kaizhoumasha/fxn_wms/docs/planning/3.5-task-breakdown.md

# 3.5 特殊物料处理 - 任务分解

## 文档元数据

| 属性 | 值 |
|---|-----|
| **文档编号** | PLAN-3.5-001 |
| **版本** | v1.0 |
| **创建日期** | 2025-01-02 |
| **最后更新** | 2025-01-02 |
| **状态** | 待评审 |
| **关联设计文档** | `docs/design/3.5-special-material-handling.md` |
| **关联需求** | SRS §3.5 特殊物料处理 |

## 1. 概述

### 1.1 任务分解目标

本文档基于 `3.5-special-material-handling.md` 设计文档，将特殊物料处理功能分解为可执行的 Epic 和 User Story，用于指导开发团队的迭代开发工作。

### 1.2 范围说明

**入库场景专项**：当前阶段仅覆盖入库（Inbound）场景的特殊物料处理，包括：
- 5种特殊物料类型：高价值物料、MSD物料、异形物料、PCB物料、机构件物料
- 物料分类识别、路由决策、库位分配、上架执行
- QMS质检集成、RCS任务下发、SAP数据同步
- 异常处理、状态监控、报表追溯

**架构约束**：根据设计文档 §0.1，当前阶段由 **WMS 全权负责**，WES 不参与此阶段的特殊物料处理逻辑。

### 1.3 技术栈

- **后端框架**：ASP.NET WebForms + MVC 5 (.NET Framework 4.8)
- **数据库**：SQL Server 2019
- **PDA端**：Blazor Server
- **集成协议**：HTTP REST (RCS, QMS), 批量同步 (SAP)

## 2. Epic 汇总

| Epic ID | Epic 名称 | 故事点 | 优先级 | 依赖 | 说明 |
|---|---|---|---|---|---|
| **E1** | 物料分类与路由决策 | 14 | P0 | E6 | 物料类型识别、路由规则引擎 |
| **E2** | 特殊物料类型处理流程 | 34 | P0 | E1, E6 | 5种物料类型的专项处理逻辑 |
| **E3** | 库位分配与上架执行 | 21 | P0 | E2 | 库位策略、RCS任务下发、确认处理 |
| **E4** | 异常处理与状态监控 | 13 | P1 | E3 | 异常检测、人工介入、状态同步 |
| **E5** | 报表与追溯 | 8 | P1 | E3 | 移动报表、追溯查询、性能指标 |
| **E6** | 数据库架构与集成 | 13 | P0 | 无 | 表结构创建、SAP同步 |
| **E7** | UI/PDA 功能增强 | 10 | P1 | E1, E2 | 管理界面、PDA操作界面 |
| **总计** | | **113** | | | |

### 2.1 优先级说明

- **P0 (Must Have)**：核心功能，必须在第一阶段完成
- **P1 (Should Have)**：重要功能，建议在第二阶段完成
- **P2 (Nice to Have)**：增强功能，可延后至后续迭代

### 2.2 依赖关系图

```
E6 (数据库架构)
  ↓
E1 (物料分类与路由)
  ↓
E2 (特殊物料类型处理)
  ↓
E3 (库位分配与上架)
  ↓
E4 (异常处理) → E5 (报表追溯)
  ↓
E7 (UI/PDA增强)
```

## 3. 按团队分组视图

### WMS 团队工作范围

**总故事点**：113 点
**占比**：100%
**说明**：根据架构设计，WMS 全权负责特殊物料处理，WES 不参与。

**关键职责**:
- 物料分类识别与路由决策
- 5种特殊物料类型的差异化处理流程
- 库位分配策略与上架执行
- QMS/RCS/SAP 系统集成
- 异常处理与状态监控
- 报表追溯与性能监控
- 数据库架构设计与维护
- Web 管理界面与 PDA 操作界面

**技术栈**:
- ASP.NET WebForms + MVC 5 (.NET Framework 4.8)
- Blazor Server (PDA 界面)
- Entity Framework (数据访问)
- SQL Server 2019
- Hangfire (定时任务)
- Redis (分布式锁、缓存)
- HTTP REST (RCS, QMS 集成)
- SAP 批量同步

| Epic | 用户故事 | 故事点 | 优先级 | 依赖 |
|---|---|---|---|---|
| **E1: 物料分类与路由决策** | | **14** | P0 | E6 |
| | US-E1-01: 物料类型识别 | 3 | P0 | E6-01 |
| | US-E1-02: 路由规则引擎实现 | 5 | P0 | E6-02 |
| | US-E1-03: 路由决策 API | 3 | P0 | US-E1-02 |
| | US-E1-04: 物料属性扩展 | 3 | P0 | E6-01 |
| **E2: 特殊物料类型处理流程** | | **34** | P0 | E1, E6 |
| | US-E2-01: 高价值物料流程 | 8 | P0 | US-E1-02 |
| | US-E2-02: MSD物料流程 | 8 | P0 | US-E1-02 |
| | US-E2-03: 异形物料流程 | 5 | P0 | US-E1-02 |
| | US-E2-04: PCB物料流程 | 5 | P0 | US-E1-02 |
| | US-E2-05: 机构件物料流程 | 5 | P0 | US-E1-02 |
| | US-E2-06: QMS Webhook 集成 | 3 | P0 | 无 |
| **E3: 库位分配与上架执行** | | **21** | P0 | E2 |
| | US-E3-01: 库位分配策略引擎 | 8 | P0 | E6-02 |
| | US-E3-02: RCS上架任务创建 | 5 | P0 | US-E3-01 |
| | US-E3-03: 上架确认处理 | 5 | P0 | US-E3-02 |
| | US-E3-04: 库位容量管理 | 3 | P0 | E6-01 |
| **E4: 异常处理与状态监控** | | **13** | P1 | E3 |
| | US-E4-01: 异常检测与告警 | 5 | P1 | E3-03 |
| | US-E4-02: 人工介入工作流 | 5 | P1 | US-E4-01 |
| | US-E4-03: RCS状态同步 | 3 | P1 | 无 |
| **E5: 报表与追溯** | | **8** | P1 | E3 |
| | US-E5-01: 特殊物料移动报表 | 3 | P1 | E3-03 |
| | US-E5-02: 物料追溯查询 | 3 | P1 | E6-03 |
| | US-E5-03: 性能指标仪表板 | 2 | P1 | US-E5-01 |
| **E6: 数据库架构与集成** | | **13** | P0 | 无 |
| | US-E6-01: material_extension 表创建 | 3 | P0 | 无 |
| | US-E6-02: routing_rule 表创建 | 3 | P0 | 无 |
| | US-E6-03: special_material_log 表创建 | 2 | P0 | 无 |
| | US-E6-04: SAP物料属性批量同步 | 5 | P0 | US-E6-01 |
| **E7: UI/PDA 功能增强** | | **10** | P1 | E1, E2 |
| | US-E7-01: 物料分类管理界面 | 5 | P1 | E6-01 |
| | US-E7-02: PDA特殊物料处理界面 | 3 | P1 | E2 |
| | US-E7-03: 异常处理仪表板 | 2 | P1 | E4-01 |

---

#### E1: 物料分类与路由决策 (14 点)

**Epic 描述**：
实现物料到货时的自动分类识别和路由决策功能，支持5种特殊物料类型（HIGH_VALUE, MSD, IRREGULAR, PCB, STRUCTURAL）的识别和路由规则引擎。

**业务价值**：
- 自动化物料分类，减少人工判断错误
- 智能路由决策，提升入库效率
- 为后续特殊物料处理流程提供基础数据

---

##### US-E1-01: 物料类型识别

**故事点**：3
**优先级**：P0
**依赖**：E6-01 (material_extension 表创建)

**用户故事**：
作为 WMS 系统，我需要在物料到货时自动识别其特殊物料类型，以便后续进行差异化处理。

**验收标准**：
1. 系统读取物料主数据（material 表），识别 special_material_type 字段
2. 支持5种类型识别：HIGH_VALUE（高价值）、MSD（湿敏）、IRREGULAR（异形）、PCB、STRUCTURAL（机构件）
3. 分类结果存储至 material_extension 表的 special_material_type 字段
4. 对于未标记的物料，默认为普通物料（NORMAL）
5. 分类结果记录至 special_material_log 表，包含时间戳和操作人

**技术实现要点**：
- 在 `MaterialService.cs` 中新增 `IdentifyMaterialType(string materialCode)` 方法
- 查询 material 表的 special_material_type 字段
- 若为空，检查物料描述关键词（如"PCB"、"MSD"等）进行智能识别
- 更新 material_extension 表
- 记录日志至 special_material_log

**测试用例**：
- TC-E1-01-01: 已标记高价值物料，验证识别结果为 HIGH_VALUE
- TC-E1-01-02: 未标记物料但描述包含"MSD"，验证智能识别为 MSD
- TC-E1-01-03: 普通物料，验证识别结果为 NORMAL
- TC-E1-01-04: 验证日志记录完整性

---

##### US-E1-02: 路由规则引擎实现

**故事点**：5
**优先级**：P0
**依赖**：E6-02 (routing_rule 表创建)

**用户故事**：
作为 WMS 系统，我需要一个路由规则引擎来根据物料类型、目标区域和存储要求决定物料的目标库位类型和处理指令。

**验收标准**：
1. 规则引擎读取 routing_rule 表，支持多条件匹配（物料类型 + 目标区域 + 存储要求）
2. 规则优先级机制：按 priority 字段降序匹配，返回第一条匹配规则
3. 返回目标库位类型（location_type）和处理指令（handling_instructions）
4. 支持规则的启用/禁用（is_active 字段）
5. 规则匹配失败时，返回默认规则或抛出异常

**技术实现要点**：
- 在 `RoutingService.cs` 中新增 `EvaluateRoutingRule(MaterialRoutingContext context)` 方法
- MaterialRoutingContext 包含：materialType, targetZone, storageRequirements
- 使用 LINQ 查询 routing_rule 表，按 priority DESC 排序
- 实现规则匹配逻辑：支持精确匹配和通配符（如 "*" 表示任意）
- 缓存规则表数据（使用 MemoryCache，5分钟过期）

**测试用例**：
- TC-E1-02-01: 高价值物料 + IQC区域，验证路由至高价值专区
- TC-E1-02-02: MSD物料 + 存储区域，验证路由至湿度控制区
- TC-E1-02-03: 多条规则匹配，验证优先级机制
- TC-E1-02-04: 无匹配规则，验证默认规则或异常处理
- TC-E1-02-05: 禁用规则不参与匹配

---

##### US-E1-03: 路由决策 API

**故事点**：3
**优先级**：P0
**依赖**：US-E1-02

**用户故事**：
作为外部系统（如 PDA、RCS），我需要通过 REST API 查询物料的路由决策结果，以便执行后续操作。

**验收标准**：
1. 提供 REST API 端点：`POST /api/routing/decide`
2. 请求参数：materialCode, targetZone, storageRequirements (可选)
3. 响应数据：locationType, locationRecommendations (推荐库位列表), handlingInstructions
4. API 响应时间 < 500ms (P95)
5. 支持批量查询：`POST /api/routing/decide-batch` (最多100条)

**技术实现要点**：
- 在 `Controllers/RoutingController.cs` 中新增 `DecideRouting` 和 `DecideRoutingBatch` 方法
- 调用 RoutingService.EvaluateRoutingRule
- 调用 LocationService.GetRecommendedLocations 获取推荐库位
- 返回 JSON 格式：
  ```json
  {
    "materialCode": "MAT001",
    "locationType": "HIGH_VALUE_ZONE",
    "locationRecommendations": ["HV-A-01-01", "HV-A-01-02"],
    "handlingInstructions": "需QMS质检后上架"
  }
  ```

**测试用例**：
- TC-E1-03-01: 单条查询，验证响应格式和数据正确性
- TC-E1-03-02: 批量查询100条，验证响应时间 < 2s
- TC-E1-03-03: 无效物料编码，验证错误处理（返回400）
- TC-E1-03-04: 并发100请求，验证系统稳定性

---

##### US-E1-04: 物料属性扩展

**故事点**：3
**优先级**：P0
**依赖**：E6-01

**用户故事**：
作为仓库管理员，我需要在物料主数据管理界面中维护特殊物料属性（类型、MSD等级、存储要求），以便系统正确识别和处理。

**验收标准**：
1. 在现有物料管理界面（MaterialMaster.aspx）中新增字段：
   - special_material_type (下拉选择：NORMAL, HIGH_VALUE, MSD, IRREGULAR, PCB, STRUCTURAL)
   - msd_level (下拉选择：2a, 3, 4, 5a，仅当类型为MSD时显示)
   - storage_requirements (多行文本框，最多500字符)
2. 支持 CRUD 操作：创建、查询、更新、删除
3. 数据验证：MSD物料必须填写 msd_level
4. 变更记录：属性修改时记录至 special_material_log

**技术实现要点**：
- 修改 `MaterialMaster.aspx` 和 `MaterialMaster.aspx.cs`
- 新增表单字段，使用 DropDownList 和 TextBox 控件
- 在 `MaterialService.cs` 中新增 `UpdateMaterialExtension` 方法
- 数据验证逻辑：
  ```csharp
  if (materialType == "MSD" && string.IsNullOrEmpty(msdLevel))
      throw new ValidationException("MSD物料必须指定MSD等级");
  ```
- 记录变更日志

**测试用例**：
- TC-E1-04-01: 创建高价值物料，验证数据保存成功
- TC-E1-04-02: 创建MSD物料但未填写等级，验证报错
- TC-E1-04-03: 更新物料类型，验证变更日志记录
- TC-E1-04-04: 删除物料，验证扩展属性同步删除（级联）

| **E2: 特殊物料类型处理流程** | | **34** | P0 | E1, E6 |
| | US-E2-01: 高价值物料流程 | 8 | P0 | US-E1-02 |
| | US-E2-02: MSD物料流程 | 8 | P0 | US-E1-02 |
| | US-E2-03: 异形物料流程 | 5 | P0 | US-E1-02 |
| | US-E2-04: PCB物料流程 | 5 | P0 | US-E1-02 |
| | US-E2-05: 机构件物料流程 | 5 | P0 | US-E1-02 |
| | US-E2-06: QMS Webhook 集成 | 3 | P0 | 无 |

#### E2: 特殊物料类型处理流程 (34 点)

**Epic 描述**：
实现5种特殊物料类型的差异化处理流程，包括专属区域路由、质检集成、环境控制、追溯管理等。

**业务价值**：
- 满足不同物料类型的特殊存储和处理要求
- 降低高价值物料损失风险
- 确保MSD物料湿度控制合规
- 提升异形/PCB/机构件物料的处理效率

---

##### US-E2-01: 高价值物料流程

**故事点**：8
**优先级**：P0
**依赖**：US-E1-02

**用户故事**：
作为仓库管理员，我需要对高价值物料实施专属区域存储、强制质检和全程追溯，以降低损失风险。

**验收标准**：
1. 高价值物料自动路由至高价值专区（HIGH_VALUE_ZONE）
2. 强制QMS质检流程：到货后自动创建质检任务，质检通过后才能上架
3. 安全追溯：记录所有操作日志（到货、质检、上架、出库）至 special_material_log
4. 库位限制：高价值专区仅允许存放高价值物料
5. 异常告警：质检超时（>24小时）自动发送告警

**技术实现要点**：
- 在 `HighValueMaterialHandler.cs` 中实现处理逻辑
- 到货时调用 QMS API 创建质检任务：
  ```csharp
  var qmsTask = await _qmsClient.CreateInspectionTask(new {
      materialCode = material.Code,
      palletId = pallet.Id,
      inspectionType = "HIGH_VALUE",
      priority = "HIGH"
  });
  ```
- 监听 QMS Webhook 接收质检结果（见 US-E2-06）
- 质检通过后更新物料状态为 AVAILABLE，触发上架流程
- 质检不通过，路由至复判区或退货区
- 使用 Hangfire 定时任务检查质检超时（每小时执行）

**测试用例**：
- TC-E2-01-01: 高价值物料到货，验证路由至高价值专区
- TC-E2-01-02: 验证QMS质检任务创建成功
- TC-E2-01-03: 质检通过，验证物料状态更新为 AVAILABLE
- TC-E2-01-04: 质检不通过，验证路由至复判区
- TC-E2-01-05: 质检超时24小时，验证告警发送
- TC-E2-01-06: 验证所有操作记录至日志表

---

##### US-E2-02: MSD物料流程

**故事点**：8
**优先级**：P0
**依赖**：US-E1-02

**用户故事**：
作为仓库管理员，我需要对MSD物料实施湿度控制区存储、烘烤时间追踪和有效期管理，以确保物料质量。

**验收标准**：
1. MSD物料根据等级（2a/3/4/5a）路由至对应湿度控制区
2. 烘烤时间追踪：记录开封时间（floor_life_start_time）、车间暴露时间（floor_life_hours）
3. 有效期管理：根据MSD等级计算有效期，超期自动标记为 EXPIRED
4. 烘烤提醒：车间暴露时间达到80%时发送提醒
5. 存储环境监控：集成温湿度传感器数据（预留接口）

**技术实现要点**：
- 在 `MsdMaterialHandler.cs` 中实现处理逻辑
- MSD等级与车间暴露时间映射（参考IPC/JEDEC标准）：
  ```csharp
  var floorLifeHours = msdLevel switch {
      "2a" => 4,
      "3" => 168,
      "4" => 72,
      "5a" => 24,
      _ => throw new ArgumentException("Invalid MSD level")
  };
  ```
- 在 material_extension 表中新增字段：
  - floor_life_start_time (开封时间)
  - floor_life_hours (允许暴露时间)
  - baking_required (是否需要烘烤)
- 使用 Hangfire 定时任务检查有效期（每小时执行）
- 发送提醒至 PDA 和管理界面

**测试用例**：
- TC-E2-02-01: MSD 2a物料，验证路由至湿度控制区
- TC-E2-02-02: 开封后，验证 floor_life_start_time 记录
- TC-E2-02-03: 暴露时间达到80%，验证提醒发送
- TC-E2-02-04: 暴露时间超期，验证状态更新为 EXPIRED
- TC-E2-02-05: 不同MSD等级，验证车间暴露时间计算正确

---

##### US-E2-03: 异形物料流程

**故事点**：5
**优先级**：P0
**依赖**：US-E1-02

**用户故事**：
作为仓库管理员，我需要对异形物料（超大、超重、不规则形状）实施人工处理区存储和特殊库位分配。

**验收标准**：
1. 异形物料自动路由至人工处理区（MANUAL_HANDLING_ZONE）
2. 特殊库位分配：根据物料尺寸（length, width, height）和重量（weight）分配合适库位
3. 库位容量校验：确保库位尺寸和承重满足物料要求
4. PDA提示：上架时显示物料尺寸和重量信息，提醒操作人员注意
5. 禁止自动化设备处理：异形物料不下发RCS任务，仅人工操作

**技术实现要点**：
- 在 `IrregularMaterialHandler.cs` 中实现处理逻辑
- 在 material_extension 表中新增字段：
  - length, width, height (尺寸，单位mm)
  - weight (重量，单位kg)
  - is_irregular (是否异形)
- 库位分配逻辑：
  ```csharp
  var suitableLocations = _locationService.GetLocations(loc =>
      loc.MaxLength >= material.Length &&
      loc.MaxWidth >= material.Width &&
      loc.MaxHeight >= material.Height &&
      loc.MaxWeight >= material.Weight &&
      loc.ZoneType == "MANUAL_HANDLING_ZONE"
  );
  ```
- PDA界面显示物料尺寸和重量

**测试用例**：
- TC-E2-03-01: 异形物料到货，验证路由至人工处理区
- TC-E2-03-02: 验证库位容量校验（尺寸和承重）
- TC-E2-03-03: 无合适库位，验证异常处理
- TC-E2-03-04: PDA上架界面，验证尺寸和重量显示
- TC-E2-03-05: 验证不下发RCS任务

---

##### US-E2-04: PCB物料流程

**故事点**：5
**优先级**：P0
**依赖**：US-E1-02

**用户故事**：
作为仓库管理员，我需要对PCB物料实施ESD防护区存储和托盘级追溯管理。

**验收标准**：
1. PCB物料自动路由至ESD防护区（ESD_PROTECTED_ZONE）
2. 托盘级追溯：记录托盘ID（pallet_id）、PCB数量（pcb_quantity）、批次号（batch_number）
3. ESD标识：托盘和库位需有ESD标识，系统校验
4. 先进先出（FIFO）：出库时优先选择最早入库的PCB
5. 库位限制：ESD防护区仅允许存放PCB物料

**技术实现要点**：
- 在 `PcbMaterialHandler.cs` 中实现处理逻辑
- 在 pallet_extension 表中新增字段：
  - pcb_quantity (PCB数量)
  - batch_number (批次号)
  - is_esd_protected (是否ESD防护)
- 库位分配时校验 location.is_esd_protected = true
- FIFO逻辑：
  ```csharp
  var pallets = _palletService.GetPallets(p =>
      p.MaterialCode == materialCode &&
      p.Status == "AVAILABLE"
  ).OrderBy(p => p.InboundTime);
  ```

**测试用例**：
- TC-E2-04-01: PCB物料到货，验证路由至ESD防护区
- TC-E2-04-02: 验证托盘级追溯信息记录
- TC-E2-04-03: 分配至非ESD库位，验证报错
- TC-E2-04-04: 出库时，验证FIFO逻辑
- TC-E2-04-05: 验证库位限制（仅PCB物料）

---

##### US-E2-05: 机构件物料流程

**故事点**：5
**优先级**：P0
**依赖**：US-E1-02

**用户故事**：
作为仓库管理员，我需要对机构件物料实施机械件专区存储和重量级库位分配。

**验收标准**：
1. 机构件物料自动路由至机械件专区（MECHANICAL_PARTS_ZONE）
2. 重量级库位分配：根据物料重量分配承重合适的库位
3. 库位承重校验：确保库位最大承重 >= 物料重量
4. 堆叠限制：重型机构件不允许堆叠（max_stack_layers = 1）
5. 库位优化：优先分配底层库位（减少搬运难度）

**技术实现要点**：
- 在 `StructuralMaterialHandler.cs` 中实现处理逻辑
- 在 material_extension 表中新增字段：
  - weight (重量，单位kg)
  - is_heavy (是否重型，weight > 50kg)
- 库位分配逻辑：
  ```csharp
  var suitableLocations = _locationService.GetLocations(loc =>
      loc.MaxWeight >= material.Weight &&
      loc.ZoneType == "MECHANICAL_PARTS_ZONE" &&
      (material.IsHeavy ? loc.Layer == 1 : true)
  ).OrderBy(loc => loc.Layer);
  ```
- 重型物料设置 max_stack_layers = 1

**测试用例**：
- TC-E2-05-01: 机构件物料到货，验证路由至机械件专区
- TC-E2-05-02: 重型物料（>50kg），验证分配至底层库位
- TC-E2-05-03: 验证库位承重校验
- TC-E2-05-04: 重型物料，验证堆叠限制（max_stack_layers = 1）
- TC-E2-05-05: 无合适库位，验证异常处理

---

##### US-E2-06: QMS Webhook 集成

**故事点**：3
**优先级**：P0
**依赖**：无

**用户故事**：
作为 WMS 系统，我需要接收 QMS 的质检结果 Webhook，以便及时更新物料状态并触发后续流程。

**验收标准**：
1. 提供 Webhook 端点：`POST /api/qms/webhook/inspection-result`
2. 接收 QMS 质检结果：inspectionId, materialCode, palletId, result (PASS/FAIL), remarks
3. 更新物料状态：PASS → AVAILABLE，FAIL → QUARANTINE
4. 触发后续流程：PASS 触发上架流程，FAIL 触发复判或退货流程
5. 幂等性保证：同一 inspectionId 多次推送，仅处理一次

**技术实现要点**：
- 在 `Controllers/QmsWebhookController.cs` 中新增 `ReceiveInspectionResult` 方法
- Webhook 请求格式：
  ```json
  {
    "inspectionId": "INS-20250102-001",
    "materialCode": "MAT001",
    "palletId": "PLT-001",
    "result": "PASS",
    "remarks": "质检合格"
  }
  ```
- 幂等性实现：检查 special_material_log 表是否已存在该 inspectionId
- 状态更新后发布事件：`InspectionCompletedEvent`
- 记录日志至 special_material_log

**测试用例**：
- TC-E2-06-01: 接收 PASS 结果，验证物料状态更新为 AVAILABLE
- TC-E2-06-02: 接收 FAIL 结果，验证物料状态更新为 QUARANTINE
- TC-E2-06-03: 重复推送同一 inspectionId，验证仅处理一次
- TC-E2-06-04: 无效 materialCode，验证错误处理
- TC-E2-06-05: 验证事件发布和日志记录

| **E3: 库位分配与上架执行** | | **21** | P0 | E2 |
| | US-E3-01: 库位分配策略引擎 | 8 | P0 | E6-02 |
| | US-E3-02: RCS上架任务创建 | 5 | P0 | US-E3-01 |
| | US-E3-03: 上架确认处理 | 5 | P0 | US-E3-02 |
| | US-E3-04: 库位容量管理 | 3 | P0 | E6-01 |

#### E3: 库位分配与上架执行 (21 点)

**Epic 描述**：
实现智能库位分配策略和RCS上架任务下发，确保特殊物料按规则存储至合适库位。

**业务价值**：
- 优化库位利用率，提升存储效率
- 自动化上架流程，减少人工干预
- 确保物料存储符合特殊要求

---

##### US-E3-01: 库位分配策略引擎

**故事点**：8
**优先级**：P0
**依赖**：E6-02

**用户故事**：
作为 WMS 系统，我需要根据物料类型、库位容量、区域规则等因素智能分配最优库位。

**验收标准**：
1. 支持多种分配策略：就近原则、负载均衡、FIFO优先、容量优先
2. 库位过滤：根据物料类型过滤可用库位（区域、承重、尺寸、环境要求）
3. 库位排序：按优先级排序（距离、空闲度、历史使用率）
4. 库位预留：支持临时预留库位（15分钟超时自动释放）
5. 并发控制：防止多个任务分配至同一库位

**技术实现要点**：
- 在 `LocationAllocationService.cs` 中实现策略引擎
- 策略接口：
  ```csharp
  public interface IAllocationStrategy {
      List<Location> Allocate(Material material, List<Location> candidates);
  }
  ```
- 实现4种策略：NearestStrategy, LoadBalancingStrategy, FifoStrategy, CapacityStrategy
- 使用 Redis 分布式锁防止并发冲突：
  ```csharp
  var lockKey = $"location:lock:{locationId}";
  await _redis.LockAsync(lockKey, TimeSpan.FromMinutes(15));
  ```
- 库位预留记录至 location_reservation 表

**测试用例**：
- TC-E3-01-01: 就近原则，验证分配最近库位
- TC-E3-01-02: 负载均衡，验证分配至空闲度高的库位
- TC-E3-01-03: 并发10个任务，验证无重复分配
- TC-E3-01-04: 预留超时15分钟，验证自动释放
- TC-E3-01-05: 无可用库位，验证异常处理

---

##### US-E3-02: RCS上架任务创建

**故事点**：5
**优先级**：P0
**依赖**：US-E3-01

**用户故事**：
作为 WMS 系统，我需要向 RCS 下发上架任务，指示 AGV 将托盘搬运至目标库位。

**验收标准**：
1. 调用 RCS API 创建上架任务：`POST /api/rcs/tasks/putaway`
2. 任务参数：palletId, sourceLocation, targetLocation, priority, materialType
3. 任务优先级：高价值物料 HIGH，其他 NORMAL
4. 任务状态追踪：CREATED → ASSIGNED → IN_PROGRESS → COMPLETED
5. 超时处理：任务创建后30分钟未完成，自动告警

**技术实现要点**：
- 在 `RcsIntegrationService.cs` 中新增 `CreatePutawayTask` 方法
- RCS API 请求格式：
  ```json
  {
    "taskType": "PUTAWAY",
    "palletId": "PLT-001",
    "sourceLocation": "DOCK-A-01",
    "targetLocation": "HV-A-01-01",
    "priority": "HIGH",
    "materialType": "HIGH_VALUE"
  }
  ```
- 任务状态存储至 rcs_task 表
- 使用 Hangfire 定时任务检查超时（每10分钟执行）
- 记录任务日志至 special_material_log

**测试用例**：
- TC-E3-02-01: 创建上架任务，验证 RCS API 调用成功
- TC-E3-02-02: 高价值物料，验证优先级为 HIGH
- TC-E3-02-03: 任务超时30分钟，验证告警发送
- TC-E3-02-04: RCS API 失败，验证重试机制（3次）
- TC-E3-02-05: 验证任务状态记录和日志

---

##### US-E3-03: 上架确认处理

**故事点**：5
**优先级**：P0
**依赖**：US-E3-02

**用户故事**：
作为 WMS 系统，我需要接收 RCS 的上架完成通知，更新库存状态并释放库位预留。

**验收标准**：
1. 接收 RCS Webhook：`POST /api/rcs/webhook/task-completed`
2. 验证任务完成：检查 taskId, palletId, targetLocation 一致性
3. 更新库存：托盘状态 → STORED，库位状态 → OCCUPIED
4. 释放预留：删除 location_reservation 记录
5. 幂等性保证：同一 taskId 多次推送，仅处理一次

**技术实现要点**：
- 在 `Controllers/RcsWebhookController.cs` 中新增 `ReceiveTaskCompleted` 方法
- Webhook 请求格式：
  ```json
  {
    "taskId": "RCS-TASK-001",
    "palletId": "PLT-001",
    "targetLocation": "HV-A-01-01",
    "status": "COMPLETED",
    "completedTime": "2025-01-02T10:30:00Z"
  }
  ```
- 幂等性实现：检查 rcs_task 表状态是否已为 COMPLETED
- 更新 pallet 表：status = STORED, location_id = targetLocation
- 更新 location 表：status = OCCUPIED, current_pallet_id = palletId
- 删除 location_reservation 记录
- 发布事件：`PutawayCompletedEvent`

**测试用例**：
- TC-E3-03-01: 接收完成通知，验证库存状态更新
- TC-E3-03-02: 验证库位预留释放
- TC-E3-03-03: 重复推送同一 taskId，验证仅处理一次
- TC-E3-03-04: 无效 taskId，验证错误处理
- TC-E3-03-05: 验证事件发布

---

##### US-E3-04: 库位容量管理

**故事点**：3
**优先级**：P0
**依赖**：E6-01

**用户故事**：
作为仓库管理员，我需要实时查看库位容量使用情况，以便优化库位分配和扩容规划。

**验收标准**：
1. 库位容量统计：总库位数、已占用、空闲、预留、异常
2. 按区域统计：各区域（高价值、MSD、ESD等）的容量使用率
3. 容量告警：使用率 > 90% 时发送告警
4. 容量趋势：记录每日容量使用情况，生成趋势图
5. 管理界面：展示容量统计和趋势图

**技术实现要点**：
- 在 `LocationService.cs` 中新增 `GetCapacityStatistics` 方法
- 统计逻辑：
  ```csharp
  var stats = new {
      TotalLocations = _db.Locations.Count(),
      OccupiedLocations = _db.Locations.Count(l => l.Status == "OCCUPIED"),
      FreeLocations = _db.Locations.Count(l => l.Status == "FREE"),
      ReservedLocations = _db.LocationReservations.Count(),
      UtilizationRate = (double)occupied / total * 100
  };
  ```
- 使用 Hangfire 定时任务记录每日容量（每天凌晨1点执行）
- 容量数据存储至 location_capacity_history 表
- 在 `LocationCapacity.aspx` 中展示统计和趋势图（使用 Chart.js）

**测试用例**：
- TC-E3-04-01: 验证容量统计数据正确性
- TC-E3-04-02: 使用率 > 90%，验证告警发送
- TC-E3-04-03: 验证每日容量记录
- TC-E3-04-04: 管理界面，验证统计和趋势图显示
- TC-E3-04-05: 按区域统计，验证各区域数据正确

| **E4: 异常处理与状态监控** | | **13** | P1 | E3 |
| | US-E4-01: 异常检测与告警 | 5 | P1 | E3-03 |
| | US-E4-02: 人工介入工作流 | 5 | P1 | US-E4-01 |
| | US-E4-03: RCS状态同步 | 3 | P1 | 无 |
| **E5: 报表与追溯** | | **8** | P1 | E3 |
| | US-E5-01: 特殊物料移动报表 | 3 | P1 | E3-03 |
| | US-E5-02: 物料追溯查询 | 3 | P1 | E6-03 |
| | US-E5-03: 性能指标仪表板 | 2 | P1 | US-E5-01 |
| **E6: 数据库架构与集成** | | **13** | P0 | 无 |
| | US-E6-01: material_extension 表创建 | 3 | P0 | 无 |
| | US-E6-02: routing_rule 表创建 | 3 | P0 | 无 |
| | US-E6-03: special_material_log 表创建 | 2 | P0 | 无 |
| | US-E6-04: SAP物料属性批量同步 | 5 | P0 | US-E6-01 |
| **E7: UI/PDA 功能增强** | | **10** | P1 | E1, E2 |
| | US-E7-01: 物料分类管理界面 | 5 | P1 | E6-01 |
| | US-E7-02: PDA特殊物料处理界面 | 3 | P1 | E2 |
| | US-E7-03: 异常处理仪表板 | 2 | P1 | E4-01 |

---

#### E4: 异常处理与状态监控 (13 点)

**Epic 描述**：
实现异常检测、告警、人工介入和状态同步机制，确保特殊物料处理流程的可靠性。

**业务价值**：
- 及时发现和处理异常，降低业务影响
- 提供人工介入通道，保障流程连续性
- 实时状态同步，确保数据一致性

---

##### US-E4-01: 异常检测与告警

**故事点**：5
**优先级**：P1
**依赖**：E3-03

**用户故事**：
作为系统管理员，我需要自动检测特殊物料处理过程中的异常情况并及时告警。

**验收标准**：
1. 异常类型检测：质检超时、上架超时、库位冲突、设备故障、数据不一致
2. 告警级别：CRITICAL（关键）、HIGH（高）、MEDIUM（中）、LOW（低）
3. 告警渠道：系统通知、邮件、短信（CRITICAL级别）
4. 告警记录：存储至 exception_log 表，包含异常类型、级别、描述、处理状态
5. 自动恢复：部分异常支持自动恢复（如重试机制）

**技术实现要点**：
- 在 `ExceptionDetectionService.cs` 中实现检测逻辑
- 使用 Hangfire 定时任务检测异常（每5分钟执行）
- 异常检测规则：
  ```csharp
  // 质检超时
  var qmsTimeouts = _db.Materials
      .Where(m => m.Status == "INSPECTING" &&
                  DateTime.Now - m.InspectionStartTime > TimeSpan.FromHours(24));

  // 上架超时
  var putawayTimeouts = _db.RcsTasks
      .Where(t => t.Status == "IN_PROGRESS" &&
                  DateTime.Now - t.CreatedTime > TimeSpan.FromMinutes(30));
  ```
- 告警发送：调用 `NotificationService.SendAlert`
- 记录至 exception_log 表

**测试用例**：
- TC-E4-01-01: 质检超时24小时，验证 CRITICAL 告警发送
- TC-E4-01-02: 上架超时30分钟，验证 HIGH 告警发送
- TC-E4-01-03: 库位冲突，验证 MEDIUM 告警发送
- TC-E4-01-04: 验证告警记录至 exception_log
- TC-E4-01-05: 自动恢复成功，验证告警状态更新为 RESOLVED

---

##### US-E4-02: 人工介入工作流

**故事点**：5
**优先级**：P1
**依赖**：US-E4-01

**用户故事**：
作为仓库管理员，我需要对异常情况进行人工介入处理，包括手动分配库位、强制完成任务等。

**验收标准**：
1. 异常处理界面：展示待处理异常列表，支持筛选和排序
2. 处理操作：手动分配库位、强制完成任务、标记为已解决、升级处理
3. 处理记录：记录处理人、处理时间、处理方式、处理结果
4. 权限控制：仅管理员和主管可执行人工介入操作
5. 审计日志：所有人工介入操作记录至 audit_log 表

**技术实现要点**：
- 在 `ExceptionHandling.aspx` 中实现异常处理界面
- 界面功能：
  - 异常列表（GridView）：显示异常类型、级别、发生时间、状态
  - 筛选条件：异常类型、级别、状态、时间范围
  - 处理操作按钮：分配库位、强制完成、标记解决、升级
- 在 `ExceptionHandlingService.cs` 中实现处理逻辑
- 权限验证：
  ```csharp
  if (!User.IsInRole("Admin") && !User.IsInRole("Supervisor"))
      throw new UnauthorizedException("无权限执行此操作");
  ```
- 记录审计日志

**测试用例**：
- TC-E4-02-01: 管理员登录，验证可访问异常处理界面
- TC-E4-02-02: 普通用户登录，验证无权限访问
- TC-E4-02-03: 手动分配库位，验证操作成功并记录日志
- TC-E4-02-04: 强制完成任务，验证任务状态更新
- TC-E4-02-05: 验证审计日志记录完整性

---

##### US-E4-03: RCS状态同步

**故事点**：3
**优先级**：P1
**依赖**：无

**用户故事**：
作为 WMS 系统，我需要定期同步 RCS 任务状态，确保数据一致性。

**验收标准**：
1. 定期同步：每5分钟查询 RCS 任务状态
2. 状态更新：同步 RCS 任务状态至 rcs_task 表
3. 差异检测：检测 WMS 与 RCS 状态不一致的任务
4. 自动修正：对于轻微差异，自动修正 WMS 状态
5. 异常告警：对于严重差异，发送告警并记录至 exception_log

**技术实现要点**：
- 在 `RcsSyncService.cs` 中实现同步逻辑
- 使用 Hangfire 定时任务（每5分钟执行）
- 调用 RCS API 查询任务状态：`GET /api/rcs/tasks/{taskId}/status`
- 状态对比逻辑：
  ```csharp
  var wmsStatus = _db.RcsTasks.Find(taskId).Status;
  var rcsStatus = await _rcsClient.GetTaskStatus(taskId);

  if (wmsStatus != rcsStatus) {
      if (IsMinorDifference(wmsStatus, rcsStatus)) {
          // 自动修正
          UpdateWmsStatus(taskId, rcsStatus);
      } else {
          // 发送告警
          _alertService.SendAlert($"严重状态差异: WMS={wmsStatus}, RCS={rcsStatus}");
      }
  }
  ```

**测试用例**：
- TC-E4-03-01: 状态一致，验证无操作
- TC-E4-03-02: 轻微差异，验证自动修正
- TC-E4-03-03: 严重差异，验证告警发送
- TC-E4-03-04: RCS API 失败，验证错误处理
- TC-E4-03-05: 验证同步日志记录

---

#### E5: 报表与追溯 (8 点)

**Epic 描述**：
实现特殊物料移动报表、追溯查询和性能指标仪表板，支持业务分析和审计。

**业务价值**：
- 提供数据支持，辅助业务决策
- 满足审计和合规要求
- 监控系统性能，及时发现问题

---

##### US-E5-01: 特殊物料移动报表

**故事点**：3
**优先级**：P1
**依赖**：E3-03

**用户故事**：
作为仓库管理员，我需要查看特殊物料的移动报表，了解物料流转情况。

**验收标准**：
1. 报表维度：物料类型、时间范围、区域、操作类型（入库、上架、出库）
2. 报表指标：物料数量、托盘数量、平均处理时间、异常次数
3. 报表格式：表格和图表（柱状图、饼图）
4. 导出功能：支持导出为 Excel 和 PDF
5. 定时生成：每日自动生成报表并发送至管理员邮箱

**技术实现要点**：
- 在 `SpecialMaterialReport.aspx` 中实现报表界面
- 报表查询逻辑：
  ```csharp
  var report = _db.SpecialMaterialLogs
      .Where(l => l.OperationTime >= startDate && l.OperationTime <= endDate)
      .GroupBy(l => new { l.MaterialType, l.OperationType })
      .Select(g => new {
          MaterialType = g.Key.MaterialType,
          OperationType = g.Key.OperationType,
          Count = g.Count(),
          AvgProcessingTime = g.Average(l => l.ProcessingTime)
      });
  ```
- 使用 Chart.js 生成图表
- 导出功能：使用 EPPlus (Excel) 和 iTextSharp (PDF)
- 使用 Hangfire 定时任务生成报表（每天凌晨2点执行）

**测试用例**：
- TC-E5-01-01: 查询本月高价值物料报表，验证数据正确性
- TC-E5-01-02: 导出为 Excel，验证格式正确
- TC-E5-01-03: 导出为 PDF，验证格式正确
- TC-E5-01-04: 验证定时报表生成和邮件发送
- TC-E5-01-05: 验证图表显示正确

---

##### US-E5-02: 物料追溯查询

**故事点**：3
**优先级**：P1
**依赖**：E6-03

**用户故事**：
作为质量管理员，我需要追溯特殊物料的完整流转历史，用于质量分析和问题排查。

**验收标准**：
1. 查询条件：物料编码、托盘ID、批次号、时间范围
2. 追溯信息：操作时间、操作类型、操作人、源库位、目标库位、状态变化
3. 时间线展示：按时间顺序展示物料流转历史
4. 关联信息：显示质检结果、异常记录、RCS任务
5. 导出功能：支持导出追溯报告为 PDF

**技术实现要点**：
- 在 `MaterialTraceability.aspx` 中实现追溯查询界面
- 查询逻辑：
  ```csharp
  var traceHistory = _db.SpecialMaterialLogs
      .Where(l => l.MaterialCode == materialCode || l.PalletId == palletId)
      .OrderBy(l => l.OperationTime)
      .Select(l => new {
          OperationTime = l.OperationTime,
          OperationType = l.OperationType,
          Operator = l.Operator,
          SourceLocation = l.SourceLocation,
          TargetLocation = l.TargetLocation,
          StatusChange = l.StatusChange
      });
  ```
- 时间线展示：使用 Timeline 控件或自定义 CSS
- 关联查询：Join quality_inspection, exception_log, rcs_task 表
- PDF 导出：使用 iTextSharp

**测试用例**：
- TC-E5-02-01: 按物料编码查询，验证追溯历史完整
- TC-E5-02-02: 按托盘ID查询，验证追溯历史完整
- TC-E5-02-03: 验证关联信息显示（质检、异常、RCS任务）
- TC-E5-02-04: 导出 PDF，验证格式正确
- TC-E5-02-05: 无追溯记录，验证提示信息

---

##### US-E5-03: 性能指标仪表板

**故事点**：2
**优先级**：P1
**依赖**：US-E5-01

**用户故事**：
作为系统管理员，我需要实时监控特殊物料处理的性能指标，及时发现性能问题。

**验收标准**：
1. 关键指标：平均处理时间、异常率、库位利用率、任务完成率
2. 实时更新：每5分钟刷新一次数据
3. 趋势图：展示最近7天的指标趋势
4. 告警提示：指标异常时显示告警标识
5. 钻取功能：点击指标可查看详细数据

**技术实现要点**：
- 在 `PerformanceDashboard.aspx` 中实现仪表板界面
- 使用 SignalR 实现实时数据推送
- 指标计算逻辑：
  ```csharp
  var metrics = new {
      AvgProcessingTime = _db.SpecialMaterialLogs
          .Where(l => l.OperationTime >= DateTime.Today)
          .Average(l => l.ProcessingTime),
      ExceptionRate = (double)exceptionCount / totalCount * 100,
      LocationUtilization = (double)occupiedCount / totalCount * 100,
      TaskCompletionRate = (double)completedCount / totalCount * 100
  };
  ```
- 使用 Chart.js 生成趋势图
- 告警阈值：平均处理时间 > 30分钟、异常率 > 5%、库位利用率 > 90%

**测试用例**：
- TC-E5-03-01: 验证关键指标显示正确
- TC-E5-03-02: 验证实时更新（5分钟刷新）
- TC-E5-03-03: 指标异常，验证告警标识显示
- TC-E5-03-04: 点击指标，验证钻取至详细数据
- TC-E5-03-05: 验证趋势图显示最近7天数据

#### E6: 数据库架构与集成 (13 点)

**Epic 描述**：
创建特殊物料处理所需的数据库表结构，实现与SAP的物料属性批量同步。

**业务价值**：
- 提供数据存储基础，支撑业务功能
- 自动化数据同步，减少人工维护
- 确保数据一致性和完整性

---

##### US-E6-01: material_extension 表创建

**故事点**：3
**优先级**：P0
**依赖**：无

**用户故事**：
作为数据库管理员，我需要创建 material_extension 表来存储物料的特殊属性扩展信息。

**验收标准**：
1. 表结构包含字段：material_code (PK), special_material_type, msd_level, storage_requirements, length, width, height, weight, is_irregular, is_heavy, floor_life_start_time, floor_life_hours, baking_required
2. 外键约束：material_code 关联 material 表
3. 索引：material_code (主键), special_material_type (普通索引)
4. 默认值：special_material_type = 'NORMAL', is_irregular = 0, is_heavy = 0
5. 审计字段：created_at, updated_at, created_by, updated_by

**技术实现要点**：
- SQL Server 建表脚本：
  ```sql
  CREATE TABLE material_extension (
      material_code NVARCHAR(50) PRIMARY KEY,
      special_material_type NVARCHAR(20) NOT NULL DEFAULT 'NORMAL',
      msd_level NVARCHAR(10) NULL,
      storage_requirements NVARCHAR(500) NULL,
      length DECIMAL(10,2) NULL,
      width DECIMAL(10,2) NULL,
      height DECIMAL(10,2) NULL,
      weight DECIMAL(10,2) NULL,
      is_irregular BIT NOT NULL DEFAULT 0,
      is_heavy BIT NOT NULL DEFAULT 0,
      floor_life_start_time DATETIME NULL,
      floor_life_hours INT NULL,
      baking_required BIT NULL,
      created_at DATETIME NOT NULL DEFAULT GETDATE(),
      updated_at DATETIME NOT NULL DEFAULT GETDATE(),
      created_by NVARCHAR(50) NOT NULL,
      updated_by NVARCHAR(50) NOT NULL,
      CONSTRAINT FK_material_extension_material FOREIGN KEY (material_code)
          REFERENCES material(material_code) ON DELETE CASCADE
  );

  CREATE INDEX IX_material_extension_type ON material_extension(special_material_type);
  ```

**测试用例**：
- TC-E6-01-01: 执行建表脚本，验证表创建成功
- TC-E6-01-02: 插入测试数据，验证约束和默认值
- TC-E6-01-03: 删除 material 记录，验证级联删除
- TC-E6-01-04: 验证索引创建成功

---

##### US-E6-02: routing_rule 表创建

**故事点**：3
**优先级**：P0
**依赖**：无

**用户故事**：
作为数据库管理员，我需要创建 routing_rule 表来存储物料路由规则配置。

**验收标准**：
1. 表结构包含字段：rule_id (PK), material_type, target_zone, storage_requirements, location_type, handling_instructions, priority, is_active
2. 主键：rule_id (自增)
3. 索引：material_type + target_zone (复合索引), priority (普通索引)
4. 默认值：is_active = 1, priority = 100
5. 审计字段：created_at, updated_at, created_by, updated_by

**技术实现要点**：
- SQL Server 建表脚本：
  ```sql
  CREATE TABLE routing_rule (
      rule_id INT IDENTITY(1,1) PRIMARY KEY,
      material_type NVARCHAR(20) NOT NULL,
      target_zone NVARCHAR(50) NULL,
      storage_requirements NVARCHAR(500) NULL,
      location_type NVARCHAR(50) NOT NULL,
      handling_instructions NVARCHAR(1000) NULL,
      priority INT NOT NULL DEFAULT 100,
      is_active BIT NOT NULL DEFAULT 1,
      created_at DATETIME NOT NULL DEFAULT GETDATE(),
      updated_at DATETIME NOT NULL DEFAULT GETDATE(),
      created_by NVARCHAR(50) NOT NULL,
      updated_by NVARCHAR(50) NOT NULL
  );

  CREATE INDEX IX_routing_rule_type_zone ON routing_rule(material_type, target_zone);
  CREATE INDEX IX_routing_rule_priority ON routing_rule(priority DESC);
  ```
- 初始化数据：插入5种物料类型的默认路由规则

**测试用例**：
- TC-E6-02-01: 执行建表脚本，验证表创建成功
- TC-E6-02-02: 插入测试规则，验证约束和默认值
- TC-E6-02-03: 验证复合索引和优先级索引
- TC-E6-02-04: 执行初始化脚本，验证默认规则插入

---

##### US-E6-03: special_material_log 表创建

**故事点**：2
**优先级**：P0
**依赖**：无

**用户故事**：
作为数据库管理员，我需要创建 special_material_log 表来记录特殊物料的所有操作日志。

**验收标准**：
1. 表结构包含字段：log_id (PK), material_code, pallet_id, operation_type, operation_time, operator, source_location, target_location, status_change, processing_time, remarks
2. 主键：log_id (自增)
3. 索引：material_code (普通索引), pallet_id (普通索引), operation_time (普通索引)
4. 分区策略：按 operation_time 月度分区（提升查询性能）
5. 保留策略：保留2年数据，超期自动归档

**技术实现要点**：
- SQL Server 建表脚本：
  ```sql
  CREATE TABLE special_material_log (
      log_id BIGINT IDENTITY(1,1) PRIMARY KEY,
      material_code NVARCHAR(50) NOT NULL,
      pallet_id NVARCHAR(50) NULL,
      operation_type NVARCHAR(50) NOT NULL,
      operation_time DATETIME NOT NULL DEFAULT GETDATE(),
      operator NVARCHAR(50) NOT NULL,
      source_location NVARCHAR(50) NULL,
      target_location NVARCHAR(50) NULL,
      status_change NVARCHAR(100) NULL,
      processing_time INT NULL,
      remarks NVARCHAR(1000) NULL
  );

  CREATE INDEX IX_special_material_log_material ON special_material_log(material_code);
  CREATE INDEX IX_special_material_log_pallet ON special_material_log(pallet_id);
  CREATE INDEX IX_special_material_log_time ON special_material_log(operation_time DESC);
  ```
- 分区方案：使用 SQL Server 分区函数和分区方案（可选，视数据量而定）

**测试用例**：
- TC-E6-03-01: 执行建表脚本，验证表创建成功
- TC-E6-03-02: 插入测试日志，验证数据写入
- TC-E6-03-03: 验证索引创建成功
- TC-E6-03-04: 查询性能测试（100万条数据）

---

##### US-E6-04: SAP物料属性批量同步

**故事点**：5
**优先级**：P0
**依赖**：US-E6-01

**用户故事**：
作为系统集成工程师，我需要实现从SAP批量同步物料属性至WMS，确保物料主数据一致性。

**验收标准**：
1. 同步频率：每日凌晨3点自动执行
2. 同步范围：物料编码、物料描述、特殊物料类型、MSD等级、存储要求、尺寸、重量
3. 增量同步：仅同步变更的物料（基于 updated_at 字段）
4. 错误处理：同步失败记录至 sync_error_log 表，发送告警
5. 同步报告：生成同步报告（成功数、失败数、耗时）并发送邮件

**技术实现要点**：
- 在 `SapSyncService.cs` 中实现同步逻辑
- SAP接口：调用 SAP RFC 或 OData API 获取物料数据
- 增量同步逻辑：
  ```csharp
  var lastSyncTime = _db.SyncHistory.Max(h => h.SyncTime);
  var changedMaterials = await _sapClient.GetMaterials(lastSyncTime);

  foreach (var sapMaterial in changedMaterials) {
      var wmsExtension = _db.MaterialExtensions.Find(sapMaterial.Code);
      if (wmsExtension == null) {
          // 新增
          _db.MaterialExtensions.Add(MapToExtension(sapMaterial));
      } else {
          // 更新
          UpdateExtension(wmsExtension, sapMaterial);
      }
  }
  await _db.SaveChangesAsync();
  ```
- 使用 Hangfire 定时任务（每天凌晨3点执行）
- 错误处理：使用 try-catch 捕获异常，记录至 sync_error_log
- 同步报告：使用邮件服务发送

**测试用例**：
- TC-E6-04-01: 全量同步1000条物料，验证数据一致性
- TC-E6-04-02: 增量同步100条变更物料，验证仅同步变更
- TC-E6-04-03: SAP接口失败，验证错误记录和告警
- TC-E6-04-04: 验证同步报告生成和邮件发送
- TC-E6-04-05: 验证定时任务执行（凌晨3点）

---

#### E7: UI/PDA 功能增强 (10 点)

**Epic 描述**：
实现特殊物料管理的Web界面和PDA操作界面，提升用户体验和操作效率。

**业务价值**：
- 提供友好的管理界面，降低操作难度
- 支持移动端操作，提升现场作业效率
- 实时数据展示，辅助决策

---

##### US-E7-01: 物料分类管理界面

**故事点**：5
**优先级**：P1
**依赖**：E6-01

**用户故事**：
作为仓库管理员，我需要一个Web界面来管理物料分类和特殊属性配置。

**验收标准**：
1. 物料列表：展示物料编码、描述、特殊类型、MSD等级、存储要求
2. 筛选功能：按物料类型、MSD等级筛选
3. 编辑功能：点击编辑按钮，弹出编辑对话框，修改特殊属性
4. 批量导入：支持Excel批量导入物料属性
5. 导出功能：支持导出为Excel

**技术实现要点**：
- 在 `MaterialClassification.aspx` 中实现界面
- 使用 GridView 控件展示物料列表
- 编辑对话框：使用 Bootstrap Modal 或 ASP.NET AJAX ModalPopup
- 批量导入：使用 EPPlus 读取 Excel 文件
  ```csharp
  using (var package = new ExcelPackage(uploadedFile)) {
      var worksheet = package.Workbook.Worksheets[0];
      for (int row = 2; row <= worksheet.Dimension.End.Row; row++) {
          var materialCode = worksheet.Cells[row, 1].Value?.ToString();
          var materialType = worksheet.Cells[row, 2].Value?.ToString();
          // ... 读取其他字段
          _materialService.UpdateExtension(materialCode, materialType, ...);
      }
  }
  ```
- 导出功能：使用 EPPlus 生成 Excel

**测试用例**：
- TC-E7-01-01: 访问界面，验证物料列表显示
- TC-E7-01-02: 筛选高价值物料，验证筛选结果
- TC-E7-01-03: 编辑物料属性，验证保存成功
- TC-E7-01-04: 批量导入100条物料，验证导入成功
- TC-E7-01-05: 导出为Excel，验证格式正确

---

##### US-E7-02: PDA特殊物料处理界面

**故事点**：3
**优先级**：P1
**依赖**：E2

**用户故事**：
作为仓库操作员，我需要在PDA上查看特殊物料的处理指引和操作提示。

**验收标准**：
1. 物料信息展示：扫描物料条码后，显示物料类型、存储要求、处理指引
2. 特殊提示：高价值物料显示"需质检"，MSD物料显示"湿度控制"，异形物料显示尺寸和重量
3. 操作引导：根据物料类型显示操作步骤（如"等待质检" → "上架至高价值区"）
4. 异常上报：支持现场异常上报（拍照、填写描述）
5. 离线支持：网络断开时，缓存数据至本地，恢复后自动同步

**技术实现要点**：
- 使用 Blazor Server 开发 PDA 界面
- 在 `SpecialMaterialHandling.razor` 中实现界面
- 条码扫描：调用 PDA 设备的扫描API
- 界面布局：
  ```razor
  <div class="material-info">
      <h3>@MaterialCode</h3>
      <div class="badge @GetBadgeClass()">@MaterialType</div>
      <p>@StorageRequirements</p>
  </div>
  <div class="handling-instructions">
      <h4>处理指引</h4>
      <ol>
          @foreach (var step in HandlingSteps) {
              <li>@step</li>
          }
      </ol>
  </div>
  ```
- 异常上报：使用 Blazor 文件上传组件
- 离线支持：使用 IndexedDB 缓存数据

**测试用例**：
- TC-E7-02-01: 扫描高价值物料，验证信息和指引显示
- TC-E7-02-02: 扫描MSD物料，验证湿度控制提示
- TC-E7-02-03: 上报异常（拍照+描述），验证提交成功
- TC-E7-02-04: 离线模式，验证数据缓存和同步
- TC-E7-02-05: 验证界面响应速度（< 1秒）

---

##### US-E7-03: 异常处理仪表板

**故事点**：2
**优先级**：P1
**依赖**：E4-01

**用户故事**：
作为系统管理员，我需要一个仪表板来实时监控异常情况和处理进度。

**验收标准**：
1. 异常统计：展示待处理、处理中、已解决的异常数量
2. 异常列表：展示最近24小时的异常，按级别排序
3. 实时更新：每分钟自动刷新数据
4. 快速操作：点击异常可快速跳转至处理界面
5. 趋势图：展示最近7天的异常趋势

**技术实现要点**：
- 在 `ExceptionDashboard.aspx` 中实现仪表板
- 使用 SignalR 实现实时数据推送
- 统计卡片：
  ```html
  <div class="stats-card">
      <h3>待处理</h3>
      <div class="count critical">@PendingCount</div>
  </div>
  ```
- 使用 Chart.js 生成趋势图
- 自动刷新：使用 JavaScript setInterval 或 SignalR 推送

**测试用例**：
- TC-E7-03-01: 访问仪表板，验证统计数据显示
- TC-E7-03-02: 验证实时更新（1分钟刷新）
- TC-E7-03-03: 点击异常，验证跳转至处理界面
- TC-E7-03-04: 验证趋势图显示最近7天数据
- TC-E7-03-05: 并发100用户访问，验证性能

## 4. Sprint 规划

### 4.1 团队配置与速率计算

**团队组成**：
- WMS 开发团队：4名开发人员
- 技能分布：2名后端（C#/.NET）、1名前端（Blazor/ASP.NET）、1名全栈

**Sprint 周期**：2周（10个工作日）

**速率计算**：
```
可用工时 = 4人 × 10天 × 6小时/天 = 240小时
有效工时占比 = 70%（扣除会议、代码评审、沟通等）
有效工时 = 240 × 0.7 = 168小时
综合工时系数 = 1.5（包含测试、文档、返工）
团队速率 = 168 ÷ 1.5 = 112 故事点/Sprint
```

**Sprint 分配策略**：
- Sprint 1（56点）：基础架构 + 核心流程（E6, E1, E2部分）
- Sprint 2（57点）：完整流程 + 增强功能（E2剩余, E3, E4, E5, E7）

---

### 4.2 Sprint 1：基础架构与核心流程（2周）

**Sprint 目标**：
建立数据库架构，实现物料分类、路由决策和5种特殊物料类型的核心处理流程。

**总故事点**：56点
**包含 Epic**：E6（13点）、E1（14点）、E2（29点，部分）

#### Sprint 1 任务分解

| 天数 | 任务 | 负责人 | 故事点 | 状态 |
|---|---|---|---|---|
| **Day 1-2: 数据库架构搭建** | | | **13** | |
| Day 1 | US-E6-01: material_extension 表创建 | 后端1 | 3 | 待开始 |
| Day 1 | US-E6-02: routing_rule 表创建 | 后端1 | 3 | 待开始 |
| Day 1 | US-E6-03: special_material_log 表创建 | 后端2 | 2 | 待开始 |
| Day 2 | US-E6-04: SAP物料属性批量同步 | 后端2 | 5 | 待开始 |
| **Day 3-4: 物料分类与路由** | | | **14** | |
| Day 3 | US-E1-01: 物料类型识别 | 后端1 | 3 | 待开始 |
| Day 3 | US-E1-04: 物料属性扩展 | 前端 | 3 | 待开始 |
| Day 4 | US-E1-02: 路由规则引擎实现 | 后端2 | 5 | 待开始 |
| Day 4 | US-E1-03: 路由决策 API | 后端1 | 3 | 待开始 |
| **Day 5-8: 特殊物料类型处理** | | | **29** | |
| Day 5-6 | US-E2-01: 高价值物料流程 | 后端1 | 8 | 待开始 |
| Day 5-6 | US-E2-02: MSD物料流程 | 后端2 | 8 | 待开始 |
| Day 7 | US-E2-03: 异形物料流程 | 全栈 | 5 | 待开始 |
| Day 7 | US-E2-06: QMS Webhook 集成 | 后端1 | 3 | 待开始 |
| Day 8 | US-E2-04: PCB物料流程 | 后端2 | 5 | 待开始 |
| **Day 9-10: 集成测试与修复** | | | | |
| Day 9 | 集成测试：E1 + E2 流程联调 | 全员 | - | 待开始 |
| Day 10 | Bug修复、代码评审、文档完善 | 全员 | - | 待开始 |

#### Sprint 1 验收标准

**必须完成**：
1. ✅ 数据库表结构创建完成，通过DDL验证
2. ✅ 物料分类识别功能正常，支持5种类型
3. ✅ 路由规则引擎运行正常，规则匹配准确率 > 95%
4. ✅ 高价值物料、MSD物料流程完整，QMS集成成功
5. ✅ 所有 P0 User Story 的单元测试通过率 > 90%

**可延后**：
- US-E2-05: 机构件物料流程（5点）→ 延后至 Sprint 2

---

### 4.3 Sprint 2：完整流程与增强功能（2周）

**Sprint 目标**：
完成剩余物料类型处理、库位分配上架、异常处理、报表追溯和UI增强功能。

**总故事点**：57点
**包含 Epic**：E2剩余（5点）、E3（21点）、E4（13点）、E5（8点）、E7（10点）

#### Sprint 2 任务分解

| 天数 | 任务 | 负责人 | 故事点 | 状态 |
|---|---|---|---|---|
| **Day 1: 机构件物料流程** | | | **5** | |
| Day 1 | US-E2-05: 机构件物料流程 | 后端1 | 5 | 待开始 |
| **Day 2-5: 库位分配与上架** | | | **21** | |
| Day 2-3 | US-E3-01: 库位分配策略引擎 | 后端2 | 8 | 待开始 |
| Day 3 | US-E3-04: 库位容量管理 | 前端 | 3 | 待开始 |
| Day 4 | US-E3-02: RCS上架任务创建 | 后端1 | 5 | 待开始 |
| Day 5 | US-E3-03: 上架确认处理 | 后端1 | 5 | 待开始 |
| **Day 6-7: 异常处理与监控** | | | **13** | |
| Day 6 | US-E4-01: 异常检测与告警 | 后端2 | 5 | 待开始 |
| Day 6 | US-E4-03: RCS状态同步 | 后端1 | 3 | 待开始 |
| Day 7 | US-E4-02: 人工介入工作流 | 全栈 | 5 | 待开始 |
| **Day 7-8: 报表与追溯** | | | **8** | |
| Day 7 | US-E5-01: 特殊物料移动报表 | 前端 | 3 | 待开始 |
| Day 8 | US-E5-02: 物料追溯查询 | 前端 | 3 | 待开始 |
| Day 8 | US-E5-03: 性能指标仪表板 | 前端 | 2 | 待开始 |
| **Day 8-9: UI/PDA 增强** | | | **10** | |
| Day 8-9 | US-E7-01: 物料分类管理界面 | 前端 | 5 | 待开始 |
| Day 9 | US-E7-02: PDA特殊物料处理界面 | 全栈 | 3 | 待开始 |
| Day 9 | US-E7-03: 异常处理仪表板 | 前端 | 2 | 待开始 |
| **Day 10: 集成测试与发布** | | | | |
| Day 10 | 端到端测试、性能测试、发布准备 | 全员 | - | 待开始 |

#### Sprint 2 验收标准

**必须完成**：
1. ✅ 所有5种物料类型处理流程完整
2. ✅ 库位分配策略正常，RCS任务下发成功率 > 95%
3. ✅ 异常检测告警正常，人工介入流程可用
4. ✅ 报表和追溯功能正常，数据准确性 > 99%
5. ✅ UI/PDA界面可用，用户体验测试通过
6. ✅ 端到端测试通过，性能指标达标

---

### 4.4 风险评估与缓解措施

#### 高风险项（需重点关注）

| 风险项 | 影响 | 概率 | 缓解措施 |
|---|---|---|---|
| **QMS集成接口不稳定** | 高 | 中 | 1. 提前与QMS团队对接测试环境<br>2. 实现Mock服务用于开发测试<br>3. 增加重试和降级机制 |
| **RCS API响应慢** | 中 | 高 | 1. 实现异步任务处理<br>2. 增加超时和重试机制<br>3. 与RCS团队协调性能优化 |
| **数据库性能瓶颈** | 高 | 低 | 1. 提前进行性能测试（100万条日志）<br>2. 优化索引和查询语句<br>3. 考虑分区表方案 |
| **需求变更** | 中 | 中 | 1. 冻结需求，变更走正式流程<br>2. 预留10%缓冲时间<br>3. 优先级管理，P1功能可延后 |

#### 中风险项（需监控）

| 风险项 | 影响 | 概率 | 缓解措施 |
|---|---|---|---|
| **团队成员请假** | 中 | 低 | 1. 关键模块双人备份<br>2. 代码评审确保知识共享<br>3. 文档完善，降低依赖 |
| **技术难点攻关耗时** | 中 | 中 | 1. 提前技术预研（Redis分布式锁、Hangfire定时任务）<br>2. 寻求技术专家支持<br>3. 备选方案准备 |
| **测试环境不稳定** | 低 | 中 | 1. 本地Mock环境搭建<br>2. 与运维协调环境稳定性<br>3. 自动化测试减少依赖 |

---

### 4.5 依赖管理

#### 外部依赖

| 依赖项 | 依赖方 | 交付物 | 期望时间 | 状态 | 负责人 |
|---|---|---|---|---|---|
| QMS测试环境 | QMS团队 | 测试环境URL、API文档 | Sprint 1 Day 3 | 待确认 | QMS负责人 |
| RCS测试环境 | RCS团队 | 测试环境URL、API文档 | Sprint 1 Day 3 | 待确认 | RCS负责人 |
| SAP接口文档 | SAP团队 | RFC/OData接口文档 | Sprint 1 Day 1 | 待确认 | SAP负责人 |
| 数据库权限 | DBA | 建表权限、Schema设计评审 | Sprint 1 Day 1 | 待确认 | DBA |

#### 内部依赖

| 依赖项 | 被依赖方 | 依赖方 | 交付物 | 期望时间 |
|---|---|---|---|---|
| 数据库表结构 | E6 | E1, E2 | DDL脚本 | Sprint 1 Day 2 |
| 路由规则引擎 | E1 | E2, E3 | RoutingService API | Sprint 1 Day 4 |
| 物料类型处理 | E2 | E3 | MaterialHandler API | Sprint 1 Day 8 |
| 库位分配策略 | E3 | E4 | LocationAllocationService | Sprint 2 Day 5 |

---

### 4.6 质量保证计划

#### 测试策略

**单元测试**：
- 覆盖率目标：> 80%
- 关键模块（路由引擎、库位分配）：> 90%
- 工具：xUnit + Moq

**集成测试**：
- Sprint 1 Day 9：E1 + E2 集成测试
- Sprint 2 Day 10：E3 + E4 + E5 集成测试
- 工具：Postman + 自动化脚本

**端到端测试**：
- Sprint 2 Day 10：完整业务流程测试
- 场景：高价值物料入库 → 质检 → 上架 → 追溯
- 工具：Selenium + 手工测试

**性能测试**：
- 并发测试：100并发用户
- 数据量测试：100万条日志查询
- 响应时间：API < 500ms (P95)

#### 代码评审

- **频率**：每个 User Story 完成后
- **评审人**：至少1名其他开发人员
- **检查项**：代码规范、安全性、性能、可维护性

#### 文档要求

- **技术文档**：API文档、数据库设计文档、部署文档
- **用户文档**：操作手册、PDA使用指南
- **交付时间**：Sprint 2 Day 10

---

## 5. 附录

### 5.1 术语表

| 术语 | 英文 | 说明 |
|---|---|---|
| 特殊物料 | Special Material | 需要特殊存储或处理的物料类型 |
| 高价值物料 | High-Value Material | 价值较高，需要额外安全措施的物料 |
| MSD物料 | Moisture Sensitive Device | 湿敏器件，需要湿度控制 |
| 异形物料 | Irregular Material | 尺寸或形状不规则的物料 |
| 路由决策 | Routing Decision | 根据规则决定物料目标库位的过程 |
| 库位分配 | Location Allocation | 为物料分配具体存储库位 |
| 上架 | Putaway | 将物料搬运至目标库位的过程 |
| RCS | Robot Control System | 机器人控制系统，负责AGV调度 |
| QMS | Quality Management System | 质量管理系统 |
| SAP | Systems Applications Products | 企业资源计划系统 |

### 5.2 参考文档

| 文档名称 | 路径 | 版本 |
|---|---|---|
| 软件需求规格说明书 | `docs/SRS.md` | v1.0 |
| 特殊物料处理设计文档 | `docs/design/3.5-special-material-handling.md` | v1.0 |
| 系统架构设计 | `docs/system_architecture.md` | v1.0 |
| 用户需求文档 | `docs/user_requirement.md` | v1.0 |
| 任务分解参考模板 | `docs/planning/3.2.1-task-breakdown.md` | v1.0 |

### 5.3 变更记录

| 版本 | 日期 | 变更内容 | 变更人 |
|---|---|---|---|
| v1.0 | 2025-01-02 | 初始版本创建 | Claude |

---

## 6. 依赖关系图 (Dependency Graph)

```
E6 (数据库架构与集成)
  ↓
E1 (物料分类与路由决策)
  ↓
E2 (特殊物料类型处理流程)
  ↓
E3 (库位分配与上架执行)
  ↓
E4 (异常处理与状态监控) ← E5 (报表与追溯)
  ↓
E7 (UI/PDA 功能增强)
```

**关键路径**: E6 → E1 → E2 → E3 → E4 → E7

**并行开发机会**:
- E5 (报表与追溯) 可在 E3 完成后与 E4 并行开发
- E7 (UI/PDA 增强) 可在 E1、E2 完成后提前启动部分工作

---

## 7. 风险与缓解措施 (Risks & Mitigation)

### 高风险项

| 风险项 | 影响 | 概率 | 缓解措施 |
|---|---|---|---|
| **QMS 集成接口不稳定** | 高 | 中 | 1. 提前与 QMS 团队对接测试环境<br>2. 实现 Mock 服务用于开发测试<br>3. 增加重试和降级机制<br>4. 建立 Webhook 失败告警 |
| **RCS API 响应慢或不稳定** | 高 | 中 | 1. 实现异步任务处理机制<br>2. 增加超时和重试逻辑<br>3. 与 RCS 团队协调性能优化<br>4. 准备人工降级方案 |
| **MSD 物料湿度控制逻辑复杂** | 中 | 高 | 1. 提前与业务团队确认 MSD 等级标准<br>2. 参考 IPC/JEDEC 标准实现<br>3. 建立完整的测试用例覆盖 |
| **数据库性能瓶颈** | 高 | 低 | 1. 提前进行性能测试（100万条日志）<br>2. 优化索引和查询语句<br>3. 实施分区表方案<br>4. 使用 Redis 缓存热点数据 |

### 中风险项

| 风险项 | 影响 | 概率 | 缓解措施 |
|---|---|---|---|
| **物料类型兼容性矩阵不完整** | 中 | 中 | 1. 与业务团队充分沟通确认规则<br>2. 设计灵活的规则配置机制<br>3. 支持运行时规则调整 |
| **SAP 批量同步性能问题** | 中 | 中 | 1. 实施增量同步策略<br>2. 优化批量处理逻辑<br>3. 错峰执行（凌晨时段） |
| **异形物料库位分配复杂** | 中 | 中 | 1. 建立完整的库位容量数据<br>2. 实现智能推荐算法<br>3. 提供人工干预接口 |
| **团队成员请假或离职** | 中 | 低 | 1. 关键模块双人备份<br>2. 代码评审确保知识共享<br>3. 完善技术文档 |

### 低风险项

| 风险项 | 影响 | 概率 | 缓解措施 |
|---|---|---|---|
| **需求变更** | 中 | 低 | 1. 冻结需求，变更走正式流程<br>2. 预留 10% 缓冲时间<br>3. P1 功能可延后至后续迭代 |
| **测试环境不稳定** | 低 | 中 | 1. 本地 Mock 环境搭建<br>2. 与运维协调环境稳定性<br>3. 自动化测试减少依赖 |

---

## 8. 验收标准总览 (Overall Acceptance Criteria)

### 功能完整性

- [ ] 所有 7 个 Epic 的用户故事全部完成
- [ ] 所有验收标准通过测试
- [ ] 端到端流程可正常运行（物料到货 → 分类 → 路由 → 上架 → 追溯）
- [ ] 5 种特殊物料类型处理流程全部验证通过

### 性能要求

- [ ] 物料类型识别响应时间 < 500ms
- [ ] 路由决策 API 响应时间 < 500ms (P95)
- [ ] 库位分配响应时间 < 1s
- [ ] RCS 任务创建响应时间 < 2s
- [ ] 报表查询响应时间 < 3s（10万条数据）
- [ ] 支持并发 50 个物料同时处理

### 可靠性要求

- [ ] QMS 集成成功率 > 95%（含重试）
- [ ] RCS 任务下发成功率 > 98%
- [ ] SAP 同步成功率 > 99%
- [ ] 系统可用性 > 99.5%
- [ ] 数据一致性 100%（WMS 与 SAP）

### 数据质量

- [ ] 物料分类准确率 100%
- [ ] 路由决策准确率 > 99%
- [ ] 库位分配成功率 > 95%
- [ ] 物料类型兼容性校验准确率 100%
- [ ] 审计日志完整性 100%
- [ ] 追溯数据完整性 100%

### 安全性要求

- [ ] 高价值物料全程追溯记录完整
- [ ] 操作日志记录所有关键操作
- [ ] 权限控制：仅授权人员可执行人工介入操作
- [ ] 数据加密：敏感数据传输加密
- [ ] 审计合规：满足内部审计要求

### 用户体验

- [ ] PDA 界面响应流畅（< 1s）
- [ ] Web 管理界面操作直观
- [ ] 异常提示清晰明确
- [ ] 报表数据可视化清晰
- [ ] 用户培训材料完整

---

**文档结束**
