kaizhoumasha/fxn_wms/docs/user_requirement.md

# 休斯顿P9自动化仓库功能分解清单

## 硬件清单

| 项次 | 使用区域 | 硬件 | 数量 | 用途说明 |
| --- | --- | --- | --- | --- |
| 1 | 码头收货区 | PDA | 3 | 用来点货，绑定栈板发运送任务，高值物料，MSD&非规则物料，PCB物料，机构件物料都用这些PDA |
| 2 | 码头收货区 | 电脑 | 1 | 用来做栈板条码打印，导入到货清单 |
| 3 | 码头收货区 | 打印机 | 1 | 打印栈板条码 |
| 4 | IQC待检区 | PDA | 1 | 用来登记抽检的料盘 |
| 5 | IQC复判区 | PDA | 1 | 复判挑选的物料拆栈板 |
| 6 | 料盘装箱区 | 工业电脑 | 1 | 显示待装箱列表，安排装箱任务 |
| 7 | 料盘装箱区 | PDA | 1 | 扫描栈板进行拆栈板作业，呼叫RCS |
| 8 | SMT作业区 | 工业电脑 | 3 | 自动线2台，人工线1台，用来装箱作业 |
| 9 | 高值区 | PDA | 1 | 绑定六合一 |
| 10 | 机构件作业区 | 工业电脑 | 1 | 控制机构件流水线及机械臂，呼叫机构件发料任务 |
| 11 | 机构件作业区 | PDA | 1 | 人工呼叫RCS |
| 12 | LCR&X-ray区 | 电脑 | 1 | 连接LCR测试仪进行LCR测试 |
| 13 | LCR&X-ray区 | 工业电脑 | 1 | 控制流水线及机械臂 |

---

## 码头到收货暂存区

### 作业流程清单

**[WMS]**
> 1.WMS增加PDA程序，登记到货清单信息，车牌号、到货箱数；如果是快递则登记快递号、到货箱数。

**[IQC]**
> 1.系统需要支持人工入库作业流程，并能够将数据在自动化仓库中调用到。

**[仓库人工]**
> 2.仓库人员登记车牌号，登记到货箱数；如果是快递则登记快递号、到货箱数。

**[IQC]**
> 2.系统需要支持可以中断自动化作业任务，并重启任务功能。

**[仓库人工]**
> 3.仓库人员整理物控给的到货清单

**[IQC]**
> 3.系统需要支持调整自动化任务的作业顺序，提供一下急料优先作业功能。

**[WMS]**
> 4.WMS 导入到货明细（依据物控给出到货清单进行导入）

**[IQC]**
> 4.系统需要维护当前自动运送区域的地图和地码对应信息的基础数据。

**[WMS]**
> 5.WMS 根据PO,项次，料号，数量去请求GRN单号

**[IQC]**
> 5.多方面的数据交互，需要有去有回，发出必须有反馈消息。

**[SAP]**
> 6.SAP给出GRN单号，回传WMS

**[IQC]**
> 6.当前流程中各区域说明：

**[IQC]**
> 6.1码头交接区：从货车卸货的存放区域

**[IQC]**
> 6.2收货暂存区：暂时存放已经绑定栈板号的存货区域，含待检，已检的栈板

**[IQC]**
> 6.3IQC待检区：IQC检验室门口，存放待检栈板的区域

**[IQC]**
> 6.4待复判区：IQC已经检验过一次，但需要复判的栈板存放区域

**[IQC]**
> 6.5料盘装箱区：料盘装箱流水线的上箱号区域

**[WMS]**
> 7.WMS 同步到GRN 单号更新到到货列表中

**[IQC]**
> 7.需要进行初始化的数据：

**[IQC]**
> 7.1一层货架和五层货架的标准箱号、货架号、初始存放地码进行初始化绑定

**[IQC]**
> 7.2退货料架和转运料架的料架号和储位及存放位置的地码进行初始化绑定

**[WMS]**
> 8.打印栈板号（WMS中配置栈板规则，打印唯一的栈板号）

**[仓库人工]**
> 9.仓库人员操作打印栈板功能，按照到货的栈板数量打印出栈板号

**[仓库人工]**
> 10.仓库人员将打印的栈板号，贴到到码头交接区的栈板上（如有历史栈板号需要覆盖）

**[WMS]**
> 11.WMS提供PDA作业程序，进行栈板号，料号，数量（同一料号的数量累计）,选GRN(根据日期+料号+数量去匹配后再选择），扫描AGV地码，提交作业。GRN的总数量需要校验在多个栈板上的累计数量是否满足要求。扫描箱上条码时，可以更改数量；如果箱上没有条码，则输入料号和输入数量。可以循环操作以上步骤，直到本次绑定作业完成。

**[仓库人工]**
> 12.仓库人员使用PDA，扫描栈板号（贴在栈板上的），箱条码（料号、数量），选择GRN，扫描栈板位置的AGV地码，提交数据到系统。重复此操作直到当前收货码头交接区的栈板作业完成为止。

**[WMS]**
> 13.生成码头交接区送收货暂存区任务列表，呼叫RCS

**[RCS]**
> 14.RCS调度E-AGV从码头交接区送收货暂存区

**[WMS]**
> 15.WMS依据GRN的到货时间+GRN收货数量已经绑定完成的条件，推送数据给QMS系统，

**[IQC]**
> 16.QMS接收WMS的GRN数据，计算抽样量

**[WMS]**
> 17.WMS接收QMS的抽样量，并匹配栈板号，生成送IQC待检任务，呼叫RCS，形成IQC送检待检列表-按顺序推单（增加手动调整优先级功能，可以手动调整送检顺序）

**[RCS]**
> 18.RCS调度E-AGV从收货暂存区送IQC待检区

**[WMS]**
> 19.WMS增加IQC取样扫码pkg记录，记录栈板号，GRN，取料的六合一条码

**[IQC]**
> 20.IQC作业员在IQC待检区使用PDA 扫描栈板号，选择GRN，扫描料盘码的六合一条码，记录取样的物料信息。

**[WMS]**
> 21.WMS增加IQC检验完成后，将料盘还回到对应的栈板上，记录归还的栈板号和物料的六合一条码

**[IQC]**
> 22.IQC作业员在IQC待检区使用PDA 扫描料盘六合一条码，系统提示栈板号，再扫描栈板号核对，归还取样的物料信息。

**[WMS]**
> 23.WMS根据GRN，获取IQC的检验结果，分为2种情况：
>   23.1 检验结果OK，生成IQC待验区送收货暂存区任务列表，呼叫RCS
>   23.2 检验结果NG，生产IQC待验区送待复判区任务列表，呼叫RCS

**[RCS]**
> 24.RCS调度E-AGV从IQC待验区送收货暂存区
> 25.RCS调度E-AGV从IQC待验区送待复判区

**[IQC]**
> 26.IQC对复判区的物料进行复判，复判的物料存在三种结果：
>  26.1复判OK，更新QMS的判定结果
>  26.2复判NG，更新QMS的判定结果
>  26.3挑选，更新QMS的判定结果，对栈板进行拆盘处理

**[WMS]**
> 27.WMS根据GRN获取QMS中IQC的复判OK的结果，生成待复判区送收货暂存区任务列表，呼叫RCS

**[RCS]**
> 28.RCS调度E-AGV从待复判区送收货暂存区。

**[WMS]**
> 29.WMS增加栈板号拆数量功能，记录栈板号上拆出的数量和更细栈板上保留的数量。
> 31.WMS接收拆完不良品数量的栈板号，并获取QMS中GRN复判挑选结果，生成待复判区送收货暂存区任务列表，呼叫RCS

**[IQC]**
> 30.承接26.3的挑选业务，作业员在带复判区使用PDA的拆栈板功能，扫描栈板号，扫描箱条码，将不良品从原来栈板上拆出到新的栈板上，提交数据

**[RCS]**
> 32.RCS调度E-AGV从待复判区送收货暂存区。

**[仓库人工]**
> 33.复判和挑选的不良品，仓库人员人工扫描绑定六合一条码，绑定到GRN上，然后人工入库到不良品仓。

**[仓库人工]**
> 34.仓库作业员在料盘装箱区的控制电脑上，打开装箱列表，呼叫物料进行装箱

**[WMS]**
> 35.料盘待装箱列表，做成2个模式：
>  35.1人工作业模式：WMS增加料盘装箱区的待装箱物料列表清单，包含GRN，料号，数量，栈板号；人工操作后按照选中的GRN生成收货暂存区送料盘装箱区任务列表，呼叫RCS
>  35.2系统作业模式：WMS增加系统派送待装箱物料清单列表，按栈板号的时间顺序排列清单，系统生成收货暂存区送料盘装箱区任务列表，呼叫RCS

**[RCS]**
> 36.RCS调度E-AGV从收货暂存区送料盘装箱区。

**[IQC]**
> 备注：

---

## 收货暂存区到料盘装箱区

### 作业流程清单

**[WMS]**
> 0.WMS系统中需要维护供应商提供的物料料号的厚度，尺寸等基础数据。

**[仓库人工]**
> 1.仓库人员在装箱区的控制电脑上打开呼叫列表：
>  1.1人工作业模式：人工选择待装箱清单GRN，料号，数量，栈板号；确认送装箱区域，发起运送任务，呼叫RCS。
>  1.2系统派送模式：根据暂存区的待装箱物时间顺序，按照料号的料盘规格大小，系统生成收料暂存区送料盘装箱区任务列表，呼叫RCS

**[WMS]**
> 1.1一层货架存放区：存放空的一层货架（含标准箱，并已经初始化在系统中）的区域

**[WMS]**
> 1.2料盘装箱区：料盘装箱流水线的上箱号区域

**[WMS]**
> 1.3收货暂存区：暂时存放已经绑定栈板号的存货区域，含待检，已检的栈板

**[WMS]**
> 1.4待入库缓存区：一层货架送过来到SMT作业区中的待入库的存放区域

**[WMS]**
> 1.5空栈板存放区：拆完箱后，空栈板的存放区域

**[RCS]**
> 2.RCS调度E-AGV从收货暂存区送料盘装箱区。

**[WMS]**
> 3.WMS提供一层货架和五层货架的标准箱号、货架号、初始存放地码进行初始化绑定。
> 4.依据仓库调度装箱任务，分析装箱区是否有可用的标准箱，如果没有，则按照装箱任务，生成从一层货架存放区送料装箱区的调度任务，呼叫RCS。

**[RCS]**
> 5.RCS调度潜伏式AGV从一层货架存放区送到料盘装箱区

**[装箱流水线控制]**
> 6.机械臂扫描一层货架的箱号、地码。
> 7.控制系统检查一层货架中的所有的箱必须是空的，如果非空则报警，停止作业。
> 8.检查是空箱，则将箱号、地码发送给WMS。

**[WMS]**
> 9.WMS提供接口，接收装箱流水线控制系统发回的一层货架的箱号、地码信息，并回传接收的结果信息

**[装箱流水线控制]**
> 10.接收WMS回传的信息，如果是OK，则待命，如果是NG或者超时，则需要再次发送信息，最多重复三次，如果三次异常则报错,需要人工介入处理。

**[WMS]**
> 11.WMS验证一层货架的箱号、地码到位后，才能进行PDA拆栈板功能。
> 12.WMS提供PDA拆栈板功能，进行栈板号的拆箱作业，扫描栈板号，扫描箱条码

**[仓库人工]**
> 13.仓库人员使用PDA扫描栈板号、箱条码（料号、数量）

**[仓库人工]**
> 14.仓库人员拆开箱，将料盘码串到装箱流水线的串杆上，人工启动流水线的按钮；再串下一串直到当前箱全部串完。
> 15.重复13/14步骤，直到当前栈板全部做完。

**[装箱流水线控制]**
> 16.机械臂抓取料盘，扫描PKG六合一条码（料号，数量，料盘码,LC,DC,供应商码）、厚度、尺寸。
> 17.控制系统做开关，对料盘上的二维码和PKG的六合一信息（一维码）做比对：
>  17.1比对成功，控制系统将PKG六合一信息、厚度、尺寸信息发送给WMS
>  17.2比对失败，则料盘放入NG区域，等待人工处理。

**[WMS]**
> 18.WMS接收控制系统发送的PKG六合一、厚度、尺寸信息；WMS计算PKG存放的箱号：
>  18.1能够算出箱号，则回复OK，并传送PKG六合一信息、箱号给控制系统。
>  18.2算不出箱号，则回复NG，并传送异常消息给控制系统

**[装箱流水线控制]**
> 19.控制系统接收到WMS信息：
>  19.1接收到WMS的OK消息，根据箱号，机械臂将料盘放入对应的箱号：
>    19.1.1在放入前，并确认能够放入，将PKG六合一信息、箱号、结果OK发给WMS
>    19.1.2不能放入，放入失败，则判断情况停止作业，如果是箱满则需要发消息给WMS进行换箱，如果是其他异常，则停止作业，显示异常消息。
>  19.2接收NG消息，则停止作业，显示异常消息，等待WMS的消息。

**[WMS]**
> 20.WMS接收到控制系统放入OK的信息后，根据PKG六合一信息、箱号，进行匹配，将六合一条码匹配到对应的GRN中,并将结果回传给控制系统。
>    匹配逻辑是：当前流水线在装箱的GRN中未绑定满并且料号、供应商码、厚度、尺寸、和装箱的料盘中料号、供应商码、厚度、尺寸一致的料盘。

**[装箱流水线控制]**
> 21.控制系统接收WMS回传绑定完成的消息，则可以重复16步骤作业。

**[WMS]**
> 22.WMS算不出箱号，则表示当前在装箱区的一层货架已经装满，需要启动将装箱区一层货架送SMT作业区的待入库缓存区，呼叫RCS。

**[RCS]**
> 23.RCS 调度潜伏式AGV将一层货架送SMT作业区待入库缓存区。

**[WMS]**
> 24.待当前任务完成后，再生成空箱货架运送任务，从一层货架存放区送料盘装箱区的调度任务，再呼叫RCS。

**[RCS]**
> 25.RCS调度潜伏式AGV将一层货架从一层货架存放区送盘料装箱区（空货架）

**[WMS]**
> 26.WMS接收到RCS的空箱运送到位后，发消息给控制系统

**[装箱流水线控制]**
> 27.控制系统接收到WMS的消息，启动到第6个步骤，开始作业。

**[WMS]**
> 28.WMS提供PDA程序，生成空栈板送回空栈板存放区的任务，呼叫RCS

**[仓库人工]**
> 29.仓库人员发起搬运任务空栈板AGV送回到空栈板区

**[RCS]**
> 30.RCS调度潜伏式AGV将空栈板送回空栈板存放区

**[WMS]**
> 31.WMS提供PDA程序，扫描栈板号，生成将栈板送回收货暂存区任务，呼叫RCS

**[仓库人工]**
> 32.仓库人员发起搬运任务，将未装完的栈板送回送回收货暂存区

**[RCS]**
> 33.RCS调度潜伏式AGV将栈板送回收货暂存区

### 备注

- 备注：

- 1.当前流程中各个区域说明：

---

## 料盘装箱区到SMT作业区

> WMS系统作业场景 仓库人工作业场景 装箱流水线控制系统 自动化RCS作业场景

> 1.SMT作业区有2条自动线和1条人工线，每条线配置一台一体机的控制电脑，安装WMS作业程序控制出入库

| 2.待入库缓存区叫料列表：
 2.1人工作业模式：WMS增加待入库缓存区的待入库物料列表清单，包含GRN，料号，数量，栈板号；人工操作后按照选中的GRN生成入库缓存区送一层货架到装箱流水线任务列表，呼叫RCS。
 2.2系统作业模式：WMS增加系统派送入库缓存区的待入库物料清单列表，按栈板号入暂存区的时间顺序排列清单，生成入库缓存区送一层货架到装箱流水线任务列表，呼叫RCS。
 2.3系统满箱模式：WMS增加系统满箱判断逻辑，依据一层货架上的料箱，计算料箱的实际容量/计划容量≧80%并且SMT料箱存储区的五层货架中有空料箱（可能要预设多种规则满足不同要求），生成入库缓存区送一层货架到满箱交换区的任务列表，调整好CTU可以获取料箱的角度，呼叫RCS | 3.仓库人员在自动线开启控制电脑，打开WMS程序，选择入库作业，打开待入库作业列表：
 3.1人工作业模式：人工选择待入库清单的GRN，料号，数量，栈板号；发起运送任务，呼叫RCS。
 3.2系统作业模式：选择系统作业模式，启动呼叫RCS。 |  | 4.RCS调度潜伏式AGV将一层货架从待入库区运送到自动流水线待拣区。
5.RCS调度潜伏式AGV将一层货架从待入库区运送到满箱交换区。 |
| --- | --- | --- | --- |
| 6.WMS根据待入库缓存区的叫料列表任务，生成仓库五层货架送SMT作业区的五层货架缓存区，根据人工叫料顺序生成或者系统的货架号入暂存区的作业时间顺序生成，呼叫RCS |  |  | 7.RCS调度潜伏式AGV将五层货架从SMT料箱存储区送到SMT作业区的五层货架缓存区。 |
| 8.WMS收到RCS完成五层货架运送任务后，生成CTU任务，将五层货架的箱号搬运到流水线进箱区，呼叫RCS。 |  |  | 9.RCS调度CTU从五层货架上搬运料箱到流水线进箱区 |
|  |  |  | 10.RCS发送消息给装箱流水线控制系统，请求放入料箱 |
|  |  | 11.控制系统接收RCS消息，确认能否放入料箱：<br> 11.1 返回OK及可以接收，则允许放入。<br> 11.2 返回NG及异常信息，则不允许放入。 |  |
|  |  |  | 12.RCS接收到控制系统消息:<br> 12.1接收OK消息，启动搬运任务，先扫描箱号是否与WMS传的任务一致，如果一致则搬运放入，回消息给控制系统，确认搬运完成；这个时候也需要回消息给WMS，告知搬运任务完成。<br> 12.2接收NG消息，则不能启动搬运任务，等待，按一定的间隔时间再请求放入，直到可以作业为止。<br> 12.3如果CTU搬运的箱号与WMS发的消息不一致，任务终止，消息回传WMS系统，WMS当成异常处理。 |
|  |  | 13.控制系统接收到RCS回馈搬运完成后，启动流水线，将料箱流向流水线作业区。 |  |
| 14.WMS接收到RCS的12步骤CTU搬运任务和RCS的4步骤任务搬运后，WMS计算出来逻辑：<br> 14.1两个步骤都完成，发送消息给控制系统，启动拣料作业<br> 14.2如果12步骤消息没有完成，则启动8步骤，重新计算CTU搬运任务发给RCS。<br> 14.3如果4步骤消息没有完成，则启动2步骤，重新计算新的一层货架搬运任务发给RCS。 |  | 15.控制系统接收到WMS的启动消息，扫描流水线待拣区的一层货架箱号（A/B两个位置共8个箱号）<br>16.机械臂启动扫描流水线作业区的箱号 |  |
|  |  | 17.将待拣货区的箱号（8个）和作业区的料箱箱号信息发回给WMS |  |
| 18.WMS接收到控制系统发回的箱号，计算出拣货的任务：<br> 18.1能够计算出拣货任务，将拣货来源箱的储位，料号，数量，拣货目标箱号，发送给控制系统，启动拣货。<br> 18.2如果计算不出拣货任务，则发送目标料箱箱号流向流水线出箱区的任务。 |  | 19.控制系统收到WMS的拣货消息：<br> 19.1有拣货任务，启动机械臂进行拣货，拿起料盘，扫描料盘的PKG六合一信息，厚度，尺寸。<br> 19.2无拣货任务，则启动流水线将料箱送入流水线出箱区，料箱到达出箱区位置，发送消息给WMS。 |  |
|  |  | 20.机械臂移动到装箱作业区，测量能否放入，并计数，在放入前把PKG六合一信息，厚度，尺寸发送给WMS。 |  |
| 21.WMS接收到控制系统的PKG六合一信息，厚度，尺寸，进行箱号的入库转运处理，处理完成，回消息给控制系统当前处理完成。 |  | 22.控制系统收到WMS消息，放入物料，当前小循环作业结束；机械臂根据19.1的拣货任务，计算数量是否满足任务要求，未满足，则重复19-22的步骤，直到19的拣货任务完成。 |  |
|  |  | 23.当前拣货任务完成，控制系统发送消息给WMS系统，告知当前拣货任务完成。 |  |
| 24.WMS收到控制系统的18的拣货任务完成，重复进行18步骤，计算拣货任务，如有则重复18-24步骤 |  |  |  |
| 25.WMS收到控制系统19.2的料箱送达流水线出箱区的消息，WMS发起CTU搬运任务，将料箱从流水线出箱区搬运到五层货架上 |  |  | 26.RCS调度CTU将料箱从流水线出箱区搬运到五层货架上。 |
|  |  |  | 27.RCS发送消息给装箱流水线控制系统，请求搬运出箱区料箱 |
|  |  | 28.控制系统接收RCS消息，确认能否搬运出箱区料箱：<br> 28.1 返回OK及可以搬运，则允许搬运。<br> 28.2 返回NG及异常信息，则不允许搬运。 | 29.RCS接收到控制系统消息:<br> 29.1接收OK消息，启动搬运任务，先扫描箱号是否与WMS传的任务一致，如果一致则搬运到五层货架，回消息给控制系统，确认搬运完成；这个时候也需要回消息给WMS，告知搬运任务完成。<br> 29.2接收NG消息，则不能启动搬运任务，等待，按一定的间隔时间再请求取出，直到可以作业为止。<br> 29.3如果CTU搬运的箱号与WMS发的消息不一致，任务终止，需要人工干预确认箱号信息，消息回传WMS系统，WMS当成异常处理。 |
| 30.WMS收到RCS的CTU搬运任务的消息：<br> 30.1收到未完成任务消息，任务终止，等待人工干预后，再重新发任务。<br> 30.2完成任务，WMS进行判断当前流水线待拣区的货架物料是否已经全部完成拣货:<br>  30.2.1未完成拣货，启动6步骤，重复6-30的步骤任务<br>  30.2.2已经拣货完成：<br>   30.2.2.1WMS增加生成将一层货架从流水线待拣区运送到一层货架存放区的任务，呼叫RCS<br>   30.2.2.2启动2步骤，重复2-30的步骤任务（待空的一层货架搬运完成后再启动） |  |  |  |
|  |  |  | 31.RCS调度潜伏式AGV将一层货架从流水线待拣区送一层货架存放区，完成任务后返回WMS |
| 32.承接30.2.2拣货完成，启动步骤2，重复2-30的步骤任务 |  |  |  |
| 33.WMS接收到RCS运送完一层货架到满箱交换区的任务完成消息，并且收到RCS运送完五层货架到五层货架缓存区的任务完成消息，WMS发起满箱交换任务，生成一层货架的箱号与五层货架的箱号,角度进行交换的任务，呼叫RCS（分为多个换箱任务）。 |  |  | 34.RCS调度CTU将一层货架指定的料箱箱号和五层货架的指定料箱箱号进行交换，交互完成，发回消息给WMS。 |
| 35.WMS接收到RCS完成CTU的料箱交换任务消息，WMS将一层货架的箱号先拆解，再绑定新箱号；将五层货架的箱号先拆解，再绑定新箱号；最后进行物料的入库转运处理。 |  |  |  |
| 36.WMS判断一层货架全部满箱交换完成：<br> 36.1一层货架上还有料箱未作业完，则生成一层货架送回待入库缓存区的搬运任务，呼叫RCS。<br> 36.2一层货架上的料箱全部做完（只有空料箱），则生成一层货架送回一层货架存放区，呼叫RCS。 |  |  | 37.RCS调度潜伏式AGV将一层货架送回待入库缓存区<br>38.RCS调度潜伏式AGV将一层货架送回一层货架存放区 |
| 39.WMS增加五层货架送回仓库作业任务，检查五层货架是否已经完成装料，若已经完成，生成五层货架送回SMT料箱存储区任务，呼叫RCS。 |  |  | 40.RCS调度潜伏式AGV将五层货架送回SMT料箱存储区 |
| 备注： |  |  |  |
| 1.SMT作业区划分具体的小区域说明： |  |  |  |
| 1.1待入库缓存区：一层货架送过来到SMT作业区中的待入库的存放区域 |  |  |  |
| 1.2五层货架缓存区：仓库的五层货架在SMT作业区存放区域 |  |  |  |
| 1.3满箱交换区：将一层货架与五层货架进行满箱交换的区域 |  |  |  |
| 1.4流水线待拣区：将一层货架放到流水线进行拣货的区域 |  |  |  |
| 1.5流水线进箱区：将五层货架的标准箱放到流水线待进入装货的区域 |  |  |  |
| 1.6流水线出箱区：将流水线上的标准箱待放回五层货架的区域 |  |  |  |
| 1.7流水线作业区：机械臂拣料放入标准箱的装箱区域 |  |  |  |

---

## SMT料箱存储区到SMT作业区

> 其他系统作业场景 WMS系统作业场景 仓库人工作业场景 装箱流水线控制系统 自动化RCS作业场景

> 1.SAP提供工单发料单到WMS系统 2.WMS系统从SAP中下载工单发料单

| 3.生管确认工单生产顺序（表格方式），更新到WMS系统中
4.工程需要在MES系统中维护好上料表 | 4.WMS系统按照工单列出发料单列表，工单的选择范围：生管确认提前期（默认3天）要生产的工单，按照开线+物料未满足指定间隔时间（默认6小时）需要生产的工单。
 4.1人工作业模式：人工选择工单，进行物料计算，发起发料运送任务，呼叫RCS。
 4.2系统作业模式：按照工单生产时间的先后循序，进行物料计算，发起发料运送任务，呼叫RCS。
 4.3生成的搬运任务按物料分类电子料、贵重料、MSD物料、PCB物料、其他非规则物料这5个类型来生成搬运任务，对于电子料需要分为2个任务（首套料，再做6小时物料）：
  4.3.1电子料退料料架2个搬运任务（首套料，补料），从SMT存储区搬运到流水线待拣区A位置。
  4.3.2电子料五层货架2个搬运任务（首套料，补料），从SMT存储区搬运到五层货架缓存区。
  4.3.3MSD物料五层货架搬运任务，从SMT存储区搬运到人工线五层货架缓存区
  4.3.4PCB物料单层货架搬运任务，从PCB存储区搬运到人工线五层货架缓存区
  4.3.5非规则物料五层货架搬运任务，从SMT存储区搬运到人工线五层货架缓存区
 4.4按照工单生成空转运货架的搬运任务：
  4.4.1转运料架存放区搬运到流水线待拣区B位置的搬运任务，呼叫RCS
  4.4.2转运料架存放区搬运到人工线待拣区的搬运任务，呼叫RCS
发料计算优先逻辑：
 a.计算退料货架上的物料进行发料。
 b.计算DC的时间先后顺序的物料进行发料。
 c.计算SMT存储区储位实际容量从小到大的存放物料进行发料。 | 5.仓库人员在作业线的控制电脑上，打开WMS程序，切换出库作业，显示出库列表：
 5.1人工选择工单，发起工单发料任务，启动呼叫RCS
 5.2系统作业模式，选择系统作业模式，按工单时间顺序发料，启动呼叫RCS。 |  | 6.RCS调度潜伏式AGV将电子料退料料架从SMT存储区搬运到流水线待拣区A位置。
7.RCS调度潜伏式AGV将电子料五层货架从SMT存储区搬运到五层货架缓存区。
8.RCS调度潜伏式AGV将MSD物料五层货架从SMT存储区搬运到人工线五层货架缓存区
9.RCS调度潜伏式AGV将PCB物料单层货架从PCB存储区搬运到人工线五层货架缓存区
10.RCS调度潜伏式AGV将非规则物料五层货架从SMT存储区搬运到人工线五层货架缓存区
11.RCS调度潜伏式AGV将转运料架从转运料架存放区搬运到流水线待拣区B位置
12.RCS调度潜伏式AGV将转运料架从转运料架存放区搬运到人工线待拣区 |
| --- | --- | --- | --- | --- |
|  | 13.WMS收到RCS的6步骤和11步骤完成消息，发送消息给流水线控制系统，启动退料料架拣料。 |  | 14.控制系统接收到WMS的启动消息，扫描流水线待拣A区退料料架和B区转运料架的两个料架号。<br>15.控制系统将退料料架号和转运料架号信息发回给WMS |  |
|  | 16.WMS接收到控制系统发回的退料料架号和转运料架号，计算出拣货的任务：<br> 16.1能够计算出拣货任务，将拣货来源退货料架的储位，料号及PKG，拣货目标转运料架的储位，发送给控制系统，启动拣货。<br> 16.2如果计算退料料架是另一面的储位需要拣货，则先回控制系统进行等待，再发退料料架转向任务，呼叫RCS转向。<br> 16.3如果计算转运料架需要另一面进行存放，则先回控制系统等待，再发出转换料架转向任务，呼叫RCS转向<br> 16.4如果计算不出拣货任务，则发送退货料架（不管是空的还是有料的）送回SMT存储区任务，呼叫RCS。 |  | 17.控制系统收到WMS的拣货消息：<br> 17.1有拣货任务，启动机械臂进行拣货，拿起料盘，扫描料盘的PKG六合一信息，厚度，尺寸并跟WMS的数据比对，一致则放入目标转运料架，将消息发回给WMS系统；不一致或者无法放入则报警，停止作业，等待人工处理。<br> 17.2无拣货任务，接收到等待消息则停止，等待任务。 | 18.RCS调度潜伏式AGV将退料料架送回SMT存储区，检查是否有6步骤任务，若有则执行6步骤任务。<br>19.RCS调度潜伏式AGV将退料料架进行角度转向，转向完成后发回消息给WMS系统。<br>20.RCS调度潜伏式AGV将转运料架进行角度转向，转向完成后发回消息给WMS系统。 |
|  | 21.WMS接收到控制系统的回传的已经放入的消息，WMS进行工单领料出库转运处理，更新物料料架位置，处理完成；再重复执行16步骤任务，继续拣货直到当面的退料料架拣货全部完成。 |  |  |  |
|  | 22.WMS收到RCS转向任务完成后（19步骤和20步骤的任一一个完成），重复13步骤，发送消息给流水线控制系统，启动拣料 |  | 23.控制系统重复14-17步骤任务 |  |
|  | 24.WMS收到RCS完成7步骤的五层货架运送任务后，生成CTU任务，将五层货架的箱号搬运到流水线进箱区，呼叫RCS。 |  |  | 25.RCS调度CTU从五层货架上搬运料箱到流水线进箱区 |
|  |  |  |  | 26.RCS发送消息给装箱流水线控制系统，请求放入料箱 |
|  |  |  | 27.控制系统接收RCS消息，确认能否放入料箱：<br> 27.1 返回OK及可以接收，则允许放入。<br> 27.2 返回NG及异常信息，则不允许放入。 |  |
|  |  |  |  | 28.RCS接收到控制系统消息:<br> 28.1接收OK消息，启动搬运任务，先扫描箱号是否与WMS传的任务一致，如果一致则搬运放入，回消息给控制系统，确认搬运完成；这个时候也需要回消息给WMS，告知搬运任务完成。<br> 28.2接收NG消息，则不能启动搬运任务，等待，按一定的间隔时间再请求放入，直到可以作业为止。<br> 28.3如果CTU搬运的箱号与WMS发的消息不一致，任务终止，消息回传WMS系统，WMS当成异常处理。 |
|  | 29.WMS收到RCS的28步骤搬运完成消息，并且6或者45步骤的转运料架搬运完成，并且无退料料架拣货任务，发送消息给控制系统，启动料箱拣货。 |  | 30.控制系统接收到WMS的启动消息，扫描流水线待拣区B位置的转运料架号<br>31.机械臂启动扫描流水线作业区的箱号 |  |
|  |  |  | 32.将待拣货区的转运料架号和作业区的料箱箱号信息发回给WMS |  |
|  | 33.WMS接收到控制系统发回的转运料架号和作业区的箱号，计算出拣货的任务：<br> 33.1能够计算出拣货任务，将拣货来源箱的储位，料号，数量，拣货目标料架，发送给控制系统，启动拣货。<br> 33.2计算转运料架需要另一面进行存放，则先回控制系统等待，再发出转换料架转向任务，呼叫RCS转向<br> 33.3如果计算不出拣货任务，则发送目标料箱箱号流向流水线出箱区的任务。 |  | 34.控制系统收到WMS的拣货消息：<br> 34.1有拣货任务，启动机械臂进行拣货，拿起料盘，扫描料盘的PKG六合一信息，厚度，尺寸。<br> 34.2收到WMS的等待消息，则停止作业等待<br> 34.3无拣货任务，则启动流水线将料箱送入流水线出箱区，料箱到达流水线出箱区位置，发送消息给WMS。 |  |
|  |  |  | 35.机械臂移动到装箱作业区，测量能否放入，并计数，在放入前把PKG六合一信息，厚度，尺寸，存储转运料架位置发送给WMS。 |  |
|  | 36.WMS接收到控制系统的PKG六合一信息，厚度，尺寸，进行工单领料出库转运处理，更新物料的料架位置，处理完成，回消息给控制系统当前任务处理完成。 |  | 37.控制系统收到WMS消息，插入物料到转运料架，当前小循环作业结束；机械臂根据34.1的拣货任务，计算数量是否满足任务要求，未满足，则重复34-37的步骤，直到34的拣货任务完成。 |  |
|  |  |  | 38.当前拣货任务完成，控制系统发送消息给WMS系统，告知当前拣货任务完成。 |  |
|  | 39.WMS收到控制系统的33步骤的拣货任务完成，重复进行33步骤，计算拣货任务，如有则重复33-39步骤 |  |  |  |
|  | 40.WMS收到控制系统34.2步骤的料箱送达流水线出箱区的消息，WMS发起CTU搬运任务，将料箱从流水线出箱区搬运到五层货架上 |  |  | 41.RCS调度CTU将料箱从流水线出箱区搬运到五层货架上。 |
|  |  |  |  | 42.RCS发送消息给装箱流水线控制系统，请求搬运出箱区料箱 |
|  |  |  | 43.控制系统接收RCS消息，确认能否搬运出箱区料箱：<br> 43.1 返回OK及可以搬运，则允许搬运。<br> 43.2 返回NG及异常信息，则不允许搬运。 | 44.RCS接收到控制系统消息:<br> 44.1接收OK消息，启动搬运任务，先扫描箱号是否与WMS传的任务一致，如果一致则搬运到五层货架，回消息给控制系统，确认搬运完成；这个时候也需要回消息给WMS，告知搬运任务完成。<br> 44.2接收NG消息，则不能启动搬运任务，等待，按一定的间隔时间再请求取出，直到可以作业为止。<br> 44.3如果CTU搬运的箱号与WMS发的消息不一致，任务终止，需要人工干预确认箱号信息，消息回传WMS系统，WMS当成异常处理。 |
|  |  |  |  | 45.RCS调度潜伏式AGV将转运料架进行角度转向，转向完成后发回消息给WMS系统(33.2步骤的任务）。 |
|  | 46.WMS收到RCS的45步骤搬运完成消息，重复进行29步骤，启动拣货任务 |  |  |  |
|  | 47.WMS增加五层货架送回仓库作业任务，检查五层货架完成逻辑，五层货架上无空位置（无空箱并且无空储位）并且五层货架无CTU搬运任务，则生成五层货架送回SMT料箱存储区任务，呼叫RCS。 |  |  | 48.RCS调度潜伏式AGV将五层货架送回SMT存储区 |
|  | 49.WMS增加转运料架送SMT产线作业任务，检测转运料架完成逻辑,转运料架上没有需要放入料盘的任务（含多个工单放入以及料架未满的情况），则生成转运料架送SMT生产线备料区的任务，呼叫RCS |  |  | 50.RCS调度潜伏式AGV将转运料架送SMT产线备料区，搬完后，检查是否有11步骤的空转运料架搬运任务，如果有，则执行11步骤任务。 |
|  | 备注： |  |  |  |
|  | 1.SMT作业区划分具体的小区域说明： |  |  |  |
|  | 1.1五层货架缓存区：仓库的五层货架在SMT作业区存放区域 |  |  |  |
|  | 1.2流水线待拣区：将料架放到流水线进行拣货的区域，这个区域分为AB两个位置，A位置放待拣货料架，B位置放转运料架 |  |  |  |
|  | 1.3流水线进箱区：将五层货架的标准箱放到流水线待进入装货的区域 |  |  |  |
|  | 1.4流水线出箱区：将流水线上的标准箱待放回五层货架的区域 |  |  |  |
|  | 1.5流水线作业区：机械臂拣料放入标准箱的装箱区域 |  |  |  |
|  | 1.6转运料架存放区：存放空的转运料架区域，用来给工单发料存料的料架 |  |  |  |
|  | 1.7SMT产线备料区：已经领完料的转运料架送到SMT生产线的备料存放区域 |  |  |  |

---

## 高值物料码头到高值区入库作业

### 作业流程清单

**[WMS]**
> 1.WMS增加PDA程序，登记到货清单信息，车牌号、到货箱数；如果是快递则登记快递号、到货箱数。

**[仓库人工]**
> 2.仓库人员登记车牌号，登记到货箱数；如果是快递则登记快递号、到货箱数。

**[仓库人工]**
> 3.仓库人员整理物控给的到货清单

**[WMS]**
> 4.WMS 导入到货明细（依据物控给出到货清单进行导入）

**[WMS]**
> 5.WMS 根据PO,项次，料号，数量去请求GRN单号

**[SAP]**
> 6.SAP给出GRN单号，回传WMS

**[WMS]**
> 7.WMS 同步到GRN 单号更新到到货列表中

**[WMS]**
> 8.打印栈板号（WMS中配置栈板规则，打印唯一的栈板号）

**[仓库人工]**
> 9.仓库人员操作打印栈板功能，按照到货的栈板数量打印出栈板号

**[仓库人工]**
> 10.仓库人员将打印的栈板号，贴到到码头交接区的栈板上（如有历史栈板号需要覆盖）

**[WMS]**
> 11.WMS提供PDA作业程序，进行栈板号，料号，数量（同一料号的数量累计）,选GRN(根据日期+料号+数量去匹配后再选择），扫描AGV地码，提交作业。GRN的总数量需要校验在多个栈板上的累计数量是否满足要求。扫描箱上条码时，可以更改数量；如果箱上没有条码，则输入料号和输入数量。可以循环操作以上步骤，直到本次绑定作业完成。

**[仓库人工]**
> 12.仓库人员使用PDA，扫描栈板号（贴在栈板上的），箱条码（料号、数量），选择GRN，扫描栈板位置的AGV地码，提交数据到系统。重复此操作直到当前收货码头交接区的栈板作业完成为止。

**[WMS]**
> 13.生成码头交接区送高值区内的待检任务列表，呼叫RCS

**[RCS]**
> 14.RCS调度E-AGV从码头交接区送高值区

**[WMS]**
> 15.WMS增加绑定六合一码程序，对物料的六合一码进行绑定

**[仓库人工]**
> 16.仓库人员使用WMS，在高值区对高值物料进行六合一的条码信息进行绑定

**[IQC]**
> 17.IQC作业员在高值区使用PDA 扫描栈板号，选择GRN，扫描料盘码的六合一条码，记录取样的物料信息。

**[WMS]**
> 18.WMS增加IQC取样扫码pkg记录，记录栈板号，GRN，取料的六合一条码

**[IQC]**
> 19.IQC作业员在高值区使用PDA 扫描料盘六合一条码，系统提示栈板号，再扫描栈板号核对，归还取样的物料信息。

**[WMS]**
> 20.WMS增加IQC检验完成后，将料盘还回到对应的栈板上，记录归还的栈板号和物料的六合一条码

---

## MSD&非规则物料码头到MSD存储区入库作业

### 作业流程清单

**[WMS]**
> 1.WMS增加PDA程序，登记到货清单信息，车牌号、到货箱数；如果是快递则登记快递号、到货箱数。

**[仓库人工]**
> 2.仓库人员登记车牌号，登记到货箱数；如果是快递则登记快递号、到货箱数。

**[仓库人工]**
> 3.仓库人员整理物控给的到货清单

**[WMS]**
> 4.WMS 导入到货明细（依据物控给出到货清单进行导入）

**[WMS]**
> 5.WMS 根据PO,项次，料号，数量去请求GRN单号

**[SAP]**
> 6.SAP给出GRN单号，回传WMS

**[WMS]**
> 7.WMS 同步到GRN 单号更新到到货列表中

**[WMS]**
> 8.打印栈板号（WMS中配置栈板规则，打印唯一的栈板号）

**[仓库人工]**
> 9.仓库人员操作打印栈板功能，按照到货的栈板数量打印出栈板号

**[仓库人工]**
> 10.仓库人员将打印的栈板号，贴到到码头交接区的栈板上（如有历史栈板号需要覆盖）

**[WMS]**
> 11.WMS提供PDA作业程序，进行栈板号，料号，数量（同一料号的数量累计）,选GRN(根据日期+料号+数量去匹配后再选择），扫描AGV地码，提交作业。GRN的总数量需要校验在多个栈板上的累计数量是否满足要求。扫描箱上条码时，可以更改数量；如果箱上没有条码，则输入料号和输入数量。可以循环操作以上步骤，直到本次绑定作业完成。

**[仓库人工]**
> 12.仓库人员使用PDA，扫描栈板号（贴在栈板上的），箱条码（料号、数量），选择GRN，扫描栈板位置的AGV地码，提交数据到系统。重复此操作直到当前收货码头交接区的栈板作业完成为止。

**[WMS]**
> 13.生成码头交接区送收货暂存区任务列表，呼叫RCS

**[RCS]**
> 14.RCS调度E-AGV从码头交接区送收货暂存区

**[IQC]**
> 15.QMS接收WMS的GRN数据，计算抽样量

**[WMS]**
> 16.WMS依据GRN的到货时间+GRN收货数量已经绑定完成的条件，推送数据给QMS系统，

**[WMS]**
> 17.WMS接收QMS的抽样量，并匹配栈板号，生成送IQC待检任务，呼叫RCS，形成IQC送检待检列表-按顺序推单（增加手动调整优先级功能，可以手动调整送检顺序）

**[RCS]**
> 18.RCS调度E-AGV从收货暂存区送IQC待检区

**[WMS]**
> 19.WMS增加IQC取样扫码pkg记录，记录栈板号，GRN，取料的六合一条码

**[IQC]**
> 20.IQC作业员在IQC待检区使用PDA 扫描栈板号，选择GRN，扫描料盘码的六合一条码，记录取样的物料信息。

**[WMS]**
> 21.WMS增加IQC检验完成后，将料盘还回到对应的栈板上，记录归还的栈板号和物料的六合一条码

**[IQC]**
> 22.IQC作业员在IQC待检区使用PDA 扫描料盘六合一条码，系统提示栈板号，再扫描栈板号核对，归还取样的物料信息。

**[WMS]**
> 23.WMS根据GRN，获取IQC的检验结果，分为2种情况：
>   23.1 检验结果OK，生成IQC待验区送收货暂存区任务列表，呼叫RCS
>   23.2 检验结果NG，生产IQC待验区送待复判区任务列表，呼叫RCS

**[RCS]**
> 24.RCS调度E-AGV从IQC待验区送收货暂存区
> 25.RCS调度E-AGV从IQC待验区送待复判区

**[IQC]**
> 26.IQC对复判区的物料进行复判，复判的物料存在三种结果：
>  26.1复判OK，更新QMS的判定结果
>  26.2复判NG，更新QMS的判定结果
>  26.3挑选，更新QMS的判定结果，对栈板进行拆盘处理

**[WMS]**
> 27.WMS根据GRN获取QMS中IQC的复判OK的结果，生成待复判区送收货暂存区任务列表，呼叫RCS

**[RCS]**
> 28.RCS调度E-AGV从待复判区送收货暂存区。

**[WMS]**
> 29.WMS增加栈板号拆数量功能，记录栈板号上拆出的数量和更细栈板上保留的数量。
> 31.WMS接收拆完不良品数量的栈板号，并获取QMS中GRN复判挑选结果，生成待复判区送收货暂存区任务列表，呼叫RCS

**[IQC]**
> 30.承接26.3的挑选业务，作业员在带复判区使用PDA的拆栈板功能，扫描栈板号，扫描箱条码，将不良品从原来栈板上拆出到新的栈板上，提交数据

**[RCS]**
> 32.RCS调度E-AGV从待复判区送收货暂存区。

**[仓库人工]**
> 33.复判和挑选的不良品，仓库人员人工扫描绑定六合一条码，绑定到GRN上，然后人工入库到不良品仓。

**[WMS]**
> 34.WMS增加绑定六合一码程序，对物料的六合一码进行绑定

**[仓库人工]**
> 35.仓库人员使用WMS，在作业区对MSD&非规则物料进行六合一的条码信息进行绑定

**[WMS]**
> 36.WMS增加手动扫描栈板号和地码，选择送货的目的地，生成运送任务，呼叫RCS

**[仓库人工]**
> 37.仓库人员使用PDA的WMS程序，扫描栈板号和地码，选择送货目的地，呼叫RCS

**[RCS]**
> 38.RCS调度潜伏式AGV将物料从收货暂存区送MSD&非规则物料存储区

---

## PCB&机构件码头到机构件存储区

### 作业流程清单

**[WMS]**
> 1.WMS增加PDA程序，登记到货清单信息，车牌号、到货箱数；如果是快递则登记快递号、到货箱数。

**[仓库人工]**
> 2.仓库人员登记车牌号，登记到货箱数；如果是快递则登记快递号、到货箱数。

**[仓库人工]**
> 3.仓库人员整理物控给的到货清单

**[WMS]**
> 4.WMS 导入到货明细（依据物控给出到货清单进行导入）

**[WMS]**
> 5.WMS 根据PO,项次，料号，数量去请求GRN单号

**[SAP]**
> 6.SAP给出GRN单号，回传WMS

**[WMS]**
> 7.WMS 同步到GRN 单号更新到到货列表中

**[WMS]**
> 8.打印栈板号（WMS中配置栈板规则，打印唯一的栈板号）

**[仓库人工]**
> 9.仓库人员操作打印栈板功能，按照到货的栈板数量打印出栈板号

**[仓库人工]**
> 10.仓库人员将打印的栈板号，贴到到码头交接区的栈板上（如有历史栈板号需要覆盖）

**[WMS]**
> 11.WMS提供PDA作业程序，进行栈板号，料号，数量（同一料号的数量累计）,选GRN(根据日期+料号+数量去匹配后再选择），扫描AGV地码，提交作业。GRN的总数量需要校验在多个栈板上的累计数量是否满足要求。扫描箱上条码时，可以更改数量；如果箱上没有条码，则输入料号和输入数量。可以循环操作以上步骤，直到本次绑定作业完成。

**[仓库人工]**
> 12.仓库人员使用PDA，扫描栈板号（贴在栈板上的），箱条码（料号、数量），选择GRN，扫描栈板位置的AGV地码，提交数据到系统。重复此操作直到当前收货码头交接区的栈板作业完成为止。

**[WMS]**
> 13.生成码头交接区送收货暂存区任务列表，呼叫RCS

**[RCS]**
> 14.RCS调度E-AGV从码头交接区送收货暂存区

**[IQC]**
> 15.QMS接收WMS的GRN数据，计算抽样量

**[WMS]**
> 16.WMS依据GRN的到货时间+GRN收货数量已经绑定完成的条件，推送数据给QMS系统，

**[WMS]**
> 17.WMS接收QMS的抽样量，并匹配栈板号，生成送IQC待检任务，呼叫RCS，形成IQC送检待检列表-按顺序推单（增加手动调整优先级功能，可以手动调整送检顺序）

**[RCS]**
> 18.RCS调度E-AGV从收货暂存区送IQC待检区

**[WMS]**
> 19.WMS增加IQC取样扫码pkg记录，记录栈板号，GRN，取料的六合一条码

**[IQC]**
> 20.IQC作业员在IQC待检区使用PDA 扫描栈板号，选择GRN，扫描料盘码的六合一条码，记录取样的物料信息。

**[WMS]**
> 21.WMS增加IQC检验完成后，将料盘还回到对应的栈板上，记录归还的栈板号和物料的六合一条码

**[IQC]**
> 22.IQC作业员在IQC待检区使用PDA 扫描料盘六合一条码，系统提示栈板号，再扫描栈板号核对，归还取样的物料信息。

**[WMS]**
> 23.WMS根据GRN，获取IQC的检验结果，分为2种情况：
>   23.1 检验结果OK，生成IQC待验区送收货暂存区任务列表，呼叫RCS
>   23.2 检验结果NG，生产IQC待验区送待复判区任务列表，呼叫RCS

**[RCS]**
> 24.RCS调度E-AGV从IQC待验区送收货暂存区
> 25.RCS调度E-AGV从IQC待验区送待复判区

**[IQC]**
> 26.IQC对复判区的物料进行复判，复判的物料存在三种结果：
>  26.1复判OK，更新QMS的判定结果
>  26.2复判NG，更新QMS的判定结果
>  26.3挑选，更新QMS的判定结果，对栈板进行拆盘处理

**[WMS]**
> 27.WMS根据GRN获取QMS中IQC的复判OK的结果，生成待复判区送收货暂存区任务列表，呼叫RCS

**[RCS]**
> 28.RCS调度E-AGV从待复判区送收货暂存区。

**[WMS]**
> 29.WMS增加栈板号拆数量功能，记录栈板号上拆出的数量和更细栈板上保留的数量。
> 31.WMS接收拆完不良品数量的栈板号，并获取QMS中GRN复判挑选结果，生成待复判区送收货暂存区任务列表，呼叫RCS

**[IQC]**
> 30.承接26.3的挑选业务，作业员在带复判区使用PDA的拆栈板功能，扫描栈板号，扫描箱条码，将不良品从原来栈板上拆出到新的栈板上，提交数据

**[RCS]**
> 32.RCS调度E-AGV从待复判区送收货暂存区。

**[仓库人工]**
> 33.复判和挑选的不良品，仓库人员人工扫描绑定六合一条码，绑定到GRN上，然后人工入库到不良品仓。

**[WMS]**
> 34.WMS增加绑定六合一码程序，对物料的六合一码进行绑定

**[仓库人工]**
> 35.仓库人员使用WMS，在作业区对机构件物料进行六合一的条码信息进行绑定

**[WMS]**
> 36.WMS增加手动扫描栈板号和地码，选择送货的目的地，生成运送任务，呼叫RCS

**[仓库人工]**
> 37.仓库人员使用PDA的WMS程序，扫描栈板号和地码，选择送货目的地，呼叫RCS

**[RCS]**
> 38.RCS调度潜伏式AGV将物料从收货暂存区送MSD&非规则物料存储区

---

## 机构件存储区到机构件作业区

> 其他系统作业场景 WMS系统作业场景 仓库人工作业场景 机构件流水线控制系统 自动化RCS作业场景

> 1.SAP提供工单发料单到WMS系统 2.WMS系统从SAP中下载工单发料单

| 3.生管确认工单生产顺序（表格方式），更新到WMS系统中 | 4.WMS系统按照工单列出发料单列表，工单的选择范围：生管确认提前期（默认3天）要生产的工单，按照开线+物料未满足指定间隔时间（默认6小时）需要生产的工单。
 4.1人工作业模式：人工选择工单，进行物料计算，发起发料运送任务，呼叫RCS。
 4.2系统作业模式：按照工单生产时间的先后循序，进行物料计算，发起发料运送任务，呼叫RCS。
 4.3生成的搬运任务结合SFC回传的工单生产产量（产线的剩余量），生成机构件的发料任务。
  4.3.1人工拣货物料的发料任务，依据产线剩余量和发料间隔时间计算发料任务，呼叫RCS，搬运物料到人工拣选台。
  4.3.2自动线拣货物料的发料任务，依据产线剩余量和自动线缓存时间间隔计算发料任务，呼叫RCS,搬运物料到机构作业区的自动线
发料计算优先逻辑：
 a.计算DC的时间先后顺序的物料进行发料。
 c.计算机构件存储区栈板实际容量从小到大的存放物料进行发料（余料先发）。 | 5.仓库人员在机构件作业线的控制电脑上，打开WMS程序，显示出库列表：
 5.1人工选择工单，发起工单发料任务，启动呼叫RCS
 5.2系统作业模式，选择系统作业模式，按工单时间顺序发料，启动呼叫RCS。 |  | 6.RCS调度E型AGV将机构件的栈板从机构件存储区搬运到机构件作业区人工拣选台。
7.RCS调度E型AGV将机构件的栈板从机构件存储区搬运到机构件作业区自动线的物料缓存区。 |
| --- | --- | --- | --- | --- |
|  | 8.WMS收到7步骤的RCS消息，再生成搬运任务，将机构件的栈板搬运到拆围膜区，进行人工围膜的拆换（两个任务，上盖板的栈板和下盖板的栈板） |  |  | 9.RCS调度E型AGV将机构件的栈板从机构件物料缓存区搬运到机构件作业区自动线的拆围膜区。 |
|  | 10.WMS增加人工呼叫RCS功能，供人工拆完围膜后，人工呼叫RCS进行搬运 | 11.人工拆完围膜后，人工呼叫RCS将机构件的栈板搬运到自动线拆栈板区 |  | 12.RCS调度E型AGV将机构件从机构件物料拆围膜区搬运到机构件作业区自动线的拆栈板区。 |
|  |  |  |  | 13.RCS发送消息给机构件自动线控制系统，请求放入栈板 |
|  |  |  | 14.控制系统接收RCS消息，确认能否放入机构件栈板：<br> 14.1 返回OK及可以接收，则允许放入。<br> 14.2 返回NG及异常信息，则不允许放入。 |  |
|  |  |  |  | 15.RCS接收到控制系统消息:<br> 15.1接收OK消息，启动搬运任务，先扫描栈板号是否与WMS传的任务一致，如果一致则搬运放入，回消息给控制系统，确认搬运完成；这个时候也需要回消息给WMS，告知搬运任务完成。<br> 15.2接收NG消息，则不能启动搬运任务，等待，按一定的间隔时间再请求放入，直到可以作业为止。<br> 15.3如果AGV搬运的栈板号与WMS发的消息不一致，任务终止，消息回传WMS系统，WMS当成异常处理。 |
|  | 16.WMS接收到RCS搬运到机构自动线的拆栈板区，启动自动线作业消息（交替搬运），栈板号和搬运的箱数，发给流水线控制系统。 |  | 17.控制系统收到WMS的拣货启动消息，栈板号和搬运的箱数：<br> 17.1机械臂搬运栈板上一箱物料到流水线上。<br> 17.2流水线启动扫描箱上的PKG(六合一码）信息，将扫描的PKG信息发给WMS系统。<br> 17.3 搬箱子前扫描栈板，确认是否为空栈板，如果是空栈板发消息给WMS系统 |  |
|  | 18.WMS接收到控制系统的回传的PKG消息，系统检查物料是否与当前任务的物料信息一致：<br> 18.1是一致OK,则发消息给控制系统进行流水线启动，拆箱作业。<br> 18.2不一致NG，则发消息给控制系统，物料不一致，需要搬离流水。 |  | 19.控制系统收到WMS的消息后：<br> 19.1OK，启动流水线进入拆箱，回复消息给WMS系统，计算数量有没有搬完，循环17步骤；如果搬完，则发消息给WMS系统完成任务。<br> 19.2NG，箱子搬离流水线，搬下一箱，循环17步骤。 |  |
|  | 20.WMS系统接收到控制系统完成搬运任务或者栈板为空栈板的消息（17.3），检查栈板上是否还有箱：<br> 20.1如果有箱，则循环16步骤，计算栈板号和箱数，发给流水线控制系统。<br> 20.2如果没有箱，则生成空栈板搬运任务，呼叫RCS。 |  |  | 21.RCS调度E型AGV将空栈板从机构件作业区自动线的拆栈板区搬运到空栈板存放区。 |
|  |  |  |  | 22.RCS发送消息给机构件自动线控制系统，请求拉出栈板 |
|  |  |  | 23.控制系统接收RCS消息，确认能否搬离空栈板：<br> 23.1 返回OK及可以接收，则允许搬离。<br> 23.2 返回NG及异常信息，则不允许搬离。 |  |
|  |  |  |  | 24.RCS接收到控制系统消息:<br> 24.1接收OK消息，启动搬运任务，将空栈板搬离，回消息给控制系统，确认搬运完成；这个时候也需要回消息给WMS，告知搬运任务完成。<br> 24.2接收NG消息，则不能启动搬运任务，等待，按一定的间隔时间再请求搬离，直到可以作业为止。 |
|  | 25.WMS系统收到RCS的空栈板搬离完成任务，循环8步骤，搬新栈板过来作业 |  |  |  |
|  |  |  | 26.流水线拆完箱后，在缓存处扫描箱上的PKG条码，发送给WMS系统 |  |
|  | 27.WMS收到控制系统的PKG消息，计算箱子中的搬运数量，将需要搬运的数量，发给流水线控制系统。 |  | 28.流水线收到WMS系统的搬运的数量，按照数量搬运机构件到定位处。 |  |
|  |  |  | 29.流水线在定位处扫描机构件上的条码和箱上的PKG条码，发给WMS系统。 |  |
|  | 30.WMS系统收到流水线的机构件条码和箱上的PKG信息，系统进行资料的绑定，并且要做物料的出库逻辑处理，回传消息给机构件流水线控制系统。 |  | 31.流水线收到WMS系统OK消息，则循环26步骤，持续作业直到任务完成。 |  |
|  |  |  | 32.流水线装满magazine,发消息给RCS系统 |  |
|  |  |  |  | 33.RCS调度举升滚筒AGV，将magazine从自动线搬运到产线暂存区 |
|  |  |  |  | 34.RCS自己调度举升滚筒AGV，将magazine从产线暂存区搬运到产线上料区 |
|  |  |  |  | 35.RCS自己调度举升滚筒AGV，将空的magazine从产线暂存区搬运到机构件自动线的存放区 |
|  | 36.发送PKG和绑定的多个二维码数据给SFC |  |  |  |

---

## 生产退料到SMT清点x-ray&LCR

### 作业流程清单

**[WMS]**
> 0.WMS增加手动扫描一层货架号和地码，选择送货的目的地，生成运送任务，呼叫RCS

**[仓库人工]**
> 1.工单下线，料盘拆飞达放入标准胶框
> 2.标准胶框放到一层货架，人工呼叫RCS，将一层货架搬运到SMT退料作业区

**[RCS]**
> 3.RCS潜伏式AGV将产线退料的一层货架搬运到SMT作业区。

**[仓库人工]**
> 4.作业区人员区分出电子料，MSD物料，高值物料，非规则物料。

**[WMS]**
> 5.WMS提供PKG标签打印，人工扫描退料功能。

**[仓库人工]**
> 6.作业区人员使用WMS的功能，清点物料，打印新物料标签，扫描PKG进行退料作业。

**[仓库人工]**
> 7.作业区人员人工呼叫RCS，将高值物料和非规则物料，送到对应的退料作业区

**[RCS]**
> 8.RCS调度潜伏式AGV将高值物料送入高值存储区
> 9.RCS调度潜伏式AGV将非规则物料送入SMT作业区的人工拣选台

**[仓库人工]**
> 10.作业区人员检查MSD物料的料盘上有没有将外包装的PKG条码贴在料盘上，如果没有需要剪下来贴在料盘上。

**[WMS]**
> 11.WMS判断x-ray的机械臂作业区是否有空的退料料架，没有料架则呼叫RCS，搬运空的退料料架到x-ray的机械臂作业区

**[RCS]**
> 12.RCS调度潜伏式AGV将空的退料料架送入x-ray的机械臂作业区

**[RCS]**
> 13.RCS发送消息给控制系统，请求放入空的退料料架

**[x-Ray控制]**
> 14.控制系统接收RCS消息，确认能否放入空的退料料架：
>  14.1 返回OK及可以接收，则允许放入。
>  14.2 返回NG及异常信息，则不允许放入。

**[RCS]**
> 15.RCS接收到控制系统消息:
>  15.1接收OK消息，启动搬运任务，回消息给控制系统，确认搬运完成；这个时候也需要回消息给WMS，告知搬运任务完成。
>  15.2接收NG消息，则不能启动搬运任务，等待，按一定的间隔时间再请求放入，直到可以作业为止。

**[WMS]**
> 16.WMS提供LCR的测试功能：
>  16.1退料满盘的物料不做LCR测试（满盘按仓库发料未使用来比对）
>  16.2未设置LCR的物料，不做LCR。
>  16.3系统提示需要测试LCR，进行LCR测试：
>   16.3.1测试通过，则提示通过
>   16.3.2测试不通过，则提示不通过

**[仓库人工]**
> 17.作业人员使用WMS的测试LCR功能，扫描PKG条码，依据系统提示作业：
>  17.1需要测试，则测试LCR，系统提示结果进行处理：
>   17.1.1测试通过，则放入流水线
>   17.1.2测试不通过，则放入不良品标准框。
>  17.2不需要测试，则直接放入流水线

**[x-Ray控制]**
> 18.控制系统扫描料盘的PKG，并将PKG发给WMS系统

**[WMS]**
> 19.WMS系统接收到控制系统的PKG，对PKG进行检查判断：
>  19.1满盘（满盘按仓库发料未使用来比对），只发消息给控制系统，不需要进行x-ray清点，直接流到机械臂位置。
>  19.2需要进行x-ray清点，发消息给控制系统进行x-ray清点。

**[x-Ray控制]**
> 20.控制系统收到WMS回传的消息，进行处理：
>  20.1不做x-ray清点，将料盘流到机械臂位置。
>  20.2做x-ray清点，流入x-ray设备进行清点。

**[x-Ray控制]**
> 21.x-ray进行清点，清点后，将旧PKG（六合一）信息和清点后的数量发给WMS系统。

**[WMS]**
> 22.WMS系统接收到控制系统的旧PKG(六合一）信息和清点后数量，生产一个新的PKG（六合一）信息，发回给控制系统

**[x-Ray控制]**
> 23.控制系统收到WMS的新PKG(六合一)信息，发送给打印机进行打印，然后进行贴标，贴标的要求：
>  23.1贴标前需要核对新旧PKG的料号和PKG是否一致
>  23.2贴标需要将旧标签的料号显示出来。

**[x-Ray控制]**
> 24.机械臂扫描新的PKG(六合一)信息，将信息发给WMS系统

**[WMS]**
> 25.WMS系统收到控制系统的PKG，对PKG进行检查判断：
>  25.1物料是MSD物料，需要封包，发消息给控制系统，放入人工作业的标准箱。
>  25.2物料不是MSD物料，并存在退料货架，则发消息给控制系统，放入退料料架中，增加退料处理逻辑和料架储位存放逻辑。
>  25.3不存在退料料架，需要进行11步骤呼叫RCS搬运空退料料架
> 还要确定是否入到哪个仓码

**[x-Ray控制]**
> 26.控制系统收到WMS的消息，将料盘进行分类处理：
>  26.1收到人工箱消息，则机械臂放入人工作业的标准箱
>  26.2收到退货料架和储位号，则机械臂将物料放入退料料架对应的储位号。

**[WMS]**
> 27.WMS系统检查退料料架是否装满：
>  27.1退料料架单面装满，需要转向，发消息给控制系统暂停作业，生成转向任务，呼叫RCS进行转向。
>  27.2退料料架全部装满，则生成搬运任务，将退料料架搬运到SMT存储区，呼叫RCS，同时进行11步骤呼叫RCS搬空退料料架。
>  27.3 退料货架尾数需要人工呼叫RCS送回SMT存储区。

**[RCS]**
> 28.RCS调度潜伏式AGV将退料料架在x-ray的机械臂作业区进行转向任务或者搬离任务

**[RCS]**
> 29.RCS发送消息给控制系统，请求搬运退料料架转向或者搬离

**[x-Ray控制]**
> 30.控制系统接收RCS消息，确认能否进行退料料架转向或者搬离：
>  30.1 返回OK及可以接收，则允许转向或者搬离。
>  30.2 返回NG及异常信息，则不允许转向或者搬离。

**[RCS]**
> 31.RCS接收到控制系统消息:
>  31.1接收OK消息，启动搬运任务，回消息给控制系统，确认搬运完成；这个时候也需要回消息给WMS，告知搬运任务完成。
>  31.2接收NG消息，则不能启动搬运任务，等待，按一定的间隔时间再请求放入，直到可以作业为止。

---
