kaizhoumasha/fxn_wms/docs/design/3.2.1-dock-receiving-binding.md

# 3.2.1 码头接收与绑定 (Dock Receiving & Binding) — 详细设计

## 技术栈说明 (Technology Stack)

### WMS 技术架构

**前端技术**: Blazor Server (前后端不分离)

- **Web 界面**: Blazor Server App
  - 到货登记页面、清单导入页面、栈板打印页面、GRN 替换页面等
  - 服务端渲染，通过 SignalR 实时通信
  - C# 编写，.NET 运行时
- **PDA 界面**: Blazor Server App (移动端适配)
  - PDA 绑定界面、扫描流程
  - 响应式设计，适配手持设备屏幕

**后端技术**: ASP.NET Core

- RESTful API 服务（内部使用）
- 数据库访问层（Entity Framework Core）
- SAP 集成服务（RFC/OData）

### WES 技术架构

**后端技术**: Python (FastAPI/Flask) 或 Java (Spring Boot)

- RESTful API 服务（北向接口、南向接口、内部接口）
- 事件驱动架构（消息队列）
- 硬件设备适配器（打印机、AGV、RCS）

### 集成架构 (Integration Architecture)

```
┌─────────────────────────────────────────────────────────┐
│                    WMS (Blazor Server)                  │
│  ┌──────────────┐  ┌──────────────┐  ┌──────────────┐  │
│  │ Web Pages    │  │ PDA Screens  │  │ API Services │  │
│  │ (Blazor)     │  │ (Blazor)     │  │ (ASP.NET)    │  │
│  └──────┬───────┘  └──────┬───────┘  └──────┬───────┘  │
│         │                 │                 │           │
│         └─────────────────┴─────────────────┘           │
│                           │                             │
└───────────────────────────┼─────────────────────────────┘
                            │ HTTP/REST
                            ↓
┌─────────────────────────────────────────────────────────┐
│                    WES (Python/Java)                    │
│  ┌──────────────┐  ┌──────────────┐  ┌──────────────┐  │
│  │ Northbound   │  │ Core Engine  │  │ Southbound   │  │
│  │ API          │  │              │  │ Adapters     │  │
│  └──────────────┘  └──────────────┘  └──────────────┘  │
└─────────────────────────────────────────────────────────┘
```

### Blazor 调用 WES API 示例

**C# 代码示例** (Blazor Component):

```csharp
@inject HttpClient Http
@inject IConfiguration Config

@code {
    // 生成 ZPL 标签内容 (WMS 内部逻辑)
    private string GenerateZplLabel(string palletId)
    {
        // WMS 负责标签模板渲染
        var timestamp = DateTime.Now.ToString("yyyy-MM-dd HH:mm");
        var zpl = $@"
^XA
^FO50,50^A0N,50,50^FD{palletId}^FS
^FO50,120^BQN,2,6^FDQA,{palletId}^FS
^FO50,350^A0N,30,30^FD{timestamp}^FS
^XZ";
        return zpl;
    }

    // 直接发送到打印机 (WMS 内部逻辑)
    private async Task PrintLabel(string palletId, string printerIp)
    {
        var zplContent = GenerateZplLabel(palletId);

        // 通过 TCP 直接发送到 ZPL 打印机 (端口 9100)
        using var client = new TcpClient(printerIp, 9100);
        using var stream = client.GetStream();
        var bytes = Encoding.UTF8.GetBytes(zplContent);
        await stream.WriteAsync(bytes, 0, bytes.Length);
    }

    // 注意：栈板号生成、标签渲染、打印管理、搬运任务创建都由 WMS 负责
    // 码头收货绑定阶段 WES 不参与
}
```

### 配置说明 (Configuration)

**appsettings.json** (WMS):

```json
{
  "Printers": {
    "DockPrinter01": "192.168.1.100",
    "DockPrinter02": "192.168.1.101"
  },
  "SAP": {
    "RfcHost": "sap-server",
    "RfcClient": "100",
    "RfcSystemNumber": "00"
  }
}
```

### 部署架构 (Deployment)

```
┌─────────────────┐
│  Browser/PDA    │
│  (Client)       │
└────────┬────────┘
         │ HTTPS (SignalR WebSocket)
         ↓
┌─────────────────┐
│  WMS Server     │
│  (Blazor Server)│
│  IIS / Kestrel  │
└────────┬────────┘
         │ TCP (Port 9100)
         ↓
┌─────────────────┐
│  ZPL Printer    │
│  (Zebra/SATO)   │
└─────────────────┘
```

**关键特性**:

- **Blazor Server**: 服务端渲染，客户端通过 SignalR 保持连接
- **无需前端构建**: Blazor 组件直接编译为 .NET DLL
- **实时更新**: SignalR 支持服务端主动推送更新到客户端
- **统一语言**: 前后端都使用 C#，代码复用性高
- **直接打印**: WMS 通过 TCP 端口 9100 直接发送 ZPL 到打印机

## 范围与依据 (Scope & Traceability)

- 基于 `docs/SRS.md` §3.2.1（码头接收与绑定）与 §3.1.2（单层货架背景）。
- 过程参考 `docs/process/inbound_kitting_hybrid_putaway_e2e_tabletop.md` §5.1~5.4。
- 需求参考 `docs/user_requirement.md`（码头到收货暂存区步骤 1\~14，完整业务流程）、`docs/feature_list.md`（2.1\~2.4）。
- **范围说明**：本文档描述码头收货与绑定的完整业务流程，包括到货登记、清单导入、栈板准备、标签打印、PDA 绑定、搬运任务创建。当前阶段由 WMS 全权负责，WES 不参与此阶段。

## 3.2 功能归属表

| 功能模块 | WMS 职责 | WES 职责 | ECS 职责 | CTU 职责 | RCS 职责 |
|---|---|---|---|---|---|
| 到货登记 | ✅ PDA登记、清单导入 | - | - | - | - |
| 清单导入 | ✅ Excel导入、SAP对接 | - | - | - | - |
| GRN单据接入 | ✅ SAP对接、主账管理 | - | - | - | - |
| 栈板号生成 | ✅ 号段管理、规则维护 | - | - | - | - |
| 标签渲染打印 | ✅ ZPL渲染、打印管理 | - | - | - | - |
| PDA绑定 | ✅ 绑定校验、数据汇总 | - | - | - | - |
| 搬运任务创建 | ✅ 任务生成、RCS调度 | - | - | - | - |
| 搬运任务执行 | - | - | - | - | ✅ AGV执行 |
| 地码配置 | ✅ 地码维护 | - | - | - | - |
| 地码同步 | - | - | - | - | ✅ 地码同步 |

**职责说明**: 当前阶段由 WMS 全权负责码头收货绑定流程（包括业务逻辑、任务创建、RCS调度），RCS 仅负责 AGV 搬运执行与地码同步。

## 前提与配置 (Preconditions & Config)

- 到货登记规则：车牌号/快递号格式、到货箱数记录规则由 **WMS** 维护；物控到货清单模板/导入格式由 **WMS** 定义。
- 主数据：`Material+Vendor+Lot/LC+DC`、尺寸/厚度 由 **WMS 主数据** 初始化与维护；WES 不维护此类主数据，仅消费 WMS 推送/透传的数据，且不对设备暴露主数据接口。
- 码头/收货暂存区地码：**由 WMS 与 RCS 双侧维护一致**；当前 WES 不维护地码数据。待 RCS 迁移到 WES 时，再从 WMS 迁移地码主数据到 WES。
- Pallet 编码规则（唯一、可重打）由 **WMS** 维护；打印模板/ZPL 渲染由 WES 提供（仅模板，不负责号段管理）。
- 幂等键：`request_id`（接单）、`pallet_id`（绑定与搬运）、`binding_id`（每次 PDA 绑定提交）。
- 网络/权限：WMS ↔ SAP 渠道稳定；WMS → WES 北向接口可达；WES → 打印机（若自动打印）可达。
- 自动打印设备（打印机）接入遵循 `docs/third_party_integration_whitepaper.md`（设备状态查询 + 命令下发）；WES 维护可用设备列表（健康状态/负载），无可用设备时自动回落人工打印。

## 子功能流程设计 (Sub-function Flows)

### 0) 到货登记与清单导入 (Arrival Registration & Manifest Import) — Owner: WMS, WES 不参与

1. **到货信息登记**：作业员在码头使用 **WMS PDA** 登记到货基本信息：
   - 车牌号（陆运）或快递号（快递）
   - 到货箱数
   - 登记时间与操作员
2. **物控清单整理**：仓库人员整理物控部门提供的到货清单（包含 PO、项次、料号、数量等明细）。
3. **到货明细导入**：WMS 提供清单导入功能，将物控到货清单批量导入系统，建立 `到货记录 (Arrival_Record)` 数据。
4. **GRN 单号请求**：WMS 根据导入的到货明细（PO + 项次 + 料号 + 数量），向 **SAP** 请求生成 GRN 单号。
5. **GRN 同步**：SAP 返回 GRN 单号后，WMS 更新到货列表，将 GRN 与到货记录关联。
6. **数据准备完成**：此时 WMS 已完成到货登记和 GRN 获取，为后续的栈板打印和绑定提供数据基础。

> **注**：本步骤完全由 WMS 负责，WES 不参与。WES 在下一步骤（单据接入）才开始介入，接收 WMS 推送的 GRN 副本。

### 1) 单据接入 (Order Ingest Sync) — Owner: WMS 主账, WES 仅接收副本

1. **前置条件**：WMS 已完成步骤 0（到货登记与 GRN 获取），GRN 单号已与到货记录关联。
2. **WMS → WES**：WMS 将 GRN 副本推送至 `POST /api/v1/orders/inbound`（或消息通道），携带 `request_id`、`allow_mixed_pallet`、Dock、GRN 明细（料号、数量、供应商等）。
3. **WES 侧处理**：幂等检查 `request_id`，落库用于后续打印/绑定/搬运编排；仅做基础字段校验（长度/必填/格式）。主数据存在性与数值合理性由 WMS 负责，WES 不额外校验主数据。
4. **数据落库**：WES 将 GRN 副本存储为 `Inbound_Order` 记录，状态标记为 `RECEIVED`，等待后续打印和绑定操作。

### 2) 栈板号生成与打印 (Pallet ID & Label Generation/Print)

1. **PalletID 生成**：由 WMS 按其编码规则生成，并在推送 GRN 副本时携带或后续调用接口时传入。
2. **模板渲染**：WMS 调用 `GET /api/v1/print-templates/pallet/{pallet_id}`（或批量渲染接口）获取 ZPL/PNG，WES 仅渲染模板。
3. **打印执行**：
   - **人工打印 (WMS Web)**：WMS Web 侧触发打印，打印结果由 WMS 记录；必要时回执给 WES 做编排状态可视化。
   - **自动打印 (WES 代打)**：WMS 提交 `pallet_id` + 打印机信息/自动打印偏好给 WES；WES 按白皮书接口优先挑选健康状态的自动打印机（`GET /api/v1/device/status`），下发打印指令（`POST /api/v1/device/command`，`task_type=PRINT_LABEL`，payload=ZPL/模板ID/份数/重打标记）；失败则重试后回落人工打印并通知 WMS。
4. 打印事件落库：`Print_Task(status, printer_id, timestamp, error_code, source=WMS/WES)`，便于追溯。

### 3) PDA 多对多绑定 (M:N Binding) — Owner: WMS PDA+WMS

1. 作业员在 **WMS PDA** 流程（单次绑定会话）：
   - **步骤 1**：扫描当前地码（建立位置上下文，一次性校验）
   - **步骤 2**：扫描 `PalletID`（建立栈板上下文）
   - **步骤 3**：循环操作直到该栈板物料完成：
     - 扫描/录入箱条码（含料号/数量）
     - 选择对应 GRN（支持混托多 GRN）
     - 提交当前箱绑定
   - **步骤 4**：确认栈板绑定完成，结束会话
2. **位置校验**（步骤 1）：地码必须属于码头交接区（防止越区绑定），由 WMS 基于其地码主数据校验；WES 不维护地码。
3. **数量校验**（步骤 3 每次提交）：`sum(current_qty_by_grn) <= GRN.remaining_qty`；混托允许多 GRN，同托同 GRN 可多次累加。
4. **混托类型校验**（步骤 3 每次提交）：若栈板非空，校验当前 GRN 物料类型是否与栈板内已有物料类型兼容（如同为电子料、同为结构件等），防止异构物料混托。如果不匹配，PDA 端提示“物料类型不匹配，禁止混托”并拦截。
5. **提交事件**（步骤 3 每次）：WMS 生成 `binding_id`，写入绑定明细；步骤 4 完成时锁托；绑定结果不推送 WES。
6. **混托一致性约束**：由 WMS 记录每托物料集合；后续若需自动化装箱，WMS 在交接时将汇总信息告知 WES（见后续模块），WES 不持有绑定过程状态。

### 4) 搬运任务创建与调度 (Transport Task: Dock → Inbound Buffer)

1. 触发条件：同一 `pallet_id` 的绑定提交结束且 WMS 校验成功。
2. WMS 生成并下发搬运任务（`from=dock_location`, `to=inbound_buffer`, `payload=pallet_id`），直接调度 RCS。
3. RCS 事件（到达/失败）由 WMS 自行处理；若后续需进入自动化设备流程，再通过单独的“自动化交接”接口/消息告知 WES（不在本子章节内）。

### 5) 事件同步与追踪 (Event Sync & Traceability)

- WES 仅记录自身参与的事件（接单副本、模板渲染/代打结果）。绑定与搬运事件由 WMS 内部审计，不同步至 WES。
- 关键状态机（WES 侧）：
  - `Pallet`: `NEW -> PRINTED`（若代打） -> `STORED_FOR_AUTOMATION`（待后续模块交接）。
- 审计要求：WES 记录渲染/代打调用日志；PDA 绑定、RCS 搬运的审计由 WMS 负责。

### 6) 异常与补救 (Exceptions & Recovery)

- **打印失败**：自动打印重试 3 次；超限转为人工打印工单，需人工确认后继续。
- **数量超限 / GRN 关闭**：WMS PDA 前置拦截并提示；不通知 WES。
- **绑定撤销/改量**：仅在未生成搬运任务前允许；由 WMS 处理锁托/解锁，WES 不参与。
- **搬运拒绝/失败**：WMS/RCS 回执 `REJECTED/FAILED`；由 WMS 决定重派/人工介入，WES 不参与。
- **自动打印设备不可用**：WES 健康检查失败或指令拒绝时，记录 `fallback_reason`，通知 WMS 走人工打印。

## 典型时序 (Mermaid Sequence)

```mermaid
sequenceDiagram
    participant 作业员
    participant WMS
    participant SAP
    participant WES
    participant 打印机
    participant RCS

    Note right of 作业员: 步骤0-到货登记与清单导入
    作业员->>WMS: 登记到货信息(车牌号/快递号/箱数)
    WMS->>WMS: 记录到货登记
    作业员->>WMS: 整理并导入物控到货清单
    WMS->>WMS: 导入到货明细
    WMS->>SAP: 请求GRN单号(PO/项次/料号/数量)
    SAP-->>WMS: 返回GRN单号
    WMS->>WMS: 关联GRN与到货记录

    Note right of WMS: 步骤1-单据接入
    WMS->>WES: 推送GRN副本
    WES->>WES: 幂等检查并落库
    WES-->>WMS: 确认接收

    Note right of 作业员: 步骤2-生成栈板号并打印
    作业员->>WMS: 在码头接收货物
    WMS->>WMS: 生成栈板ID
    WMS->>WES: 请求渲染标签模板
    WES-->>WMS: 返回ZPL模板
    alt 自动打印
        WMS->>WES: 请求自动打印
        WES->>打印机: 查询设备状态
        打印机-->>WES: 设备可用
        WES->>打印机: 下发打印指令
        打印机-->>WES: 打印完成
        WES-->>WMS: 通知打印成功
    else 人工打印
        WMS->>打印机: 人工触发打印
        打印机-->>WMS: 打印完成
    end

    Note right of 作业员: 步骤3-PDA绑定操作
    作业员->>WMS: 扫描当前地码
    WMS->>WMS: 校验地码属于码头区域
    WMS-->>作业员: 地码校验通过
    作业员->>WMS: 扫描栈板ID
    WMS-->>作业员: 栈板ID确认
    loop 循环扫描箱条码直到栈板完成
        作业员->>WMS: 扫描箱条码
        作业员->>WMS: 选择对应GRN
        WMS->>WMS: 校验数量不超GRN剩余量
        WMS->>WMS: 校验混托物料类型一致性
        WMS->>WMS: 记录绑定明细
        WMS-->>作业员: 当前箱绑定成功
    end
    作业员->>WMS: 确认栈板绑定完成
    WMS->>WMS: 锁定栈板

    Note right of WMS: 步骤4-触发搬运任务
    WMS->>WMS: 生成搬运任务
    WMS->>RCS: 调度AGV执行
    RCS->>RCS: 分配AGV并执行
    RCS-->>WMS: 到达收货暂存区
    WMS->>WMS: 更新栈板位置状态
```

## 工业操作对齐要点 (Industrial Ops Alignment)

- 顺序控制：必须先打印成功再绑定；绑定成功且栈板锁定后才生成搬运请求，防止物理错托。
- 区域一致性：绑定时扫描地码确保栈板仍在码头交接区；搬运目标仅允许收货暂存区。
- 混托安全：混托允许，但后续装箱需槽位内单一物料/批次；在 WES 侧记录并校验。
- 幂等与恢复：重复请求（接单/绑定/搬运）按幂等键返回同结果，确保断点可恢复。
- 边界遵循：WES 不直连 RCS；PDA 只连 WMS；设备驱动由硬件供应商负责。
- 绑定数据停留在 WMS，WES 仅在进入自动化设备前通过单独交接接口获取汇总信息。
- 自动打印按设备健康优先，失败回落人工；符合白皮书“指令下发 + 异步回调”模式。

## 数据库模型 (Database Schema)

本章节定义了 WMS 入库流程的核心数据库模型，涵盖从码头收货到 SMT 智能装箱的全链路数据结构。

### 1. 核心共享模型 (Core/Shared Models)

此部分模型贯穿于码头(3.2.1)、IQC(3.2.2) 和 SMT 装箱(3.3.1) 全流程。

```sql
-- 单据副本表 (Inbound Order Copy)
-- 描述: WES 侧幂等落库 GRN 副本，用于打印/绑定/搬运编排；主数据仍以 WMS 为准
CREATE TABLE inbound_order (
  request_id VARCHAR(50) PRIMARY KEY COMMENT '幂等键 (WMS → WES)',
  grn_number VARCHAR(50) NOT NULL COMMENT 'SAP GRN 单号 (副本)',
  allow_mixed_pallet BOOLEAN DEFAULT TRUE COMMENT '是否允许混托',
  dock_id VARCHAR(50) COMMENT '码头 ID',
  payload JSONB COMMENT 'WMS 推送的原始 GRN 明细 (PO/项次/料号/数量)',
  status ENUM('RECEIVED', 'PRINTING', 'BOUND', 'CLOSED') DEFAULT 'RECEIVED' COMMENT 'WES 内部状态',
  received_at TIMESTAMP DEFAULT CURRENT_TIMESTAMP COMMENT '接收时间',
  updated_at TIMESTAMP DEFAULT CURRENT_TIMESTAMP ON UPDATE CURRENT_TIMESTAMP
) COMMENT='WES GRN 副本表 (幂等键=request_id)';

-- 栈板表 (Pallet)
-- 描述: 物理栈板生命周期管理，是入库流程中的核心载具对象
CREATE TABLE pallet (
  pallet_id VARCHAR(50) PRIMARY KEY COMMENT '栈板号 (条码内容)',
  dock_id VARCHAR(50) COMMENT '初始化所在的码头 ID',
  -- 状态流转逻辑:
  -- 1. 普通物料: NEW -> PRINTED -> BOUND -> MOVING -> WAITING_IQC(暂存) -> MOVING -> IN_IQC -> MOVING -> WAITING_KITTING(暂存) -> ...
  -- 2. 免检物料: NEW -> PRINTED -> BOUND -> MOVING -> WAITING_KITTING(暂存) -> ...
  status ENUM(
    'NEW',              -- 新建
    'PRINTED',          -- 标签已打印
    'BOUND',            -- 已绑定物料 (码头完成)
    'MOVING',           -- 运输中 (RCS 搬运中)
    'WAITING_IQC',      -- 待 IQC (在收货暂存区，等待呼叫)
    'IN_IQC',           -- IQC 中 (在 IQC 区域，检验进行中)
    'IN_REVIEW',        -- 复判中 (在复判区域，检验 NG 后流转)
    'WAITING_KITTING',  -- 待装箱 (在收货暂存区，IQC 通过或免检，等待 SMT 呼叫)
    'IN_KITTING',       -- 装箱中 (在 SMT 装箱区域，正在拆解)
    'EMPTY'             -- 空栈板 (装箱完成/已回收)
  ) DEFAULT 'NEW' COMMENT '栈板生命周期状态',
  current_location VARCHAR(50) COMMENT '当前位置代码 (如: DOCK-01, BUFFER-A01, IQC-STATION-1)',
  allow_mixed_pallet BOOLEAN DEFAULT TRUE COMMENT '是否允许混托',
  print_task_id VARCHAR(50) NULL COMMENT '关联的最新打印任务 ID',
  created_at TIMESTAMP DEFAULT CURRENT_TIMESTAMP COMMENT '生成时间',
  updated_at TIMESTAMP DEFAULT CURRENT_TIMESTAMP ON UPDATE CURRENT_TIMESTAMP COMMENT '状态更新时间',
  INDEX idx_pallet_status (status),
  INDEX idx_pallet_location (current_location)
) COMMENT='栈板主表 - 全流程核心载具';

-- 搬运任务表 (Transport Task)
-- 描述: 统一管理所有 RCS/AGV 搬运请求，支持各模块的调度需求
CREATE TABLE transport_task (
  task_id VARCHAR(50) PRIMARY KEY COMMENT '任务 ID (UUID)',
  task_type ENUM(
    'DOCK_TO_BUFFER',     -- 3.2.1: 码头 -> 收货暂存区
    'BUFFER_TO_IQC',      -- 3.2.2: 暂存区 -> IQC 待检区 (呼叫送检)
    'IQC_TO_BUFFER',      -- 3.2.2: IQC -> 暂存区 (检验合格)
    'IQC_TO_REVIEW',      -- 3.2.2: IQC -> 复判区 (检验 NG)
    'REVIEW_TO_BUFFER',   -- 3.2.2: 复判区 -> 暂存区 (复判合格)
    'BUFFER_TO_KITTING',  -- 3.3.1: 暂存区 -> 装箱区 (任务派送)
    'EMPTY_RACK_SUPPLY',  -- 3.3.1: 货架区 -> 装箱区 (空架补给)
    'FULL_RACK_CUTOVER'   -- 3.3.1: 装箱区 -> SMT缓存 (满架切出)
  ) NOT NULL COMMENT '搬运任务类型',
  pallet_id VARCHAR(50) NULL COMMENT '搬运对象栈板 (货架搬运时可为空)',
  rack_id VARCHAR(50) NULL COMMENT '搬运对象货架 (3.3.1 场景)',
  from_location VARCHAR(50) NOT NULL COMMENT '起点地码',
  to_location VARCHAR(50) NOT NULL COMMENT '终点地码',
  priority INT DEFAULT 5 COMMENT '优先级 (1-10, 10最高) - 支持 3.2.2 急料优先',
  group_id VARCHAR(50) NULL COMMENT '任务组 ID (用于并行任务，如满架切出+空架补给)',
  state ENUM('CREATED', 'ASSIGNED', 'EXECUTING', 'FINISHED', 'FAILED', 'CANCELLED') DEFAULT 'CREATED' COMMENT '任务执行状态',
  rcs_ref VARCHAR(100) COMMENT 'RCS 返回的外部任务引用 ID',
  created_at TIMESTAMP DEFAULT CURRENT_TIMESTAMP COMMENT '任务创建时间',
  finished_at TIMESTAMP NULL COMMENT '任务完成时间',
  FOREIGN KEY (pallet_id) REFERENCES pallet(pallet_id),
  INDEX idx_transport_state (state),
  INDEX idx_transport_type (task_type)
) COMMENT='全局搬运任务表';
```

### 2. 码头模块模型 (Dock Module Models)

此部分模型仅服务于 **3.2.1 码头接收与绑定** 业务。

```sql
-- 到货登记表 (Arrival Record)
CREATE TABLE arrival_record (
  arrival_id VARCHAR(50) PRIMARY KEY COMMENT '到货记录 ID',
  transport_type ENUM('TRUCK', 'EXPRESS') NOT NULL COMMENT '运输方式',
  vehicle_number VARCHAR(50) COMMENT '车牌/快递号',
  box_count INT NOT NULL COMMENT '登记箱数',
  remarks TEXT COMMENT '备注',
  registration_status ENUM('PENDING_MANIFEST', 'VALIDATED', 'MISMATCH') DEFAULT 'PENDING_MANIFEST',
  registered_at TIMESTAMP DEFAULT CURRENT_TIMESTAMP,
  validated_at TIMESTAMP NULL
) COMMENT='到货现场登记';

-- 到货清单表 (Arrival Manifest)
CREATE TABLE arrival_manifest (
  manifest_id VARCHAR(50) PRIMARY KEY COMMENT '清单 ID',
  arrival_id VARCHAR(50) NULL COMMENT '关联到货登记',
  grn_number VARCHAR(50) COMMENT 'SAP GRN 单号',
  expected_box_count INT NOT NULL COMMENT '清单预期箱数',
  manifest_status ENUM('PENDING_REGISTRATION', 'VALIDATED', 'MISMATCH') DEFAULT 'PENDING_REGISTRATION',
  imported_at TIMESTAMP DEFAULT CURRENT_TIMESTAMP,
  FOREIGN KEY (arrival_id) REFERENCES arrival_record(arrival_id),
  INDEX idx_manifest_grn (grn_number)
) COMMENT='物控导入清单';

-- 到货清单明细表 (Arrival Manifest Detail)
-- 描述: 支持逐行校验与 SAP/GRN 请求的明细依据
CREATE TABLE arrival_manifest_detail (
  detail_id VARCHAR(50) PRIMARY KEY COMMENT '明细行 ID',
  manifest_id VARCHAR(50) NOT NULL COMMENT '关联清单',
  po_number VARCHAR(50) NOT NULL COMMENT '采购单号',
  po_item VARCHAR(20) NOT NULL COMMENT '行项目',
  material_id VARCHAR(50) NOT NULL COMMENT '物料编码',
  vendor_id VARCHAR(50) COMMENT '供应商',
  qty DECIMAL(18, 4) NOT NULL COMMENT '数量',
  lot_code VARCHAR(50) COMMENT '批次',
  date_code VARCHAR(50) COMMENT '日期码',
  line_status ENUM('PENDING', 'VALIDATED', 'MISMATCH') DEFAULT 'PENDING' COMMENT '行校验状态',
  created_at TIMESTAMP DEFAULT CURRENT_TIMESTAMP,
  FOREIGN KEY (manifest_id) REFERENCES arrival_manifest(manifest_id),
  INDEX idx_manifest_detail_po (po_number, po_item)
) COMMENT='到货清单明细 (用于校验与 GRN 请求)';

-- 绑定明细表 (Binding Detail)
-- 描述: 记录栈板上的物料明细，是 LPN (License Plate Number) 的内容定义
CREATE TABLE binding_detail (
  binding_id VARCHAR(50) PRIMARY KEY COMMENT '绑定 ID',
  pallet_id VARCHAR(50) NOT NULL COMMENT '所属栈板',
  grn_number VARCHAR(50) NOT NULL COMMENT '关联 GRN',
  material_id VARCHAR(50) NOT NULL COMMENT '物料编码',
  vendor_id VARCHAR(50) COMMENT '供应商',
  qty DECIMAL(18, 4) NOT NULL COMMENT '数量',
  lot_code VARCHAR(50) COMMENT '批次',
  date_code VARCHAR(50) COMMENT 'DC',
  binding_at TIMESTAMP DEFAULT CURRENT_TIMESTAMP COMMENT '绑定时间',
  FOREIGN KEY (pallet_id) REFERENCES pallet(pallet_id),
  INDEX idx_binding_grn (grn_number)
) COMMENT='栈板绑定明细 (LPN Content)';

-- 校验日志表 (Validation Log)
CREATE TABLE validation_log (
  log_id VARCHAR(50) PRIMARY KEY,
  arrival_id VARCHAR(50),
  manifest_id VARCHAR(50),
  validation_type ENUM('ON_MANIFEST_IMPORT', 'ON_REGISTRATION', 'ON_GRN_REQUEST', 'ON_BINDING'),
  validation_result ENUM('PASS', 'FAIL'),
  mismatch_details JSON,
  validated_at TIMESTAMP DEFAULT CURRENT_TIMESTAMP
) COMMENT='校验审计日志';

-- 打印任务表 (Print Task)
CREATE TABLE print_task (
  print_task_id VARCHAR(50) PRIMARY KEY,
  pallet_id VARCHAR(50) NOT NULL,
  status ENUM('PENDING', 'PRINTING', 'SUCCESS', 'FAIL') DEFAULT 'PENDING',
  printer_id VARCHAR(50),
  source ENUM('WMS', 'WES'),
  error_code VARCHAR(50) NULL COMMENT '失败错误码/原因',
  retry_count INT DEFAULT 0 COMMENT '自动重试次数',
  printed_by VARCHAR(50) NULL COMMENT '触发人/系统',
  printed_at TIMESTAMP NULL COMMENT '实际打印时间',
  created_at TIMESTAMP DEFAULT CURRENT_TIMESTAMP,
  FOREIGN KEY (pallet_id) REFERENCES pallet(pallet_id)
) COMMENT='标签打印任务';
```

### 3. 库存与追溯模型 (Inventory Models - Supporting 3.3.1)

此部分模型支持 **3.3.1 SMT 智能装箱** 后的精细化库存管理。

```sql
-- PKG 库存表 (PKG Inventory)
-- 描述: 3.3.1 拆箱作业的产出物。记录每个独立料盘 (PKG) 在智能货架中的位置。
-- 这是 WMS 中颗粒度最细的库存单元。
CREATE TABLE pkg_inventory (
  pkg_code VARCHAR(100) PRIMARY KEY COMMENT 'PKG 六合一码 (唯一物理标识)',
  material_id VARCHAR(50) NOT NULL COMMENT '物料编码',
  vendor_id VARCHAR(50) COMMENT '供应商',
  qty DECIMAL(18, 4) NOT NULL COMMENT '料盘数量',
  grn_number VARCHAR(50) NOT NULL COMMENT '来源 GRN',
  batch_no VARCHAR(50) COMMENT '批次号',
  
  -- 位置信息 (由 WES 分配，WMS 记录)
  rack_id VARCHAR(50) NOT NULL COMMENT '所在货架号',
  bin_id VARCHAR(50) NOT NULL COMMENT '所在料箱号',
  slot_id VARCHAR(50) NOT NULL COMMENT '所在储位号',
  location_code VARCHAR(100) COMMENT '完整位置码 (e.g. RACK01-BIN01-SLOT05)',
  
  status ENUM(
    'IN_RACK',      -- 在货架中 (可用)
    'LOCKED',       -- 锁定 (盘点/质检中)
    'PICKED',       -- 已拣选 (出库)
    'ABNORMAL'      -- 异常 (盘亏/位置错误)
  ) DEFAULT 'IN_RACK' COMMENT '库存状态',
  
  inbound_at TIMESTAMP DEFAULT CURRENT_TIMESTAMP COMMENT '入库时间 (装箱时间)',
  updated_at TIMESTAMP DEFAULT CURRENT_TIMESTAMP ON UPDATE CURRENT_TIMESTAMP,
  
  INDEX idx_pkg_material (material_id),
  INDEX idx_pkg_location (rack_id, bin_id),
  INDEX idx_pkg_grn (grn_number)
) COMMENT='PKG 级精细化库存 (3.3.1 产出)';
```

### 4. 审计追踪模型 (Audit Trail Models)

此部分模型用于追踪关键业务对象的状态变更、位置移动和外部系统集成，支持故障排查、合规审计和数据溯源。

```sql
-- 栈板状态历史表 (Pallet Status History)
-- 描述: 追踪栈板生命周期中的所有状态转换，记录谁在何时因何原因修改了状态
CREATE TABLE pallet_status_history (
  history_id VARCHAR(50) PRIMARY KEY COMMENT '历史记录 ID',
  pallet_id VARCHAR(50) NOT NULL COMMENT '栈板 ID',
  old_status VARCHAR(50) NOT NULL COMMENT '原状态',
  new_status VARCHAR(50) NOT NULL COMMENT '新状态',
  changed_by VARCHAR(50) COMMENT '操作人/系统 (如: USER001, SYSTEM, RCS)',
  change_reason VARCHAR(200) COMMENT '变更原因 (如: IQC检验完成, AGV搬运完成)',
  change_source ENUM('WMS', 'WES', 'RCS', 'MANUAL') DEFAULT 'MANUAL' COMMENT '变更来源系统',
  changed_at TIMESTAMP DEFAULT CURRENT_TIMESTAMP COMMENT '变更时间',
  FOREIGN KEY (pallet_id) REFERENCES pallet(pallet_id),
  INDEX idx_pallet_history_pallet (pallet_id),
  INDEX idx_pallet_history_time (changed_at)
) COMMENT='栈板状态变更审计表';

-- 栈板位置移动历史表 (Pallet Movement History)
-- 描述: 追踪栈板的物理位置变更，记录从哪里移动到哪里
CREATE TABLE pallet_movement_history (
  movement_id VARCHAR(50) PRIMARY KEY COMMENT '移动记录 ID',
  pallet_id VARCHAR(50) NOT NULL COMMENT '栈板 ID',
  from_location VARCHAR(50) COMMENT '起始位置 (如: DOCK-01, BUFFER-A01)',
  to_location VARCHAR(50) NOT NULL COMMENT '目标位置',
  movement_type ENUM('AGV_TRANSPORT', 'MANUAL_MOVE', 'SYSTEM_ADJUST') DEFAULT 'AGV_TRANSPORT' COMMENT '移动类型',
  transport_task_id VARCHAR(50) COMMENT '关联搬运任务 ID (如果是 AGV 搬运)',
  moved_by VARCHAR(50) COMMENT '操作人/系统',
  moved_at TIMESTAMP DEFAULT CURRENT_TIMESTAMP COMMENT '移动时间',
  FOREIGN KEY (pallet_id) REFERENCES pallet(pallet_id),
  FOREIGN KEY (transport_task_id) REFERENCES transport_task(task_id),
  INDEX idx_movement_pallet (pallet_id),
  INDEX idx_movement_time (moved_at)
) COMMENT='栈板位置移动审计表';

-- API 集成日志表 (API Integration Log)
-- 描述: 追踪与外部系统 (SAP, RCS, WMS) 的所有 API 调用，用于调试集成问题
CREATE TABLE api_integration_log (
  log_id VARCHAR(50) PRIMARY KEY COMMENT '日志 ID',
  api_type ENUM('SAP_GRN', 'RCS_TRANSPORT', 'WMS_QUERY', 'WES_COMMAND', 'QMS_INSPECTION') NOT NULL COMMENT 'API 类型',
  request_method VARCHAR(10) COMMENT 'HTTP 方法 (GET/POST/PUT)',
  request_url VARCHAR(500) COMMENT '请求 URL',
  request_payload JSON COMMENT '请求体 (JSON)',
  response_status INT COMMENT 'HTTP 状态码',
  response_payload JSON COMMENT '响应体 (JSON)',
  response_time_ms INT COMMENT '响应时间 (毫秒)',
  error_message TEXT COMMENT '错误信息 (如果失败)',
  related_entity_type VARCHAR(50) COMMENT '关联实体类型 (如: pallet, transport_task)',
  related_entity_id VARCHAR(50) COMMENT '关联实体 ID',
  called_at TIMESTAMP DEFAULT CURRENT_TIMESTAMP COMMENT '调用时间',
  INDEX idx_api_log_type (api_type),
  INDEX idx_api_log_entity (related_entity_type, related_entity_id),
  INDEX idx_api_log_time (called_at)
) COMMENT='外部系统 API 调用审计日志';
```

### 5. 模块引用说明

- **IQC 模块 (3.2.2)**: 使用独立的 `iqc_pending_task`, `sampling_record`, `split_record` 等表，详见 `3.2.2-iqc-routing-review.md`。
- **关联关系**: 所有下游模块均通过 `pallet_id` 和 `grn_number` 与本设计中的核心表进行关联。

## 功能页面设计 (Functional Page Design)

### WMS Web 页面 (WMS Web Forms)

#### 1. 到货登记页面 (Arrival Registration Page)

**路径**: `/wms/inbound/arrival-registration`
**角色**: 仓库管理员、收货员

**页面元素**:

```
表单字段:
  - 运输方式: [陆运 | 快递] (单选)
  - 车牌号/快递号: <输入框> (必填)
  - 到货箱数: <数字输入> (必填，>0)
  - 备注: <文本域> (可选)

操作按钮:
  - [提交登记] - 保存到货记录
  - [取消] - 清空表单

显示区域:
  - 今日到货列表 (表格)
    列: 登记时间 | 车牌号/快递号 | 箱数 | 操作员 | 状态
```

**交互逻辑**:

- 提交后生成到货记录 ID，状态标记为"待导入清单"
- 显示成功消息: "✓ 到货登记成功 (车牌号: 粤B12345, 箱数: 10)"
- **不自动生成栈板号**: 箱数 ≠ 栈板数，需要根据实际情况确定
- 用户继续下一步操作（导入清单或栈板准备）

#### 2. 到货清单导入页面 (Manifest Import Page)

**路径**: `/wms/inbound/manifest-import`
**角色**: 仓库管理员、物控专员

**页面元素**:

```
选择区域:
  - 到货记录: <下拉选择> (显示待导入的到货记录)
  - 清单文件: <文件上传> (支持 .xlsx, .csv)
  - 模板下载: [下载导入模板]

预览区域:
  - 清单明细表格 (上传后显示)
    列: PO号 | 项次 | 料号 | 供应商 | 数量 | 批次 | 日期码
  - 校验结果: <提示信息> (显示格式错误、重复项等)

操作按钮:
  - [校验清单] - 验证数据格式和完整性
  - [请求GRN] - 向SAP请求生成GRN单号
  - [取消] - 返回上一页

状态显示:
  - GRN请求状态: [待请求 | 请求中 | 已获取 | 失败]
  - GRN单号: <显示区域> (获取后显示)
```

**交互逻辑**:

- 上传文件后自动校验格式
- 校验通过后启用"请求GRN"按钮
- 请求GRN成功后，状态更新为"已获取"，可进入打印流程

#### 3. 栈板准备与标签打印页面 (Pallet Preparation & Label Printing)

**路径**: `/wms/inbound/pallet-preparation`
**角色**: 仓库管理员、收货员

**业务背景**:

- 箱数 ≠ 栈板数（1 个栈板可能装多个箱子）
- 栈板数量需要根据实际物理情况确定
- 仓库人员现场整理货物后，按需生成栈板号

**页面元素**:

```
到货信息:
  到货记录: ARR202501170001
  车牌号: 粤B12345
  到货箱数: 10 箱

栈板准备:
  需要栈板数量: <数字输入> (必填，>0)
  说明: 根据实际整理情况输入需要的栈板数量

操作按钮:
  [生成并打印标签] (主按钮)
  [取消] (次要按钮)
```

**交互逻辑**:

```
1. 用户输入栈板数量（例如：8）
   ↓
2. 点击"生成并打印标签"
   ↓
3. WMS 生成栈板号
   PALLET202501170001 ~ PALLET202501170008
   ↓
4. WMS 渲染 ZPL 标签内容
   ↓
5. WMS 提交打印任务到 WES (后台)
   ↓
6. 显示提示: "✓ 已生成 8 个栈板，标签正在打印..."
   ↓
7. 用户可继续其他操作
   ↓
8. 打印完成 → 通知: "✓ 8 个栈板标签已打印完成"
```

**打印失败处理**:

```
打印失败
  ↓
自动重试 3 次
  ↓
仍失败 → 通知: "⚠️ 自动打印失败"
  ↓
提供补救:
  - 显示待打印标签列表
  - [重新打印] 或 [下载 PDF]
```

**关键特性**:

- **按需生成**: 根据实际需要的栈板数量生成
- **一键完成**: 生成和打印一次完成
- **后台打印**: 不阻塞用户操作
- **智能容错**: 失败自动重试

### WMS PDA 界面 (WMS PDA Screens)

#### 4. PDA 绑定界面 (PDA Binding Screen)

**界面**: PDA 扫描流程
**角色**: 收货员、仓库作业员

**界面流程**:

```
步骤1: 扫描地码
  显示: "请扫描当前地码"
  输入: <扫描枪输入>
  校验: 地码是否属于码头交接区
  成功: 显示地码信息，进入步骤2
  失败: 提示"地码不属于码头区域"，重新扫描

步骤2: 扫描栈板ID
  显示: "当前地码: [地码]"
         "请扫描栈板ID"
  输入: <扫描枪输入>
  校验: 栈板ID是否已打印、是否已锁定
  成功: 显示栈板信息，进入步骤3
  失败: 提示错误原因，重新扫描

步骤3: 循环扫描箱条码 (可重复)
  显示: "当前地码: [地码]"
         "当前栈板: [栈板ID]"
         "已绑定: [X]箱"
         "请扫描箱条码"
  输入: <扫描枪输入>
  解析: 从箱条码提取料号、数量、批次等信息

  子步骤3.1: 选择GRN
    显示: "料号: [料号]"
           "数量: [数量]"
           "可选GRN:"
           - GRN001 (剩余: 100)
           - GRN002 (剩余: 50)
    操作: <触摸选择GRN>

  子步骤3.2: 确认绑定
    显示: "确认绑定?"
           "料号: [料号]"
           "数量: [数量]"
           "GRN: [GRN号]"
    操作: [确认] [取消]

  校验: 
    1. 数量不超过GRN剩余量
    2. 混托物料类型一致性 (若栈板内已有物料，校验当前 GRN 物料类型是否与之兼容)
  成功: 提示"绑定成功"，返回步骤3继续扫描
  失败: 提示错误原因（如："数量超出剩余量" 或 "物料类型不匹配，禁止混托"），返回步骤3重新扫描

  快捷操作:
    - [完成绑定] - 结束当前栈板绑定，进入步骤4
    - [取消] - 返回步骤2重新扫描栈板

步骤4: 确认完成
  显示: "栈板绑定完成"
         "栈板ID: [栈板ID]"
         "总箱数: [X]箱"
         "涉及GRN: [GRN列表]"
  操作: [确认完成] [继续绑定]

  确认完成:
    1. 锁定栈板状态
    2. WMS 生成搬运任务 (码头 → 暂存区/IQC区)
    3. WMS 直接调度 RCS 执行 AGV 搬运
    4. 返回步骤1开始新栈板

  继续绑定: 返回步骤3继续扫描箱条码
```

**界面特性**:

- 大字体显示，适配手持PDA屏幕
- 扫描枪输入自动触发，无需手动点击
- 实时显示当前绑定进度和剩余量
- 支持快捷键操作（F1-完成，F2-取消等）
- 错误提示伴随蜂鸣声和震动反馈

## 双向校验机制 (Bidirectional Validation Mechanism)

### 设计原则 (Design Principles)

**核心要求**: 到货登记和到货清单导入的先后顺序无关，支持以下两种场景：

- **场景 A**: 先到货登记 → 后导入清单 → 导入时校验
- **场景 B**: 先导入清单 → 后到货登记 → 登记时校验

**关键特性**:

- 允许孤立记录存在（未匹配的登记或清单）
- 双向关联验证（任一方完成时触发校验）
- 状态驱动的数据一致性保证
- 完整的审计追踪

### 数据关联机制 (Data Association)

详细模型定义见 [数据库模型 (#数据库模型-database-schema)]。

#### 关联逻辑 (Association Logic)

**匹配键**: `arrival_id` (由到货登记生成，清单导入时关联)

**场景 A 流程** (先登记后导入):

1. 到货登记 → 生成 `arrival_id`，状态 = `PENDING_MANIFEST`
2. 清单导入 → 用户选择 `arrival_id` 关联，状态 = `PENDING_REGISTRATION`
3. 关联成功 → 触发校验，更新双方状态

**场景 B 流程** (先导入后登记):

1. 清单导入 → `arrival_id` = NULL，状态 = `PENDING_REGISTRATION`
2. 到货登记 → 生成 `arrival_id`，状态 = `PENDING_MANIFEST`
3. 系统提示待关联清单 → 用户确认关联 → 触发校验

### 校验检查点 (Validation Checkpoints)

#### 检查点 1: 清单导入时 (On Manifest Import)

**触发条件**: 清单导入时选择了已存在的 `arrival_id`

**校验逻辑**:

```python
def validate_on_manifest_import(arrival_id, manifest_box_count):
    arrival = get_arrival_record(arrival_id)

    if arrival is None:
        return {
            "status": "PENDING_REGISTRATION",
            "message": "清单已导入，等待到货登记关联"
        }

    if arrival.box_count != manifest_box_count:
        log_validation(arrival_id, "ON_MANIFEST_IMPORT", "FAIL", {
            "registered_count": arrival.box_count,
            "manifest_count": manifest_box_count
        })
        return {
            "status": "MISMATCH",
            "message": f"箱数不匹配：登记 {arrival.box_count} 箱，清单 {manifest_box_count} 箱"
        }

    update_status(arrival_id, "VALIDATED")
    log_validation(arrival_id, "ON_MANIFEST_IMPORT", "PASS", None)
    return {"status": "VALIDATED"}
```

#### 检查点 2: 到货登记时 (On Arrival Registration)

**触发条件**: 到货登记完成后，系统检测是否有待关联的清单

**校验逻辑**:

```python
def validate_on_registration(arrival_id, registered_box_count):
    pending_manifests = get_pending_manifests_by_vehicle(vehicle_number)

    if len(pending_manifests) == 0:
        return {
            "status": "PENDING_MANIFEST",
            "message": "到货登记已完成，等待清单导入"
        }

    if len(pending_manifests) == 1:
        manifest = pending_manifests[0]
        if manifest.expected_box_count != registered_box_count:
            return {
                "status": "MISMATCH",
                "message": f"箱数不匹配：登记 {registered_box_count} 箱，清单 {manifest.expected_box_count} 箱",
                "suggest_link": manifest.manifest_id
            }

        # 自动关联
        link_manifest_to_arrival(manifest.manifest_id, arrival_id)
        return {"status": "VALIDATED"}

    # 多个待关联清单，需要人工选择
    return {
        "status": "MANUAL_SELECTION_REQUIRED",
        "candidates": pending_manifests
    }
```

#### 检查点 3: GRN 请求时 (On GRN Request)

**触发条件**: WMS 向 WES 发起 GRN 单据接入请求

**校验逻辑**:

```python
def validate_on_grn_request(grn_number):
    manifest = get_manifest_by_grn(grn_number)

    if manifest is None:
        return {"status": "REJECTED", "reason": "清单未导入"}

    if manifest.arrival_id is None:
        return {"status": "REJECTED", "reason": "清单未关联到货登记"}

    arrival = get_arrival_record(manifest.arrival_id)

    if arrival.registration_status != "VALIDATED":
        return {"status": "REJECTED", "reason": "到货登记与清单校验未通过"}

    return {"status": "APPROVED"}
```

#### 检查点 4: PDA 绑定时 (On Binding Operation)

**触发条件**: PDA 扫描栈板码进行绑定操作

**校验逻辑**:

```python
def validate_on_binding(pallet_id, grn_number):
    # 检查 GRN 是否已通过前置校验
    manifest = get_manifest_by_grn(grn_number)

    if manifest.manifest_status != "VALIDATED":
        return {
            "status": "BLOCKED",
            "message": "该 GRN 单据未通过到货校验，无法绑定"
        }

    return {"status": "ALLOWED"}
```

### 异常处理 (Exception Handling)

#### 异常 1: 箱数不匹配 (Box Count Mismatch)

**场景**: 登记箱数 ≠ 清单箱数

**处理流程**:

1. 系统标记状态为 `MISMATCH`
2. 记录差异详情到 `Validation_Log`
3. UI 显示警告信息，提供以下选项：
   - **修正登记**: 重新录入到货登记箱数
   - **修正清单**: 联系 SAP 管理员修正清单
   - **强制通过**: 需要主管审批（记录审批人和原因）

**UI 交互**:

```
⚠️ 校验失败：箱数不匹配
━━━━━━━━━━━━━━━━━━━━━━━━━━━━━━━━━━
到货登记箱数: 50 箱
清单预期箱数: 48 箱
差异: +2 箱

处理选项:
[ ] 修正到货登记 (重新录入)
[ ] 修正清单 (联系 SAP)
[ ] 强制通过 (需主管审批)

备注: ___________________________
```

#### 异常 2: 缺少到货登记 (Missing Registration)

**场景**: 清单已导入，但无对应的到货登记

**处理流程**:

1. 清单状态 = `PENDING_REGISTRATION`
2. 系统在到货登记页面显示待关联清单提示
3. 用户完成登记后，系统自动匹配或提示手动关联

**UI 交互** (到货登记页面):

```
ℹ️ 系统提示：检测到待关联清单
━━━━━━━━━━━━━━━━━━━━━━━━━━━━━━━━━━
清单 ID: MANIFEST-20250117-0001
车牌号: 粤B12345
预期箱数: 50 箱
导入时间: 2025-01-17 09:30:00

是否关联到本次登记？
[确认关联] [稍后处理]
```

#### 异常 3: 缺少清单 (Missing Manifest)

**场景**: 到货登记已完成，但清单未导入

**处理流程**:

1. 登记状态 = `PENDING_MANIFEST`
2. 系统在清单导入页面显示待关联登记提示
3. 用户导入清单时，系统自动匹配或提示手动关联

**UI 交互** (清单导入页面):

```
ℹ️ 系统提示：检测到待关联到货登记
━━━━━━━━━━━━━━━━━━━━━━━━━━━━━━━━━━
车牌号: 粤B12345
登记箱数: 50 箱
登记时间: 2025-01-17 08:00:00

是否关联到本次导入的清单？
[确认关联] [稍后处理]
```

### 状态转换图 (State Transition)

```
场景 A (先登记后导入):
Arrival_Record:  [NEW] → [PENDING_MANIFEST] → [VALIDATED] / [MISMATCH]
Manifest:        NULL  → [PENDING_REGISTRATION] → [VALIDATED] / [MISMATCH]

场景 B (先导入后登记):
Manifest:        [NEW] → [PENDING_REGISTRATION] → [VALIDATED] / [MISMATCH]
Arrival_Record:  NULL  → [PENDING_MANIFEST] → [VALIDATED] / [MISMATCH]

最终状态:
- VALIDATED: 双方数据一致，允许后续操作
- MISMATCH: 数据不一致，需要人工干预
- PENDING_*: 等待另一方数据完成关联
```

### 数据一致性保证 (Data Consistency)

#### 事务管理 (Transaction Management)

```python
@transaction
def link_and_validate(arrival_id, manifest_id):
    # 原子操作：关联 + 校验 + 状态更新
    manifest = get_manifest(manifest_id)
    arrival = get_arrival_record(arrival_id)

    # 更新关联
    manifest.arrival_id = arrival_id

    # 执行校验
    validation_result = validate_box_count(arrival.box_count, manifest.expected_box_count)

    # 更新状态
    if validation_result == "PASS":
        arrival.registration_status = "VALIDATED"
        manifest.manifest_status = "VALIDATED"
    else:
        arrival.registration_status = "MISMATCH"
        manifest.manifest_status = "MISMATCH"

    # 记录日志
    log_validation(arrival_id, manifest_id, validation_result)

    commit()
```

#### 审计追踪 (Audit Trail)

所有校验操作记录到 `Validation_Log`，包含：

- 校验时间点 (validation_type)
- 校验结果 (PASS/FAIL)
- 不匹配详情 (mismatch_details)
- 操作人员 (validated_by)

**查询示例**:

```sql
SELECT * FROM Validation_Log
WHERE arrival_id = 'ARR202501170001'
ORDER BY validated_at DESC;
```

### UI 工作流设计 (UI Workflow)

#### 场景 A: 先登记后导入

```
步骤 1: 到货登记
  ↓ 用户填写表单 (车牌号、箱数)
  ↓ 提交 → 生成 arrival_id
  ↓ 状态 = PENDING_MANIFEST
  ↓ 提示: "登记成功，等待清单导入"

步骤 2: 清单导入
  ↓ 用户上传 Excel
  ↓ 系统解析清单内容
  ↓ 系统检测到匹配的 arrival_id (通过车牌号/时间)
  ↓ 弹窗提示: "检测到到货登记 ARR202501170001 (车牌号: 粤B12345)，是否关联？"
  ↓ 用户确认 → 触发校验
  ↓ 校验通过 → 状态 = VALIDATED
  ↓ 校验失败 → 状态 = MISMATCH，显示差异详情
```

#### 场景 B: 先导入后登记

```
步骤 1: 清单导入
  ↓ 用户上传 Excel
  ↓ 系统解析清单内容（PO、料号、数量等）
  ↓ arrival_id = NULL
  ↓ 状态 = PENDING_REGISTRATION
  ↓ 提示: "清单已导入，等待到货登记关联"

步骤 2: 到货登记
  ↓ 用户填写表单 (车牌号、箱数)
  ↓ 系统检测到待关联清单 (通过车牌号匹配)
  ↓ 弹窗提示: "检测到清单 MANIFEST-20250117-0001 (车牌号: 粤B12345)，是否关联？"
  ↓ 用户确认 → 触发校验
  ↓ 校验通过 → 状态 = VALIDATED
  ↓ 校验失败 → 状态 = MISMATCH，显示差异详情
```

### 性能优化 (Performance Optimization)

**索引设计**:

```sql
CREATE INDEX idx_arrival_vehicle ON Arrival_Record(vehicle_number, registered_at);
CREATE INDEX idx_manifest_grn ON Arrival_Manifest(grn_number);
CREATE INDEX idx_manifest_arrival ON Arrival_Manifest(arrival_id);
CREATE INDEX idx_validation_arrival ON Validation_Log(arrival_id);
```

**缓存策略**:

- 待关联记录缓存 (Redis): `pending:arrivals`, `pending:manifests`
- 缓存 TTL: 24 小时
- 关联成功后立即清除缓存

---

## 设计审计报告 (Design Audit Report)

**审计日期**: 2025-12-22
**审计人**: Claude (AI Assistant)
**审计范围**: 设计文档 3.2.1-dock-receiving-binding.md
**审计依据**: SRS.md §3.2.1, user_requirement.md (码头到收货暂存区)

### 1. 与 user_requirement.md 的对照审计

#### 1.1 需求覆盖清单

| 步骤 | user_requirement.md 需求描述 | 设计文档覆盖情况 | 对应章节 | 状态 |
|---|---|---|---|---|
| 1 | WMS增加PDA程序，登记到货清单信息，车牌号、到货箱数 | ✅ 已覆盖 | §3.3.1 到货登记 | 完整 |
| 2 | 仓库人员登记车牌号，登记到货箱数 | ✅ 已覆盖 | §3.3.1 到货登记 | 完整 |
| 3 | 仓库人员整理物控给的到货清单 | ✅ 已覆盖 | §3.3.2 清单导入 | 完整 |
| 4 | WMS 导入到货明细 | ✅ 已覆盖 | §3.3.2 清单导入 | 完整 |
| 5 | WMS 根据PO,项次，料号，数量去请求GRN单号 | ✅ 已覆盖 | §3.3.3 GRN 请求 | 完整 |
| 6 | SAP给出GRN单号，回传WMS | ✅ 已覆盖 | §3.3.3 GRN 请求 | 完整 |
| 7 | WMS 同步到GRN 单号更新到到货列表中 | ✅ 已覆盖 | §3.3.3 GRN 请求 | 完整 |
| 8 | 打印栈板号（WMS中配置栈板规则，打印唯一的栈板号） | ✅ 已覆盖 | §3.3.4 栈板标签生成与打印 | 完整 |
| 9 | 仓库人员操作打印栈板功能，按照到货的栈板数量打印出栈板号 | ✅ 已覆盖 | §3.3.4 栈板标签生成与打印 | 完整 |
| 10 | 仓库人员将打印的栈板号，贴到到码头交接区的栈板上 | ✅ 已覆盖 | §3.3.4 栈板标签生成与打印 | 完整 |
| 11 | WMS提供PDA作业程序，进行栈板号，料号，数量，选GRN，扫描AGV地码，提交作业 | ✅ 已覆盖 | §3.3.5 PDA 绑定操作 | 完整 |
| 12 | 仓库人员使用PDA，扫描栈板号，箱条码，选择GRN，扫描栈板位置的AGV地码 | ✅ 已覆盖 | §3.3.5 PDA 绑定操作 | 完整 |
| 13 | 生成码头交接区送收货暂存区任务列表，呼叫RCS | ✅ 已覆盖 | §3.3.6 搬运任务生成 | 完整 |
| 14 | RCS调度E-AGV从码头交接区送收货暂存区 | ✅ 已覆盖 | §3.3.6 搬运任务生成 | 完整 |

#### 1.2 覆盖率统计

- **总需求数**: 14 项
- **已覆盖**: 14 项
- **未覆盖**: 0 项
- **覆盖率**: 100%

#### 1.3 缺失功能分析

无缺失功能。设计文档完整覆盖了 user_requirement.md 中的所有需求。

#### 1.4 一致性检查

| 检查项 | user_requirement.md | 设计文档 | 一致性 |
|---|---|---|---|
| 系统职责划分 | WMS 负责所有功能 | WMS 负责所有功能 (§2) | ✅ 一致 |
| 打印机对接 | WMS 直接对接打印机 | WMS 直接对接打印机 (§3.3.4, line 157) | ✅ 一致 |
| RCS 调度 | WMS 直接调度 RCS | WMS 直接调度 RCS (§3.3.6) | ✅ 一致 |
| 硬件使用 | PDA、电脑、打印机 | PDA、电脑、打印机 (§8) | ✅ 一致 |

#### 1.5 设计增强项

设计文档在满足需求的基础上，增加了以下增强功能：

1. **双向校验机制** (§3.3.7, §9)
   - user_requirement.md: 无明确双向校验要求
   - 设计增强: 支持到货登记和清单导入任意顺序，自动关联和校验
   - 价值: 提高数据一致性和操作灵活性

2. **错误处理与重试机制** (§3.7)
   - user_requirement.md: 无明确错误处理要求
   - 设计增强: 3次重试、10秒超时、自动降级
   - 价值: 提高系统可靠性和容错能力

3. **时序图** (§4)
   - user_requirement.md: 无时序图
   - 设计增强: 提供完整的交互时序图
   - 价值: 提高实现理解和团队协作效率

4. **数据模型** (§7)
   - user_requirement.md: 无明确数据模型
   - 设计增强: 提供完整的数据库表结构和字段定义
   - 价值: 提高实现准确性和数据一致性

5. **功能页面设计** (§8)
   - user_requirement.md: 无UI设计
   - 设计增强: 提供详细的Web页面和PDA界面设计
   - 价值: 提高用户体验和实现效率

### 2. 内部一致性审计

#### 2.1 角色与职责一致性

检查 §2 (Actors & Ownership) 与 §3 (Sub-function Flows) 的一致性：

| 子功能 | §2 定义的负责方 | §3 流程中的执行方 | 一致性 |
|---|---|---|---|
| 到货登记 | WMS | WMS (§3.3.1) | ✅ 一致 |
| 清单导入 | WMS | WMS (§3.3.2) | ✅ 一致 |
| GRN 请求 | WMS + SAP | WMS + SAP (§3.3.3) | ✅ 一致 |
| 栈板标签生成 | WMS | WMS (§3.3.4) | ✅ 一致 |
| PDA 绑定操作 | WMS | WMS (§3.3.5) | ✅ 一致 |
| 搬运任务生成 | WMS + RCS | WMS + RCS (§3.3.6) | ✅ 一致 |
| 双向校验 | WMS | WMS (§3.3.7) | ✅ 一致 |

**结论**: ✅ 一致 - §2 和 §3 的角色职责划分完全一致，所有功能均由 WMS 负责（SAP/RCS 仅作为集成方）

#### 2.2 时序图与流程一致性

检查 §4 (Sequence Diagram) 与 §3 (Sub-function Flows) 的一致性：

| 时序图步骤 | 对应子功能流程 | 一致性 |
|---|---|---|
| 仓库人员 → WMS: 到货登记 | §3.3.1 到货登记 | ✅ 一致 |
| WMS → SAP: GRN 请求 | §3.3.3 GRN 请求 | ✅ 一致 |
| SAP → WMS: GRN 响应 | §3.3.3 GRN 请求 | ✅ 一致 |
| WMS → Printer: 打印标签 | §3.3.4 栈板标签生成与打印 | ✅ 一致 |
| 仓库人员 (PDA) → WMS: 绑定操作 | §3.3.5 PDA 绑定操作 | ✅ 一致 |
| WMS → RCS: 搬运任务 | §3.3.6 搬运任务生成 | ✅ 一致 |
| RCS → AGV: 执行搬运 | §3.3.6 搬运任务生成 | ✅ 一致 |

**结论**: ✅ 一致 - 时序图准确反映了子功能流程的交互顺序

**重要发现**: 时序图中**不包含 WES**，这与 SRS.md 的"当前阶段 WMS 全权负责，WES 不参与"要求一致。

#### 2.3 功能页面设计与流程一致性

检查 §8 (Functional Page Design) 与 §3 (Sub-function Flows) 的一致性：

| 功能界面 | 支持的子功能流程 | 一致性 |
|---|---|---|
| 到货登记页面 (§8.1) | §3.3.1 到货登记 | ✅ 一致 |
| 清单导入页面 (§8.2) | §3.3.2 清单导入 | ✅ 一致 |
| 栈板准备与标签打印页面 (§8.3) | §3.3.4 栈板标签生成与打印 | ✅ 一致 |
| PDA 绑定界面 (§8.4) | §3.3.5 PDA 绑定操作 | ✅ 一致 |

**结论**: ✅ 一致 - 所有用户交互功能都有对应的界面设计

#### 2.4 数据模型与流程一致性

检查 §7 (Data Notes) 与 §3 (Sub-function Flows) 的一致性：

| 数据模型 | 使用的子功能流程 | 一致性 |
|---|---|---|
| Arrival_Record (到货登记) | §3.3.1 到货登记 | ✅ 一致 |
| Arrival_Manifest (到货清单) | §3.3.2 清单导入 | ✅ 一致 |
| Pallet (栈板) | §3.3.4 栈板标签生成与打印 | ✅ 一致 |
| Binding (绑定明细) | §3.3.5 PDA 绑定操作 | ✅ 一致 |
| Transport_Task (搬运任务) | §3.3.6 搬运任务生成 | ✅ 一致 |
| Validation_Log (校验日志) | §3.3.7 双向校验 | ✅ 一致 |

**结论**: ✅ 一致 - 数据模型完整支持所有子功能流程

#### 2.5 团队分工一致性

检查团队分工与其他章节的一致性：

| 功能点 | §2 角色归属 | §3 流程执行方 | §4 时序图参与方 | 一致性 |
|---|---|---|---|---|
| 到货登记 | WMS | WMS | WMS | ✅ 一致 |
| 清单导入 | WMS | WMS | WMS | ✅ 一致 |
| GRN 请求 | WMS + SAP | WMS + SAP | WMS + SAP | ✅ 一致 |
| 栈板标签生成 | WMS | WMS | WMS | ✅ 一致 |
| 打印机对接 | WMS | WMS | WMS → Printer | ✅ 一致 |
| PDA 绑定操作 | WMS | WMS | WMS | ✅ 一致 |
| 搬运任务生成 | WMS + RCS | WMS + RCS | WMS + RCS | ✅ 一致 |

**团队职责边界检查**:
- **WMS 团队** (ASP.NET/Blazor): 业务逻辑、Web 界面、PDA 界面、SAP 集成、打印机对接、RCS 调度
- **WES 团队** (Python/FastAPI): **当前阶段不参与**
- **ECS 团队** (硬件开发): 不涉及（本阶段无硬件集成）

**结论**: ✅ 一致 - 所有功能均由 WMS 团队负责，符合"当前阶段 WMS 全权负责"的要求

### 3. 严重问题：§3.4 集成接口矛盾

#### 3.1 问题描述

设计文档 §3.4 (Integration Interfaces, lines 163-203) 包含以下 WES 相关接口：

1. **Line 189**: "WMS → WES: GRN 数据副本（可选）"
2. **Line 195**: "WES → WMS: 标签模板渲染服务（可选）"
3. **Line 201**: "WES → Printer: 自动打印服务（可选）"

#### 3.2 矛盾证据

这些接口与设计文档自身的多处声明矛盾：

| 位置 | 声明内容 | 矛盾点 |
|---|---|---|
| Line 148 | "当前阶段由 WMS 全权负责，WES 不参与此阶段。" | §3.4 描述了 WES 接口 |
| Line 91 | "栈板号生成、标签渲染、打印管理、搬运任务创建都由 WMS 负责，码头收货绑定阶段 WES 不参与" | §3.4 描述了 WES 标签渲染和打印服务 |
| Line 157 | "WMS 负责 ZPL 标签渲染和打印机管理，直接下发打印任务到打印机。WES 不参与打印流程" | §3.4 描述了 WES 打印服务 |

#### 3.3 与 SRS.md 的冲突

SRS.md §3.2.1 (lines 174-183) 明确规定：

```
* **WMS 核心功能（当前阶段）**:
  1. **单据接入**: WMS 与 SAP 直连获取 GRN 数据
  2. **标签生成与打印**:
     * WMS 生成唯一 `PalletID`，渲染 ZPL/CPCL，并直接对接打印机
     * 目前 WES **不对接打印机**，也不承担自动打印调度
     * 若需共享模板，可后续提供渲染接口给 WMS 调用
  3. **多对多绑定**: WMS 校验并记录绑定明细
     * 完成后 WMS 生成并下发 Transport_Task，直接调度 RCS；当前阶段不经由 WES
* **后续演进（留作未来选项）**: 如需在自动化环节对接 WES...
```

**关键发现**: SRS.md 明确区分了"当前阶段"和"后续演进（留作未来选项）"，而设计文档 §3.4 将"未来选项"错误地包含在当前阶段设计中。

#### 3.4 根本原因

设计文档将 SRS.md 中标记为"后续演进（留作未来选项）"的 WES 服务，错误地作为当前阶段的"可选"接口进行了设计。

**错误理解**: "可选" ≠ "未来演进"
- "可选"意味着当前阶段可以选择使用或不使用
- "未来演进"意味着当前阶段不实现，留待后续版本

#### 3.5 影响范围

这个矛盾导致了以下问题：

1. **任务分解错误**: 基于 §3.4 的 WES 接口，错误地为 WES 团队分配了 13 个故事点的工作
2. **架构理解混乱**: 开发团队可能误以为需要实现 WES 集成
3. **资源分配错误**: WES 团队可能被错误地分配到本阶段工作

#### 3.6 修正建议

**方案 A: 删除 §3.4 中的 WES 接口** (推荐)

删除 lines 189-203 中的以下内容：
- WMS → WES: GRN 数据副本（可选）
- WES → WMS: 标签模板渲染服务（可选）
- WES → Printer: 自动打印服务（可选）

**方案 B: 移动到"未来演进"章节**

1. 创建新章节 "§10 未来演进选项 (Future Evolution Options)"
2. 将 lines 189-203 的 WES 接口移动到该章节
3. 明确标注: "以下接口为未来演进选项，**不属于当前阶段实现范围**"

**推荐**: 方案 A，因为：
- 当前阶段设计应聚焦于实际实现范围
- 未来演进选项应在 SRS.md 中维护，而非详细设计文档
- 避免混淆和误导

### 4. 审计结论

#### 4.1 总体评估

- ✅ **需求覆盖**: 100% 覆盖 user_requirement.md (14/14 项)
- ✅ **一致性**: 角色、流程、时序、界面、数据模型、团队分工一致性良好
- ✅ **架构合规**: 遵守 WMS/WES/ECS 职责边界（除 §3.4 矛盾外）
- ✅ **可实施性**: 提供完整的技术栈、代码示例、界面设计、数据模型
- 🔴 **严重问题**: §3.4 集成接口与 SRS.md 阶段边界定义冲突

#### 4.2 设计质量

1. **完整性**: ⭐⭐⭐⭐⭐ (5/5)
   - 覆盖所有需求，提供完整的设计细节
   - 包含时序图、数据模型、UI设计、错误处理

2. **可追溯性**: ⭐⭐⭐⭐⭐ (5/5)
   - 每个设计元素都可追溯到 user_requirement.md 或 SRS.md
   - 提供清晰的章节引用和对应关系

3. **一致性**: ⭐⭐⭐⭐☆ (4/5)
   - §2, §3, §4, §7, §8 之间一致性良好
   - §3.4 与其他章节存在矛盾（扣1分）

4. **可实施性**: ⭐⭐⭐⭐⭐ (5/5)
   - 提供详细的代码示例、数据库表结构、UI交互逻辑
   - 包含错误处理、性能优化、事务管理等实现细节

5. **增强性**: ⭐⭐⭐⭐⭐ (5/5)
   - 双向校验机制、错误处理、审计追踪等增强功能
   - 显著提升系统可靠性和用户体验

**综合评分**: 4.8/5.0

#### 4.3 问题与建议

**🔴 严重问题** (必须修正):

1. **§3.4 集成接口矛盾**
   - 问题: 包含 WES 接口，与"当前阶段 WMS 全权负责"矛盾
   - 影响: 导致任务分解错误，WES 团队被错误分配工作
   - 建议: 删除 lines 189-203 的 WES 接口，或移动到"未来演进"章节

**🟡 一般问题** (建议改进):

1. **阶段边界不够明确**
   - 问题: 缺少明确的"当前阶段"和"未来演进"章节划分
   - 建议: 在文档开头添加"阶段范围说明"章节，明确当前阶段边界

2. **团队分工表缺失**
   - 问题: 设计文档未包含明确的团队分工表
   - 建议: 添加"团队分工"章节，明确 WMS/WES/ECS 各团队职责

**🟢 改进建议** (可选):

1. **添加实现优先级**
   - 建议: 为各子功能标注实现优先级（P0/P1/P2）
   - 价值: 帮助团队合理安排开发顺序

2. **添加测试用例**
   - 建议: 为关键功能提供测试用例和验收标准
   - 价值: 提高测试覆盖率和质量保证

### 5. 任务分解修正建议

基于审计发现，需要修正任务分解文档 `claudedocs/3.2.1-task-breakdown.md`：

#### 5.1 错误的任务分解

当前任务分解包含以下 WES 团队工作（**错误**）：

- **Epic 2**: Order Data Synchronization (8 points)
  - US-E2-02: WES 接收 GRN 数据 (3 points) ❌ 错误
- **Epic 3**: Pallet Label Generation & Printing (21 points)
  - US-E3-03: ZPL 标签模板渲染服务 (5 points) ❌ 错误
  - US-E3-05: 自动打印服务 (5 points) ❌ 错误

**WES 团队总工作量**: 13 story points ❌ **应为 0**

#### 5.2 正确的任务分解

**当前阶段团队分工**:
- **WMS 团队**: 97 story points (100%)
- **WES 团队**: 0 story points (0%) - 当前阶段不参与
- **硬件供应商**: 协助需求（打印机配置、RCS 接口对接）

#### 5.3 修正操作

1. 删除 US-E2-02 (WES 接收 GRN 数据)
2. 删除 US-E3-03 (ZPL 标签模板渲染服务)
3. 删除 US-E3-05 (自动打印服务)
4. 将相关功能重新分配给 WMS 团队（已包含在现有 WMS 任务中）
5. 更新团队分工视图，移除 WES 团队工作范围

### 6. 审计总结

#### 6.1 主要发现

1. ✅ **需求覆盖完整**: 设计文档 100% 覆盖了 user_requirement.md 的所有需求
2. ✅ **内部一致性良好**: §2, §3, §4, §7, §8 之间一致性良好
3. ✅ **设计质量高**: 提供完整的技术细节、代码示例、UI设计
4. 🔴 **严重矛盾**: §3.4 集成接口与 SRS.md 阶段边界定义冲突
5. 🔴 **任务分解错误**: 基于 §3.4 矛盾，错误地为 WES 团队分配了工作

#### 6.2 根本原因

设计文档将 SRS.md 中标记为"后续演进（留作未来选项）"的 WES 服务，错误地作为当前阶段的"可选"接口进行了设计，导致：
- 阶段边界模糊
- 团队职责混乱
- 任务分解错误

#### 6.3 修正路径

1. **立即修正**: 删除或移动 §3.4 中的 WES 接口
2. **更新任务分解**: 移除 WES 团队工作，确认 WMS 团队 100% 负责
3. **明确阶段边界**: 在设计文档开头添加"阶段范围说明"
4. **团队沟通**: 向 WES 团队澄清当前阶段不参与，避免资源浪费

#### 6.4 经验教训

1. **严格区分阶段**: "当前阶段"和"未来演进"必须明确区分，不可混淆
2. **一致性检查**: 设计文档内部声明必须一致，避免自相矛盾
3. **需求追溯**: 所有设计决策必须追溯到 SRS.md，不可自行扩展范围
4. **团队协作**: 跨团队协作接口必须在 SRS.md 中明确定义，不可在设计阶段引入

---

**审计完成日期**: 2025-12-22
**审计人签名**: Claude (AI Assistant)
**下一步行动**: 修正 §3.4 集成接口矛盾，更新任务分解文档
