kaizhoumasha/fxn_wms/user_stories.md

# 休斯顿 P9 WES - 敏捷需求梳理 (Agile Requirements Breakdown)

## 🎯 史诗概览 (Epics Overview)

本项目共划分为 7 个核心史诗（Epics），覆盖了从底层架构到顶层业务的全链路：

1.  **Epic 01: 系统基础架构与集成 (Infrastructure & Integration)**
2.  **Epic 02: 收货入库执行 (Inbound Execution)**
3.  **Epic 03: 智能装箱与内部物流 (Smart Kitting & Internal Logistics)**
4.  **Epic 04: 存储策略与调度优化 (Storage Strategy & Optimization)**
5.  **Epic 05: 生产发料协调 (Production Issue Coordination)**
6.  **Epic 06: 特殊物料全流程管控 (Special Material Handling)**
7.  **Epic 07: 生产退料闭环管理 (Production Return Loop)**

---

## 📝 史诗与用户故事详情 (Epics & User Stories)

### Epic 01: 系统基础架构与集成 (Infrastructure & Integration)
**描述**: 构建独立部署的控制中台底座，确保在断网情况下仍能维持核心作业，并实现与 SAP/WMS/硬件的标准化互联。

| ID | 用户故事 (User Story) | 验收标准 (Acceptance Criteria) |
| :--- | :--- | :--- |
| **US-1.1** | 作为**系统架构师**，我希望系统采用**轻量级代理架构 (Proxy Architecture)**，以便快速上线并降低与 WMS 的数据同步风险。 | 1. 与 SAP/WMS 断网时，立即暂停所有涉及库存变动的业务任务，允许纯物理搬运任务继续。<br>2. 网络恢复后，无需人工干预即可自动恢复作业。 |
| **US-1.2** | 作为**集成工程师**，我希望通过**标准 RESTful API** 接收上游单据，以便屏蔽 SAP 与 Legacy WMS 的接口差异。 | 1. 提供统一的 `/api/v1/orders/inbound` 接口。<br>2. 接口响应时间 < 500ms。 |
| **US-1.3** | 作为**开发人员**，我希望系统采用**按需动态查询 (On-Demand Query)** 模式获取库存，以避免维护复杂的本地库存镜像。 | 1. 关键决策点（如拣选）实时调用 WMS 接口查询库存。<br>2. 不维护本地库存数据库，确保 WES 与 WMS 数据始终一致。 |
| **US-1.4** | 作为**平台标准制定者**，我希望提供一套**标准化的硬件接入协议 (Hardware Interface Standard)**，以便第三方设备供应商能遵循 `@docs/hardware_interface_standard.md` 快速接入系统。 | 1. 发布包含 HTTP/TCP 协议规范的 SDK 或文档。<br>2. 供应商设备能通过标准协议成功回调 WES 接口。 |
| **US-1.5** | 作为**系统管理员**，我希望能够**配置设备注册表与逻辑拓扑**，以便定义每个 Device ID 的物理地址（IP/端口）及其所属的逻辑工位（Station）。 | 1. 支持设备的 CRUD 操作（ID, 类型, 厂商, 通信参数）。<br>2. 支持工位绑定（如：工位 A = 机械臂 01 + 相机 01）。<br>3. 配置变更后，适配器能实时或重启后生效。 |

### Epic 02: 收货入库执行 (Inbound Execution)
**描述**: 管理从码头卸货、标签打印、PDA 绑定到 IQC 检验路由的全过程。

| ID | 用户故事 (User Story) | 验收标准 (Acceptance Criteria) |
| :--- | :--- | :--- |
| **US-2.1** | 作为**码头收货员**，我希望通过 **PDA 扫描绑定**栈板与收货单 (GRN)，以便系统知道每个栈板上具体有哪些物料。 | 1. 支持多对多绑定（混托/分托）。<br>2. 绑定数量不能超过 GRN 剩余数量。 |
| **US-2.2** | 作为**收货主管**，我希望系统能**自动打印栈板条码**，以便快速标识到货的物理载具。 | 1. 系统根据到货箱数自动生成唯一 Pallet ID。<br>2. ZPL 指令直接驱动现场打印机。 |
| **US-2.3** | 作为**IQC 主管**，我希望系统根据 **QMS 策略自动计算抽检量**并生成路由任务，以便 AGV 自动将需检物料送往待检区，免检物料直接入库。 | 1. WES 调用 QMS 接口查询抽检策略。<br>2. 抽检量 > 0 时，自动生成送往 IQC 区的任务。 |
| **US-2.4** | 作为**IQC 检验员**，我希望在 PDA 上记录**取样与归还**操作，以便追溯样品去向并确保库存准确。 | 1. 扫描取样时，系统扣减栈板库存。<br>2. 归还时，必须扫描原栈板号进行校验。 |

### Epic 03: 智能装箱与内部物流 (Smart Kitting & Internal Logistics)
**描述**: 协调机械臂与 AGV，将暂存栈板上的物料自动拆解并装入标准料箱，实现“箱式管理”。

| ID | 用户故事 (User Story) | 验收标准 (Acceptance Criteria) |
| :--- | :--- | :--- |
| **US-3.1** | 作为**仓库调度员**，我希望系统自动监控装箱区的**空架数量**，不足时自动呼叫 RCS 补给，以保证装箱作业不中断。 | 1. 空架数量 < 阈值时，自动触发 RCS 搬运任务。 |
| **US-3.2** | 作为**WES 系统**，我希望接收 ECS 的**视觉识别数据**（尺寸/厚度/PKG），以便校验物料是否与当前任务匹配。 | 1. 校验 PKG 信息与 GRN 是否一致。<br>2. 尺寸偏差超过 5% 报错。 |
| **US-3.3** | 作为**WES 策略引擎**，我希望根据物料尺寸运行**智能分箱算法**，以便将物料分配到最合适的料箱储位（7寸/13寸/15寸）。 | 1. 优先将同类物料（同料号+供应商+DC）合并到同一储位。<br>2. 7寸盘优先分配 A 型箱，大盘分配 B 型箱。 |
| **US-3.4** | 作为**现场操作员**，我希望在机械臂**装入失败**（如满箱或变形）时系统能自动处理，以便作业流不被卡死。 | 1. 接收 ECS 异常反馈后，自动标记该 Slot 为不可用。<br>2. 重新计算并分配新的目标储位。 |

### Epic 04: 存储策略与调度优化 (Storage Strategy & Optimization)
**描述**: 管理 SMT 存储区的五层货架，通过冷热区与混合入库策略优化 CTU 机器人效率。

| ID | 用户故事 (User Story) | 验收标准 (Acceptance Criteria) |
| :--- | :--- | :--- |
| **US-4.1** | 作为**WES 系统**，我希望在入库时智能决策采用**满箱交换**还是**零散拣选**模式，以最大化 CTU 的搬运效率。 | 1. 料箱使用率 ≥ 80% 且有空箱时，生成整箱交换任务。<br>2. 50-80% 优先交换，无空箱则拣选。<br>3. < 50% 生成流水线抓取任务。 |
| **US-4.2** | 作为**库区管理员**，我希望系统依据物料动销率执行**冷热区管理**，将高频物料存放在靠近产线的 A 面。 | 1. 高频物料（热）优先分配至五层货架 A 面。<br>2. 每日闲时自动生成移库任务优化布局。 |
| **US-4.3** | 作为**RCS 调度系统**，我希望 WES 能**动态平衡 A/B 面负载**，避免五层货架单侧过载导致机器人拥堵。 | 1. 监控双侧负载率，差值 > 20% 时触发平衡策略。 |

### Epic 05: 生产发料协调 (Production Issue Coordination)
**描述**: 响应 SAP 工单，计算波次并调度设备将物料送达产线。

| ID | 用户故事 (User Story) | 验收标准 (Acceptance Criteria) |
| :--- | :--- | :--- |
| **US-5.1** | 作为**生产计划员**，我希望系统根据工单开线时间和 6 小时补料间隔自动计算**发料波次**，以便精准供料。 | 1. 自动解析 SAP 工单，生成分时段的任务波次。<br>2. 支持人工调整波次优先级。 |
| **US-5.2** | 作为**仓库主管**，我希望发料策略遵循 **FEFO**（先失效先出）和**退料优先**原则，以减少呆滞库存和碎片化。 | 1. 优先锁定最早 DC 的物料。<br>2. 优先锁定退货货架上的散料。 |
| **US-5.3** | 作为**发料员**，我希望系统能将任务自动拆解为**自动线任务**（电子料）和**人工任务**（异形件），并分别调度设备和 PDA 指令。 | 1. 电子料任务发送给 ECS/RCS。<br>2. 异形件/PCB 任务推送到手持 PDA。 |
| **US-5.4** | 作为**产线领料员**，我希望在系统缺料时能收到**预警**，并自动搜索替代库存，以避免停线。 | 1. ECS 反馈抓取失败后，WES 立即请求 WMS 冻结/扣减该异常库存，并重新查询可用库存进行分配。 |

### Epic 06: 特殊物料全流程管控 (Special Material Handling)
**描述**: 针对高价值、敏湿 (MSD)、PCB 及机构件的特殊管控流程。

| ID | 用户故事 (User Story) | 验收标准 (Acceptance Criteria) |
| :--- | :--- | :--- |
| **US-6.1** | 作为**安全管理员**，我希望**高值物料**通过专属路由直接送往高值区，并且必须扫描六合一码才能入库，以确保资产安全。 | 1. 识别 IsHighValue 属性，生成专属 AGV 路径。<br>2. PDA 强制校验 PKG 码，不可跳过。 |
| **US-6.2** | 作为**质量专员**，我希望系统自动监控 **MSD 物料**的暴露时间，并在超时前禁止发料。 | 1. 发料前实时从 WMS/MES 获取 MSD 开封时间及寿命状态。<br>2. 若状态为“超期”或计算剩余寿命 < 0，则禁止下发任务。 |
| **US-6.3** | 作为**机构件物流员**，我希望系统能协调**上盖/下盖栈板成对同步**到达拆包线，以避免产线等待配对。 | 1. 识别 AB 配对关系，生成同步调度指令。<br>2. 到达时间差控制在 5 分钟内。 |

### Epic 07: 生产退料闭环管理 (Production Return Loop)
**描述**: 处理产线退回的物料，经过分类、测试、点数、贴标后重新入库。

| ID | 用户故事 (User Story) | 验收标准 (Acceptance Criteria) |
| :--- | :--- | :--- |
| **US-7.1** | 作为**退料接收员**，我希望通过 PDA 对退料进行**分类登记**（电子料/垃圾/MSD），以便系统指导后续流程。 | 1. PDA 界面清晰指引分类操作。<br>2. 不同类别生成不同的 AGV 路由任务。 |
| **US-7.2** | 作为**WES 系统**，我希望根据规则引擎判断是否需要 **LCR 测试**和 **X-Ray 点数**，以节省设备资源。 | 1. 满盘未使用物料跳过测试和点数。<br>2. 散料自动路由至 X-Ray 设备。 |
| **US-7.3** | 作为**包装员**，我希望系统根据实测数量自动生成**新标签 (ZPL)**，并在贴标后由 ECS 进行校验。 | 1. 标签包含更新后的数量和日期。<br>2. 贴标机贴完后，视觉相机自动扫码校验。 |
| **US-7.4** | 作为**库管员**，我希望退料优先归还至**退货货架**的精确储位，并支持 A/B 面管理，以实现退料的精细化存储。 | 1. 记录料盘的精确位置（货架号+面+槽位）。<br>2. 发料时优先锁定该区域库存。 |

---

## 📅 下一步建议

1.  **产品待办列表 (Product Backlog) 初始化**: 将上述用户故事录入项目管理工具（如 Jira/PingCode）。
2.  **冲刺规划 (Sprint Planning)**: 建议优先启动 **Epic 01**（基础架构）和 **Epic 02**（入库），因为它们是数据流入的源头。
3.  **验收标准细化**: 在每个 Sprint 开始前，结合 `hardware_interface_standard.md` 进一步细化每个 Story 的技术验收指标。
