kaizhoumasha/fxn_wms/claudedocs/prompt.md

prompt

开始详细设计阶段，本阶段是基于 @docs/SRS.md 文档，以及其他参考文档 @docs/ , 按`具体需求`中的模块进行详细分析:
   - 首先要识别出子功能流程
   - 需要识别出子功能归属：WMS PDA/WMS WEB、WES 还是硬件供应商
   - 在操作逻辑上需要符合工业操作流程

先从 3.2.1 开始，试一下效果

export https_proxy= http_proxy= all_proxy=
export ANTHROPIC_AUTH_TOKEN='sk-5MOI0gGz4m1gheAAOTkUSx4X1jUtN9dCBRbG5RrC4WbU1kNv'
export ANTHROPIC_BASE_URL='https://anyrouter.top'
claude

还有一个 GRN 存在于多个不同的栈板上的情况呢？
当这个 GRN 需要被 IQC 检验，一般只会从`收货暂存区`移动一个栈板到 `IQC 待检区`，但当这个 GRN 被判需要复判时，不仅仅需要将该栈板从 `IQC 待检区` 移动到 `复检区`，还需要将 `收货暂存区`里涉及该 GRN 的所有栈板移动到 `复检区`

思考：装箱区空架是由 WMS、还是由 WES 来监控更合适？  

我们是 WES 软件集成商 （ 负责WES + WMS 系统开发，协调硬件供应商提供支持 ） ，为了清晰地理解`料盘装箱区`的真实工作场景， 基于 @docs/SRS.md 和 @docs/user_requirement.md 我们来进行一次模拟演练。
目前装箱区约定的条件如下：
0、前置约定：
 - 一个 GRN 号只对应一个 PO 的数据行，即相同的料号和供应商；
 - 一个栈板上可能涉及多个 GRN 号；用 `料号 + Vendor` 通过 WMS 需要能获取到该料号的尺寸信息（假设获取不到时，默认到 Line 2）；
1、有两种料箱：
  - A 型料箱：6 个7 寸料盘储位，只接受 7 寸料盘
  - B 型料箱：2 个7 寸料盘储位 + 1 个大尺寸料盘储位
2、有两条流水线：
  - Line 1: 只接受 7 寸料盘， 不接受 13 寸和 15 寸料盘，本线上的串杆物理只能放入 7 寸料盘，超规格料盘无法放入
  - Line 2: 优先接受 13 寸和 15 寸料盘，也可接受 7 寸料盘
3、每个单层货架上可放置 4 个料箱，每个货架、每个料箱应该都有各自的二维码可以追溯，数据初始化时需要配置好货架与料箱的对应关系，料箱与货架的对应关系会随着料箱的使用/处理而动态变化，A、B 型料箱可以混装在同一个单层货架中，没有约束条件
4、每条流水线有各自的入料位（栈板位）和出料位（单层货架位），流水线上有多个串杆，每个串杆上可放置多个料盘；每条流水线单独处理各自的任务；
5、每个料盘储位能存储多少个料盘需要根据料盘储位的深度和料盘的厚度动态计算
6、单层货架只做为分装货架，后续在 `SMT 作业区`会将单层货架上的料盘再次处理，装入多层货架中，再送入`料箱存储区`储存
7、来料的栈板上可以混装 7 寸和 13、15 寸料盘

Q1：B 型料箱的大尺寸料盘储位中可以放 7 寸的料盘吗？
 - B料箱大尺寸位不会放7寸料盘：
Q2：来料料盘是否正反两面都有 PKG 码？如果不是，那工人放反了，导致机械臂扫不到码怎么处理？
 - 单面有条码，放反了投放到设备NG口；
Q3：来料栈板上的来料尺寸通过什么信息能获取？这个时候只有来料盒子上的外包装信息
 - 通过栈板上的来料盒子上的 料号 + Vendor + DC/LC 等信息从 WMS 中获取来料料盘的尺寸信息
Q4：当机械臂抓到一个料盘后，通过扫码后计算发现当前的单层货架上无法放置该料盘，需要切换单层货架时，这个机械臂是HOLD状态吗？
 - 发现无储位可放时就发指令呼叫AGV来换单层货架；
Q5：每一个串杆被装满，按一次放行按钮？还是只是开始时按一次放行按钮？
 - 输送线上有8个串杆位置，放7个串杆，串杆会自循环。当一个串杆完了，逐个步进移动；如果7个料串都没有，设备会自动报警，提示作业人员进行作业；人工看到空串杆就可以放料，无需提示，也没有按钮；
Q6：当第一个串杆被装满，按下放行按钮，这个时候流水线是一次性走到机械臂工作位，还是只移动一个串杆位置？
 - 每次只有1个串杆在作业，设备会提升那个串杆上的料盘，逐盘作业，当前串杆作业完后，设备会自动化循环换下一个串杆；
Q7：是不是只要当前需要的那种储位（比如大盘位）没了，哪怕小盘位还是空的，也得切走换新货架？
 - 对的

你可以用第一性原理思考这个区域的日常工作流程，可以和我交互来厘清WES + WMS 的具体流程，并给出模拟步骤；只需要给出对 ECS + 硬件的要求；
你要用审视的目光，仔细看我的输入、我的潜在问题，如果需要补充信息，你要犀利地向我提出问题。
ultrathink & use serena
使用中文交互

串杆流水线是一个回转的装置对吗？一个流水线上有多个串杆，每个串杆上可以串多个料盘

不，再次回到我们的最初目的： 
基于 @docs/user_requirement.md 和 @docs/SRS.md  
我们来模拟一下`料盘装箱区`的真实工作场景，你可以用第一性原理思考这个区域的日常工作流程，可以和我交互来厘清原理； 
你要用审视的目光，仔细看我的输入、我的潜在问题，如果需要补充信息，你要犀利地向我提出问题。
ultrathink & use serena  

第一阶段：人机交接 (The Handshake)
* 场景：操作员小张用 PDA 扫了一个栈板，系统叫来了一台 AGV 把栈板运到了他面前。同时，另一台 AGV 运来了一个空的“一层货架”（上面有 4 个空料箱）。
更正：
1、小张在 WMS 的 WEB 端`待装箱列表`中，人工选择或自动呼叫`待装箱`的栈板；
2、系统叫来了一台 E-AGV 把栈板运到了他面前；
3、同时，系统监测空架位是否可用的一层货架，如果没有则呼叫一台 AGV 运来一个空的“一层货架”（上面有 4 个空料箱）。

@docs/SRS.md 根据与硬件供应商的沟通，明确了以下逻辑：
  1. `料盘装箱区` 有两条输送线：
    - Line 1: 只处理 7 寸料盘， 物理不接受 13 寸和 15 寸料盘
    - Line 2: 优先处理 13 寸和 15 寸料盘，也可处理 7 寸料盘
  每条输送线上有8个串杆位置，放7个串杆，串杆逐个步进移动，自动循环，每个串杆上可放置多个料盘；
  2. 有两种料箱：
    - A 型料箱：6 个7 寸料盘储位，只接受 7 寸料盘；每个料盘储位可以放置多个料盘，能存储多少个料盘需要根据料盘储位的深度和料盘的厚度动态计算
    - B 型料箱：2 个7 寸料盘储位 + 1 个大尺寸料盘储位，大尺寸料盘储位不可放入 7 寸料盘；
  每个料盘储位可以放置多个料盘，能存储多少个料盘需要根据料盘储位的深度和料盘的厚度动态计算
  3. 单层货架上可放置 4 个料箱, 具体关联的料箱类型在数据初始化时在 WMS 中配置；料箱与货架的对应关系会随着业务的推进而动态变化，A、B
  型料箱可以混装在同一个单层货架中，没有约束条件；
  4. 流水线与 WES 的交互顺序是：串杆逐个步进，硬件设备感应到机械臂工作位有料盘，则先进行视觉识别，与 WES 进行交互，获取到 PKG 与物理信息，WES
  通过运算返回该料盘应该放入当前单层货架上的料箱与储位，硬件调用机械臂将该料盘放入该储位；

串杆逐个步进，硬件设备感应机械臂工作位是否有料盘
  否：暂停 XX 秒后继续循环到下一个串杆
  是：进行视觉识别，视觉识别料盘的 PKG 和厚度，尺寸，与 WES 进行交互，获取到 PKG 与物理信息，发送给 WES 进行匹配通过运算返回该料盘应该放入当前单层货架上的料箱与储位，硬件调用机械臂将该料盘放入该储位；

采购订单：PO.0001，供应商代码：V0001
  L1: 电容#0001, 100000PCS，7 寸
  L2: 电容#0002,  50000PCS, 7 寸
采购订单：PO.0002，供应商代码：V0002
  L1: 电阻#0001, 200000PCS，7 寸
  L2: 电阻#0002, 100000PCS，7 寸
  L3: 芯片#0003,  50000PCS，13 寸

2025年12月20日，收到到货清单：车牌号：粵 B.88888, 箱数：100箱

2025年12月20日，导入到货清单：
供应商代码：V0001，PO.0001-L1，电容#0001，100000PCS
供应商代码：V0001，PO.0001-L2: 电容#0002， 50000PCS
供应商代码：V0002，PO.0002-L1: 电阻#0001，200000PCS
供应商代码：V0002，PO.0002-L2: 电阻#0002，100000PCS
供应商代码：V0002，PO.0002-L3: 芯片#0003， 50000PCS

SAP返回 GRN 数据：
1: 请求：`供应商代码：V0001，PO.0001-L1，电容#0001，100000PCS`
   返回：GRN.0001
2: 请求：`供应商代码：V0001，PO.0001: 电容#0002，50000PCS`
   返回：GRN.0002
3: 请求：`供应商代码：V0002，PO.0002-L1: 电阻#0001，200000PCS`
   返回：GRN.0003
4: 请求：`供应商代码：V0002，PO.0002-L2: 电阻#0002，100000PCS`
   返回：GRN.0004
5: 请求：`供应商代码：V0002，PO.0002-L3: 芯片#0003，50000PCS`
   返回：GRN.0005

码头工人从车上将盒装物料堆上栈板，同时绑定箱号和栈板号的关系：
1: 栈板：`PAL.0001`:
  - 箱01：电容#0001，50000PCS，选择 GRN：GRN.0001
  - 箱02：电容#0001，50000PCS，选择 GRN：GRN.0001
  - 箱03：电容#0002，25000PCS，选择 GRN：GRN.0002
  - 箱04：电容#0002，25000PCS，选择 GRN：GRN.0002
  - 箱11：芯片#0003，10000PCS，选择 GRN：GRN.0005
2: 栈板：`PAL.0002`:
  - 箱05：电阻#0001，50000PCS，选择 GRN：GRN.0003
  - 箱06：电阻#0001，50000PCS，选择 GRN：GRN.0003
3: 栈板：`PAL.0003`:
  - 箱07：电阻#0001，50000PCS，选择 GRN：GRN.0003
  - 箱08：电阻#0001，50000PCS，选择 GRN：GRN.0003
4：栈板：`PAL.0004`:
  - 箱09：电阻#0002，50000PCS，选择 GRN：GRN.0004
  - 箱10：电阻#0002，50000PCS，选择 GRN：GRN.0004
5：栈板：`PAL.0005`:
  - 箱12：芯片#0003，10000PCS，选择 GRN：GRN.0005
  - 箱13：芯片#0003，10000PCS，选择 GRN：GRN.0005
  - 箱14：芯片#0003，10000PCS，选择 GRN：GRN.0005
  - 箱15：芯片#0003，10000PCS，选择 GRN：GRN.0005

4. 物理布局

  问题 4.1: SMT 作业区的物理布局是什么？

- 流水线的布局如下：

  ┌────────────┐                     ┌──────────────┐
  │  货架 A 区 │        机械臂       │  货架 B 区   │
  └────────────┘                     └──────────────┘
   ├--->>---->>--->>---工作位--->>--->>---->>---->>---┤
   ^          流水线                                  │
   ├---<<---<<---<<---┤            ├--<<----<<----<<--┤
                 │ 上 │            │ 出 │
                 │ 料 │            │ 料 │
                 │ 口 │            │ 口 │
┌──────────────┐
│    五层货架   │
└──────────────┘

  问题 4.2: 自动线的工位配置？

- 见 4.1

  问题 4.3: 货架和料盒的规格？

- 参考 @docs/SRS.md 文档内相关说明

5. 硬件自主控制

  问题 5.1: ECS 有哪些自主控制循环？

- 视觉扫描: AGV通知货架到位 → 流水线自主控制送料 → 到达工作位，传感器触发 → 视觉系统自动扫描料盒 → 上报结果给 WES
- 机械臂拣料: WES 下发 Pick_Command → ECS 自主执行拣料动作 → 识别验证料盘信息 → 完成后上报结果
- 流水线传送: ECS 自主控制流水线速度和停止位置？

入库时，机械手将料盘从单层移动料架的周转箱摞里吸起，放置在料盘定位机构，经扫描判别后，再送到指定的区域，比如：1）用吸盘吸起，水平放到流水线工作位
上的周转箱指定摞格内；2）用夹爪夹起，竖直放到料架储位内；
出库时，机械手将料盘从输送线上的周转箱摞里吸起，放置在料盘定位机构，经扫描判别后，再送到指定的区域，比如：1）用吸盘吸起，水平放到单层料架上的周转
箱指定摞格内；2）用夹爪夹起，竖直放到料架储位内；

  问题 5.2: ECS 需要向 WES 上报哪些结果？

- 参考5.1 流程说明

  问题 5.3: WES 需要向 ECS 下发哪些指令？

- 参考5.1 流程说明

6. 硬件职责边界

  问题 6.1: ECS 自主控制的范围是什么？

- ECS 是否自主管理流水线的启停和速度？ 是
- ECS 是否自主管理机械臂的运动轨迹和抓取力度？ 是
- ECS 是否自主管理视觉系统的扫描参数和图像识别？ 是

  问题 6.2: WES 的控制范围是什么？

- WES 是否只下发高层指令（如：Pick from Rack1-Layer2-SlotA1 to TargetBox, Qty=10）？是
- WES 是否需要关心机械臂的具体运动轨迹？不需要
- WES 是否需要关心视觉系统的扫描参数？不需要 

  退料场景
   * 触发时机:
       * 工单结单 (WO Completion): 生产结束，剩余物料需退库。
       * 工单切换 (Changeover): 换线生产其他产品。
       * 工程变更 (ECO) 或 质量异常: 需冻结或退回特定物料。
   * 物理对象:
       * 料盘 (Reel): 已拆封或未拆封的电子元器件。
       * 退料标准胶框（Bin）：退料时，将料盘放入标准胶框。
       * 单层货架: 用于存放`退料标准胶框`, 并使用 AGV运送；
       * 退货货架 (Return Rack): 专用的 A/B 面货架，支持按料盘级精细化管理。
   * 工人操作:
       * 产线工人从飞达上拆除料盘，扫描料盘 PKG 码后放入退料标准胶框。（确认退料工单、是否不良品换料、是否满盘物料）
       * 注：MSD 物料需要将料盘装回原封装袋中；
       * 产线工人在产线退料完成后，将退料标准胶框放上`单层货架`, 人工呼叫 AGV 搬运往`仓库退料作业区`
       * `仓库退料作业区`工人在接收到产线上退回的`单层货架`, 从`退料标准胶框`中逐盘取出料盘，进行分类：
       * 分类策略:
           * 电子料 (Electronic): 进入自动化流水线（后续接 LCR/X-Ray）。
           * MSD / 非规则: 无法上自动线, 放入其他胶框, 走人工处理。
           * 高值物料 (High-Value): 标记专人点收，走高值区流程。
   * LCR 测试:
       * 自动化流水线前，工人扫描料盘 PKG 码，确认是否需要 LCR 测试料盘。
       * 决策逻辑:
           * 若物料为整盘则免测。
       * LCR 执行: 
           * Pass/免测: 放入自动化流水线。
           * Fail: 剔除至不良品框，WES 标记为 Defective，不入良品库。
   * X-Ray:
       * 流水线将料盘送入 X-Ray 设备， 设备读取料盘 PKG 码，确认是否需要 X-Ray 点数。
       * 决策逻辑:
           * 若物料为整盘则免点。
       * X-Ray 执行: 
           * 免点: 跳过 X-Ray 设备，进入后续步骤。
           * 点数: X-Ray 设备执行点数，结果返回给 WES（含 PKG 码，点数结果），WES 生成新的 PKG 码，回传给 X-Ray 设备, X-Ray 设备打印新的 PKG 标签并贴上，之后进入后续步骤；
       * 机械臂操作:
           * 扫描到达机械臂工作位的料盘 PKG 码，发送扫描结果给 WES。
           * 验证退料 PKG 码是否正确；
           * 决策逻辑:
               * 正确:  WES 返回退料货架上可存储 SLOT 码，机械臂夹手抓取料盘，并放入指定 SLOT。
               * 错误:  机械臂夹手抓取料盘，并放入 NG 框。

注：
  - 供应商不能提供 ASN (Advance Shipping Notice) 数据；
  - 码头端无法强制“单一 GRN/单一料号”组托
  - `供应商箱号`中无法保证解析出料盘 PKG（部分有、部分无）；
  - PCB、机构件是在 `栈板暂存区`内完成 PKG 绑定？（待定）
  - MSD、异形料是在 `收货验收区` 拆板后，手工指定 eAGV 搬运到 `SMT 手工作业区`完成绑定？（待定）
  - MSD 在入库阶段不拆除真空包装，不需要计算暴漏时间；
1. 物料到达码头区
   0. GRN 对应一个 PO 中的某个订单行；
   1. 录入物流信息
   2. 导入到货清单（请求 GRN，如无 GRN，则先生成临时号）
   3. 生成并打印栈板号（可提前打印）
   4. 扫描地码、栈板号
   5. 逐箱扫描箱号，识别物料、供应商、DC、数量（注意 DC 代码格式）
     * 决策逻辑: 贵重料、PCB、机构件与电子料（SMT、MSD、异形料）不可混托；
   6. 与 GRN 信息进行匹配关联（单 GRN 直接关联，多 GRN 需要让工人选择）
   7. 栈板工作完成后，调度 RCS；
     * 决策逻辑: 贵重料直接送入贵重仓（IQC 取样由工作人员在贵重仓内完成）；其他物料送入暂存区；
   8. 码头环节有可能漏扫箱号，需要提供栈板上箱号补录功能，在后续环节补充栈板与箱号的绑定关系（优先级 P2）

2. 拆板作业：
  **工作人员**可根据需要，对栈板上的料盒进行拆板：
  * **工作人员**扫描原栈板号，以及新栈板号，从原栈板上搬下需要拆板的料盒，并逐盒扫描箱码，将其从原栈板上解绑后绑定到新栈板上。如有需要，**工作人员**还需要将新栈板与地码进行绑定，以便后续 RCS 作业
  * 拆板作业可在 `栈板暂存区`, `IQC 复判区`, 以及后续的 `收货验收区`使用。

3. 暂存区与 IQC
   1. 栈板到达暂存区后，即显示到 IQC `待检列表`（PC WEB）中（按 GRN 进行显示，GRN 与栈板是多对多的关系，点击某 GRN 可展开该GRN 下的栈板信息）；
   2. 同时请求 QMS 获取抽检规则，获取抽检数量；
     * ~~QMS 是否支持`料号、供应商、数量`获取抽检数量？还是必须有 GRN 后才能从 QMS 获取抽检数量？**（待定）**~~；
     * 决策逻辑: 按 GRN 请求 QMS，若某 GRN 抽检数量为 0 时，直接标注该 GRN 为免检；
   3. `待检列表`中默认按栈板到达暂存区时间排序，IQC 主管/人员 可对`待检列表`中的 GRN 调整优先级，优先级高的居前显示；
   4. IQC 人员从`待检列表`调用 RCS 从暂存区呼叫栈板（自动、手动模式）；
     * 注：需要配置 IQC 待检区栈板容量，当下达的RCS 任务数量超过配置容量时，RCS 需要处理排队（还需要考虑到急料插队）；
     * 决策逻辑: 1 个栈板可对应多个 GRN，1 个 GRN 又可存放在多个栈板上；
     * 自动模式下，优先调用满足多个 GRN IQC 检测任务的栈板；
     * 手动模式下，当工作人员选择某 GRN 时，且该 GRN 有多个栈板时，显示该 GRN 所在的所有栈板信息，可手动选择调用的栈板（若某栈板已在 IQC 待检区，优先推荐）；
   5. IQC 取样：**IQC 人员**在 IQC 待检区，使用 PDA 先扫描栈板号，显示出该栈板上的 GRN 待检信息，~~再扫描要开箱的箱号(确认是否需要扫描箱号)~~，然后再**逐盘**扫描对应物料 PKG 码，直至达到 QMS 要求的抽检数量；
   6. IQC 检测完成（**轮询 QMS 获取检测结果**）：
     * 任务检查*: 系统优先判断该栈板上是否还有其他 GRN 待检。若有，提示继续取样；若无，执行以下判定：
     * 决策逻辑: 
       - ANY NG: 将 GRN 标记为 `需复判`，同时检查**当前栈板是否还有未完成的 IQC 任务**，如无：下发 RCS 任务将该栈板搬入复判区，**同时需要所有涉及该 GRN 的栈板（含暂存区的栈板）标注为 `需复判`**等待复判人员处理；
       - ALL OK: 将该栈板上已检测的 GRN 标记为 `通过`，同时检查**当前栈板是否还有未完成的 IQC 任务**，如无，下发 RCS 任务将栈板搬入暂存区；
   7. IQC 归还：**IQC 人员**在检测完成后，需要将取样的物料还回原栈板中，首先使用 PDA 先扫描栈板号，然后再**逐盘**扫描对应物料 PKG 码，直到所有物料都还回原栈板中；当所有物料归还栈板后，根据 2.5 的决策，调用 RCS 执行搬运任务；
   8. 复判作业：
   **IQC 人员**对复判区对物料进行复判,在 QMS 系统中录入复判结果:
     - **复判 OK**: 更新 QMS 判定结果为 OK，调用 RCS 将栈板移回 `栈板暂存区`
     - **复判 NG**: 更新 QMS 判定结果为 NG，系统自动搜索`栈板暂存区`、`IQC 待检区`内所有包含该 GRN
         的栈板，将其状态锁定（不可呼叫至收货区）。需要拆板作业，**拆板完成**后，**IQC 人员**手动调用 RCS 将栈板（验证栈板上的物料都是 OK 的）移回 `栈板暂存区`。同时，如果`栈板暂存区`内有相同 GRN 的 NG 物料，还需要指导 **IQC 人员**从 `栈板暂存区` 中拆除 `复判 NG` 物料（~~需要确定是在 `栈板暂存区`内作业还是由 RCS 将栈板叫出作业~~）。

4. `收货验收区`中增加 `电子料（SMT、MSD、异形料）待收列表` PC端页面，显示 IQC 已完成（含免检）的栈板；
   * `待收列表` PC端页面，按 `栈板到达时间` 排序，**工作人员** 可主动修改优先级；
   * **工作人员** 从`待收列表`调用 RCS 从 `栈板暂存区` 呼叫 RCS 运送`电子料（SMT、MSD、异形料）`栈板（自动、手动模式）；
      * 系统预判与拆板:
        * 栈板到位后，**工作人员** 扫描 `收货验收区` 到位的栈板号，PDA 自动提示该栈板是否包含 非标准盘（非7/13/15寸）、MSD 物料。
        * 若包含，要求工作人员执行 拆板作业。可将标准盘保留在原栈板，将非标物料移至新栈板；也可将非标物料保留在原栈板，将标准盘移至新栈板。
      * 分流处理:
        * 流向 A (标准盘): 使用地牛将只承载 7/13/15 寸物料的栈板送到 粗分机拆箱工作位（进入 Section 5）。 
        * 流向 B (MSD/异形料):
           * 工作人员通过 PDA 呼叫 RCS 将承载 MSD/异形料 物料的栈板送入 `SMT 手工注册/作业区`。
           * 在手工区，工作人员逐个开箱、逐个/盘扫描 PKG 码，完成系统入库绑定。

5. `粗分机拆箱工作位` 上， **工作人员** 通过 PDA 扫描 接收到的栈板，并执行 `SMT 拆箱作业`。
