kaizhoumasha/fxn_wms/docs/SRS.md

# 软件需求规格说明书 (Software Requirements Specification)

> **项目名称**: 休斯顿P9 智能仓储执行系统 (Houston P9 Intelligent Warehouse Execution System - WES)
> **系统定位**: 独立部署的集成化控制中台 (Independent Integration & Control Middleware)
> **文档版本**: 2.0 (Architecture Refactoring)
> **日期**: 2025-12-13

## 1. 引言 (Introduction)

### 1.1 目的 (Purpose)

本文档定义了 **休斯顿 P9 智能仓储执行系统 (WES)** 的架构与功能需求。

本项目不再定位为传统的 WMS，而是一个 **独立于现有企业级 WMS/SAP 的控制中台**。它旨在作为一个高可用、低延迟的智能化中间层，向上承接 ERP/WMS 的业务单据，向下协调各类异构自动化设备 (AGV, 机械臂, 流水线)，实现仓储物流的 "大脑" 职能。

系统具备 **独立部署 (Standalone Deployment)**、**API 驱动 (API-Driven)** 和 **业务逻辑可配置 (Configurable Logic)** 的特性，确保在外部网络或上层系统波动时，现场自动化作业仍能维持核心运行。

### 1.2 产品范围 (Scope)

本系统的核心职责是 **执行 (Execution)** 与 **协调 (Coordination)**：

* **业务解耦**: 将复杂的硬件交互逻辑从企业级 SAP/WMS 中剥离，由本中台统一管理。
* **多设备调度**: 统一调度 RCS (机器人)、WCS (输送线)、ECS (设备控制)，解决多设备协同作业难题。
* **标准化接口**: 提供标准 RESTful API 供上层系统调用，提供标准 Protocol Adapter 对接下层硬件。
* **核心域**:
  * **入库执行**: 码头收货、IQC 路由、上架策略执行。
  * **库存代理**: 采用 **按需动态查询 (On-Demand Query)** 模式，实时调用 WMS 接口获取库存数据，不维护本地库存副本。
  * **出库协同**: SMT 滚筒波次计算、自动线发料协调。

### 1.3 定义、首字母缩写和缩写 (Definitions)

| 缩写 | 全称 | 定义 |
| :--- | :--- | :--- |
| **WES** | Warehouse Execution System | **仓储执行系统**（本项目）。位于 WMS 与 WCS 之间的智能控制中台。  |
| **Upstream** | Upstream System | **上游系统**。指 SAP 或 企业级 Legacy WMS，负责主数据与财务账务。 |
| **Downstream** | Downstream System | **下游系统**。指 RCS, ECS, WCS 等硬件控制层。 |
| **Middleware** | - | **中台/中间件**。本系统的架构定位，强调连接与协调。 |
| **ECS** | Equipment Control System | 设备控制系统，负责具体硬件动作执行。 |

---

## 2. 总体描述 (Overall Description)

### 2.1 系统架构前景 (System Architecture Perspective)

本系统采用 **三层架构 (Three-Tier Architecture)**，作为独立节点运行：

* **L1 - 决策层 (External - SAP + Legacy WMS)**:
  * **SAP 职责**: 财务核算、采购计划、主数据管理 (Master Data)。
  * **Legacy WMS 职责**: 全公司库存账务、非 P9 区域的仓储管理。
  * **交互**: 仅通过标准 API 向本中台下发 "单据 (Orders)" (如: 收货通知单、工单)。
* **L2 - 控制中台 (This System - P9 WES)**:
  * **职责**:
    * **独立数据库 (Independent DB)**: 拥有私有的 PostgreSQL/Redis 实例，不依赖 L1 数据库。
    * **策略引擎 (Strategy Engine)**: 运行波次策略、路由算法、箱位分配算法。
    * **任务编排 (Orchestration)**: 将 L1 的 "单据" 拆解为 L3 的 "原子指令"。
    * **状态机 (State Machine)**: 跟踪每个料箱、每个任务的实时状态。
* **L3 - 执行层 (External - Hardware)**:
  * **职责**: 物理动作执行 (RCS, ECS)。

### 2.2 关键架构特性 (Key Architectural Characteristics)

为满足 "集成化控制中台" 的定位，系统必须具备以下特性：

1. **独立部署能力 (Independent Deployment)**:
   * 系统包含完整的前后端、数据库及中间件 (Dockerized)。
   * **网络依赖性**: 系统作业强依赖于上游 WMS 的在线状态。若与 SAP/Legacy WMS 断网，系统将执行以下策略:
     * **立即暂停**: 所有涉及库存变动的业务任务 (收货、发料、装箱等)
     * **允许继续**: 纯物理搬运任务 (AGV 回充电桩、空箱回流、设备空闲调度等)
     * **自动恢复**: 网络恢复后，自动继续执行被暂停的任务，无需人工干预
2. **API 驱动架构 (API-Driven)**:
   * **API First**: 所有功能（包括前端 UI）均通过 RESTful/gRPC API 访问。
   * **标准化数据接口**: 定义通用的 `Order_Ingest` (单据接入) 和 `Task_Dispatch` (任务下发) 接口，屏蔽不同 ERP 或不同硬件厂商的差异。
3. **可配置业务逻辑 (Configurable Business Logic)**:
   * 支持通过脚本 (Python/Lua) 或 规则引擎 (Rule Engine) 动态调整上架策略、抽检比例等，无需重新编译代码。
4. **独立的数据库实例 (Independent Database Instance)**:
   * 业务数据 (Business Data) 与 硬件日志 (IoT Logs) 分离存储。
   * 确保高并发下的读写性能。

### 2.3 运行环境 (Operating Environment)

* **部署方式**: 容器化部署 (Docker)，支持私有云或边缘服务器 (Edge Server)。
* **数据库**: PostgreSQL 17+ (业务数据) + TimescaleDB（时序插件）, Redis (缓存与队列).

---

# 3. 具体需求 (Specific Requirements)

本章节详细定义了 P9 WES 中台的核心业务流程、控制逻辑及与外围系统的交互规范。

> **本阶段集成边界 (Phase Boundary)**
>
> - **RCS 调度**: 仍由现有 WMS 统一调度。WES 生成搬运需求并提交给 WMS，由 WMS 调用 RCS 并将结果/事件回传 WES；WES 不直接调用 RCS。
> - **PDA 交互**: PDA 仅对接 WMS 应用；若 WES 需要感知 PDA 结果/事件，由 WMS 推送/同步给 WES。
> - **自动化设备**: 所有自动化设备（ECS/视觉/贴标/X-Ray/LCR/打印机等）只通过 WES 接入，WMS 不直连设备。
> - **标签打印**: WES 生成打印模板/ZPL。若为自动打印设备，则由 WES 下发；若为人工/非自动打印，则 WMS 获取模板后完成打印并回执结果。

### 3.1 硬件清单与基础配置 (Hardware & Configuration)

WES 中台负责协调以下核心硬件资源，并维护其基础数据配置：

| 区域 (Area) | 关键硬件 (Hardware) | WES 协调职责 (Coordination Role) |
| :--- | :--- | :--- |
| **码头区** | PDA, 打印机 | 提供收货单据同步，生成栈板条码 (ZPL)，处理绑定数据。 |
| **IQC 区** | PDA | 提供抽检策略路由，接收 QMS 检验结果。 |
| **装箱区** | 机械臂, 视觉相机, 输送线 | **关键**: 下发装箱策略 (Binning Strategy)，校验视觉识别数据 (PKG/Dims)。 |
| **SMT 区** | CTU (料箱机器人), 机械臂 | **关键**: 调度混合入库 (Exchange/Picking)，计算滚筒波次发料。 |
| **机构件区** | 自动拆包线, E-AGV | 协调 A/B 栈板同步进线，采集追溯数据。 |
| **退料区** | X-Ray, LCR, 贴标机 | **关键**: 执行清点/测试逻辑判定，生成新标签数据。 |

#### 3.1.1 数据初始化 (Data Initialization)

WES 需在上线前完成以下 "物理-数字" 映射的初始化：

* **容器绑定**: 建立物理箱号 (Bin ID) 与 货架 (Rack ID) 及 地码 (Location Code) 的关联。
* **基础策略**: 维护供应商物料的尺寸/厚度主数据 (Master Data)，作为装箱算法的计算基准。

#### 3.1.2 货架类型定义 (Rack Type Definitions)

P9 智能仓库使用三种货架类型，各有不同的物理结构和业务用途：

**1. 单层货架 (Single-Layer Rack)**

* **物理结构**：
  * 单层平面结构，可承载 **4 个料箱 (Bins)**。
  * 无 A/B 面区分，所有储位在同一平面。
* **业务用途**：
  * **中转缓存 (Transit Buffer)**: 用于收货装箱、发料准备等临时作业场景。
  * **快速流转**: 适合高频次的装卸操作，AGV 可快速搬运整架。
* **典型场景**：
  * 码头拆箱 -> 装箱作业 -> 单层货架 -> 运至五层货架存储区。
  * 五层货架 -> 单层货架 -> 流水线发料。

**2. 五层货架 (Five-Layer Rack)**

* **物理结构**：
  * 垂直五层结构，每层可承载 **4 个料箱 (Bins)**，总容量 **20 个料箱**。
  * 具有 **A 面 / B 面 (Side A / Side B)** 区分，CTU (Container Transfer Unit) 可从两侧操作。
* **业务用途**：
  * **高密度存储 (High-Density Storage)**: SMT 存储区的主要存储设备。
  * **满箱交换**: 支持 CTU 执行原子化的料箱交换操作 (Exchange)。
* **典型场景**：
  * 单层货架满箱 -> CTU 交换至五层货架空箱位。
  * 生产发料: CTU 从五层货架取料箱 -> 放至单层货架 -> AGV 运至产线。
* **调度策略**：
  * **冷热区管理**: 高频物料分配至 A 面靠近产线侧，低频物料分配至 B 面远端。
  * **A/B 面平衡**: WES 动态平衡两侧负载，避免单侧过载影响 CTU 效率。

**3. 生产货架 / 退货货架 (Production Rack / Return Rack)**

* **物理结构**：
  * **货架式结构 (Shelf Structure)**: 多个独立储位 (Slots)，每个储位可存放 **单个料盘 (Individual Tray)**。
  * 具有 **A 面 / B 面 (Side A / Side B)** 区分，人工可从两侧操作。
  * 储位数量根据货架高度和料盘尺寸动态计算 (例如: 7 寸料盘可堆叠更多层)。
* **业务用途**：
  * **生产货架**: 放置产线正在使用的料盘，供 SMT 机台直接上料。
  * **退货货架**: 放置产线下线的剩余料盘，等待拆飞达后退库。
* **典型场景**：
  * 生产发料: 料箱 -> 人工拆箱 -> 料盘放至生产货架 -> 产线上料。
  * 生产退料: 产线下料 -> 料盘放至退货货架 -> 拆飞达 -> 装入料箱 -> 退库。
* **管理特点**：
  * **料盘级追踪**: WES 追踪每个料盘的 PKG 码和储位位置 (Rack_ID + Side + Slot_ID)。
  * **A/B 面隔离**: 不同产线或不同工单的料盘可分配至不同面，避免混料。

---

### 3.2 收货入库执行 (Inbound Execution)

本模块处理从码头卸货到上架任务生成的全过程。当前阶段 **码头到暂存区由 WMS 完整主导**，WES 不参与打印与绑定环节；后续进入自动化交接/上架环节时再切入 WES 编排。

#### 3.2.1 码头接收与绑定 (Dock Receiving & Binding)

* **流程概述**: 接收 SAP 单据 -> 打印栈板码 -> PDA 物理绑定 -> 呼叫 RCS。
* **WMS 核心功能（当前阶段）**:
  1. **单据接入 (Order Ingest)**: WMS 与 SAP 直连获取 GRN 数据，必要时将副本透传给 WES 仅做记录（非必需）。
  2. **标签生成与打印 (Label Generation & Print)**:
     * WMS 生成唯一 `PalletID`，渲染 ZPL/CPCL，并直接对接打印机（TCP 9100 或供应商驱动）。
     * 目前 WES **不对接打印机**，也不承担自动打印调度；若需共享模板，可后续提供渲染接口给 WMS 调用。
  3. **多对多绑定 (M:N Binding)**:
     * **逻辑**: 支持 1 个栈板绑定多个 GRN (混托)，或 1 个 GRN 分托到多个栈板。
     * **校验**: PDA 提交绑定请求时，WMS 校验 `Sum(Current_Qty) <= GRN.Remaining_Qty`；WMS 自行记录绑定明细与锁托。
     * **完成**: 绑定完成后，WMS 生成并下发 `Transport_Task` (From Dock To Buffer)，直接调度 RCS；当前阶段不经由 WES。
* **后续演进（留作未来选项）**: 如需在自动化环节对接 WES，可在栈板进入自动化交接前，将汇总后的栈板物料概要和状态同步给 WES，用于后续编排。

#### 3.2.2 IQC 动态路由与复判 (IQC Routing & Review)

* **流程概述**: 暂存区 -> IQC 待检 -> 检验/复判 -> 路由分发。
* **设计理念**: 采用**拉动式 (Pull)** 而非推动式 (Push) 模式，由 IQC 人员根据工作负荷和优先级主动呼叫，避免 IQC 待检区拥堵。
* **WMS 核心功能**:
  1. **抽检策略 (Sampling Logic)**:
     * WMS 调用 QMS 接口查询抽检策略: `POST /api/qms/sampling/query`，传入 `(Material, Vendor, Qty)`。
     * QMS 返回抽检量；若 `SamplingQty > 0`，WMS 生成待送检任务列表 (不自动调度 RCS)。
  2. **人工呼叫送检 (Manual Call)**:
     * IQC 人员在 WMS Web 界面查看"IQC 待送检列表"。
     * IQC 人员根据工作负荷、优先级、IQC 待检区容量，主动选择栈板并点击"呼叫送检"。
     * WMS 生成运输任务，调度 RCS 搬运栈板到 IQC 待检区。
     * **提醒机制**: 高优先级提醒、长时间等待提醒、容量监控。
  3. **取样与归还 (Traceability)**:
     * 记录 IQC 取样动作: `WMS_Log(PalletID, PKG_Code, Sample_Action)`.
     * 记录归还动作: 确保样品回归原栈板。
  4. **检验完成确认 (Inspection Completion)**:
     * IQC 作业员归还所有样品后，在 WMS PDA 中点击"检验完成"按钮。
     * WMS 校验所有取样记录已归还，查询 QMS 获取检验结果。
     * WMS 根据检验结果生成路由任务，调度 RCS 执行搬运。
     * **兜底机制**: 定时轮询检查"已归还但未完成"的栈板，自动触发完成流程。
  5. **复判路由 (Review Routing)**:
     * **QMS 结果**: WMS 接收 `Inspection_Result(GRN, OK/NG)`.
     * **路由算法**:
       * **All OK**: 生成搬运需求至 Buffer (待入库)，调度 RCS。
       * **Any NG**: 生成搬运需求至 复判区，调度 RCS。
  6. **复判完成确认 (Review Completion)**:
     * IQC 作业员在 QMS 中录入复判结果后，在 WMS PDA 中点击"复判完成"按钮。
     * WMS 查询 QMS 获取复判结果，根据结果生成路由任务。
  7. **拆板分拣 (Sorting Support)**:
     * 在复判区，WMS 下发拆板指令，由 WMS PDA 展示并驱动 "拆板作业": 将 NG 物料移至新栈板 (New_PalletID)。
     * 更新库存: 原栈板扣减 NG 数量，新栈板承载 NG 数量 (流向不良品仓)。

---

### 3.3 内部物流与生产供料 (Internal Logistics)

本模块是 WES 最核心的 **智能调度 (Intelligent Scheduling)** 场景。

#### 3.3.0 WES 核心基础平台 (WES Core Foundation Platform)

为支撑后续章节中复杂的 SMT 智能装箱 (3.3.1)、混合入库 (3.3.2) 及 生产发料 (3.3.3) 业务，WES 必须首先构建一个 **标准化的核心能力平台 (Core Capability Platform)**。根据 *@[docs/third_party_integration_whitepaper.md]* 定义的接入标准，该平台需具备以下软件基础设施：

**1. 控制系统集成 (Control System Integration)**

*   **架构约束**: WES 不直接控制底层 PLC、传感器或电机。所有物理设备的控制由硬件供应商提供的控制系统 (如装箱流水线控制系统、机构件流水线控制系统) 负责封装。
*   **通信协议**: 采用 HTTP/HTTPS 接口进行消息交互 (详见白皮书 2.1 节)。
*   **逻辑位置映射**: WES 仅下发逻辑位置ID (如 `STATION_A`, `RACK_01`)，由控制系统负责解析为物理坐标，实现业务逻辑与物理参数的解耦。

**2. 异步消息交互 (Async Message Interaction)**

*   **交互模式**: 采用 **"下发(Command) -> 应答(Ack) -> 回调(Callback)"** 的三段式机制。
    *   **WES**: 发送指令 -> 收到 `200 OK` (代表已接收) -> 继续处理其他任务。
    *   **控制系统**: 执行动作 -> 调用 `Report_Result` 回调接口 -> WES 更新任务状态。
*   **标准指令**: 支持白皮书定义的标准动作类型：`PICK` (抓取), `PUT` (放置), `SCAN` (扫码识别), `PROCESS` (加工/贴标)。

**3. 标准接口定义 (Standard Interface Definition)**

*   **下行接口** (WES 调用控制系统):
    *   `Receive_Command` (接收任务)
    *   `Cancel_Command` (取消任务)
    *   `Health_Check` (状态查询)
*   **上行接口** (控制系统调用 WES):
    *   `Report_Result` (任务结果回传: OK/NG)
    *   `Event_Push` (设备事件上报: 急停/离线/到位)
*   **幂等性保障**: 所有指令携带全局唯一的 `command_id`，控制系统必须缓存已处理指令，防止重复执行物理动作。

**4. 重试与异常处理 (Retry & Exception Handling)**

*   **超时与重试**: 接口调用超时 (10s) 后，按指数退避策略 (`1s, 2s, 4s`) 自动重试，最多 3 次 (详见白皮书 4.2 节)。
*   **异常处理**: 超过重试次数后触发报警，需要人工介入处理。
*   **状态监控**: WES 定期轮询控制系统 `Health_Check` 接口，维护设备状态 (`IDLE` / `RUNNING` / `ERROR` / `OFFLINE`)。

**5. 设备层次结构与基础数据 (Device Hierarchy & Master Data)**

*   **设备组织层次 (Device Organization Hierarchy)**:
    *   建立 **区域 (Zone) → 作业线 (WorkLine) → 设备 (Device)** 的三级组织结构，用于任务路由和设备管理。
        *   **区域 (Zone)**: 物理区域划分 (如 `SMT作业区`, `机构件作业区`, `料盘装箱区`)。
        *   **作业线 (WorkLine)**: 区域内的生产线或工作站 (如 `SMT自动线1`, `SMT自动线2`, `SMT人工线`)。
        *   **设备 (Device)**: 作业线上的具体设备实例 (如 `工业电脑`, `PDA`, `机械臂`, `打印机`)。

*   **设备基础数据 (Device Master Data)**:
    *   WES 维护设备清单，记录每个设备的基础信息:
        *   **标识信息**: `device_id` (唯一标识), `device_name`, `type` (PDA/工业电脑/打印机/电脑/LCR测试仪)。
        *   **层次归属**: `zone_code`, `work_line_code` (设备所属的区域和作业线)。
        *   **用途说明**: 设备的功能描述 (如 "用来点货，绑定栈板发运送任务")。

**6. 任务管理 (Task Management)**

*   **任务队列 (Task Queue)**:
    *   支持基于优先级的任务队列 (白皮书定义 `priority`: 1-10, 10最高)。
    *   任务按优先级和提交时间排序，高优先级任务优先执行。
    *   支持任务排队、调度、执行的完整流程。

*   **任务状态 (Task State)**:
    *   定义任务状态机:
        *   `PENDING` (待执行): 任务已创建，等待调度。
        *   `RUNNING` (执行中): 任务已下发给控制系统，等待执行完成。
        *   `COMPLETED` (已完成): 控制系统回传 `result=SUCCESS`。
        *   `FAILED` (已失败): 控制系统回传 `result=FAILED` 或超过重试次数。
        *   `CANCELLED` (已取消): 通过 `Cancel_Command` 接口取消。
    *   支持任务状态查询和追踪，记录状态变更历史。

*   **超时监控 (Timeout Monitoring)**:
    *   基于白皮书定义的 `timeout` 参数监控任务执行时间。
    *   任务下发后启动计时器，超时后触发重试机制 (详见第4章)。
    *   超过重试次数后，任务状态变更为 `FAILED`，触发报警。

*   **并发控制 (Concurrency Control)**:
    *   限制单个设备的并发任务数，防止设备过载。
    *   设备状态为 `RUNNING` 且达到并发上限时，新任务自动进入队列等待。
    *   设备完成任务后，自动从队列中取出下一个任务执行。

#### 3.3.1 SMT 智能装箱协调 (Smart Kitting Coordination)

* **场景**: 从 码头栈板 (Pallet) -> 拆箱 -> 放入 **单层货架 (Single-Layer Rack)** (详见 3.1.2)。
* **货架规格**: 单层货架可承载 **4 个料箱**，用于中转缓存，适合高频装卸操作。
* **参与者**: WES (大脑), ECS (机械臂/视觉), RCS (AGV), 人工 (拆箱)。
* **WES 控制逻辑**:

  **Step 1: 空架补给 (Empty Rack Supply)**

  * **监控**: WES 监控装箱区是否有可用空单层货架 (4 个料箱位)。
  * **决策**: 若无，WES 生成搬运需求从 "单层货架存放区" 补给空架，提交给 WMS 调度 RCS。
  * **ECS 握手**:
    * ECS 机械臂扫描空架所有箱号。
    * `ECS -> WES: Verify_Empty(List<BinID>)`.
    * WES 确认无误后，允许作业启动。

  **Step 2: 视觉识别与分箱校验 (Vision & Binning Validation)**

  * **动作**: 料盘沿流水线输送 -> 到位触发视觉系统扫描。
  * **交互**:
    * `ECS -> WES: Material_Scanned(PKG_Code, Dims, Thickness)` (上报扫描结果)。
  * **WES 处理逻辑**:
    1. **校验**: 验证 PKG 是否属于当前 GRN，校验 `Dims/Thickness` 偏差。
    2. **分配 (Binning Algorithm)**:
       * **同类合并**: 优先放入已存有相同 `Material + Vendor + DC` 的储位。
       * **料箱选择**: 7 寸优先 A 型料箱，13/15 寸选择 B 型料箱。
       * **深度计算**: 实时计算储位剩余深度，确保容量充足。
  * **指令下发**: `WES -> ECS: Put_Instruction(BinID, SlotID, Expected_Stack_Height)`.
  * **执行**: ECS 接收指令后，驱动机械臂从流水线抓取料盘并执行放入动作。

**Step 3: 异常与满架 (Exception & Full)**

* **装不进**: 若 ECS 反馈 `Put_Fail` (物理无法放入)，WES 标记该 Slot 异常，重新分配。
* **满架切出**: WES 计算货架已满，生成 `Transport_Task` (To SMT_Buffer)，提交给 WMS 调度 RCS，并补新空架。

#### 3.3.2 混合入库策略 (Hybrid Inbound Strategy)

* **场景**: 单层货架 (装满料) -> SMT 存储区 (**五层货架 (Five-Layer Rack)**, 详见 3.1.2)。
* **货架规格**: 五层货架每层可承载 **4 个料箱**，总容量 **20 个料箱**，具有 **A/B 面** 区分，支持 CTU 双侧操作。
* **WES 决策逻辑**:

  1. **模式判断 (Mode Decision)**:

     * **满箱交换 (Full Exchange)**: 若料箱 `Usage >= 80%` 且 存储区有空箱资源 -> WES 生成 **交换任务**。
     * **优先交换 (Priority Exchange)**: 若 `50% <= Usage < 80%` 且 存储区有空箱资源 -> 优先尝试交换，若无空箱则执行拣选。
     * **零散入库 (Pipeline Picking)**: 若料箱 `Usage < 50%` 或 无空箱资源 -> WES 生成 **拣选任务**。
     * **混合模式**: 先交换，后拣选。
  2. **满箱交换执行 (Full Exchange Execution)**:

     * WES 锁定五层货架上的 `Empty_Bin` (指定层号和 A/B 面)。
     * WES 生成交换任务 `Exchange(Source_Single_Layer_Rack, Target_5_Layer_Rack, Layer, Side)` 并提交给 WMS 调度 RCS/CTU 执行原子动作。
     * **数据更新**: 交换完成后，WES 交换两个容器的库存属性。
  3. **流水线零散入库 (Pipeline Picking Execution)**:

     * **调度**: WES 生成 Target Bin (从五层货架) 到流水线的搬运需求，提交 WMS 调度 RCS。
     * **拣选指令**:
       * ECS 扫描流水线上的 Target Bin。
       * `WES -> ECS: Pick_List(From_Rack, To_Bin, Qty)`.
     * **执行**: ECS 机械臂执行抓取放入。

#### 3.3.3 SMT 生产发料协调 (SMT Production Issue)

* **场景**: SAP 工单 -> 自动/人工线发料。
* **WES 核心算法 (Rolling Wave)**:

  1. **任务接入**: 接收 SAP 工单，根据 "开线时间 + 6小时补料间隔" 生成波次。
  2. **任务拆解**:
     * **电子料 (Auto)**: 生成 `Auto_Pick_Task`.
     * **特殊料 (Manual)**: 生成 `Rack_Move_Task` (MSD/PCB/异形)。
  3. **自动线执行 (Auto Line)**:
     * **预缓存**: WES 提前调度下一波次的货架到 Buffer 区。
     * **指令下发**: `WES -> ECS: Pick_Command(Source, Target)`.
     * **异常处理**: 若 ECS 反馈 `Pick_Fail`，WES 自动扣减库存并标记 `Shortage`，尝试从备选库存补发。

---

### 3.4 执行协同与调度策略 (Execution Coordination & Scheduling Strategy)

本模块是 WES 中台的 **核心协调引擎 (Core Coordination Engine)**，负责与现有 WMS 协同，追踪执行状态，支撑所有调度决策。

#### 3.4.1 执行状态追踪与库存协同 (Execution State Tracking & Inventory Coordination)

* **架构定位**: WES 采用 **纯代理模式 (Pure Proxy Mode)**。WES **不维护库存主数据**，所有涉及库存的查询、预留、扣减操作均 **实时透传 (Passthrough)** 给现有 WMS。为优化性能，WES 允许对查询结果进行 **短时缓存 (TTL ≤ 30秒)**，但缓存失效后必须重新查询 WMS。
* **职责划分 (Responsibility Division)**:

  * **现有 WMS (Existing WMS)**:
    * **库存主数据 (Inventory Master)**: 唯一的库存真实源。
    * **决策中心**: 负责库存可用性判断、分配逻辑和账务更新。
  * **P9 WES (This System)**:
    * **执行管道 (Execution Pipeline)**: 专注于任务的物理执行（搬运、抓取）。
    * **状态中继**: 将设备的物理状态实时反馈给 WMS，由 WMS 决定下一步逻辑。
    * **异常熔断**: 一旦 WMS 接口超时或报错，WES 立即暂停相关作业。
* **执行状态数据结构 (Execution State Schema)**:

  ```
  Execution_State {
    TaskID: String,
    MaterialID: String,
    PKG_Code: String (六合一码),
    Qty: Integer,
    Current_Location: String (物理位置: AGV/流水线/货架),
    Status: Enum (InTransit, Processing, Completed),
    Source_Location: String (起点),
    Target_Location: String (终点),
    Start_Time: Timestamp,
    Expected_Completion: Timestamp
  }
  ```

  * **关键特征**: 这是 **瞬态数据 (Transient Data)**，任务完成后即清除，不长期保存。
* **与现有 WMS 的协同机制 (Coordination with Existing WMS)**:

  **1. 库存查询 (Inventory Query)**

  * **场景**: WES 需要决策时 (如: 分配发料任务)，查询现有 WMS 的库存。
  * **接口**: `GET /api/wms/inventory?material=R001&location=SMT-A-01`
  * **缓存策略**: WES 可对查询结果进行短时缓存 (TTL ≤ 30秒)，减少 API 调用频率，但不改变"WMS 为库存主数据源"的架构定位。

  **2. 库存预留 (Inventory Reservation)**

  * **场景**: WES 生成发料任务前，向现有 WMS 申请预留库存。
  * **接口**: `POST /api/wms/inventory/reserve`
  * **请求**:
    ```json
    {
      "material_id": "R001",
      "qty": 100,
      "work_order": "WO-12345",
      "reserved_by": "P9_WES",
      "expire_time": "2025-12-13T12:00:00Z"
    }
    ```
  * **响应**: 现有 WMS 返回 `ReservationID`，并锁定库存。
  * **释放机制**:
    * **主动释放**: 任务完成或取消时，WES 调用 `DELETE /api/wms/inventory/reserve/{ReservationID}` 释放预留。
    * **自动过期**: WMS 在 `expire_time` 后自动释放预留，无需 WES 干预。
    * **异常恢复**: WES 重启后，查询所有预留记录，释放已过期或已完成的预留。

  **3. 库存确认 (Inventory Confirmation)**

  * **场景**: 物理动作完成后 (如: 装箱完成、发料完成)，WES 通知现有 WMS 更新库存。
  * **入库确认**: `POST /api/wms/inventory/putaway`
    ```json
    {
      "grn": "GRN-001",
      "material_id": "R001",
      "qty": 100,
      "location": "SMT-A-01-03",
      "pkg_code": "PKG-12345",
      "timestamp": "2025-12-13T10:30:00Z"
    }
    ```
  * **出库确认**: `POST /api/wms/inventory/issue`
    ```json
    {
      "reservation_id": "RSV-001",
      "material_id": "R001",
      "qty": 100,
      "work_order": "WO-12345",
      "timestamp": "2025-12-13T10:35:00Z"
    }
    ```
  * **幂等性保障**: 所有确认接口支持重复调用 (基于 `TaskID` 去重)。

  **4. 异常处理 (Exception Handling)**

  * **场景**: 物理动作失败 (如: AGV 故障、装箱失败)。
  * **流程**:
    1. WES 标记任务失败: `Task_Status = Failed`。
    2. WES 释放预留: `DELETE /api/wms/inventory/reserve/{ReservationID}`。
    3. WES 记录异常日志: `Exception_Log(TaskID, Reason, Timestamp)`。

#### 3.4.2 智能分配策略引擎 (Intelligent Allocation Engine)

* **核心算法**: 基于多维度规则的 **策略引擎 (Rule Engine)**，支持动态配置。
* **关键策略**:

  **1. 装箱分配策略 (Binning Strategy)**

  * **料箱规格定义**:

    * **A 型料箱**: 6 个 7 寸料盘储位，每个储位仅可存放 7 寸料盘。
    * **B 型料箱**: 2 个 7 寸料盘储位 + 1 个大尺寸储位 (可存 13/15 寸料盘)。
    * **储位堆叠**: 每个储位可堆叠多个料盘，堆叠数量 = `储位可用深度 / 料盘厚度`。
  * **分配算法 (Allocation Algorithm)**:

    ```
    IF (料盘尺寸 == 7寸) THEN
      优先查找: 已有 A 型或 B 型料箱中，存有相同 Material+Vendor+DC 的 7 寸储位
      IF (找到 AND 储位未满) THEN
        分配到该储位
      ELSE
        选择空料箱: 优先 A 型 (6 个储位) > B 型 (2 个 7 寸储位)
        分配到第一个空储位
      END IF

    ELSE IF (料盘尺寸 > 7寸) THEN
      优先查找: 已有 B 型料箱中，大尺寸储位存有相同 Material+Vendor+DC 的料盘
      IF (找到 AND 储位未满) THEN
        分配到该储位
      ELSE
        选择空 B 型料箱
        分配到大尺寸储位
      END IF
    END IF
    ```
  * **容量计算 (Capacity Calculation)**:

    * **储位剩余容量** = `储位深度 - Sum(已存料盘厚度)`
    * **可放入判断** = `剩余容量 >= 当前料盘厚度`
    * **实时更新**: 每次放入后，WES 更新储位的 `Used_Depth` 和 `Remaining_Capacity`。
  * **防错机制 (Error Prevention)**:

    * **尺寸校验**: 7 寸料盘不得放入大尺寸储位，13/15 寸料盘不得放入 7 寸储位。
    * **混料禁止**: 同一储位内，`Material + Vendor + DC` 必须一致。

  **2. 发料优先级策略 (Issue Priority Strategy)**

  * **FEFO (First Expire First Out)**: 优先发 DC 日期最早的物料。
  * **退料优先**: 退料货架 > 正常库存。
  * **余料优先**: 栈板/货架容量 < 30% 的优先发出 (减少碎片化)。

  **3. 冷热区存储优化策略 (Hot/Cold Zone Optimization)**

  * **热区定义**: 近 7 天出库频次 > 10 次的物料 -> 分配到 **靠近产线的货架 (Hot Zone)**。
    * **五层货架**: 优先分配至 **A 面** (靠近产线侧)，减少 CTU 搬运距离。
  * **冷区定义**: 近 30 天无出库记录 -> 分配到 **远端货架 (Cold Zone)**。
    * **五层货架**: 优先分配至 **B 面** (远端侧)，释放 A 面给高频物料。
  * **动态调整**: WES 每日凌晨 2:00 执行 **冷热度重新计算 (Recalculation)**，生成货架搬运任务 (可选执行)。
  * **A/B 面负载平衡**: WES 监控五层货架两侧的负载率，当单侧负载 > 80% 时，触发平衡任务。

#### 3.4.3 任务编排引擎 (Task Orchestration Engine)

* **职责**: 将上层 "单据" 拆解为下层 "原子任务"，并管理任务生命周期。
* **任务状态机 (Task State Machine)**:
  ```
  Pending (待执行) -> Dispatched (已下发) -> InProgress (执行中)
    -> Completed (完成) / Failed (失败) / Suspended (挂起)
  ```
* **核心功能**:
  1. **任务拆解 (Task Decomposition)**:
     * 示例: 1 个工单 -> 拆解为 50 个 `Pick_Task` + 10 个 `Transport_Task`。
  2. **依赖管理 (Dependency Management)**:
     * 示例: `Transport_Task(A)` 必须在 `Pick_Task(B)` 完成后才能执行。
  3. **并发控制 (Concurrency Control)**:
     * 限制同一区域的并发任务数 (防止 AGV 拥堵)。
  4. **断点续传 (Checkpoint & Resume)**:
     * 任务执行到 Step 3 时系统重启 -> WES 从 Step 3 继续执行，无需重头开始。

---

### 3.5 特殊物料处理流程 (Special Material Handling)

本模块处理 **高值物料 (High-Value)**、**MSD 物料 (Moisture Sensitive)**、**PCB 物料** 和 **机构件 (Mechanical Parts)** 的特殊流程。

#### 3.5.1 高值物料入库协调 (High-Value Material Inbound)

* **场景**: 码头 -> 高值区 -> IQC 取样 -> 入库。
* **WES 特殊处理**:
  1. **专属路由**: WES 识别物料属性 `IsHighValue = True` -> 生成 `Transport_Task(To HighValue_Area)`，不经过普通暂存区。
  2. **六合一绑定强制校验**:
     * WES 下发规则，WMS PDA 必须扫描 **六合一码 (PKG)** 才能完成入库，WMS 将结果同步给 WES。
     * 校验逻辑: `PKG.Material == GRN.Material && PKG.Vendor == GRN.Vendor`。
  3. **IQC 取样追溯**:
     * 记录 `Sample_Log(PalletID, PKG, IQC_Inspector, Sample_Time)`。
     * 归还时校验: `PKG -> 原 PalletID` 匹配。

#### 3.5.2 MSD 与非规则物料处理 (MSD & Irregular Material)

* **场景**: 码头 -> 收货暂存区 -> IQC -> 六合一绑定 -> MSD 存储区。
* **WES 特殊处理**:
  1. **MSD 标识**: WES 维护 `Material.IsMSD` 属性，自动路由到 MSD 专区。
  2. **湿度敏感期管理**:
     * WES 记录 `MSD_Open_Time` (开封时间)。
     * 计算 `Remaining_Exposure_Time = Floor_Life - (Now - MSD_Open_Time)`。
     * 若 `Remaining_Exposure_Time < 0` -> WES 标记 `Status = Expired`，禁止发料。
  3. **非规则物料**: 无法通过自动线装箱 -> WES 生成 `Manual_Task`，指导人工处理。

#### 3.5.3 PCB 物料专线处理 (PCB Material Handling)

* **场景**: 码头 -> 收货暂存区 -> IQC -> PCB 存储区 -> 人工线发料。
* **WES 特殊处理**:
  1. **专属存储区**: WES 维护 `PCB_Storage_Zone`，与电子料物理隔离。
  2. **防静电追溯**: 记录 `ESD_Bag_ID` (防静电袋编号)，确保全程可追溯。
  3. **人工线发料**: PCB 不走自动线 -> WES 生成 `Rack_Move_Task(To Manual_Line)`。

#### 3.5.4 机构件物流协同 (Mechanical Parts Logistics)

* **场景**: 上盖/下盖栈板 -> 自动拆包线 -> Magazine 上料。
* **WES 协调职责**:

  **1. AB 栈板成对协同 (Paired Pallet Coordination)**

  * **配对逻辑**: WES 根据工单识别 `Top_Cover_Material` 和 `Bottom_Cover_Material`。
  * **同步调度**:
    * WES 生成 `Transport_Task_Pair(Pallet_A, Pallet_B)`。
    * 确保两个栈板 **同时到达** 拆包区 (时间差 < 5 分钟)。
  * **缺料处理**: 若只有 A 无 B -> WES 挂起任务，触发 `Shortage_Alert`。

  **2. 拆包与追溯 (Unpacking & Traceability)**

  * **围膜拆除**:
    * WES 生成 `Transport_Task(To Unwrap_Zone)`。
    * 人工拆围膜后，WMS PDA 呼叫（WMS 记录作业结果）-> WES 生成 `Transport_Task(To Unpack_Line)`，由 WMS 调度 RCS 执行。
  * **箱级校验**:
    * `ECS -> WES: Validate_Box(PKG, Box_Barcode)`。
    * WES 校验: `PKG.Material == WorkOrder.Material`。
  * **件级追溯**:
    * ECS 扫描机构件条码 (Part_SN) -> `ECS -> WES: Bind_Part(PKG, Part_SN)`。
    * WES 记录 `Traceability_Log(WorkOrder, PKG, Part_SN, Timestamp)`。
    * WES 推送追溯数据至 SFC (Shop Floor Control)。

  **3. Magazine 调度与产线上料 (Magazine Dispatch)**

  * **装满触发**: ECS 上报 `Magazine_Full` -> WES 生成 `Transport_Task(To Production_Buffer)`。
  * **空 Magazine 回流**: RCS 自主调度空 Magazine 回自动线 (WES 不干预)。
  * **产线需求驱动**: WES 接收 SFC 的 `Magazine_Request` -> 调度 RCS 从 Buffer 送产线。

  **4. 空栈板回收 (Empty Pallet Return)**

  * **触发条件**: ECS 扫描栈板，确认 `IsEmpty = True`。
  * **回收流程**:
    * `ECS -> WES: Pallet_Empty(PalletID)`。
    * WES 生成 `Transport_Task(To Empty_Pallet_Zone)`。
    * WES 更新栈板状态: `Status = Empty, Location = Empty_Zone`。

---

### 3.6 生产退料闭环 (Production Return Loop)

本模块处理产线退料的 **质量闭环 (Quality Loop)**，确保退料经过清点、测试后重新入库。

#### 3.6.1 退料接收与分类 (Return Receiving & Classification)

* **场景**: 产线下线 -> 料盘拆飞达 -> 放入标准胶框 -> 单层货架 -> SMT 退料作业区。
* **货架说明**: 使用 **退货货架 (Return Rack)** (详见 3.1.2) 存放退料料盘，货架式结构支持料盘级追踪，具有 A/B 面区分。
* **WES 处理流程**:
  1. **人工呼叫**: 仓库人员通过 WMS PDA 呼叫搬运 -> WES 生成 `Transport_Task(To Return_Area)`，提交 WMS 调度 RCS。
  2. **物料分类**: WMS PDA 界面指导人工区分（分类结果同步给 WES）:
     * **电子料 (Electronic)**: 进入 X-Ray/LCR 流程。
     * **MSD 物料**: 标记 `RequiresDrying = True`。
     * **高值物料**: 标记 `IsHighValue = True`，专人处理。
     * **非规则物料**: 标记 `IsIrregular = True`，人工入库。

#### 3.6.2 LCR 测试决策引擎 (LCR Test Decision Engine)

* **WES 决策逻辑**:
  ```
  IF (Material.HasLCR_Config == False) THEN
    Skip_LCR_Test
  ELSE IF (Qty_Returned == Qty_Issued AND Usage == 0) THEN
    Skip_LCR_Test  // 满盘未使用
  ELSE
    Require_LCR_Test
  END IF
  ```
* **测试流程**:
  1. **PDA 扫描**: 作业员在 WMS PDA 扫描 PKG -> 调用 WMS 获取 `LCR_Required(True/False)` 并回显。
  2. **测试执行**: 若需测试 -> 连接 LCR 测试仪 -> WES 接收测试结果 `LCR_Result(Pass/Fail)`。
  3. **结果处理**:
     * **Pass**: 放入流水线，进入 X-Ray 清点。
     * **Fail**: 放入不良品框，WES 标记 `Status = Defective`。

#### 3.6.3 X-Ray 智能清点与贴标 (X-Ray Counting & Relabeling)

* **WES 控制逻辑**:

  **Step 1: 清点决策 (Counting Decision)**

  ```
  IF (Qty_Returned == Qty_Issued AND Usage == 0) THEN
    Skip_XRay_Count  // 满盘
    New_PKG = Original_PKG
  ELSE
    Require_XRay_Count
  END IF
  ```

  **Step 2: X-Ray 清点执行 (X-Ray Execution)**

  * **流程**: ECS 扫描 PKG -> 流入 X-Ray 设备 -> 清点。
  * **数据流**: `ECS -> WES: XRay_Result(Original_PKG, Actual_Count)`。

  **Step 3: 新标签生成 (New Label Generation)**

  * **WES 算法**:
    ```
    New_PKG = Generate_PKG(
      Material: Original_PKG.Material,
      Vendor: Original_PKG.Vendor,
      Qty: Actual_Count,
      LC: Original_PKG.LC,  // 继承批次
      DC: Today,            // 更新日期
      NewSerial: Auto_Increment
    )
    ```
  * **贴标校验**:
    * WES 生成 ZPL 数据 -> `WES -> ECS: Print_Label(ZPL_Data)`。
    * ECS 打印并贴标 -> 扫描新标签 -> `ECS -> WES: Verify_Label(New_PKG)`。
    * WES 校验: `New_PKG.Material == Original_PKG.Material`。
    * **贴标要求**: 新标签覆盖旧标签，但保留旧料号可见。

  **Step 4: 分类上架 (Classification & Putaway)**

  * **WES 路由算法**:
    ```
    IF (Material.IsMSD == True) THEN
      Route_To = Manual_Box  // 人工封包 -> 干燥柜
    ELSE IF (Exists_Return_Rack_Space) THEN
      Route_To = Return_Rack + Assign_Slot(Side, SlotID)
    ELSE
      Call_RCS_For_Empty_Rack()
    END IF
    ```
  * **退料货架管理** (基于 3.1.2 定义的退货货架规格):
    * WES 维护 `Return_Rack_Inventory(RackID, Side, SlotID, PKG, Qty)`。
    * **料盘级追踪**: 每个储位存放单个料盘，WES 追踪 `Rack_ID + Side + Slot_ID` 精确位置。
    * **A 面装满**: WES 提示人工切换至 B 面操作，或呼叫 RCS 转向货架。
    * **全部装满**: WES 生成 `Transport_Task(To SMT_Storage)` -> 呼叫 RCS 补空架。
    * **A/B 面隔离**: 不同产线或工单的退料可分配至不同面，避免混料。

#### 3.6.4 退料入库与库存更新 (Return Putaway & Inventory Update)

* **WES 数据处理**:
  1. **库存更新**: 立即调用 WMS 接口增加库存: `WMS.Adjust_Inventory(Add, Actual_Count)`.
  2. **追溯记录**: `Return_Log(Original_PKG, New_PKG, Actual_Count, Return_Date)`。
  3. **SAP 同步**: 由 WMS 负责向 SAP 推送退料数据（WES 不越级上报）。

---

### 3.7 异常处理与人工干预 (Exception & Manual Intervention)

为确保中台的 **高可用性 (High Availability)** 和 **业务连续性 (Business Continuity)**，WES 必须具备完善的异常处理机制。

#### 3.7.1 任务中断与断点恢复 (Task Interruption & Checkpoint Resume)

* **场景**: 系统重启、设备故障、紧急停机。
* **WES 机制**:
  1. **断点记录 (Checkpoint Logging)**:
     * 每个任务执行到关键节点时，WES 记录 `Task_Checkpoint(TaskID, Step, State, Timestamp)`。
     * 示例: 装箱任务执行到 "已扫描 PKG，未分配箱号" -> 记录 `Step = 2, State = Pending_Allocation`。
  2. **恢复策略 (Resume Strategy)**:
     * **幂等性设计**: 所有 ECS/RCS 指令支持重复执行 (Idempotent)。
     * **状态校验**: 恢复前，WES 查询 ECS/RCS 当前状态，确认物理世界与数据一致。
     * **从断点继续**: `WES -> Task_Engine: Resume_From(TaskID, Last_Checkpoint)`。
  3. **人工确认机制**:
     * 若断点状态不明确 (如: AGV 位置未知) -> WES 触发 `Manual_Confirm_Required`，等待人工确认后继续。

#### 3.7.2 人工降级模式 (Manual Fallback Mode)

* **触发条件**: 自动线故障、ECS 离线、紧急情况。
* **WES 降级策略**:

  **1. 自动线 -> PDA 模式 (Auto to Manual)**

  * **切换流程**:
    * 管理员在 WES 界面点击 "切换人工模式"。
    * WES 挂起所有自动任务 -> 生成 `Manual_Task_List`。
  * **PDA 指导**:
    * WES 生成人工指令，由 WMS PDA 展示: "请从货架 A-01 取料盘 PKG-12345，放入料箱 B-03"。
    * 人工扫描确认在 WMS PDA 完成，WMS 同步结果给 WES，逻辑与自动线完全一致。

  **2. 数据一致性保障 (Data Consistency)**

  * **关键原则**: 无论自动/人工，所有操作必须实时通过 WMS 接口校验。
  * **校验机制**: PDA 提交数据到 WMS，WMS 调用 WES（如需编排/策略校验）并最终由 WMS 返回允许/拒绝指令。WES 不做本地逻辑校验。

#### 3.7.3 通信异常与重试机制 (Communication Exception & Retry)

* **场景**: ECS/RCS 网络抖动、设备无响应。
* **WES 处理流程**:

  **1. 自动重试 (Auto Retry)**

  ```
  FOR i = 1 TO 3 DO
    Send_Command(ECS, Command)
    Wait_Response(Timeout = 10s)
    IF Response_Received THEN
      Break
    ELSE
      Log_Warning("Retry " + i + "/3")
    END IF
  END FOR
  ```

  **2. 失败处理 (Failure Handling)**

  * **3 次重试失败** -> WES 执行:
    1. 标记设备状态: `Device_Status = Offline`。
    2. 挂起相关任务: `Task_Status = Suspended`。
    3. 触发告警: `Alert(DeviceID, "Communication Lost", Severity = High)`。
    4. 通知运维: 发送邮件/短信/钉钉消息。

  **3. 设备恢复 (Device Recovery)**

  * ECS/RCS 恢复在线 -> WES 自动检测 (心跳机制)。
  * WES 执行 `Health_Check(DeviceID)` -> 若通过，自动恢复挂起任务。

  **4. 上游 WMS 断连处理 (WMS Disconnection Handling)**

  * **熔断机制**: 若连续 3 次调用 WMS 接口超时或返回 5xx 错误，触发断网保护。
  * **暂停策略**:
    * **立即暂停**: 所有涉及库存变动的业务任务 (收货、发料、装箱、入库确认、出库确认等)
    * **允许继续**: 纯物理搬运任务 (AGV 回充电桩、空箱回流、设备空闲调度等)
    * **告警通知**: 触发 `System_Pause` 告警，通知 IT 介入
  * **自动恢复**: WMS 接口恢复正常后，自动继续执行被暂停的任务，无需人工干预。

#### 3.7.4 优先级调整与急料插队 (Priority Adjustment & Urgent Material)

* **场景**: 产线急需某物料，需打断当前作业。
* **WES 功能**:
  1. **手动调整优先级**:
     * 管理员在 WES 界面选择任务 -> 点击 "提升优先级"。
     * WES 重新排序任务队列: `Task_Queue.Sort_By(Priority DESC, Create_Time ASC)`。
  2. **急料插队 (Urgent Insert)**:
     * WES 暂停当前低优先级任务 (若可中断)。
     * 立即执行急料任务 -> 完成后恢复原任务。
  3. **冲突检测**:
     * 若急料与当前任务使用同一设备 -> WES 提示 "无法插队，设备占用中"。

#### 3.7.5 数据校验与防错机制 (Data Validation & Error Proofing)

* **WES 多层校验**:
  1. **输入校验 (Input Validation)**:
     * PDA 扫描 PKG (通过 WMS) -> WMS 调用 WES 校验: `PKG.Format == "6-in-1" && PKG.Material IN Master_Data`。
  2. **逻辑校验 (Logic Validation)**:
     * 装箱前 -> WES 校验: `Bin.Remaining_Space >= Material.Dims`。
  3. **物理校验 (Physical Validation)**:
     * ECS 反馈 "无法放入" -> WES 标记异常，重新分配。
  4. **追溯校验 (Traceability Validation)**:
     * 出库前 -> WES 校验: `PKG.WorkOrder == Current_WorkOrder`，防止错料上线。

---

### 3.8 与现有 WMS 的集成架构 (Integration with Existing WMS)

本章节定义 P9 WES 作为 **自动化增强层 (Automation Enhancement Layer)** 与现有 WMS 的集成模式。

#### 3.8.1 系统定位与职责划分 (System Positioning & Responsibility)

* **现有 WMS (Existing WMS - 主系统)**:

  * **库存主数据**: 唯一的库存真实源 (Single Source of Truth)，管理 P9 工厂所有库存。
  * **业务单据**: 收货单、出库单、调拨单、盘点单等业务凭证。
  * **账务管理**: 库存账务、成本核算、财务对接。
  * **全局视图**: 提供全工厂的库存查询和报表。
* **P9 WES (This System - 增强层)**:

  * **执行协调**: 协调自动化区域的 RCS/ECS 设备完成物理动作。
  * **状态追踪**: 追踪物料在自动化设备中的实时位置和状态 (瞬态数据)。
  * **策略引擎**: 运行装箱策略、发料优先级、路由算法等智能决策。
  * **设备控制**: 直接调度 SMT 区、机构件区、退料区等自动化设备。
* **协同原则 (Coordination Principles)**:

  * **查询驱动 (Query-Driven)**: WES 需要库存数据时，实时查询现有 WMS。
  * **确认驱动 (Confirmation-Driven)**: WES 完成物理动作后，通知现有 WMS 更新库存。
  * **预留机制 (Reservation)**: WES 通过预留接口锁定库存，避免超发。
  * **RCS 通道 (Phase Boundary)**: 本阶段 RCS 仍由现有 WMS 统一调度。WES 只提交搬运/交换需求给 WMS，由 WMS 调用 RCS 并回传结果/事件。
  * **PDA 通道**: PDA 仅与 WMS 交互；WES 如需感知 PDA 作业结果，由 WMS 推送/同步。

#### 3.8.2 集成接口规范 (Integration Interface Specification)

* **现有 WMS 需提供的接口 (APIs Required from Existing WMS)**:

  **1. 库存查询接口 (Inventory Query)**

  ```
  GET /api/wms/inventory/query
  Query Params: material_id, location, zone
  Response: { material_id, location, qty_available, qty_reserved, ... }
  ```

  **2. 库存预留接口 (Inventory Reservation)**

  ```
  POST /api/wms/inventory/reserve
  Body: { material_id, qty, work_order, reserved_by, expire_time }
  Response: { reservation_id, status }

  DELETE /api/wms/inventory/reserve/{reservation_id}
  Response: { status }
  ```

  **3. 入库确认接口 (Putaway Confirmation)**

  ```
  POST /api/wms/inventory/putaway
  Body: { grn, material_id, qty, location, pkg_code, timestamp }
  Response: { status, transaction_id }
  ```

  **4. 出库确认接口 (Issue Confirmation)**

  ```
  POST /api/wms/inventory/issue
  Body: { reservation_id, material_id, qty, work_order, timestamp }
  Response: { status, transaction_id }
  ```
* **P9 WES 提供的接口 (APIs Provided by P9 WES)**:

  **1. 执行状态查询 (Execution State Query)**

  ```
  GET /api/wes/execution/status
  Query Params: task_id, material_id, work_order
  Response: { task_id, status, current_location, progress, ... }
  ```

  **2. 任务下发接口 (Task Dispatch)**

  ```
  POST /api/wes/tasks/dispatch
  Body: { task_type, material_id, qty, source, target, priority }
  Response: { task_id, status }
  ```

#### 3.8.3 数据一致性保障 (Data Consistency Guarantee)

* **幂等性设计 (Idempotency)**:

  * 所有确认接口 (putaway/issue) 基于 `TaskID` 去重，支持重复调用。
  * **幂等性规则**:
    * **相同 TaskID + 相同数据**: 返回成功，不重复执行，返回首次执行结果。
    * **相同 TaskID + 不同数据**: 返回错误 (409 Conflict)，拒绝执行，提示数据不一致。
    * **不同 TaskID**: 正常执行新任务。
  * 避免网络重试导致的重复入库/出库。
* **事务补偿 (Transaction Compensation)**:

  * 若 WES 物理动作失败 -> 释放预留 -> 记录异常日志。
  * 若 WMS 确认接口失败 -> WES 重试 3 次 -> 失败后触发人工介入。
* **对账机制 (Reconciliation)**:

  * 每日凌晨 2:00，WES 与现有 WMS 进行库存对账。
  * 对比 WES 的执行记录与 WMS 的库存变动，识别差异。
  * 差异超过阈值 -> 触发告警，人工核查。

---

### 3.9 接口摘要 (Interface Summary)

(详细定义见章节 4)

* **SAP**: 收货单、工单、主数据（本阶段仅通过现有 WMS 中转，不直接对接）。
* **现有 WMS**: SAP 转发的单据、库存查询、库存预留、入库/出库确认——WES 的唯一业务/库存数据来源。
* **RCS**: 搬运 (Move)、交换 (Exchange)、旋转 (Rotate)。
* **ECS**: 校验 (Check)、指令 (Instruction)、结果 (Result)。
* **QMS**: 抽检请求、结果回传。

## 4. 接口需求 (Interface Requirements)

### 4.1 北向接口 (Northbound API - To Existing WMS)

* **定位**: 标准化的业务接入层，接收上游 SAP 通过现有 WMS 转发的单据和主数据。本阶段 WES 不直接调用 SAP。
* **协议**: RESTful API (HTTPS).
* **核心接口**:
  * `POST /api/v1/orders/inbound`: 接收收货通知 (由现有 WMS 转发 SAP 单据)。
  * `POST /api/v1/orders/production`: 接收生产工单 (由现有 WMS 转发 SAP 单据)。
  * `POST /api/v1/master-data`: 接收物料主数据同步 (由现有 WMS 转发 SAP 主数据)。
  * `GET /api/v1/wms/inventory/query`: 调用现有 WMS 的库存查询接口。
  * `POST /api/v1/wms/inventory/reserve`: 调用现有 WMS 的库存预留接口。
  * `POST /api/v1/wms/inventory/confirm`: 向现有 WMS 推送入库/出库确认。

### 4.2 南向接口 (Southbound API - To ECS/RCS)

* **定位**: 适配不同硬件厂商的插件层 (Adapter Layer)。
* **协议**: TCP/Modbus/HTTP/MQTT (视硬件而定)。
* **架构模式**: **插件化 (Plugin-Based)**。针对不同品牌的 AGV 或机械臂，开发独立的 Driver Plugin，转换为 WES 内部的标准化指令。

---

## 5. 非功能需求 (Non-functional Requirements)

1. **启动独立性 (Startup Independence)**: WES 启动不应阻塞于 WMS 连接失败（可启动进入待命状态），但**业务执行**强依赖 WMS。
2. **数据一致性 (Data Consistency)**: 采用 **强一致性 (Strong Consistency)** 模型。WES 不持有数据，所有库存变动必须在 WMS 端事务提交成功后，物理动作方可视为完成。
3. **可观测性 (Observability)**: 提供独立的 Prometheus/Grafana 监控接口，重点监控 **WMS 接口延迟**、设备在线率及任务积压。
4. **故障恢复 (Failure Recovery)**: 不要求本地业务数据持久化缓存。系统重启后，应通过查询 WMS 和现场设备状态重建上下文。
