kaizhoumasha/fxn_wms/docs/feature_list.md

# 休斯顿P9 WES 功能清单

# Houston P9 Warehouse Execution System - Feature List

> **文档版本**: 1.0
> **创建日期**: 2025-12-15
> **文档用途**: 客户验收与测试指导
> **参考文档**: docs/SRS.md, docs/user_requirement.md

---

## 功能统计

- **总功能数**: 93项
- **核心模块**: 10个
- **优先级分布**: P0(核心) 45项, P1(重要) 32项, P2(增强) 16项

---

## 1. 系统基础能力 (System Foundation)

| 序号 | 场景 | 功能 | 描述 | 验收点 |
| ---- | --- | --- | --- | --- |
| 1.1  | 系统架构 | 三层架构部署 | 实现L1(SAP→现有WMS) → L2(WES) → L3(硬件)的独立三层架构，WES作为独立控制中台运行 | 1. WES作为WMS的代理中台运行（SAP 经 WMS 转发）<br />2. 支持Docker容器化部署 <br />3. 业务执行强依赖WMS在线 |
| 1.3 | 系统架构 | API驱动架构 | 所有功能通过RESTful API访问，支持标准化数据接口 | 1. API文档完整<br />2. 支持API版本管理<br />3. 响应时间<2秒 |
  | 1.4 | 基础数据 | 货架箱号初始化 | 维护单层货架(4箱)、五层货架(20箱)、生产/退货货架的箱号与地码绑定 | 1. 支持批量导入<br />2. 数据校验完整<br />3. 支持A/B面区分 |
| 1.5 | 基础数据 | 物料主数据维护 | 维护物料尺寸、厚度、供应商等基础数据，支持装箱算法计算 | 1. 支持Excel导入<br />2. 数据变更历史记录<br />3. 经现有WMS与SAP同步 |
  | 1.6 | 策略引擎 | 可配置业务逻辑 | 支持通过规则引擎动态调整上架策略、抽检比例等，无需重新编译 | 1. 规则配置界面<br />2. 规则生效实时性<br />3. 规则版本管理 |
  | 1.7 | 系统架构 | 容器化部署能力 | 支持Docker部署，可在私有云或边缘服务器运行 | 1. Docker镜像构建<br />2. 一键部署脚本<br />3. 资源监控 |
  | 1.8 | 异常恢复 | 断点续传机制 | 系统重启后从断点继续执行任务，支持Checkpoint记录 | 1. 任务状态持久化<br />2. 恢复成功率>99%<br />3. 数据一致性保障 |
  | 1.9 | 数据安全 | 幂等性设计 | 所有ECS/RCS指令支持重复执行，避免重复操作 | 1. 基于TaskID去重<br />2. 网络重试安全<br />3. 状态校验机制 |
  | 1.10 | 数据质量 | 数据校验与防错 | 多层校验机制：输入校验、逻辑校验、物理校验、追溯校验 | 1. PKG格式校验<br />2. 容量计算准确<br />3. 防混料机制 |

---

## 2. 收货入库执行 (Inbound Receiving)

| 序号 | 场景 | 功能 | 描述 | 验收点 |
| ---- | --- | --- | --- | --- |
| 2.1  | 码头收货 | 到货清单登记 | PDA登记车牌号、到货箱数或快递号，支持人工录入 | 1. PDA界面友好<br />2. 数据实时同步<br />3. 支持离线操作 |
| 2.2  | 码头收货 | GRN单据接入 | 接收由现有WMS转发的SAP GRN数据，支持PO、项次、料号、数量匹配 | 1. API接口稳定<br />2. 数据格式校验<br />3. 异常处理机制 |
| 2.3  | 码头收货 | 栈板标签生成 | 生成唯一栈板号并下发ZPL指令给打印机 | 1. 栈板号唯一性<br />2. 打印成功率>99%<br />3. 条码可扫描 |
| 2.4  | 码头收货 | 多对多绑定 | 支持1个栈板绑定多个GRN(混托)或1个GRN分拆到多个栈板(分托) | 1. 数量校验准确<br />2. 支持循环绑定<br />3. 绑定记录可追溯  |
| 2.5  | IQC检验  | IQC动态路由 | 根据物料属性自动路由到IQC待检区或直接入库 | 1. 路由规则准确<br />2. 呼叫RCS成功<br />3. 任务状态跟踪 |
| 2.6  | IQC检验  | 抽检策略计算 | 调用QMS接口查询抽检策略，接收抽检量并生成路由任务 | 1. QMS接口对接<br />2. 抽检量计算准确<br />3. 零抽检直接入库 |
| 2.7  | IQC检验  | 取样与归还追溯 | 记录IQC取样动作和归还动作，确保样品回归原栈板 | 1. PKG扫描记录<br />2. 栈板匹配校验<br />3. 追溯日志完整 |
| 2.8  | IQC检验  | 复判路由算法 | 根据QMS检验结果(OK/NG)自动路由到暂存区或复判区 | 1. 结果接收实时<br />2. 路由决策准确<br />3. 任务优先级可调  |
| 2.9  | IQC检验  | 拆板分拣支持 | 在复判区支持PDA拆板作业，将NG物料移至新栈板 | 1. 拆板界面清晰<br />2. 数量扣减准确<br />3. 新栈板号生成 |
| 2.10 | 装箱准备 | 待装箱列表管理 | 提供人工/系统两种作业模式的待装箱物料列表 | 1. 列表实时更新<br />2. 支持GRN筛选<br />3. 时间顺序排列 |
| 2.11 | 装箱准备 | 人工/系统模式切换 | 支持人工选择GRN或系统按时间顺序自动派送 | 1. 模式切换流畅<br />2. 任务不冲突<br />3. 状态同步 |
| 2.12 | 装箱作业 | 空架补给监控 | 监控装箱区空单层货架数量，不足时呼叫RCS补给 | 1. 库存监控实时<br />2. 提前呼叫机制<br />3. 空架验证 |
| 2.13 | 装箱作业 | 满架切出触发 | 计算货架已满时生成运送任务并呼叫RCS补新空架 | 1. 满架判断准确<br />2. 任务生成及时<br />3. 无缝衔接 |
| 2.14 | 异常处理 | 异常栈板处理 | 处理绑定异常、数量不符、破损等异常栈板 | 1. 异常分类清晰<br />2. 处理流程明确<br />3. 告警通知 |
| 2.15 | 收货完成 | 空栈板回收 | 拆箱完成后生成空栈板送回空栈板区任务 | 1. PDA呼叫便捷<br />2. 状态更新准确<br />3. 区域管理 |

---

## 3. 装箱作业协调 (Kitting Operations)

| 序号 | 场景 | 功能 | 描述 | 验收点 |
| ---- | --- | --- | --- | --- |
| 3.1  | 智能装箱 | 装箱分配策略 | 基于料盘尺寸、料箱类型、储位容量的智能分配算法 | 1. 同类合并优先<br />2. 料箱选择准确<br />3. 空间利用率>80% |
| 3.2  | 视觉识别 | PKG六合一码验证  | 机械臂拍照识别PKG码，验证料号、供应商、批次等信息 | 1. 识别准确率>99%<br />2. 响应时间<3秒<br />3. 异常料盘隔离 |
| 3.3  | 视觉识别 | 尺寸厚度偏差检测 | 验证料盘实际尺寸/厚度与主数据偏差，防错机制 | 1. 偏差阈值可配置<br />2. 超差告警<br />3. 数据记录 |
| 3.4  | 装箱策略 | 同类合并优先 | 优先放入已存有相同Material+Vendor+DC的储位 | 1. 匹配算法准确<br />2. 减少碎片化<br />3. 提高拣选效率 |
| 3.5  | 装箱策略 | 料箱类型选择 | 7寸料盘优先A型箱(6储位)，13/15寸选B型箱(大储位) | 1. 类型判断准确<br />2. 容量计算正确<br />3. 防错机制 |
| 3.6  | 容量计算 | 储位深度计算 | 实时计算储位剩余深度，确保可放入当前料盘 | 1. 深度计算准确<br />2. 堆叠数量正确<br />3. 实时更新 |
| 3.7  | 容量计算 | 堆叠高度预测 | 根据料盘厚度预测可堆叠数量，返回期望堆叠高度 | 1. 预测准确<br />2. ECS执行一致<br />3. 异常处理 |
| 3.8  | 异常处理 | 装不进异常处理 | ECS反馈Put_Fail时标记Slot异常并重新分配 | 1. 异常识别快速<br />2. 重新分配准确<br />3. 日志记录 |
| 3.9  | 设备协同 | ECS握手协议 | 与ECS进行空架验证、指令确认、结果反馈的握手交互 | 1. 协议稳定<br />2. 超时重试<br />3. 状态同步 |
| 3.10 | 数据同步 | 装箱数据绑定 | 将PKG六合一信息绑定到GRN，更新库存数据 | 1. 绑定逻辑准确<br />2. 数据一致性<br />3. 实时同步 |

---

## 4. 存储与库存管理 (Storage Management)

| 序号 | 场景 | 功能 | 描述 | 验收点 |
| ---- | --- | --- | --- | --- |
| 4.1  | 货架管理 | 三种货架类型管理 | 管理单层货架(4箱)、五层货架(20箱)、生产/退货货架 | 1. 类型区分清晰<br />2. 容量管理准确<br />3. 状态实时更新 |
| 4.2  | 混合入库 | 满箱交换策略 | 料箱Usage≥80%且有空箱资源时执行CTU交换任务；50-80%优先交换，无空箱则拣选 | 1. 判断逻辑准确<br />2. 交换成功率>99%<br />3. 数据更新同步 |
| 4.3  | 混合入库 | 零散入库策略 | 料箱未满时生成流水线拣选任务，机械臂执行抓取 | 1. 任务生成准确<br />2. 拣选指令清晰<br />3. 数量核对 |
| 4.4  | 混合入库 | 混合模式决策 | 智能判断先交换后拣选或纯拣选模式 | 1. 决策算法优化<br />2. 效率提升>30%<br />3. 资源利用合理 |
| 4.5  | 存储优化 | 冷热区存储优化 | 高频物料分配至A面热区，低频物料分配至B面冷区 | 1. 频次统计准确<br />2. 动态调整机制<br />3. 搬运距离减少 |
| 4.6  | 存储优化 | A/B面负载平衡 | 监控五层货架两侧负载率，单侧>80%时触发平衡任务 | 1. 负载监控实时<br />2. 平衡算法有效<br />3. CTU效率提升 |
| 4.7  | 精细管理 | 料盘级追踪 | 生产/退货货架支持料盘级追踪(Rack_ID+Side+Slot_ID) | 1. 位置记录准确<br />2. 查询响应快<br />3. 追溯完整 |
| 4.8  | 库存协同 | 实时库存查询与透传 | 实时调用现有WMS接口查询/预留/确认库存，不维护本地库存副本 | 1. 查询/预留/确认接口稳定<br />2. 响应时间满足业务要求<br />3. 数据一致性保障 |

---

## 5. 生产发料协调 (Production Issue)

| 序号 | 场景 | 功能 | 描述 | 验收点 |
| ---- | --- | --- | --- | --- |
| 5.1  | 工单处理 | 工单接入与解析 | 接收现有WMS转发的SAP工单，解析物料清单和生产时间 | 1. 接口稳定<br />2. 解析准确<br />3. 异常处理 |
| 5.2  | 波次计算 | 滚筒波次计算 | 根据开线时间+6小时补料间隔生成发料波次 | 1. 时间计算准确<br />2. 波次合理<br />3. 提前量可配置 |
| 5.3  | 任务拆解 | 物料分类拆解 | 拆解为电子料、MSD、PCB、非规则物料等不同任务 | 1. 分类准确<br />2. 任务完整<br />3. 优先级设置 |
| 5.4  | 发料策略 | 退料优先发料 | 优先从退料货架发料，减少库存碎片化 | 1. 优先级准确<br />2. 库存更新及时<br />3. 余料清理 |
| 5.5  | 发料策略 | FEFO策略 | First Expire First Out，优先发DC日期最早的物料 | 1. 日期排序准确<br />2. 过期预警<br />3. 批次追溯 |
| 5.6  | 发料策略 | 余料优先清理 | 容量<30%的栈板/货架优先发出 | 1. 容量计算准确<br />2. 碎片化减少<br />3. 空间利用提升 |
| 5.7  | 自动线 | 自动线预缓存 | 提前调度下一波次货架到Buffer区，减少等待时间 | 1. 预测准确<br />2. 缓存时机合理<br />3. 等待时间<5分钟 |
| 5.8  | 人工线 | 人工线协调 | 协调MSD、PCB、非规则物料到人工线 | 1. 任务分配准确<br />2. PDA指导清晰<br />3. 数据同步 |
| 5.9  | 转运管理 | 转运料架调度 | 管理空转运料架从存放区到作业区的调度 | 1. 空架监控<br />2. 调度及时<br />3. 位置追踪 |
| 5.10 | 转运管理 | 料架转向控制 | 控制退料料架和转运料架的A/B面转向 | 1. 转向指令准确<br />2. RCS执行成功<br />3. 状态反馈 |
| 5.11 | 备料管理 | 备料区管理 | 管理已领完料的转运料架送SMT产线备料区 | 1. 完成判断准确<br />2. 送达及时<br />3. 产线对接 |
| 5.12 | 异常处理 | 缺料告警 | Pick_Fail时自动扣减库存并标记Shortage，尝试备选库存 | 1. 告警及时<br />2. 备选查找<br />3. 通知机制 |

---

## 6. 特殊物料处理 (Special Materials)

| 序号 | 场景 | 功能 | 描述 | 验收点 |
| ---- | --- | --- | --- | --- |
| 6.1  | 高值物料 | 专属路由 | 识别IsHighValue=True，生成专属路由任务到高值区 | 1. 属性识别准确<br />2. 路由隔离<br />3. 安全管控 |
| 6.2  | 高值物料 | 六合一强制校验 | 入库时必须扫描PKG六合一码，校验Material和Vendor | 1. 强制扫描<br />2. 校验准确<br />3. 不通过拒绝 |
| 6.3  | 高值物料 | IQC取样追溯 | 记录Sample_Log(PalletID, PKG, Inspector, Time) | 1. 日志完整<br />2. 归还匹配<br />3. 可追溯 |
| 6.4  | MSD物料  | 湿度敏感期管理 | 维护MSD_Open_Time，计算Remaining_Exposure_Time | 1. 时间记录准确<br />2. 计算正确<br />3. 过期禁发 |
| 6.5  | MSD物料  | Floor Life计算 | Floor_Life - (Now - MSD_Open_Time)，<0时标记Expired | 1. 公式准确<br />2. 实时计算<br />3. 状态更新 |
| 6.6  | MSD物料  | 非规则物料处理 | 无法自动装箱时生成Manual_Task，指导人工处理 | 1. 识别准确<br />2. 任务清晰<br />3. PDA指导 |
| 6.7  | PCB物料  | PCB专线处理 | 维护PCB_Storage_Zone，与电子料物理隔离 | 1. 区域隔离<br />2. 专线路由<br />3. 人工线发料 |
| 6.8  | PCB物料  | 防静电追溯 | 记录ESD_Bag_ID，确保全程可追溯 | 1. 袋号记录<br />2. 追溯完整<br />3. 合规性 |
| 6.9  | 机构件 | AB栈板配对 | 识别Top_Cover和Bottom_Cover，确保同时到达 | 1. 配对逻辑准确<br />2. 时间差<5分钟<br />3. 缺料挂起 |
| 6.10 | 机构件 | 围膜拆除协调 | 生成拆围膜任务，人工完成后PDA呼叫RCS | 1. 任务生成<br />2. PDA便捷<br />3. 流程衔接 |
| 6.11 | 机构件 | 箱级件级追溯 | 扫描Box_Barcode和Part_SN，推送至SFC | 1. 双重追溯<br />2. SFC对接<br />3. 数据完整 |
| 6.12 | 机构件 | Magazine调度 | 装满触发运送任务，空Magazine自动回流 | 1. 满载判断<br />2. 调度及时<br />3. 循环管理 |

---

## 7. 退料闭环处理 (Return Processing)

| 序号 | 场景 | 功能 | 描述 | 验收点 |
| ---- | --- | --- | --- | --- |
| 7.1  | 退料接收  | 退料接收与分类  | PDA指导人工区分电子料、MSD、高值、非规则物料 | 1. 分类界面清晰<br />2. 标记准确<br />3. 路由正确 |
| 7.2  | LCR测试 | LCR测试决策引擎 | 根据配置、数量、使用情况决定是否需要LCR测试 | 1. 决策逻辑准确<br />2. 满盘跳过<br />3. 测试记录 |
| 7.3  | LCR测试 | 满盘跳过逻辑 | Qty_Returned==Qty_Issued且Usage==0时跳过测试 | 1. 判断准确<br />2. 效率提升<br />3. 数据记录 |
| 7.4  | X-Ray清点 | X-Ray智能清点 | 非满盘时通过X-Ray设备清点实际数量 | 1. 清点准确率>99.5%<br />2. 速度快<br />3. 异常处理 |
| 7.5  | 标签管理  | 新标签生成算法  | 继承LC批次，更新DC日期，生成新Serial | 1. 算法准确<br />2. 标签唯一<br />3. 追溯链完整 |
| 7.6  | 标签管理  | 贴标校验 | 打印新标签后扫描验证，确保Material一致 | 1. 校验准确<br />2. 覆盖旧标签<br />3. 旧料号可见 |
| 7.7  | 退料上架  | 退料货架管理 | 管理退货货架储位，支持A/B面隔离和料盘级追踪 | 1. 储位管理<br />2. 面隔离<br />3. 位置追踪 |
| 7.8  | 数据同步  | 追溯记录生成 | 记录Return_Log(Original_PKG, New_PKG, Count, Date) | 1. 日志完整<br />2. 通过现有WMS推送SAP<br />3. 可追溯 |

---

## 8. 异常处理与人工干预 (Exception Handling)

| 序号 | 场景 | 功能 | 描述 | 验收点 |
| ---- | --- | --- | --- | --- |
| 8.1  | 任务恢复 | 任务中断与断点恢复 | 系统重启后从Checkpoint继续执行任务 | 1. 任务状态持久化<br />2. 恢复前与WMS和设备校验<br />3. 数据一致性保障 (依赖WMS) |
| 8.2  | 任务恢复 | Checkpoint记录机制 | 关键节点记录Task_Checkpoint(TaskID, Step, State) | 1. 节点选择合理<br />2. 记录及时<br />3. 存储可靠 |
| 8.3  | 降级模式 | 人工降级模式 | 自动线故障时切换到PDA人工模式 | 1. 切换流畅<br />2. PDA指导清晰<br />3. 数据一致 (依赖WMS) |
| 8.4  | 降级模式 | PDA指导界面 | 提供详细的人工操作指导和扫描确认 | 1. 界面友好<br />2. 指令清晰<br />3. 校验完整 |
| 8.5  | 通信异常 | 通信异常重试 | 3次重试机制，10秒超时，失败后标记设备离线 | 1. 重试逻辑准确<br />2. 超时合理<br />3. 告警及时 |
| 8.6  | 设备管理 | 设备健康检查 | 心跳机制检测设备在线，自动恢复挂起任务 | 1. 心跳间隔合理<br />2. 恢复自动<br />3. 日志记录 |
| 8.7  | 优先级 | 优先级调整 | 管理员手动调整任务优先级，重新排序队列 | 1. 调整界面<br />2. 生效及时<br />3. 冲突检测 |
| 8.8  | 优先级 | 急料插队 | 暂停低优先级任务，立即执行急料任务 | 1. 插队逻辑<br />2. 恢复机制<br />3. 设备占用检测 |

---

## 9. 系统集成接口 (System Integration)

| 序号 | 场景 | 功能 | 描述 | 验收点 |
| ---- | --- | --- | --- | --- |
| 9.1  | 北向接口 | 库存查询接口 | 调用现有WMS的库存查询API，支持短时缓存(TTL≤30s)优化性能 | 1. 接口稳定<br />2. 响应时间<1秒<br />3. WMS为唯一库存主数据源 |
| 9.2  | 北向接口 | 库存预留接口 | 向现有WMS申请预留库存，返回ReservationID | 1. 预留成功率>99% (WMS侧)<br />2. 锁定准确 (WMS侧)<br />3. 释放及时 (WMS侧) |
| 9.3  | 北向接口 | 入库确认接口 | 物理动作完成后通知WMS更新库存，支持幂等 | 1. 确认及时<br />2. 幂等设计 (WMS侧)<br />3. 重试机制 (WMS侧) |
| 9.4  | 北向接口 | 出库确认接口 | 发料完成后通知WMS，基于ReservationID确认 | 1. 确认准确 (WMS侧)<br />2. 数据完整 (WMS侧)<br />3. 异常处理 (WMS侧) |
| 9.5  | 南向接口 | 插件化适配器 | 针对不同品牌AGV/机械臂开发独立Driver Plugin | 1. 插件架构清晰<br />2. 热插拔支持<br />3. 协议转换准确 |
| 9.6  | 南向接口 | 多协议支持 | 支持TCP/Modbus/HTTP/MQTT等多种硬件通信协议 | 1. 协议稳定<br />2. 并发处理<br />3. 错误恢复 |

---

## 10. 监控与运维 (Monitoring & Operations)

| 序号 | 场景 | 功能 | 描述 | 验收点 |
| ---- | --- | --- | --- | --- |
| 10.1 | 系统监控 | Prometheus/Grafana监控 | 提供独立的监控接口，实时监控系统运行状态 | 1. 监控面板完整<br />2. 指标采集准确<br />3. 告警及时  |
| 10.2 | 性能监控 | API延迟监控 | 监控所有API接口的响应时间和成功率 | 1. 延迟统计准确<br />2. P95/P99指标<br />3. 慢查询告警 |
| 10.3 | 队列监控 | 队列堆积量监控 | 监控任务队列堆积情况，预警处理能力不足 | 1. 堆积阈值可配置<br />2. 趋势分析<br />3. 容量规划 |
| 10.4 | 设备监控 | 设备在线率监控 | 监控RCS/ECS/PDA等设备的在线状态和健康度  | 1. 在线率统计<br />2. 故障告警<br />3. 历史记录 |

---

## 附录A：验收测试场景

### A.1 端到端场景测试

| 测试场景 | 覆盖功能 | 测试步骤 | 预期结果 |
| --- | --- | --- | --- |
| 完整收货入库流程 | 2.1-2.15, 3.1-3.10, 4.2-4.3 | 1. 码头登记到货<br />2. 打印栈板号<br />3. PDA绑定<br />4. IQC检验<br />5. 装箱作业<br />6. 混合入库 | 物料成功入库，库存准确，追溯完整 |
| 生产发料全流程 | 5.1-5.12, 4.5-4.6 | 1. 接收工单<br />2. 波次计算<br />3. 退料优先<br />4. 自动线发料<br />5. 人工线协调 | 物料准时送达产线，库存扣减准确 |
| 退料闭环处理 | 7.1-7.8 | 1. 退料接收<br />2. LCR测试<br />3. X-Ray清点<br />4. 新标签生成<br />5. 退料上架 | 退料重新入库，数量准确，标签正确 |
| 异常恢复测试 | 8.1-8.8 | 1. 模拟系统重启<br />2. 模拟设备故障<br />3. 模拟网络中断<br />4. 切换人工模式 | 任务恢复成功，数据一致，无丢失 |

### A.2 性能测试指标

| 性能指标 | 目标值 | 测试方法 |
| --- | --- | --- |
| API响应时间 | P95 < 2秒 | 压力测试，并发100用户 |
| 装箱效率 | >200盘/小时 | 实际作业统计 |
| 发料准确率 | >99.9% | 抽样检查1000次 |
| 系统可用性 | >99.5% | 连续运行30天 |
| 断点恢复成功率 | >99% | 模拟中断100次 |

### A.3 集成测试检查点

| 集成点 | 检查项 | 验收标准 |
| --- | --- | --- |
| SAP接口（经现有WMS转发） | GRN单据接收 | 数据完整，格式正确，实时同步 |
| 现有WMS接口 | 库存查询/预留/确认 | 接口稳定，响应<1秒，幂等性 |
| QMS接口 | 抽检量计算/结果回传 | 双向通信，数据准确，异常处理 |
| RCS接口 | 搬运任务下发/状态反馈 | 指令准确，状态同步，重试机制 |
| ECS接口 | 装箱指令/视觉识别 | 握手协议，数据校验，异常恢复 |
| SFC接口 | 追溯数据推送 | 实时推送，数据完整，可追溯 |

---

## 附录B：功能优先级分类

### P0 - 核心功能（必须实现，45项）

  **系统基础**: 1.1-1.5, 1.8-1.10
  **收货入库**: 2.1-2.9, 2.12-2.13
  **装箱作业**: 3.1-3.6, 3.9-3.10
  **存储管理**: 4.1-4.4, 4.8
  **生产发料**: 5.1-5.7, 5.12
  **集成接口**: 9.1-9.4

### P1 - 重要功能（应该实现，32项）

  **系统基础**: 1.6-1.7
  **收货入库**: 2.10-2.11, 2.14-2.15
  **装箱作业**: 3.7-3.8
  **存储管理**: 4.5-4.7
  **生产发料**: 5.8-5.11
  **特殊物料**: 6.1-6.8
  **退料处理**: 7.1-7.8
  **异常处理**: 8.1-8.6
  **集成接口**: 9.5-9.6

### P2 - 增强功能（可选实现，16项）

  **特殊物料**: 6.9-6.12
  **异常处理**: 8.7-8.8
  **监控运维**: 10.1-10.4

---

## 附录C：SRS章节映射

| 功能模块 | SRS章节 | 页码范围 |
| --- | --- | --- |
| 系统基础能力 | 2.1-2.3 | 第42-76行 |
| 收货入库执行 | 3.2 | 第157-192行 |
| 装箱作业协调 | 3.3.1 | 第199-234行 |
| 存储与库存管理 | 3.3.2, 3.4.1 | 第236-275行, 第280-364行 |
| 生产发料协调 | 3.3.3 | 第260-273行 |
| 特殊物料处理 | 3.5 | 第441-511行 |
| 退料闭环处理 | 3.6 | 第514-609行 |
| 异常处理 | 3.7 | 第612-700行 |
| 系统集成接口 | 3.8, 4.1-4.2 | 第703-823行 |
| 监控与运维 | 5 | 第826-832行 |

---

## 附录D：术语表

| 术语 | 英文 | 定义 |
| ---- | --- | --- |
| WES  | Warehouse Execution System | 仓储执行系统，本项目核心系统 |
| GRN  | Goods Receipt Note | 收货通知单，SAP下发并由现有WMS转发的入库单据 |
| PKG  | Package Code | 六合一码，包含料号、数量、批次、日期、供应商、序列号 |
| CTU  | Container Transfer Unit | 料箱转运单元，五层货架的料箱搬运机器人 |
| RCS  | Robot Control System | 机器人控制系统，AGV调度系统 |
| ECS  | Equipment Control System | 设备控制系统，机械臂和流水线控制 |
| QMS  | Quality Management System  | 质量管理系统，IQC检验系统 |
| SFC  | Shop Floor Control | 车间控制系统，生产追溯系统 |
| MSD  | Moisture Sensitive Device  | 湿度敏感器件，需要特殊存储 |
| FEFO | First Expire First Out | 先到期先出，发料策略 |
| DC | Date Code | 日期码，物料生产日期 |
| LC | Lot Code | 批次码，物料批次号 |

---

## 附录E：变更记录

| 版本 | 日期 | 变更内容 | 变更人 |
| ---- | --- | --- | --- |
| 1.0  | 2025-12-15 | 初始版本，基于SRS v2.0创建 | Claude |

---

## 文档审批

| 角色 | 姓名 | 签名 | 日期 |
| --- | ---- | ---- | ---- |
| 项目经理 | | | |
| 技术负责人 | | | |
| 客户代表 | | | |
| 质量负责人 | | | |

---

  **文档结束**
