kaizhoumasha/fxn_wms/docs/planning/3.2.2-iqc-routing-review-task-breakdown.md

# 3.2.2 IQC 动态路由与复判 - 任务分解文档
# Task Breakdown: IQC Dynamic Routing & Review

**文档版本**: v1.0
**创建日期**: 2025-12-22
**基于设计文档**: `docs/design/3.2.2-iqc-routing-review.md`
**SRS 参考**: `docs/SRS.md` §3.2.2

---

## 概述 (Overview)

### 功能描述

IQC 动态路由与复判系统是 WMS 的核心质量管理模块,负责从收货暂存区到 IQC 检验、复判、路由分发的完整业务流程。系统采用**拉动式 (Pull)** 工作流设计,由 IQC 人员根据工作负荷和优先级主动呼叫送检,避免 IQC 待检区拥堵。

**关键特性**:
- QMS 集成: 抽检策略查询、检验结果获取
- 人工触发机制: 检验完成和复判完成需人工确认
- 多 GRN 栈板支持: 支持混托场景,一个栈板包含多个 GRN
- 实时状态更新: SignalR 实现 Web 界面实时同步
- 完整追溯: PKG 六合一码全程追溯

### 团队分工

**WMS 团队** (内部 - 2 人):
- **职责**: 全权负责 IQC 阶段的所有业务逻辑和流程控制
- **技术栈**: Blazor Server (前后端统一), ASP.NET Core, Entity Framework Core
- **交付物**:
  - 3 个 Web 界面 (待送检列表、优先级调整、检验完成确认)
  - 4 个 PDA 界面 (取样记录、归还记录、拆板作业、复判完成)
  - QMS 集成服务
  - RCS 调度服务
  - 数据库 schema 和迁移脚本

**QMS 团队** (外部):
- **职责**: 提供抽检策略和检验结果查询接口
- **交付物**: API 契约定义、测试环境、Mock 数据

**RCS 团队** (外部):
- **职责**: 提供 AGV 搬运任务调度接口
- **交付物**: Transport API 文档、测试环境

**硬件供应商** (外部):
- **职责**: 提供 PDA 设备规格和测试支持
- **交付物**: PDA 设备、驱动程序、技术支持

### 估算方法

使用标准 Fibonacci 序列 (1, 2, 3, 5, 8, 13, 21) 进行故事点估算:
- **1 点**: 极简单 (单一 CRUD,无业务逻辑)
- **2 点**: 简单 (基础表单,简单验证)
- **3 点**: 中等 (多步骤流程,中等验证)
- **5 点**: 复杂 (复杂业务规则,多集成点)
- **8 点**: 很复杂 (复杂工作流,状态机)
- **13 点**: 史诗级 (应拆分为多个故事)

### 总体规模

- **Epic 数量**: 6 个
- **User Story 数量**: 31 个
- **总故事点**: 131 点
- **预估工期**: 5 个 Sprint (10 周)
- **团队配置**: 2 人 (Dev1: 后端+集成, Dev2: 前端+UI)

---

## 按团队分组视图 (Team-Based View)

### WMS 团队工作范围 (131 故事点)

| Epic | 用户故事 | 故事点 | 优先级 | 依赖 |
|---|---|---|---|---|
| **E1: QMS 集成与抽检策略** | | **21** | P0 | 无 |
| | US-E1-01: QMS API 集成 | 5 | P0 | - |
| | US-E1-02: 抽检策略计算 | 3 | P0 | E1-01 |
| | US-E1-03: 待送检列表生成 | 5 | P0 | E1-02 |
| | US-E1-04: 拉动式工作流 | 8 | P0 | E1-03 |
| **E2: IQC 检验管理** | | **34** | P0 | E1 |
| | US-E2-01: IQC 呼叫机制 | 8 | P0 | E1 |
| | US-E2-02: 优先级调整 | 3 | P0 | E2-01 |
| | US-E2-03: 取样记录 PDA | 5 | P0 | E2-01 |
| | US-E2-04: 归还记录 PDA | 5 | P0 | E2-03 |
| | US-E2-05: 检验完成确认 | 13 | P0 | E2-04 |
| **E3: 路由与复判处理** | | **21** | P0 | E2 |
| | US-E3-01: 检验结果路由 | 8 | P0 | E2-05 |
| | US-E3-02: 复判结果处理 | 8 | P0 | E3-01 |
| | US-E3-03: 复判完成 PDA | 5 | P0 | E3-02 |
| **E4: 栈板操作与不良品处理** | | **13** | P1 | E3 |
| | US-E4-01: 栈板拆分 PDA | 8 | P1 | E3 |
| | US-E4-02: 不良品处理 | 5 | P1 | E4-01 |
| **E5: Web 界面开发** | | **21** | P0 | E1, E2, E3 |
| | US-E5-01: 待送检列表页面 | 8 | P0 | E1 |
| | US-E5-02: 优先级调整对话框 | 3 | P0 | E2-02 |
| | US-E5-03: 检验完成页面 | 8 | P0 | E2-05 |
| | US-E5-04: 复判处理页面 | 2 | P0 | E3-02 |
| **E6: PDA 界面开发** | | **21** | P0 | E2, E3, E4 |
| | US-E6-01: 取样记录界面 | 5 | P0 | E2-03 |
| | US-E6-02: 归还记录界面 | 5 | P0 | E2-04 |
| | US-E6-03: 拆板作业界面 | 8 | P0 | E4-01 |
| | US-E6-04: 复判完成界面 | 3 | P0 | E3-03 |

### 外部团队协助范围

**QMS 团队**:
- API 契约定义 (Week 1)
- 测试环境搭建 (Week 1-2)
- Mock 数据提供 (Week 2)
- 联调支持 (Week 3-6)

**RCS 团队**:
- Transport API 文档 (Week 1)
- 测试环境访问 (Week 3)
- 联调支持 (Week 3-4)

**硬件供应商**:
- PDA 设备规格 (Week 1)
- 设备提供 (Week 7)
- 现场测试支持 (Week 7-8)

### 团队协作接口

**WMS ↔ QMS**:
- 抽检策略查询: `POST /api/qms/sampling/query`
- 检验结果查询: `GET /api/qms/inspection/result/{grn}`
- 复判结果查询: `GET /api/qms/review/result/{grn}`

**WMS ↔ RCS**:
- 创建搬运任务: `POST /api/rcs/transport/create`
- 查询任务状态: `GET /api/rcs/transport/status/{taskId}`
- 任务完成回调: `POST /api/wms/transport/callback`

**WMS ↔ PDA**:
- PDA 仅连接 WMS,通过 Blazor Server SignalR 通信
- 无需额外 API,使用统一的 Blazor 组件

---

## Epic 汇总 (Epic Summary)

| Epic ID | Epic 名称 | 负责团队 | 故事点 | 优先级 | 依赖 |
|---|---|---|---|---|---|
| E1 | QMS 集成与抽检策略 | WMS | 21 | P0 | 无 |
| E2 | IQC 检验管理 | WMS | 34 | P0 | E1 |
| E3 | 路由与复判处理 | WMS | 21 | P0 | E2 |
| E4 | 栈板操作与不良品处理 | WMS | 13 | P0 | E3 |
| E5 | Web 界面开发 | WMS | 21 | P0 | E1, E2 |
| E6 | PDA 界面开发 | WMS | 21 | P0 | E2, E3, E4 |

**总计**: 131 故事点

---

## Epic 1: QMS 集成与抽检策略

**负责团队**: WMS
**总故事点**: 21
**优先级**: P0 (关键路径)
**依赖**: 无

**Epic 描述**:
建立 WMS 与 QMS 系统的集成接口,实现抽检策略查询和待送检任务管理。采用拉动式工作流设计,由 IQC 人员主动呼叫送检,避免 IQC 待检区拥堵。

### 用户故事 (User Stories)

#### US-E1-01: QMS 抽检策略 API 集成

**作为** WMS 系统
**我想要** 调用 QMS 接口查询抽检策略
**以便** 根据物料、供应商、数量等因素确定抽检量

**验收标准** (Acceptance Criteria):
- [ ] 实现 QMS API 客户端,支持 HTTP/REST 调用
- [ ] 推送 GRN 数据给 QMS: `POST /api/qms/sampling/query`
- [ ] 接收 QMS 返回的抽检量和抽检类型
- [ ] 实现重试机制: 3 次重试,10 秒超时
- [ ] 实现错误处理: 网络异常、超时、QMS 返回错误
- [ ] 记录 API 调用日志: 请求参数、响应结果、耗时
- [ ] 支持幂等性: 使用 `grn_number` 作为幂等键
- [ ] 单元测试覆盖率 ≥ 80%

**技术要点**:
- ASP.NET Core HttpClient with Polly (重试策略)
- 配置化 QMS API 地址: `appsettings.json`
- 结构化日志: Serilog
- 异常处理: 自定义 `QmsIntegrationException`

**详细设计参考**: [@docs/design/3.2.2-iqc-routing-review.md §3.1 QMS 抽检策略查询](../docs/design/3.2.2-iqc-routing-review.md#1-qms-抽检策略查询-sampling-strategy-query--owner-wms--qms)

**故事点**: **5**
**估算理由**: 外部系统集成,需要处理网络异常、重试、超时等复杂场景

---

#### US-E1-02: 抽检策略业务逻辑

**作为** WMS 系统
**我想要** 根据 QMS 返回的抽检量生成 IQC 送检任务
**以便** 管理需要检验的 GRN 列表

**验收标准** (Acceptance Criteria):
- [ ] 接收 QMS 抽检量后,生成待送检任务记录
- [ ] 若 `sampling_qty > 0`,创建 `Pending_Inspection_Task` 记录
- [ ] 若 `sampling_qty = 0`,标记 GRN 为免检,直接进入装箱流程
- [ ] 设置默认优先级为 5
- [ ] 任务状态初始化为 `PENDING_CALL`
- [ ] 查询 GRN 分布的栈板列表 (位置、数量)
- [ ] 记录任务创建时间和创建人
- [ ] 单元测试覆盖免检和需检两种场景

**技术要点**:
- Entity Framework Core: `PendingInspectionTask` 实体
- 业务服务: `IqcInspectionService`
- 状态枚举: `InspectionStatus` (PENDING_CALL, IN_TRANSIT, AT_IQC_AREA, etc.)
- 数据库事务: 确保任务创建和 GRN 状态更新的原子性

**详细设计参考**: [@docs/design/3.2.2-iqc-routing-review.md §3.2 IQC 待送检列表生成](../docs/design/3.2.2-iqc-routing-review.md#2-iqc-待送检列表生成-iqc-pending-inspection-list--owner-wms)

**故事点**: **3**
**估算理由**: 中等复杂度的业务逻辑,涉及数据库操作和状态管理

---

#### US-E1-03: 待送检列表查询与展示

**作为** IQC 人员
**我想要** 查看待送检 GRN 列表
**以便** 了解当前需要检验的物料情况

**验收标准** (Acceptance Criteria):
- [ ] 查询所有 `PENDING_CALL` 状态的待送检任务
- [ ] 按优先级降序、创建时间升序排序
- [ ] 显示 GRN 号、料号、总数量、栈板数量、优先级、等待时长、状态
- [ ] 支持筛选: GRN 号、料号、状态、优先级、等待时长
- [ ] 点击栈板数量,展开显示该 GRN 分布的所有栈板 (位置、数量、状态)
- [ ] 实时显示 IQC 待检区容量 (如: 3/10 个栈板)
- [ ] 高优先级提醒: 优先级 ≥ 8 且等待 > 1 小时 → 红色横幅
- [ ] 长时间等待提醒: 等待 > 4 小时 → 发送通知给 IQC 主管

**技术要点**:
- Blazor Server 组件: `IqcPendingInspectionList.razor`
- SignalR Hub: 实时推送状态更新
- 查询服务: `IqcQueryService` with LINQ
- 通知服务: `NotificationService` (邮件/短信)

**详细设计参考**: [@docs/design/3.2.2-iqc-routing-review.md §8.1 IQC 待送检列表页面](../docs/design/3.2.2-iqc-routing-review.md#1-iqc-待送检列表页面-iqc-pending-inspection-list-page)

**故事点**: **5**
**估算理由**: 复杂的 UI 组件,包含筛选、排序、实时更新、提醒机制

---

#### US-E1-04: IQC 人员呼叫送检 (拉动式工作流)

**作为** IQC 人员
**我想要** 主动选择并呼叫栈板送检
**以便** 根据工作负荷和优先级灵活安排检验任务

**验收标准** (Acceptance Criteria):
- [ ] 支持单选或多选 GRN 进行呼叫
- [ ] 点击"呼叫送检"后,弹出栈板选择对话框
- [ ] 显示该 GRN 分布的所有栈板 (位置、数量、状态)
- [ ] 实时显示 IQC 待检区容量变化 (如: 3/10 → 5/10)
- [ ] 选择栈板后,显示确认对话框: 已选栈板、预计到达时间、容量变化
- [ ] 确认后,生成 `TransportTask` 记录
- [ ] 调用 RCS API 创建搬运任务: `POST /api/rcs/transport/create`
- [ ] 更新任务状态为 `IN_TRANSIT`
- [ ] 容量满载时 (10/10),禁用呼叫按钮
- [ ] 记录呼叫人和呼叫时间
- [ ] 单元测试覆盖容量检查、RCS 调用失败等场景

**技术要点**:
- Blazor 对话框组件: `PalletSelectionDialog.razor`
- RCS 集成服务: `RcsTransportService`
- 容量管理: `IqcCapacityManager`
- 事务处理: 确保任务创建和 RCS 调用的一致性

**详细设计参考**: [@docs/design/3.2.2-iqc-routing-review.md §3.2.1 IQC 人员呼叫送检](../docs/design/3.2.2-iqc-routing-review.md#21-iqc-人员呼叫送检-iqc-call-for-inspection--owner-wms-web--iqc-人员)

**故事点**: **8**
**估算理由**: 复杂的交互流程,包含对话框、容量检查、RCS 集成、事务处理

---

## Epic 2: IQC 检验管理

**负责团队**: WMS
**总故事点**: 34
**优先级**: P0
**依赖**: Epic 1

**Epic 描述**:
实现 IQC 检验的完整流程管理,包括优先级调整、取样记录、归还记录和检验完成确认。支持多 GRN 栈板场景,确保样品追溯和状态管理的准确性。

### 用户故事 (User Stories)

#### US-E2-01: 送检优先级调整

**作为** IQC 主管
**我想要** 手动调整待送检 GRN 的优先级
**以便** 优先处理急料或重要物料

**验收标准**:
- [ ] 在待送检列表页面选择 GRN,点击"调整优先级"
- [ ] 弹出对话框,显示当前优先级,输入新优先级 (1-10)
- [ ] 输入调整原因 (必填,至少 10 个字符)
- [ ] 保存后更新数据库,重新排序列表
- [ ] 记录审计日志: 操作人、时间、原因、旧值、新值
- [ ] 单元测试覆盖优先级范围验证

**技术要点**:
- Blazor 对话框: `PriorityAdjustmentDialog.razor`
- 审计日志: `PriorityAdjustmentLog` 实体
- 验证: FluentValidation

**详细设计参考**: [@docs/design/3.2.2-iqc-routing-review.md §3.3 优先级调整](../docs/design/3.2.2-iqc-routing-review.md#3-送检优先级调整-priority-adjustment--owner-wms-web)

**故事点**: **3**
**估算理由**: 简单的 CRUD 操作,带审计日志

---

#### US-E2-02: IQC 取样记录 (PDA)

**作为** IQC 作业员
**我想要** 使用 PDA 记录取样信息
**以便** 追溯样品来源和检验过程

**验收标准**:
- [ ] PDA 扫描栈板号,显示该栈板关联的 GRN 列表
- [ ] 支持混托: 一个栈板包含多个 GRN,作业员选择要取样的 GRN
- [ ] 扫描 PKG 六合一码 (料号、数量、料盘码、LC、DC、供应商码)
- [ ] 解析 PKG 码,提取料号、数量、批次等信息
- [ ] 保存取样记录: `SamplingRecord` (sampling_id, pallet_id, grn_number, pkg_code, sampled_by, sampled_at)
- [ ] PDA 显示"取样记录成功",蜂鸣器响一声
- [ ] 支持连续扫描多个料盘
- [ ] 单元测试覆盖 PKG 码解析逻辑

**技术要点**:
- Blazor Server PDA 组件: `IqcSamplingScreen.razor`
- PKG 码解析器: `PkgCodeParser`
- 数据库实体: `SamplingRecord`
- 响应式设计: 适配手持设备屏幕

**详细设计参考**: [@docs/design/3.2.2-iqc-routing-review.md §3.4 IQC 取样记录](../docs/design/3.2.2-iqc-routing-review.md#4-iqc-取样记录-sampling-record--owner-wms-pda), [@docs/design/3.2.2-iqc-routing-review.md §8.4 IQC 取样记录界面](../docs/design/3.2.2-iqc-routing-review.md#4-iqc-取样记录界面-iqc-sampling-screen)

**故事点**: **5**
**估算理由**: 中等复杂度,包含 PKG 码解析、多 GRN 支持、PDA 交互

---

#### US-E2-03: IQC 归还记录 (PDA)

**作为** IQC 作业员
**我想要** 使用 PDA 记录样品归还
**以便** 确保样品回归原栈板

**验收标准**:
- [ ] PDA 扫描 PKG 六合一码
- [ ] 查询取样记录,获取原栈板号
- [ ] 显示原栈板号供作业员核对
- [ ] 扫描栈板号进行核对
- [ ] 校验栈板号是否与原栈板号一致
- [ ] 一致: 更新取样记录状态为 `RETURNED`,记录归还时间和归还人
- [ ] 不一致: 显示错误提示,蜂鸣器响三声,要求重新扫描
- [ ] 单元测试覆盖匹配和不匹配场景

**技术要点**:
- Blazor Server PDA 组件: `IqcReturnScreen.razor`
- 查询服务: `SamplingQueryService`
- 状态更新: `SamplingRecord.Status = RETURNED`

**详细设计参考**: [@docs/design/3.2.2-iqc-routing-review.md §3.5 IQC 归还记录](../docs/design/3.2.2-iqc-routing-review.md#5-iqc-归还记录-return-record--owner-wms-pda), [@docs/design/3.2.2-iqc-routing-review.md §8.5 IQC 归还记录界面](../docs/design/3.2.2-iqc-routing-review.md#5-iqc-归还记录界面-iqc-return-screen)

**故事点**: **5**
**估算理由**: 中等复杂度,包含查询、验证、状态更新

---

#### US-E2-04: IQC 检验完成确认 (人工触发)

**作为** IQC 作业员
**我想要** 确认检验完成并触发路由决策
**以便** 将栈板送往正确的目标区域

**验收标准**:
- [ ] 在 Web 界面或 PDA 选择要完成检验的栈板
- [ ] 查询栈板关联的所有 GRN 及其检验状态 (通过 `PalletGrnBindings` 表)
- [ ] 筛选检验中的 GRN (状态为 `SAMPLING` 或 `INSPECTING`)
- [ ] 校验检验中 GRN 的所有取样记录是否已归还
- [ ] 未归还: 显示错误提示,列出未归还的 GRN
- [ ] 已归还: 批量查询 QMS 获取检验结果
- [ ] QMS 结果未录入: 显示错误提示,列出未录入的 GRN
- [ ] QMS 结果已录入: 根据结果生成路由决策
- [ ] 全部 OK 且无其他未检 GRN: 生成送收货暂存区任务
- [ ] 任意 NG 且无其他未检 GRN: 生成送待复判区任务,并查询收货暂存区中包含 NG GRN 的其他栈板,一并送待复判区
- [ ] OK 和 NG 混合: 提示需要拆板处理
- [ ] 有其他未检 GRN: 更新检验中 GRN 状态,但不移动栈板
- [ ] 调用 RCS API 执行搬运任务
- [ ] 更新栈板和 GRN 状态
- [ ] 记录完成人和完成时间
- [ ] 兜底机制: 定时任务 (30 分钟) 自动检测并触发完成流程
- [ ] 单元测试覆盖所有路由场景

**技术要点**:
- 复杂业务逻辑: `InspectionCompletionService`
- 多 GRN 状态管理: `PalletGrnBindings` 表
- QMS 批量查询: `QmsInspectionResultService`
- 路由决策引擎: `RoutingDecisionEngine`
- 定时任务: Hangfire 或 Quartz.NET
- 事务处理: 确保状态更新和 RCS 调用的一致性

**详细设计参考**: [@docs/design/3.2.2-iqc-routing-review.md §3.5.1 IQC 检验完成确认](../docs/design/3.2.2-iqc-routing-review.md#51-iqc-检验完成确认-inspection-completion-confirmation--owner-wms-webpda--iqc-人员), [@docs/design/3.2.2-iqc-routing-review.md §8.3.1 IQC 检验完成确认页面](../docs/design/3.2.2-iqc-routing-review.md#31-iqc-检验完成确认页面-iqc-inspection-completion-page)

**故事点**: **13**
**估算理由**: 史诗级复杂度,包含多 GRN 验证、QMS 集成、路由决策、相关栈板处理、兜底机制

---

## Epic 3: 路由与复判处理

**负责团队**: WMS
**总故事点**: 21
**优先级**: P0
**依赖**: Epic 2

**Epic 描述**:
实现检验结果获取、动态路由决策和复判结果处理。根据 QMS 检验结果自动路由栈板到收货暂存区或待复判区,支持复判 OK、NG、挑选三种结果类型。

### 用户故事 (User Stories)

#### US-E3-01: 检验结果获取与路由决策

**作为** WMS 系统
**我想要** 根据 QMS 检验结果自动路由栈板
**以便** 将合格品送收货暂存区,不合格品送待复判区

**验收标准**:
- [ ] 定时查询 QMS 获取检验结果: `GET /api/qms/inspection/result/{grn}`
- [ ] 解析检验结果: OK/NG
- [ ] 路由决策: All OK → 收货暂存区, Any NG → 待复判区
- [ ] 生成 `TransportTask` 记录
- [ ] 调用 RCS API 创建搬运任务
- [ ] 更新栈板位置状态
- [ ] 记录路由决策日志
- [ ] 单元测试覆盖 OK 和 NG 两种场景

**技术要点**:
- QMS 集成: `QmsInspectionResultService`
- 路由引擎: `RoutingDecisionEngine`
- RCS 集成: `RcsTransportService`
- 定时任务: Hangfire

**详细设计参考**: [@docs/design/3.2.2-iqc-routing-review.md §3.6 检验结果获取与路由决策](../docs/design/3.2.2-iqc-routing-review.md#6-检验结果获取与路由决策-inspection-result--routing--owner-wms--qms)

**故事点**: **8**
**估算理由**: 复杂的集成和路由逻辑,包含 QMS 查询、决策引擎、RCS 调度

---
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
