kaizhoumasha/fxn_wms/docs/origin/灿态WMS与RCS已对接清单(20250717).docx

WMS与RCS对接接口文档参考《厂内物流调度控制系统RCS-2000 V3.3 对外任务接口文档.pdf》，部分字段有变更的，以功能清单请求与响应示例中数据为准。

WMS与RCS已对接功能清单如下（以货架和料箱搬运为准）：

功能名称 | 1.下发货架搬运任务单到RCS | WMS => RCS
应用场景 | 1. 普通搬运（含跨楼层搬运）模式，AGV小车搬运货架到达目的地后，小车放下货架，小车自行离开 a) 作业员临时呼叫指定货架到目标位置 b) 作业员临时呼叫指定货架到目标区域 2. 工作台作业模式（多步骤），搬运指定货架到目标工作台（指定货架方向）等待作业，AGV小车搬运货架到达工作台后，小车持续托举货架，搬运任务不结束，等待下一个步骤的调度 a) 系统调度从库区搬运指定货架到目标工作台 b) 系统调度工作台前的货架进行旋转（切换货架方向），旋转后返回工作台继续作业 c) 系统调度搬运工作台前的货架到另一个工作台 d) 系统调度搬运工作台前的货架返回库区 3. 料箱搬运模式，搬运指定的料箱到达指定仓位 a) 系统调度搬运库区的指定料箱到达滚筒线入口仓位 i. 背篓车将料箱投入滚筒线入口（由RCS与滚筒线联动实现） ii. 料箱在滚筒线流转进行作业，作业完成后料箱流入滚筒线出口位置 b) 系统调度从滚筒线出口仓位将指定料箱搬运回库区 i. WMS派发料箱回库搬运任务（WMS监听滚筒线出口位置的摄像头） ii. 背篓车从滚筒线出口搬出料箱（由RCS与滚筒线联动实现） iii. 背篓车将料箱搬运回库区指定仓位
RCS接口名称 | genAgvSchedulingTask
请求网址 | http://10.157.10.10:8182/rcms/services/rest/hikRpcService/genAgvSchedulingTask
请求示例 | {"agvCode":null,"taskCode":"3E94305EB994406A9405EDA53A76C762","taskTyp":"CK02","ctnrTyp":null,"ctnrCode":null,"wbCode":null,"positionCodePath":[{"positionCode":"410069","type":"03"},{"positionCode":"RK1501","type":"00"}],"podCode":"410069","podDir":"0","podTyp":null,"materialLot":null,"priority":"9","data":"WMS_SHELF_MOVE_TASK","reqCode":"d045749bb47c4dc1acad3a0a856979ac","reqTime":"2021-12-29 10:33:15","clientCode":"MES-1-1","tokenCode":null}
响应示例 | {"code":"0","message":"成功","reqCode":"d045749bb47c4dc1acad3a0a856979ac","data":"3E94305EB994406A9405EDA53A76C762"}
功能名称 | 2.继续执行已经下发的货架搬运任务 | WMS => RCS
应用场景 | 1. 当搬运任务存在多个搬运步骤时，开始搬运任务的下一个搬运步骤 a) 工作台作业模式中，作业人员扫码作业完成后，系统调度执行货架搬运任务的下一个搬运步骤
RCS接口名称 | continueTask
请求网址 | http://10.157.10.10:8182/rcms/services/rest/hikRpcService/continueTask
请求示例 | {"agvCode":null,"taskCode":"630EFBC79D8346D49658A73633438914","wbCode":null,"podCode":null,"taskSeq":"2","nextPositionCode":{"positionCode":"RK1501","type":"00"},"reqCode":"4d60cb2dfcb940ebb6484b6a5cf34964","reqTime":"2021-12-29 10:33:14","clientCode":"MES-1-1","tokenCode":null}
响应示例 | {"code":"0","message":"成功","reqCode":"4d60cb2dfcb940ebb6484b6a5cf34964","data":""}
功能名称 | 3.取消已经下发的货架搬运任务 | WMS => RCS
应用场景 | 1. 当搬运任务需要取消时，调用以取消搬运 a) 取消后AGV小车将货架直接放地上 b) 取消后AGV小车仍然背着货架，将货架搬回指定的回库区域中
RCS接口名称 | cancelTask
请求网址 | http://10.157.10.10:8182/rcms/services/rest/hikRpcService/cancelTask
请求示例 | {"reqCode": "4d60cb2dfcb940ebb6484b6a5cf34910", "reqTime": "2021-12-29 10:33:15", "clientCode": " MES-1-1", "tokenCode": "", "forceCancel": "1", "matterArea": "abc", "agvCode": "", "taskCode": "630EFBC79D8346D49658A73633438914"}
响应示例 | {"code":"0","message":"成功","reqCode":"4d60cb2dfcb940ebb6484b6a5cf34910","data":""}
功能名称 | 4.调整已下发的货架搬运任务的优先级 | WMS => RCS
应用场景 | 1. 当搬运任务需要调整执行优先级时，调用以调整优先级
RCS接口名称 | setTaskPriority
请求网址 | http://10.157.10.10:8182/rcms/services/rest/hikRpcService/setTaskPriority
请求示例 | {"reqCode": "4d60cb2dfcb940ebb6484b6a5cf34911", "reqTime": "2021-12-29 10:33:16", "clientCode": " MES-1-1", "tokenCode": "", "priorities": [{"priority": "1", "taskCode": "630EFBC79D8346D49658A73633438914"}]}
响应示例 | {"code":"0","message":"成功","reqCode":"4d60cb2dfcb940ebb6484b6a5cf34911","data":""}
功能名称 | 5.查询搬运任务单的状态 | WMS => RCS
应用场景 | 1. 查询指定搬运任务的当前状态 a) 定时同步搬运任务的当前状态时调用 b) 更新指定搬运任务的当前状态时调用
RCS接口名称 | queryTaskStatus
请求网址 | http://10.157.10.10:8182/rcms/services/rest/hikRpcService/queryTaskStatus
请求示例 | {"taskCodes":["630EFBC79D8346D49658A73633438914"],"agvCode":null,"reqCode":"d193f7ce1b0c4026a57e72c49768bf05","reqTime":"2025-07-07 10:15:26","clientCode":"MES-1-1","tokenCode":null}
响应示例 | {"code":"0","message":"RCS: 成功","reqCode":"d193f7ce1b0c4026a57e72c49768bf05","data":[{"agvCode":"3459","taskCode":"630EFBC79D8346D49658A73633438914","taskStatus":"2","taskTyp":"厂内电梯主任务"}]}
功能名称 | 6.货架与位置绑定、解绑 | WMS=> RCS
应用场景 | 1. 将货架与地图上的位置绑定 a) 人工推动货架到某个库位位置时使用 b) 货架与地图位置的绑定关系丢失时使用 2. 将货架与地图上的位置解绑 a) 人工推开货架到非库位位置时使用 b) 货架需要维修或货架不可用时使用
RCS接口名称 | bindPodAndBerth
请求网址 | http://10.157.10.10:8182/rcms/services/rest/hikRpcService/bindPodAndBerth
请求示例 | {"podCode":"510007","positionCode":"200000CC204370","podDir":null,"indBind":"0","reqCode":"d07acc857fcf44609951c18ccd77e1fd","reqTime":"2021-12-29 10:54:47","clientCode":"MES-1-1","tokenCode":null}
响应示例 | {"code":"0","message":"成功","reqCode":"d07acc857fcf44609951c18ccd77e1fd","data":""}
功能名称 | 7.查询货架储位与物料批次关系 | WMS=> RCS
应用场景 | 1. 查询指定地图上的所有已绑定的货架位置 a) 同步地图上的所有货架时调用 2. 查询指定货架的当前位置 a) 更新指定货架的当前位置时调用
RCS接口名称 | queryPodBerthAndMat
请求网址 | http://10.157.10.10:8182/rcms/services/rest/hikRpcService/queryPodBerthAndMat
请求示例 | {"podCode":null,"materialLot":null,"positionCode":null,"areaCode":null,"mapShortName":"N-F20-1.5F","reqCode":"ad48b0c6b09742bfb551ac5704b56249","reqTime":"2021-12-29 10:54:05","clientCode":"MES-1-1","tokenCode":null}
响应示例 | {"code":"0","message":"成功","reqCode":"ad48b0c6b09742bfb551ac5704b56249","data":[{"areaCode":"YWL1501","mapDataCode":"045675AA060440","materialLot":"","podCode":"410125","posCode":"1509","positionCode":"1509"}]}
功能名称 | 8.地图位置信息同步 | WMS=> RCS
应用场景 | 1. 查询指定地图上的所有可用位置信息 a) 同步地图位置时调用，包含位置的编号、关联区域、类型、坐标点位等信息
RCS接口名称 | syncMapDatas
请求网址 | http://10.157.10.10:8182/rcms/services/rest/hikRpcService/syncMapDatas
请求示例 | {"mapDataCode":null,"mapShortName":"N-F20-3F","dataTyp":null,"reqCode":"86aef17763c7495d8e901bf4345dbb67","reqTime":"2021-12-29 10:56:36","clientCode":"MES-1-1","tokenCode":null}
响应示例 | {"code":"0","message":"成功","reqCode":"86aef17763c7495d8e901bf4345dbb67","data":[{"areaCode":"T23D","berthType":"3","cooX":"260396.0","cooY":"218128.0","dataTyp":"1","direction":"","linkedCode":"","mapCode":"CC","mapDataCode":"260396CC218128","positionCode":"T23D1","userCallCode":"T23D1"}]}
功能名称 | 9.接收RCS任务执行通知 | RCS => WMS
应用场景 | 1. WMS系统开放接口，当RCS系统的搬运任务状态变更时主动调用，将搬运任务的当前状态上报给WMS系统 a) 货架搬运任务开始时（start） b) AGV小车搬运货架离开起始位置之后（outbin） c) AGV小车将货架搬运到达目标工作台时（arrive） d) 货架搬运任务完成时（end） e) 货架搬运任务被取消时（cancel）
WMS接口名称 | agvCallback
请求网址 | http://10.157.10.187:8284/wms/agv/agvCallbackService/agvCallback
请求示例 | {"cooX":"54200.0","cooY":"54662.0","currentPositionCode":"RK1501","data":"\"WMS_SHELF_MOVE_TASK\"","mapCode":"AA","mapDataCode":"054200AA054662","method":"start","podCode":"410125","podDir":"","robotCode":"3521","taskCode":"8317507889E2477FB36284FFF739E2BF","wbCode":"RK1501","reqCode":"17E041343A4Z7II","reqTime":"2021-12-29 10:44:38","clientCode":"","tokenCode":""}
响应示例 | {"code":"0","message":"已接收通知成功，已更新任务进度","reqCode":"17E041343A4Z7II","data":"调用成功"}
功能名称 | 10.告警推送通知 | RCS=>WMS
应用场景 | 1. WMS系统开放接口，当RCS系统发现异常时主动调用，将异常上报给WMS系统 a) AGV小车在执行搬运任务过程中出现异常时调用，包含任务单号、告警内容等信息
WMS接口名称 | warnCallback
请求网址 | http://10.157.10.187:8284/wms/agv/agvCallbackService/warnCallback
请求示例 | { "reqCode": "1541954B96B1112", "reqTime": "", "clientCode": "", "tokenCode": "", "data:": [{ "robotCode": "1001", "beginDate": "2020-04-02 23:12:12", "warnContent": "平台失联", "taskCode": "C002WWQQRR" }, { "robotCode": "1002", "beginDate": "2020-04-02 23:12:12", "warnContent": "导航告警", "taskCode": "C002WWQQRR33" } ] }
响应示例 | {"code":"0","message":"已接收告警成功","reqCode":"17E041BA88AZ82Q","data":"调用成功"}
功能名称 | 11.绑定解绑通知 | RCS=>WMS
应用场景 | 1. WMS系统开放接口，当RCS系统的相关绑定关系变更时，主动将变更的信息上报给WMS系统 a) 货架与位置绑定/解绑时调用，包含货架编号、位置编号、绑定/解绑状态等信息 b) 料箱与仓位绑定/解绑时调用，包含料箱编号、仓位编号、绑定/解绑状态等信息
WMS接口名称 | bindNotify
请求网址 | http://10.157.10.187:8284/wms/agv/agvCallbackService/bindNotify
请求示例 | {"method":"bindPodAndBerth","indBind":"0","bindParam":[{"podCode":"510007","berthCode":"200000CC204370","materialLot":"","ctnrCode":"","ctnrType":"","stgBinCode":""}],"reqCode":"17E041BA88AZ82Q","reqTime":"2021-12-29 10:53:48","clientCode":"","tokenCode":""}
响应示例 | {"code":"0","message":"已接收通知成功","reqCode":"17E041BA88AZ82Q","data":"调用成功"}
功能名称 | 12.料箱与仓位绑定、解绑 | WMS=> RCS
应用场景 | 1. 将料箱与地图上的仓位绑定 a) 人工放置料箱到某个库位仓位时使用 b) 料箱与地图仓位的绑定关系丢失时使用 2. 将料箱与地图上的仓位解绑 a) 人工更换料箱存放仓位时使用 b) 料箱需要维修或料箱不可用时使用
RCS接口名称 | bindCtnrAndBin
请求网址 | http://10.157.10.10:8182/rcms/services/rest/hikRpcService/bindCtnrAndBin
请求示例 | {"ctnrTyp":"1","ctnrCode":"10000","stgBinCode":"10002000","indBind":"0","reqCode":"d07acc857fcf44609951c18ccd881111","reqTime":"2024-12-29 10:54:47","clientCode":"MES-1-1","tokenCode":null}
响应示例 | {"code":"0","message":"成功","reqCode":"d07acc857fcf44609951c18ccd881111","data":""}
