kaizhoumasha/fxn_wms/docs/origin/美國休斯頓Bianca(PG548 UT3.0B) 產品自動組裝線---上蓋供料載盤20251018.STEP

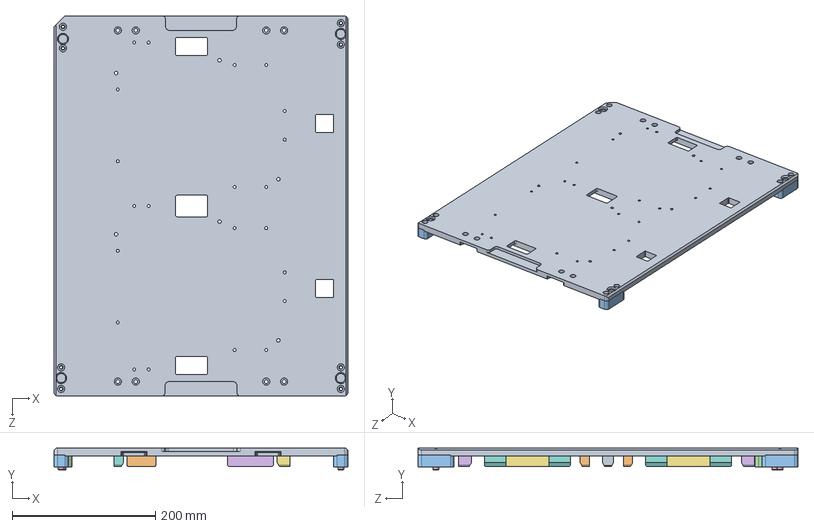
[picture p48: CAD file, 2025-12-09]
docs/origin/美國休斯頓Bianca(PG548 UT3.0B) 產品自動組裝線---上蓋供料載盤20251018.STEP
410.0 x 30.5 x 530.0 mm
HOU-HOU-PG548-01電木盤底板-1-v1
HOU-HOU-PG548-01電木盤擋塊-2-v1 x 2
HOU-HOU-PG548-01電木盤擋塊-6-v1 x 3
HOU-HOU-PG548-01電木盤擋塊-7-v1
HOU-HOU-M5-15柱头螺丝 x 4
HOU-HOU-PG548-01電木盤擋塊-2-1-v1 x 2
HOU-HOU-PG548-01電木盤擋塊-13-v1 x 2
HOU-HOU-PG548-01電木盤擋塊-12-v1 x 2
HOU-HOU-PG548-01電木盤擋塊-3
HOU-HOU-PG548-01電木盤擋塊-4 x 2
