kaizhoumasha/fxn_wms/docs/planning/3.3.3-smt-production-issue-task-breakdown.md

# 3.3.3 SMT 生产发料协调 - 任务分解文档
# Task Breakdown: SMT Production Issue Coordination

**文档版本**: v1.0
**创建日期**: 2025-12-31
**基于设计文档**: `docs/design/3.3.3-smt-production-issue.md`

---

## 概述 (Overview)

**功能描述**: SMT 生产发料协调系统是一个复杂的自动化物料配送系统,涉及 WMS 任务生成、WES 执行协调、ECS 硬件控制、CTU 批量上料、四识别点位集成、退料流水线错误处理等多个子系统的协同工作。

**核心优化策略**:
- **批量操作优化**: 货架预规划、批量调度、批量上料,预期效率提升 40-60%
- **并行操作**: 退货架间转移与五层货架流水线拣料可并行进行
- **实时库存同步**: 每次拣料完成后立即扣减库存,确保数据实时性

**团队分工**:
- **WMS 团队** (内部): 任务生成、货架规划、批量调度、库存管理、人工兜底流程
- **WES 团队** (内部): 任务队列管理、硬件协调、识别点位集成、拣料执行、结果上报
- **硬件供应商** (外部): ECS 设备控制、CTU 批量上料、视觉识别、机械臂操作

**估算方法**: 使用标准 Fibonacci 序列 (1, 2, 3, 5, 8, 13, 21) 进行故事点估算

**总体规模**: 9 个 Epic,共 159 故事点

**团队配置**:
- 团队人数: 2 人
- 生产率: 2 人时/故事点 (纯开发时间)
- 迭代周期: 2 周/Sprint
- 有效工时占比: 65%
- 综合工时系数: 3.0 (开发 + 测试 + 集成)

**团队速率**: 17 故事点/Sprint

**预估工期**: 10 个 Sprint (20 周,约 5 个月)

---

## 按团队分组视图 (Team-Based View)

### WMS 团队工作范围 (35 故事点)

| Epic | 用户故事 | 故事点 | 优先级 | 依赖 |
|---|---|---|---|---|
| **E1: WMS 任务生成与货架规划** | | **19** | P0 | 无 |
| | US-E1-01: 货架预规划算法实现 | 5 | P0 | - |
| | US-E1-02: 物料定位识别功能 | 3 | P0 | - |
| | US-E1-03: 批量货架调度功能 | 5 | P0 | E1-01 |
| | US-E1-04: WMS-WES 任务下发 API | 3 | P0 | E1-01, E1-02 |
| | US-E1-05: 料盘级物料追踪数据模型 | 3 | P0 | - |
| **E9: 异常处理与人工兜底** | | **16** | P0 | E1 |
| | US-E9-01: 异常检测与告警 | 3 | P0 | E1-04 |
| | US-E9-02: 人工介入触发 | 2 | P0 | E9-01 |
| | US-E9-03: PDA 任务分配 | 3 | P0 | E9-02 |
| | US-E9-04: 人工拣料工作流 | 5 | P0 | E9-03 |
| | US-E9-05: 人工完成上报 | 3 | P0 | E9-04 |

**WMS 团队总计**: 35 故事点 (约 2 个 Sprint)

---

### WES 团队工作范围 (124 故事点)

| Epic | 用户故事 | 故事点 | 优先级 | 依赖 |
|---|---|---|---|---|
| **E2: WES 任务队列与编排** | | **16** | P0 | E1 |
| | US-E2-01: 任务接收 API 端点 | 2 | P0 | E1-04 |
| | US-E2-02: 任务队列管理 | 3 | P0 | E2-01 |
| | US-E2-03: 设备状态监控 | 3 | P0 | - |
| | US-E2-04: 并发任务控制 | 3 | P0 | E2-03 |
| | US-E2-05: 任务调度算法 | 5 | P0 | E2-02, E2-04 |
| **E3: CTU 批量上料操作** | | **17** | P0 | E2 |
| | US-E3-01: 批量料箱取出协调 | 3 | P0 | E2-05 |
| | US-E3-02: 顺序料箱放入工作流 | 5 | P0 | E3-01 |
| | US-E3-03: PUT_FINISH 信号协调 | 3 | P0 | E3-02 |
| | US-E3-04: 出料口取料协调 | 3 | P0 | E3-03 |
| | US-E3-05: PICK_FINISH 信号协调 | 3 | P0 | E3-04 |
| **E4: 四识别点位集成** | | **23** | P0 | E2 |
| | US-E4-01: 识别点 1 - 料箱码识别区 | 5 | P0 | E2-05 |
| | US-E4-02: 识别点 2 - 工作位料箱方向识别 | 5 | P0 | E4-01 |
| | US-E4-03: 识别点 3 - 料盘 PKG 码验证 | 5 | P0 | E4-02 |
| | US-E4-04: 识别点 4 - 出料口料箱扫码 | 3 | P0 | E4-03 |
| | US-E4-05: 料箱追踪状态机 | 5 | P0 | E4-01, E4-02, E4-03, E4-04 |
| **E5: 退货架拣料操作** | | **13** | P0 | E2, E4 |
| | US-E5-01: 退货架到位确认 | 2 | P0 | E2-05 |
| | US-E5-02: 夹爪模式转移指令 | 5 | P0 | E5-01, E4-02 |
| | US-E5-03: 竖直放置协调 | 3 | P0 | E5-02 |
| | US-E5-04: 库存更新协调 | 3 | P0 | E5-03 |
| **E6: 流水线拣料操作** | | **24** | P0 | E2, E3, E4 |
| | US-E6-01: 批量上料协调 | 5 | P0 | E3-05 |
| | US-E6-02: 料箱识别与验证 | 3 | P0 | E4-01, E6-01 |
| | US-E6-03: 拣料指令生成（含工作高度） | 5 | P0 | E4-03, E6-02 |
| | US-E6-04: 机械臂吸盘模式拣料 | 5 | P0 | E6-03 |
| | US-E6-05: 实时库存扣减 | 3 | P0 | E6-04 |
| | US-E6-06: 料箱轮转与下一箱处理 | 3 | P0 | E6-05 |
| **E7: 退料流水线错误处理** | | **19** | P0 | E4 |
| | US-E7-01: 错误检测逻辑 | 3 | P0 | E4-05 |
| | US-E7-02: 返回指令下发 | 3 | P0 | E7-01 |
| | US-E7-03: 流水线路径切换 | 3 | P0 | E7-02 |
| | US-E7-04: CTU 返回处理 | 3 | P0 | E7-03 |
| | US-E7-05: 重试机制（最多 3 次） | 5 | P0 | E7-04 |
| | US-E7-06: 错误日志与追踪 | 2 | P0 | E7-05 |
| **E8: 结果上报与库存同步** | | **12** | P0 | E3, E5, E6 |
| | US-E8-01: 实时库存扣减 API | 3 | P0 | E5-04, E6-05 |
| | US-E8-02: 任务完成上报 | 3 | P0 | E8-01 |
| | US-E8-03: 物料完成追踪 | 3 | P0 | E8-02 |
| | US-E8-04: 料盘级完成追踪 | 3 | P0 | E8-03 |

**WES 团队总计**: 124 故事点 (约 8 个 Sprint)

---

### 外部团队协助范围

#### ECS 设备控制系统（硬件供应商）

**提供能力**:
- 流水线控制能力（启停、速度、传感器）
- 视觉识别能力（料箱码、料盘 PKG 码、位置识别）
- 机械臂拣料能力（吸盘模式、夹爪模式）
- 状态上报能力（设备状态、执行结果、异常事件）

**协作模式**:
- Sprint 0: 提供硬件模拟环境和协议文档
- Sprint 4-10: 协议集成测试和问题修复
- 持续: 硬件集成支持和故障排查

#### CTU 批量上料系统（硬件供应商）

**提供能力**:
- 批量料箱取出（从五层货架）
- 顺序料箱放入（到流水线入料口）
- 出料口料箱取出（回库）

**协作模式**:
- Sprint 0: 提供 CTU 模拟环境和协议文档
- Sprint 3-10: CTU 集成测试和性能优化
- 持续: CTU 运维支持和异常处理

---

### 团队协作接口

#### WMS ↔ WES 接口（内部团队协作）

| 接口 | 方向 | 用途 | 关联 Epic |
|---|---|---|---|
| `POST /api/wes/tasks` | WMS → WES | 任务下发 | E1, E2 |
| `POST /api/wms/tasks/{task_id}/complete` | WES → WMS | 完成上报 | E8 |
| `POST /api/wms/inventory/issue` | WES → WMS | 实时库存扣减 | E5, E6, E8 |
| `POST /api/wms/ctu/pickup` | WES → WMS | CTU 回库请求 | E3 |

#### WES ↔ ECS 接口（外部硬件集成）

| 接口 | 方向 | 用途 | 关联 Epic |
|---|---|---|---|
| `POST /api/v1/device/command` | WES → ECS | 设备指令下发 | E3, E5, E6, E7 |
| `POST /api/v1/callback/result` | ECS → WES | 执行结果上报 | E3, E5, E6, E7 |
| `POST /api/v1/callback/event` | ECS → WES | 设备事件上报 | E4, E7 |

#### WMS ↔ RCS/AGV 接口（外部硬件集成）

| 接口 | 方向 | 用途 | 关联 Epic |
|---|---|---|---|
| 货架调度接口 | WMS → RCS | 批量货架调度到 SMT 作业区 | E1 |
| CTU 任务接口 | WMS → RCS | 批量取箱、放箱、回库 | E1, E3 |

---

## Epic 汇总 (Epic Summary)

| Epic ID | Epic 名称 | 负责团队 | 故事点 | 优先级 | 依赖 |
|---|---|---|---|---|---|
| Epic 1 | WMS 任务生成与货架规划 | WMS | 19 | P0 | 无 |
| Epic 2 | WES 任务队列与编排 | WES | 16 | P0 | Epic 1 |
| Epic 3 | CTU 批量上料操作 | WES | 17 | P0 | Epic 2 |
| Epic 4 | 四识别点位集成 | WES | 23 | P0 | Epic 2 |
| Epic 5 | 退货架拣料操作 | WES | 13 | P0 | Epic 2, Epic 4 |
| Epic 6 | 流水线拣料操作 | WES | 24 | P0 | Epic 2, Epic 3, Epic 4 |
| Epic 7 | 退料流水线错误处理 | WES | 19 | P0 | Epic 4 |
| Epic 8 | 结果上报与库存同步 | WES + WMS | 12 | P0 | Epic 3, Epic 5, Epic 6 |
| Epic 9 | 异常处理与人工兜底 | WMS | 16 | P0 | Epic 1 |

**总计**: 159 故事点

---

## Epic 1: WMS 任务生成与货架规划

**负责团队**: WMS 团队
**总故事点**: 19
**优先级**: P0
**依赖**: 无

**Epic 描述**: 实现 WMS 任务生成、货架预规划、物料定位、批量调度等核心功能，为 WES 自动化执行提供基础。核心优化点是货架预规划算法（退料优先 + FIFO）和批量调度，预期减少 AGV 往返次数 60-80%。

### 用户故事 (User Stories)

#### US-E1-01: 货架预规划算法实现

**作为** WMS 系统
**我想要** 实现货架预规划算法（退料优先 + FIFO）
**以便** 在任务开始前识别所有相关货架和料盘位置，减少 AGV 往返次数

**验收标准** (Acceptance Criteria):
- [ ] 实现退料优先逻辑：优先选择退料货架上的物料
- [ ] 实现 FIFO 逻辑：同一物料多个料盘时，按入库时间先进先出
- [ ] 支持跨货架物料识别：一个任务的物料可能分布在多个货架
- [ ] 输出货架清单：包含退料货架和五层货架列表
- [ ] 输出料盘清单：包含 PKG 码、位置、数量信息
- [ ] 处理库存不足场景：部分物料无库存时给出明确提示
- [ ] 性能要求：单个任务规划时间 < 2 秒

**技术要点**:
- C# LINQ 复杂查询（多表关联）
- 退料货架优先级算法
- FIFO 排序逻辑（按入库时间）
- 数据库索引优化（货架、料盒、储位）

**详细设计参考**: [@docs/design/3.3.3-smt-production-issue.md §6.1 WMS 任务生成与下发](../docs/design/3.3.3-smt-production-issue.md#61-wms-任务生成与下发)

**故事点**: **5**
**估算理由**: 复杂业务逻辑，涉及多表关联查询、优先级算法、FIFO 排序，需要性能优化

---

#### US-E1-02: 物料定位识别功能

**作为** WMS 系统
**我想要** 精确定位每种物料的具体料盘位置
**以便** 为 WES 提供准确的拣料指令和位置信息

**验收标准** (Acceptance Criteria):
- [ ] 查询物料所在货架编码
- [ ] 查询物料所在料盒编码
- [ ] 查询物料在料盒内的储位信息
- [ ] 查询料盘 PKG 码（6合1 编码）
- [ ] 查询料盘当前数量
- [ ] 支持同一物料多个料盘的情况
- [ ] 返回料盘叠放高度信息（用于机械臂工作高度计算）
- [ ] 处理料盘不存在或位置异常的情况

**技术要点**:
- SQL Server 多表关联查询
- 库存表、货架表、料盒表、储位表关联
- PKG 码解析逻辑
- 叠放高度计算

**详细设计参考**: [@docs/design/3.3.3-smt-production-issue.md §6.1 WMS 任务生成与下发](../docs/design/3.3.3-smt-production-issue.md#61-wms-任务生成与下发), [@docs/design/3.3.3-smt-production-issue.md §8.1 WMS 数据库表](../docs/design/3.3.3-smt-production-issue.md#81-wes-数据库表postgresql)

**故事点**: **3**
**估算理由**: 中等复杂度的数据库查询，涉及多表关联，但逻辑相对清晰

---

#### US-E1-03: 批量货架调度功能

**作为** WMS 系统
**我想要** 批量调度所有相关货架到 SMT 作业区
**以便** 货架预先到位，消除 AGV 等待时间，实现设备连续作业

**验收标准** (Acceptance Criteria):
- [ ] 调用 RCS API 批量下发货架搬运任务
- [ ] 退料货架调度到货架 A 区（机械臂工作位）
- [ ] 五层货架调度到五层货架工作区（CTU 工作位）
- [ ] 支持优先级设置：工作位 > Buffer 区 > RCS 队列暂停
- [ ] 实现货架到位确认机制
- [ ] 处理 RCS 调度失败场景（超时、拒绝）
- [ ] 支持货架调度状态追踪
- [ ] 记录货架调度日志

**技术要点**:
- RCS API 集成（HTTP REST）
- 批量任务下发逻辑
- 异步任务状态追踪
- 超时重试机制（3 次，10 秒超时）
- 优先级队列管理

**详细设计参考**: [@docs/design/3.3.3-smt-production-issue.md §6.1 WMS 任务生成与下发](../docs/design/3.3.3-smt-production-issue.md#61-wms-任务生成与下发), [@docs/design/3.3.3-smt-production-issue.md §4.2 配置参数](../docs/design/3.3.3-smt-production-issue.md#42-配置参数)

**故事点**: **5**
**估算理由**: 涉及 RCS 集成、批量任务管理、优先级处理、异常处理，复杂度较高

---

#### US-E1-04: WMS-WES 任务下发 API

**作为** WMS 系统
**我想要** 通过 API 将任务下发给 WES
**以便** WES 接收任务并协调硬件执行

**验收标准** (Acceptance Criteria):
- [ ] 实现 `POST /api/wes/tasks` API 调用
- [ ] 请求参数包含：任务 ID、工单号、物料清单（含料盘明细）、货架编码、目标位置
- [ ] 支持一个任务多种物料、一种物料多个料盘的数据结构
- [ ] 实现超时重试机制（3 次，10 秒超时）
- [ ] 处理 WES 返回的接收确认（200 OK）
- [ ] 处理 WES 拒绝场景（4xx/5xx 错误）
- [ ] 记录任务下发日志
- [ ] 更新任务状态为"WES 处理中"

**技术要点**:
- ASP.NET MVC HTTP Client
- JSON 序列化/反序列化
- 超时重试逻辑
- 异常处理和日志记录
- 任务状态管理

**详细设计参考**: [@docs/design/3.3.3-smt-production-issue.md §6.1 WMS 任务生成与下发](../docs/design/3.3.3-smt-production-issue.md#61-wms-任务生成与下发), [@docs/design/3.3.3-smt-production-issue.md §9.1 接口数据字典](../docs/design/3.3.3-smt-production-issue.md#91-接口数据字典)

**故事点**: **3**
**估算理由**: 标准 API 集成，有重试机制，中等复杂度

---

#### US-E1-05: 料盘级物料追踪数据模型

**作为** WMS 系统
**我想要** 建立料盘级物料追踪数据模型
**以便** 支持一个任务多种物料、一种物料多个料盘的复杂场景

**验收标准** (Acceptance Criteria):
- [ ] 创建 `WMS_ProductionIssueTasks` 表（任务主表）
- [ ] 创建 `WMS_ProductionIssueMaterials` 表（任务物料明细表）
- [ ] 创建 `WMS_ProductionIssueTrays` 表（任务料盘明细表）
- [ ] 建立表间外键关系
- [ ] 创建必要的索引（TaskID, MaterialID, PKGCode, Status）
- [ ] 支持料盘状态追踪（PENDING, PICKING, COMPLETED, FAILED）
- [ ] 支持料盘数量追踪（TrayQty 从 PKG 码解析）
- [ ] 编写数据库迁移脚本

**技术要点**:
- SQL Server 表设计
- 外键约束设计
- 索引优化策略
- 数据库迁移脚本（Entity Framework 或 SQL 脚本）

**详细设计参考**: [@docs/design/3.3.3-smt-production-issue.md §8.2 WMS 数据库表](../docs/design/3.3.3-smt-production-issue.md#82-wms-数据库表sql-server)

**故事点**: **3**
**估算理由**: 数据库表设计和迁移，中等复杂度，需要考虑索引和性能

---

## Epic 2: WES 任务队列与编排

**负责团队**: WES 团队
**总故事点**: 16
**优先级**: P0
**依赖**: Epic 1

**Epic 描述**: 实现 WES 任务接收、队列管理、设备状态监控、并发控制、任务调度等核心功能，为硬件执行提供编排能力。

### 用户故事 (User Stories)

#### US-E2-01: 任务接收 API 端点

**作为** WES 系统
**我想要** 提供任务接收 API 端点
**以便** 接收 WMS 下发的任务并返回确认

**验收标准** (Acceptance Criteria):
- [ ] 实现 `POST /api/wes/tasks` API 端点
- [ ] 验证请求参数完整性（任务 ID、工单号、物料清单、货架编码）
- [ ] 验证物料清单数据结构（支持多物料、多料盘）
- [ ] 返回接收确认（200 OK）
- [ ] 处理参数错误场景（400 Bad Request）
- [ ] 记录任务接收日志
- [ ] 支持幂等性（重复请求返回相同结果）

**技术要点**:
- Python FastAPI 路由定义
- Pydantic 数据验证模型
- SQLModel ORM 数据持久化
- 异常处理和日志记录

**详细设计参考**: [@docs/design/3.3.3-smt-production-issue.md §6.2 WES 任务接收与队列管理](../docs/design/3.3.3-smt-production-issue.md#62-wes-任务接收与队列管理)

**故事点**: **2**
**估算理由**: 标准 REST API 端点，使用 FastAPI 框架，简单

---

#### US-E2-02: 任务队列管理

**作为** WES 系统
**我想要** 实现任务队列管理功能
**以便** 按优先级和提交时间排序任务

**验收标准** (Acceptance Criteria):
- [ ] 任务入队时设置状态为 `PENDING`
- [ ] 支持按优先级排序（1-10，10 最高）
- [ ] 同优先级按提交时间排序（FIFO）
- [ ] 支持任务状态查询
- [ ] 支持任务取消操作
- [ ] 记录任务创建时间
- [ ] 实现任务队列持久化（PostgreSQL）

**技术要点**:
- PostgreSQL 任务队列表设计
- 优先级队列算法
- 任务状态机（PENDING, RUNNING, COMPLETED, FAILED）
- SQLModel 查询优化

**详细设计参考**: [@docs/design/3.3.3-smt-production-issue.md §6.2 WES 任务接收与队列管理](../docs/design/3.3.3-smt-production-issue.md#62-wes-任务接收与队列管理), [@docs/design/3.3.3-smt-production-issue.md §8.1 WES 数据库表](../docs/design/3.3.3-smt-production-issue.md#81-wes-数据库表postgresql)

**故事点**: **3**
**估算理由**: 队列管理逻辑，涉及优先级排序、状态管理，中等复杂度

---

#### US-E2-03: 设备状态监控

**作为** WES 系统
**我想要** 监控 ECS 设备状态
**以便** 只向空闲设备分配任务

**验收标准** (Acceptance Criteria):
- [ ] 实现设备状态查询接口（调用 ECS `GET /api/v1/device/status`）
- [ ] 支持设备状态枚举（IDLE, RUNNING, ERROR, OFFLINE）
- [ ] 实现心跳检测机制（30 秒间隔）
- [ ] 处理设备离线场景（超时判定）
- [ ] 记录设备状态变更日志
- [ ] 支持设备状态缓存（Redis）
- [ ] 实现设备故障告警

**技术要点**:
- Python asyncio 异步 HTTP 请求
- Redis 设备状态缓存
- 心跳检测定时任务（APScheduler）
- 设备状态变更事件

**详细设计参考**: [@docs/design/3.3.3-smt-production-issue.md §6.2 WES 任务接收与队列管理](../docs/design/3.3.3-smt-production-issue.md#62-wes-任务接收与队列管理), [@docs/design/3.3.3-smt-production-issue.md §4.2 配置参数](../docs/design/3.3.3-smt-production-issue.md#42-配置参数)

**故事点**: **3**
**估算理由**: 涉及异步 HTTP、心跳检测、Redis 缓存，中等复杂度

---

#### US-E2-04: 并发任务控制

**作为** WES 系统
**我想要** 控制单个设备的并发任务数量
**以便** 避免设备过载（单设备最多 2 个并发任务）

**验收标准** (Acceptance Criteria):
- [ ] 实现并发任务计数器（按设备 ID）
- [ ] 任务分配前检查设备并发数
- [ ] 并发数达到上限时跳过该设备
- [ ] 任务完成后释放并发槽位
- [ ] 支持并发上限配置（默认 2）
- [ ] 记录并发控制日志
- [ ] 处理任务异常终止场景（释放槽位）

**技术要点**:
- Redis 并发计数器（原子操作）
- 分布式锁（Redis）
- 任务完成回调机制
- 异常处理和资源释放

**详细设计参考**: [@docs/design/3.3.3-smt-production-issue.md §6.2 WES 任务接收与队列管理](../docs/design/3.3.3-smt-production-issue.md#62-wes-任务接收与队列管理), [@docs/design/3.3.3-smt-production-issue.md §4.2 配置参数](../docs/design/3.3.3-smt-production-issue.md#42-配置参数)

**故事点**: **3**
**估算理由**: 涉及 Redis 原子操作、分布式锁、并发控制，中等复杂度

---

#### US-E2-05: 任务调度算法

**作为** WES 系统
**我想要** 实现任务调度算法
**以便** 将任务分配给可用的 ECS 设备

**验收标准** (Acceptance Criteria):
- [ ] 按优先级和提交时间从队列取任务
- [ ] 检查设备状态（只选择 IDLE 设备）
- [ ] 检查并发限制（单设备最多 2 个）
- [ ] 分配任务给设备并更新状态为 `RUNNING`
- [ ] 记录任务开始时间
- [ ] 处理无可用设备场景（任务保持 PENDING）
- [ ] 实现调度循环（5 秒间隔）
- [ ] 支持调度策略配置（轮询、负载均衡）

**技术要点**:
- Python asyncio 调度循环
- 任务分配算法（优先级 + FIFO）
- 设备选择策略（轮询、负载均衡）
- 任务状态更新（原子操作）

**详细设计参考**: [@docs/design/3.3.3-smt-production-issue.md §6.2 WES 任务接收与队列管理](../docs/design/3.3.3-smt-production-issue.md#62-wes-任务接收与队列管理)

**故事点**: **5**
**估算理由**: 复杂调度逻辑，涉及优先级、并发控制、设备选择，复杂度较高

---

## Epic 3: CTU 批量上料操作

**负责团队**: WES 团队
**总故事点**: 17
**优先级**: P0
**依赖**: Epic 2

**Epic 描述**: 实现 CTU 批量上料操作，包括批量料箱取出、顺序料箱放入、PUT_FINISH/PICK_FINISH 信号协调、出料口取料等功能，实现效率优化关键点。

### 用户故事 (User Stories)

#### US-E3-01: 批量料箱取出协调

**作为** WES 系统
**我想要** 协调 CTU 批量取出料箱
**以便** 减少 CTU 往返货架的次数，提高上料效率

**验收标准** (Acceptance Criteria):
- [ ] 根据任务清单识别需要取出的料箱列表
- [ ] 调用 WMS 接口请求 CTU 批量取箱（`POST /api/wms/ctu/batch_pickup`）
- [ ] 请求参数包含：货架编码、料箱编码列表、优先级
- [ ] 处理 WMS 返回的 CTU 任务 ID
- [ ] 实现 CTU 任务状态追踪
- [ ] 处理 CTU 取箱失败场景（超时、拒绝）
- [ ] 记录 CTU 批量取箱日志

**技术要点**:
- WMS API 集成（HTTP REST）
- 批量任务协调逻辑
- 异步任务状态追踪
- 超时重试机制

**详细设计参考**: [@docs/design/3.3.3-smt-production-issue.md §6.3.7 操作模式 3：流水线拣料](../docs/design/3.3.3-smt-production-issue.md#637-操作模式-3流水线拣料-picking-from-conveyor)

**故事点**: **3**
**估算理由**: WMS API 集成，批量任务协调，中等复杂度

---

#### US-E3-02: 顺序料箱放入工作流

**作为** WES 系统
**我想要** 协调 CTU 顺序放入料箱到流水线
**以便** 实现批量上料的效率优化

**验收标准** (Acceptance Criteria):
- [ ] CTU 批量取箱完成后，触发顺序放箱流程
- [ ] 按任务清单顺序逐个放箱
- [ ] 每次放箱后发送 PUT_FINISH 信号给 ECS
- [ ] 等待 ECS 确认后再放下一个箱
- [ ] 实现放箱状态机（WAITING, PLACING, PLACED, CONFIRMED）
- [ ] 处理放箱失败场景（CTU 故障、流水线满）
- [ ] 记录放箱流程日志

**技术要点**:
- Python asyncio 状态机
- ECS 信号协调（PUT_FINISH）
- 顺序控制逻辑
- 异常处理和重试

**详细设计参考**: [@docs/design/3.3.3-smt-production-issue.md §6.3.7 操作模式 3：流水线拣料](../docs/design/3.3.3-smt-production-issue.md#637-操作模式-3流水线拣料-picking-from-conveyor), [@docs/design/3.3.3-smt-production-issue.md §4.1 前提条件](../docs/design/3.3.3-smt-production-issue.md#41-前提条件)

**故事点**: **5**
**估算理由**: 复杂状态机，涉及 CTU 协调、ECS 信号、顺序控制，复杂度较高

---

#### US-E3-03: PUT_FINISH 信号协调

**作为** WES 系统
**我想要** 发送 PUT_FINISH 信号给 ECS
**以便** 通知流水线 CTU 已完成放料动作

**验收标准** (Acceptance Criteria):
- [ ] CTU 放箱完成后，立即发送 PUT_FINISH 信号
- [ ] 调用 ECS 接口（`POST /api/v1/device/command`，task_type: PUT_FINISH）
- [ ] 请求参数包含：料箱编码、放箱位置、时间戳
- [ ] 处理 ECS 返回的确认（200 OK）
- [ ] 处理 ECS 拒绝场景（4xx/5xx 错误）
- [ ] 实现超时重试机制（3 次，10 秒超时）
- [ ] 记录信号发送日志

**技术要点**:
- ECS API 集成（标准设备指令接口）
- 信号协调逻辑
- 超时重试机制
- 异常处理

**详细设计参考**: [@docs/design/3.3.3-smt-production-issue.md §6.3.7 操作模式 3：流水线拣料](../docs/design/3.3.3-smt-production-issue.md#637-操作模式-3流水线拣料-picking-from-conveyor), [@docs/design/3.3.3-smt-production-issue.md §4.1 前提条件](../docs/design/3.3.3-smt-production-issue.md#41-前提条件)

**故事点**: **3**
**估算理由**: ECS API 集成，信号协调，中等复杂度

---

#### US-E3-04: 出料口取料协调

**作为** WES 系统
**我想要** 协调 CTU 从出料口取走料箱
**以便** 将完成拣料的料箱回库

**验收标准** (Acceptance Criteria):
- [ ] 接收 ECS 出料口到达事件（`BIN_ARRIVED`）
- [ ] 调用 WMS 接口请求 CTU 回库（`POST /api/wms/ctu/pickup`）
- [ ] 请求参数包含：料箱编码、当前位置、目标货架、目标位置
- [ ] 处理 WMS 返回的 CTU 任务 ID
- [ ] 实现 CTU 回库状态追踪
- [ ] CTU 取走料箱后，发送 PICK_FINISH 信号给 ECS
- [ ] 记录回库流程日志

**技术要点**:
- ECS 事件处理（BIN_ARRIVED）
- WMS API 集成（CTU 回库）
- 异步任务状态追踪
- PICK_FINISH 信号协调

**详细设计参考**: [@docs/design/3.3.3-smt-production-issue.md §6.3.4 识别点 4：出料口料箱扫码](../docs/design/3.3.3-smt-production-issue.md#634-识别点-4出料口料箱扫码-outbound-port-bin-scan), [@docs/design/3.3.3-smt-production-issue.md §6.3.7 操作模式 3：流水线拣料](../docs/design/3.3.3-smt-production-issue.md#637-操作模式-3流水线拣料-picking-from-conveyor)

**故事点**: **3**
**估算理由**: WMS API 集成，事件处理，中等复杂度

---

#### US-E3-05: PICK_FINISH 信号协调

**作为** WES 系统
**我想要** 发送 PICK_FINISH 信号给 ECS
**以便** 通知流水线料箱已被完全取走

**验收标准** (Acceptance Criteria):
- [ ] CTU 取走料箱后，立即发送 PICK_FINISH 信号
- [ ] 调用 ECS 接口（`POST /api/v1/device/command`，task_type: PICK_FINISH）
- [ ] 请求参数包含：料箱编码、取箱位置、时间戳
- [ ] 处理 ECS 返回的确认（200 OK）
- [ ] 处理 ECS 拒绝场景（4xx/5xx 错误）
- [ ] 实现超时重试机制（3 次，10 秒超时）
- [ ] 记录信号发送日志

**技术要点**:
- ECS API 集成（标准设备指令接口）
- 信号协调逻辑
- 超时重试机制
- 异常处理

**详细设计参考**: [@docs/design/3.3.3-smt-production-issue.md §6.3.7 操作模式 3：流水线拣料](../docs/design/3.3.3-smt-production-issue.md#637-操作模式-3流水线拣料-picking-from-conveyor), [@docs/design/3.3.3-smt-production-issue.md §4.1 前提条件](../docs/design/3.3.3-smt-production-issue.md#41-前提条件)

**故事点**: **3**
**估算理由**: ECS API 集成，信号协调，中等复杂度

---

## Epic 4: 四识别点位集成

**负责团队**: WES 团队
**总故事点**: 23
**优先级**: P0
**依赖**: Epic 2

**Epic 描述**: 实现四个识别点位的集成，包括料箱码识别区、工作位料箱方向识别、料盘 PKG 码验证、出料口料箱扫码，以及料箱追踪状态机。

### 用户故事 (User Stories)

#### US-E4-01: 识别点 1 - 料箱码识别区

**作为** WES 系统
**我想要** 处理料箱码识别区的扫码事件
**以便** 决策料箱是否进入工作位

**验收标准** (Acceptance Criteria):
- [ ] 实现 ECS 事件回调接口（`POST /api/v1/callback/event`，event_type: BIN_CODE_SCANNED）
- [ ] 接收料箱码、扫码成功标志、位置信息
- [ ] 查询该料箱是否在当前任务清单中
- [ ] 如果在清单中，下发"进入工作位"指令（CONVEYOR_ACTION: enter_work_position）
- [ ] 如果不在清单中，下发"跳过工作位"指令（CONVEYOR_ACTION: bypass_work_position）
- [ ] 更新料箱追踪状态（entry_recognition_result: pass/return）
- [ ] 记录识别点 1 日志

**技术要点**:
- FastAPI 事件回调接口
- 任务清单查询逻辑
- ECS 指令下发（CONVEYOR_ACTION）
- 料箱追踪状态更新

**详细设计参考**: [@docs/design/3.3.3-smt-production-issue.md §6.3.1 识别点 1：料箱码识别区](../docs/design/3.3.3-smt-production-issue.md#631-识别点-1料箱码识别区-bin-code-recognition-area)

**故事点**: **5**
**估算理由**: 事件处理 + 决策逻辑 + ECS 指令下发，复杂度较高

---

#### US-E4-02: 识别点 2 - 工作位料箱方向识别

**作为** WES 系统
**我想要** 处理工作位料箱方向识别事件
**以便** 生成拣料任务

**验收标准** (Acceptance Criteria):
- [ ] 实现 ECS 事件回调接口（`POST /api/v1/callback/event`，event_type: BIN_ORIENTATION_DETECTED）
- [ ] 接收料箱码、方向（正向/反向）、精确位置信息
- [ ] 根据料箱方向和任务清单生成拣料指令
- [ ] 查询料箱内物料明细和储位信息
- [ ] 生成机械臂操作指令（包含工作高度）
- [ ] 更新料箱追踪状态（orientation, work_position_arrived_at）
- [ ] 记录识别点 2 日志

**技术要点**:
- FastAPI 事件回调接口
- 拣料指令生成逻辑
- 物料明细查询（WMS API）
- 工作高度计算

**详细设计参考**: [@docs/design/3.3.3-smt-production-issue.md §6.3.2 识别点 2：工作位料箱方向识别](../docs/design/3.3.3-smt-production-issue.md#632-识别点-2工作位料箱方向识别-work-position-bin-orientation-recognition)

**故事点**: **5**
**估算理由**: 事件处理 + 拣料指令生成 + 物料查询，复杂度较高

---

#### US-E4-03: 识别点 3 - 料盘 PKG 码验证

**作为** WES 系统
**我想要** 处理料盘 PKG 码扫描事件
**以便** 验证料盘是否正确

**验收标准** (Acceptance Criteria):
- [ ] 实现 ECS 事件回调接口（`POST /api/v1/callback/event`，event_type: TRAY_PKG_SCANNED）
- [ ] 接收料箱码、PKG 码、扫码成功标志、位置信息
- [ ] 验证 PKG 码是否与预期一致
- [ ] 如果验证通过，允许机械臂继续放置到目标位置
- [ ] 如果验证失败，指示机械臂将料盘放回原料箱
- [ ] 记录验证结果到料箱追踪表
- [ ] 记录识别点 3 日志

**技术要点**:
- FastAPI 事件回调接口
- PKG 码验证逻辑
- ECS 指令下发（继续/放回）
- 错误处理和日志记录

**详细设计参考**: [@docs/design/3.3.3-smt-production-issue.md §6.3.3 识别点 3：料盘扫码确认](../docs/design/3.3.3-smt-production-issue.md#633-识别点-3料盘扫码确认-tray-pkg-code-verification)

**故事点**: **5**
**估算理由**: 事件处理 + PKG 码验证 + 错误处理，复杂度较高

---

#### US-E4-04: 识别点 4 - 出料口料箱扫码

**作为** WES 系统
**我想要** 处理出料口料箱扫码事件
**以便** 触发 CTU 回库流程

**验收标准** (Acceptance Criteria):
- [ ] 实现 ECS 事件回调接口（`POST /api/v1/callback/event`，event_type: BIN_ARRIVED）
- [ ] 接收料箱码、位置信息（OUTBOUND_PORT）
- [ ] 调用 WMS 接口请求 CTU 回库（`POST /api/wms/ctu/pickup`）
- [ ] 更新料箱追踪状态（status: completed）
- [ ] 记录料箱完成时间
- [ ] 记录识别点 4 日志

**技术要点**:
- FastAPI 事件回调接口
- WMS API 集成（CTU 回库）
- 料箱追踪状态更新
- 异步任务协调

**详细设计参考**: [@docs/design/3.3.3-smt-production-issue.md §6.3.4 识别点 4：出料口料箱扫码](../docs/design/3.3.3-smt-production-issue.md#634-识别点-4出料口料箱扫码-outbound-port-bin-scan)

**故事点**: **3**
**估算理由**: 事件处理 + WMS API 集成，中等复杂度

---

#### US-E4-05: 料箱追踪状态机

**作为** WES 系统
**我想要** 实现料箱追踪状态机
**以便** 追踪料箱在流水线上的完整生命周期

**验收标准** (Acceptance Criteria):
- [ ] 创建 `smt_bin_tracking` 表（料箱追踪表）
- [ ] 支持识别阶段追踪（entry, platform, work_position）
- [ ] 支持平台扫码状态（pending, scanned, verified, failed）
- [ ] 支持入口识别结果（pass, return, pending）
- [ ] 支持料箱方向记录（正向/反向）
- [ ] 支持任务模式记录（placement, picking_return, picking_conveyor）
- [ ] 支持料箱状态追踪（on_conveyor, at_work_position, returned, completed）
- [ ] 支持错误计数和原因记录
- [ ] 实现状态转换逻辑和验证

**技术要点**:
- PostgreSQL 表设计
- 状态机模式实现
- SQLModel ORM 模型
- 状态转换验证逻辑

**详细设计参考**: [@docs/design/3.3.3-smt-production-issue.md §8.1 WES 数据库表](../docs/design/3.3.3-smt-production-issue.md#81-wes-数据库表postgresql)

**故事点**: **5**
**估算理由**: 复杂状态机设计，涉及多个状态和转换，复杂度较高

---

## Epic 5: 退货架拣料操作

**负责团队**: WES 团队
**总故事点**: 13
**优先级**: P0
**依赖**: Epic 2, Epic 4

**Epic 描述**: 实现退货架拣料操作，包括退货架到位确认、夹爪模式转移指令、竖直放置协调、库存更新等功能。退货架拣料优先处理，无需流水线参与。

### 用户故事 (User Stories)

#### US-E5-01: 退货架到位确认

**作为** WES 系统
**我想要** 接收退货架到位通知
**以便** 触发退货架拣料流程

**验收标准** (Acceptance Criteria):
- [ ] 接收 WMS 的货架到位通知（退货架到达 A 区）
- [ ] 验证货架编码和位置信息
- [ ] 查询该货架上的待拣物料清单
- [ ] 确认退货架上有待拣物料
- [ ] 更新任务状态为"退货架拣料中"
- [ ] 记录货架到位日志

**技术要点**:
- WMS 通知接口（Webhook 或轮询）
- 货架物料查询逻辑
- 任务状态更新

**详细设计参考**: [@docs/design/3.3.3-smt-production-issue.md §6.3.6 操作模式 2：退货架拣料](../docs/design/3.3.3-smt-production-issue.md#636-操作模式-2退货架拣料-picking-from-return-rack)

**故事点**: **2**
**估算理由**: 简单事件处理和查询，简单

---

#### US-E5-02: 夹爪模式转移指令

**作为** WES 系统
**我想要** 生成夹爪模式转移指令
**以便** 机械臂从 A 区退货架夹起料盘，竖直放入 B 区生产货架

**验收标准** (Acceptance Criteria):
- [ ] 生成 PICK 指令（task_type: PICK，mode: gripper）
- [ ] 指令参数包含：源位置（A 区退货架）、目标位置（B 区生产货架）、料盘 PKG 码
- [ ] 指定夹爪模式（gripper mode）和竖直放置要求
- [ ] 下发指令给 ECS（`POST /api/v1/device/command`）
- [ ] 处理 ECS 返回的确认（200 OK）
- [ ] 处理 ECS 拒绝场景（4xx/5xx 错误）
- [ ] 实现超时重试机制（3 次，10 秒超时）
- [ ] 记录指令下发日志

**技术要点**:
- ECS 指令生成逻辑（PICK with gripper mode）
- 源位置和目标位置计算
- ECS API 集成
- 超时重试机制

**详细设计参考**: [@docs/design/3.3.3-smt-production-issue.md §6.3.6 操作模式 2：退货架拣料](../docs/design/3.3.3-smt-production-issue.md#636-操作模式-2退货架拣料-picking-from-return-rack), [@docs/design/3.3.3-smt-production-issue.md §5.3 ECS 硬件能力](../docs/design/3.3.3-smt-production-issue.md#53-ecs-硬件能力)

**故事点**: **5**
**估算理由**: 复杂指令生成，涉及夹爪模式、位置计算、ECS 集成，复杂度较高

---

#### US-E5-03: 竖直放置协调

**作为** WES 系统
**我想要** 协调机械臂竖直放置料盘
**以便** 确保料盘正确放入生产货架

**验收标准** (Acceptance Criteria):
- [ ] 接收 ECS 执行结果回调（`POST /api/v1/callback/result`）
- [ ] 验证执行结果（SUCCESS/FAILED）
- [ ] 如果成功，更新料盘位置信息（从 A 区 → B 区）
- [ ] 如果失败，记录错误原因并触发重试或人工介入
- [ ] 更新任务物料状态
- [ ] 记录竖直放置日志

**技术要点**:
- ECS 结果回调处理
- 料盘位置更新逻辑
- 错误处理和重试机制
- 任务状态更新

**详细设计参考**: [@docs/design/3.3.3-smt-production-issue.md §6.3.6 操作模式 2：退货架拣料](../docs/design/3.3.3-smt-production-issue.md#636-操作模式-2退货架拣料-picking-from-return-rack)

**故事点**: **3**
**估算理由**: 结果处理 + 位置更新 + 错误处理，中等复杂度

---

#### US-E5-04: 库存更新协调

**作为** WES 系统
**我想要** 协调库存更新
**以便** 实时反映料盘位置变化

**验收标准** (Acceptance Criteria):
- [ ] 拣料成功后，调用 WMS 接口更新库存（`POST /api/wms/inventory/issue`）
- [ ] 请求参数包含：料盘 PKG 码、源位置、目标位置、数量
- [ ] 处理 WMS 返回的确认（200 OK）
- [ ] 处理 WMS 拒绝场景（4xx/5xx 错误）
- [ ] 实现超时重试机制（3 次，10 秒超时）
- [ ] 记录库存更新日志

**技术要点**:
- WMS API 集成（库存更新）
- 超时重试机制
- 异常处理和日志记录

**详细设计参考**: [@docs/design/3.3.3-smt-production-issue.md §6.3.6 操作模式 2：退货架拣料](../docs/design/3.3.3-smt-production-issue.md#636-操作模式-2退货架拣料-picking-from-return-rack), [@docs/design/3.3.3-smt-production-issue.md §6.4 WES-WMS 结果上报](../docs/design/3.3.3-smt-production-issue.md#64-wes-wms-结果上报)

**故事点**: **3**
**估算理由**: WMS API 集成，标准接口调用，中等复杂度

---

## Epic 6: 流水线拣料操作

**负责团队**: WES 团队
**总故事点**: 24
**优先级**: P0
**依赖**: Epic 2, Epic 3, Epic 4

**Epic 描述**: 实现流水线拣料操作，包括批量上料协调、料箱识别与验证、拣料指令生成（含工作高度）、机械臂吸盘模式拣料、实时库存扣减、料箱轮转处理等功能。

### 用户故事 (User Stories)

#### US-E6-01: 批量上料协调

**作为** WES 系统
**我想要** 协调 CTU 批量上料
**以便** 实现效率优化（减少 CTU 往返次数 50-70%）

**验收标准** (Acceptance Criteria):
- [ ] 接收五层货架到位通知
- [ ] 查询该货架上的待拣物料清单
- [ ] 生成料箱批量取出清单
- [ ] 调用 CTU 批量取箱接口（通过 WMS）
- [ ] 协调 CTU 顺序放箱到流水线
- [ ] 每次放箱后发送 PUT_FINISH 信号
- [ ] 记录批量上料日志

**技术要点**:
- 货架物料查询逻辑
- CTU 批量协调（通过 WMS API）
- PUT_FINISH 信号协调
- 顺序控制逻辑

**详细设计参考**: [@docs/design/3.3.3-smt-production-issue.md §6.3.7 操作模式 3：流水线拣料](../docs/design/3.3.3-smt-production-issue.md#637-操作模式-3流水线拣料-picking-from-conveyor)

**故事点**: **5**
**估算理由**: 复杂协调逻辑，涉及 CTU 批量操作、信号协调，复杂度较高

---

#### US-E6-02: 料箱识别与验证

**作为** WES 系统
**我想要** 识别和验证料箱
**以便** 确保正确的料箱进入工作位

**验收标准** (Acceptance Criteria):
- [ ] 接收料箱码识别事件（识别点 1）
- [ ] 验证料箱是否在任务清单中
- [ ] 接收料箱方向识别事件（识别点 2）
- [ ] 验证料箱方向是否正确
- [ ] 如果验证失败，触发退料流水线返回
- [ ] 更新料箱追踪状态
- [ ] 记录识别验证日志

**技术要点**:
- 事件处理（识别点 1、2）
- 料箱验证逻辑
- 退料流水线触发
- 料箱追踪状态更新

**详细设计参考**: [@docs/design/3.3.3-smt-production-issue.md §6.3.1 识别点 1](../docs/design/3.3.3-smt-production-issue.md#631-识别点-1料箱码识别区-bin-code-recognition-area), [@docs/design/3.3.3-smt-production-issue.md §6.3.2 识别点 2](../docs/design/3.3.3-smt-production-issue.md#632-识别点-2工作位料箱方向识别-work-position-bin-orientation-recognition)

**故事点**: **3**
**估算理由**: 事件处理 + 验证逻辑，中等复杂度

---

#### US-E6-03: 拣料指令生成（含工作高度）

**作为** WES 系统
**我想要** 生成拣料指令（含工作高度参数）
**以便** 机械臂精确吸取料盘，避免压坏物料

**验收标准** (Acceptance Criteria):
- [ ] 查询料箱内物料明细（PKG 码、储位）
- [ ] 查询储位当前叠放高度
- [ ] 计算机械臂工作高度（working_height）
- [ ] 生成 PICK 指令（task_type: PICK，mode: suction）
- [ ] 指令参数包含：PKG 码、源位置、工作高度、目标位置、数量
- [ ] 下发指令给 ECS（`POST /api/v1/device/command`）
- [ ] 处理 ECS 返回的确认（200 OK）
- [ ] 记录指令下发日志

**技术要点**:
- 物料明细查询（WMS API）
- 叠放高度计算逻辑
- ECS 指令生成（PICK with suction mode）
- ECS API 集成

**详细设计参考**: [@docs/design/3.3.3-smt-production-issue.md §6.3.7 操作模式 3：流水线拣料](../docs/design/3.3.3-smt-production-issue.md#637-操作模式-3流水线拣料-picking-from-conveyor), [@docs/design/3.3.3-smt-production-issue.md §9.1 接口数据字典](../docs/design/3.3.3-smt-production-issue.md#91-接口数据字典)

**故事点**: **5**
**估算理由**: 复杂指令生成，涉及高度计算、物料查询、ECS 集成，复杂度较高

---

#### US-E6-04: 机械臂吸盘模式拣料

**作为** WES 系统
**我想要** 协调机械臂吸盘模式拣料
**以便** 从流水线料箱中吸取料盘，放入生产货架

**验收标准** (Acceptance Criteria):
- [ ] 下发 PICK 指令（吸盘模式）
- [ ] 机械臂吸起料盘 → 放到定位机构
- [ ] 触发料盘 PKG 码扫描（识别点 3）
- [ ] 验证 PKG 码是否匹配
- [ ] 如果匹配，机械臂夹爪放入 B 区生产货架（竖直放置）
- [ ] 如果不匹配，机械臂将料盘放回原料箱
- [ ] 接收 ECS 执行结果回调
- [ ] 记录拣料执行日志

**技术要点**:
- ECS 指令下发（PICK with suction mode）
- PKG 码验证逻辑（识别点 3）
- ECS 结果回调处理
- 错误处理和重试

**详细设计参考**: [@docs/design/3.3.3-smt-production-issue.md §6.3.7 操作模式 3：流水线拣料](../docs/design/3.3.3-smt-production-issue.md#637-操作模式-3流水线拣料-picking-from-conveyor), [@docs/design/3.3.3-smt-production-issue.md §6.3.3 识别点 3](../docs/design/3.3.3-smt-production-issue.md#633-识别点-3料盘扫码确认-tray-pkg-code-verification)

**故事点**: **5**
**估算理由**: 复杂拣料流程，涉及多步骤协调、PKG 验证、错误处理，复杂度较高

---

#### US-E6-05: 实时库存扣减

**作为** WES 系统
**我想要** 实时扣减库存
**以便** 确保库存数据的实时性和准确性

**验收标准** (Acceptance Criteria):
- [ ] 接收 ECS 拣料成功结果
- [ ] 立即调用 WMS 接口扣减库存（`POST /api/wms/inventory/issue`）
- [ ] 请求参数包含：PKG 码、实际数量、源位置、目标位置
- [ ] 处理 WMS 返回的确认（200 OK）
- [ ] 处理 WMS 拒绝场景（库存不足、位置错误）
- [ ] 实现超时重试机制（3 次，10 秒超时）
- [ ] 记录库存扣减日志

**技术要点**:
- WMS API 集成（实时库存扣减）
- 超时重试机制
- 异常处理（库存不足、位置错误）
- 日志记录

**详细设计参考**: [@docs/design/3.3.3-smt-production-issue.md §6.3.7 操作模式 3：流水线拣料](../docs/design/3.3.3-smt-production-issue.md#637-操作模式-3流水线拣料-picking-from-conveyor), [@docs/design/3.3.3-smt-production-issue.md §6.4 WES-WMS 结果上报](../docs/design/3.3.3-smt-production-issue.md#64-wes-wms-结果上报)

**故事点**: **3**
**估算理由**: WMS API 集成，实时扣减逻辑，中等复杂度

---

#### US-E6-06: 料箱轮转与下一箱处理

**作为** WES 系统
**我想要** 协调料箱轮转
**以便** 当前料箱任务完成后，流水线将其移出并移入下一个料箱

**验收标准** (Acceptance Criteria):
- [ ] 检测当前料箱所有拣料任务是否完成
- [ ] 如果完成，下发"移出工作位"指令给 ECS
- [ ] 流水线将当前料箱移向出料口
- [ ] 同时将下一个料箱移入工作位
- [ ] 触发下一个料箱的识别流程（识别点 2）
- [ ] 更新料箱追踪状态
- [ ] 记录料箱轮转日志

**技术要点**:
- 任务完成检测逻辑
- ECS 指令下发（移出/移入）
- 料箱轮转协调
- 料箱追踪状态更新

**详细设计参考**: [@docs/design/3.3.3-smt-production-issue.md §6.3.7 操作模式 3：流水线拣料](../docs/design/3.3.3-smt-production-issue.md#637-操作模式-3流水线拣料-picking-from-conveyor)

**故事点**: **3**
**估算理由**: 轮转协调逻辑，涉及任务检测、ECS 指令，中等复杂度

---

## Epic 7: 退料流水线错误处理

**负责团队**: WES 团队
**总故事点**: 19
**优先级**: P0
**依赖**: Epic 4

**Epic 描述**: 实现退料流水线错误处理，包括错误检测、返回指令下发、流水线路径切换、CTU 返回处理、重试机制、错误日志追踪等功能。

### 用户故事 (User Stories)

#### US-E7-01: 错误检测逻辑

**作为** WES 系统
**我想要** 检测各种错误场景
**以便** 触发退料流水线返回流程

**验收标准** (Acceptance Criteria):
- [ ] 检测入口识别错误（料盒方向错误、无料盒检测）
- [ ] 检测平台扫码错误（PKG 码不匹配、扫码失败）
- [ ] 检测任务异常（料盒不在任务清单中、库位信息错误）
- [ ] 分类错误类型（orientation_error, pkg_mismatch, scan_failed, task_error）
- [ ] 记录错误原因和详细信息
- [ ] 更新料箱追踪状态（error_count, last_error_reason）
- [ ] 记录错误检测日志

**技术要点**:
- 错误分类逻辑
- 错误原因记录
- 料箱追踪状态更新
- 日志记录

**详细设计参考**: [@docs/design/3.3.3-smt-production-issue.md §6.3.8 退料流水线错误处理](../docs/design/3.3.3-smt-production-issue.md#638-退料流水线错误处理-return-conveyor-error-handling)

**故事点**: **3**
**估算理由**: 错误分类和检测逻辑，中等复杂度

---

#### US-E7-02: 返回指令下发

**作为** WES 系统
**我想要** 下发返回指令给 ECS
**以便** 流水线切换至退料路径

**验收标准** (Acceptance Criteria):
- [ ] 生成 CONVEYOR_RETURN 指令
- [ ] 指令参数包含：料箱编码、错误类型、错误原因
- [ ] 下发指令给 ECS（`POST /api/v1/device/command`）
- [ ] 处理 ECS 返回的确认（200 OK）
- [ ] 处理 ECS 拒绝场景（4xx/5xx 错误）
- [ ] 实现超时重试机制（3 次，10 秒超时）
- [ ] 记录返回指令日志

**技术要点**:
- ECS 指令生成（CONVEYOR_RETURN）
- ECS API 集成
- 超时重试机制
- 异常处理

**详细设计参考**: [@docs/design/3.3.3-smt-production-issue.md §6.3.8 退料流水线错误处理](../docs/design/3.3.3-smt-production-issue.md#638-退料流水线错误处理-return-conveyor-error-handling), [@docs/design/3.3.3-smt-production-issue.md §9.1 接口数据字典](../docs/design/3.3.3-smt-production-issue.md#91-接口数据字典)

**故事点**: **3**
**估算理由**: ECS 指令下发，标准接口调用，中等复杂度

---

#### US-E7-03: 流水线路径切换

**作为** WES 系统
**我想要** 协调流水线路径切换
**以便** 料盒通过退料流水线返回五层货架工作区

**验收标准** (Acceptance Criteria):
- [ ] ECS 控制流水线切换至退料路径
- [ ] 料盒通过退料流水线传送
- [ ] 传感器检测料盒到达退料流水线出口
- [ ] 接收 ECS 返回事件（`BIN_RETURNED`）
- [ ] 更新料箱追踪状态（status: returned）
- [ ] 记录路径切换日志

**技术要点**:
- ECS 路径切换协调
- 事件处理（BIN_RETURNED）
- 料箱追踪状态更新
- 日志记录

**详细设计参考**: [@docs/design/3.3.3-smt-production-issue.md §6.3.8 退料流水线错误处理](../docs/design/3.3.3-smt-production-issue.md#638-退料流水线错误处理-return-conveyor-error-handling)

**故事点**: **3**
**估算理由**: 路径切换协调，涉及 ECS 集成和事件处理，中等复杂度

---

#### US-E7-04: CTU 返回处理

**作为** WES 系统
**我想要** 协调 CTU 将错误料盒放回货架
**以便** 完成错误处理流程

**验收标准** (Acceptance Criteria):
- [ ] 接收料盒返回事件（`BIN_RETURNED`）
- [ ] 调用 WMS 接口请求 CTU 回库（`POST /api/wms/ctu/pickup`）
- [ ] 请求参数包含：料箱编码、当前位置（退料流水线出口）、目标货架、目标位置
- [ ] 处理 WMS 返回的 CTU 任务 ID
- [ ] 实现 CTU 回库状态追踪
- [ ] 更新料盒状态为 `ERROR_RETURNED`
- [ ] 记录 CTU 返回日志

**技术要点**:
- WMS API 集成（CTU 回库）
- 异步任务状态追踪
- 料盒状态更新
- 日志记录

**详细设计参考**: [@docs/design/3.3.3-smt-production-issue.md §6.3.8 退料流水线错误处理](../docs/design/3.3.3-smt-production-issue.md#638-退料流水线错误处理-return-conveyor-error-handling)

**故事点**: **3**
**估算理由**: WMS API 集成，CTU 协调，中等复杂度

---

#### US-E7-05: 重试机制（最多 3 次）

**作为** WES 系统
**我想要** 实现重试机制
**以便** 对可重试错误进行自动重试

**验收标准** (Acceptance Criteria):
- [ ] 识别可重试错误（扫码失败）
- [ ] 识别不可重试错误（PKG 码不匹配、料盒方向错误）
- [ ] 实现重试计数器（最多 3 次）
- [ ] 重试次数超限后，标记为 `MANUAL_INTERVENTION_REQUIRED`
- [ ] 重试时更新料箱追踪状态（retry_count）
- [ ] 记录重试日志
- [ ] 创建 `smt_return_conveyor_log` 表记录所有返回事件

**技术要点**:
- 重试逻辑和计数器
- 错误分类（可重试/不可重试）
- 料箱追踪状态更新
- PostgreSQL 表设计（smt_return_conveyor_log）

**详细设计参考**: [@docs/design/3.3.3-smt-production-issue.md §6.3.8 退料流水线错误处理](../docs/design/3.3.3-smt-production-issue.md#638-退料流水线错误处理-return-conveyor-error-handling), [@docs/design/3.3.3-smt-production-issue.md §8.1 WES 数据库表](../docs/design/3.3.3-smt-production-issue.md#81-wes-数据库表postgresql)

**故事点**: **5**
**估算理由**: 复杂重试逻辑，涉及错误分类、计数器、数据库表设计，复杂度较高

---

#### US-E7-06: 错误日志与追踪

**作为** WES 系统
**我想要** 记录和追踪所有错误事件
**以便** 用于后续分析和优化

**验收标准** (Acceptance Criteria):
- [ ] 记录错误详情到 `smt_return_conveyor_log` 表
- [ ] 字段包含：料箱编码、PKG 码、任务 ID、错误类型、错误原因、识别阶段
- [ ] 记录返回发起时间和完成时间
- [ ] 记录重试次数和是否达到最大重试次数
- [ ] 记录处理状态（returning, returned, retry_scheduled, manual_required）
- [ ] 支持错误日志查询和统计
- [ ] 提供错误分析报表接口

**技术要点**:
- PostgreSQL 表设计（smt_return_conveyor_log）
- 日志记录逻辑
- 查询和统计接口
- 报表生成

**详细设计参考**: [@docs/design/3.3.3-smt-production-issue.md §8.1 WES 数据库表](../docs/design/3.3.3-smt-production-issue.md#81-wes-数据库表postgresql)

**故事点**: **2**
**估算理由**: 日志记录和查询，简单

---

## Epic 8: 结果上报与库存同步

**负责团队**: WES 团队 + WMS 团队
**总故事点**: 12
**优先级**: P0
**依赖**: Epic 3, Epic 5, Epic 6

**Epic 描述**: 实现结果上报与库存同步，包括实时库存扣减 API、任务完成上报、物料完成追踪、料盘级完成追踪等功能。

### 用户故事 (User Stories)

#### US-E8-01: 实时库存扣减 API

**作为** WES 系统
**我想要** 调用 WMS 实时库存扣减 API
**以便** 每次拣料完成后立即扣减库存

**验收标准** (Acceptance Criteria):
- [ ] 实现 WMS API 调用（`POST /api/wms/inventory/issue`）
- [ ] 请求参数包含：PKG 码、实际数量、源位置、目标位置
- [ ] 处理 WMS 返回的确认（200 OK）
- [ ] 处理 WMS 拒绝场景（库存不足、位置错误）
- [ ] 实现超时重试机制（3 次，10 秒超时）
- [ ] 记录库存扣减日志
- [ ] 支持批量扣减（多个料盘）

**技术要点**:
- WMS API 集成（实时库存扣减）
- 超时重试机制
- 异常处理（库存不足、位置错误）
- 批量操作支持

**详细设计参考**: [@docs/design/3.3.3-smt-production-issue.md §6.3.7 操作模式 3：流水线拣料](../docs/design/3.3.3-smt-production-issue.md#637-操作模式-3流水线拣料-picking-from-conveyor), [@docs/design/3.3.3-smt-production-issue.md §6.4 WES-WMS 结果上报](../docs/design/3.3.3-smt-production-issue.md#64-wes-wms-结果上报)

**故事点**: **3**
**估算理由**: WMS API 集成，实时扣减逻辑，中等复杂度

---

#### US-E8-02: 任务完成上报

**作为** WES 系统
**我想要** 上报任务完成结果给 WMS
**以便** WMS 更新任务状态和工单进度

**验收标准** (Acceptance Criteria):
- [ ] 检测任务所有物料是否完成
- [ ] 调用 WMS API 上报完成结果（`POST /api/wms/tasks/{task_id}/complete`）
- [ ] 请求参数包含：任务 ID、状态（COMPLETED/FAILED）、物料完成清单、料盘完成清单、完成时间
- [ ] 处理 WMS 返回的确认（200 OK）
- [ ] 处理 WMS 拒绝场景（4xx/5xx 错误）
- [ ] 实现超时重试机制（3 次，10 秒超时）
- [ ] 记录任务完成日志

**技术要点**:
- WMS API 集成（任务完成上报）
- 任务完成检测逻辑
- 超时重试机制
- 异常处理

**详细设计参考**: [@docs/design/3.3.3-smt-production-issue.md §6.4 WES-WMS 结果上报](../docs/design/3.3.3-smt-production-issue.md#64-wes-wms-结果上报), [@docs/design/3.3.3-smt-production-issue.md §9.1 接口数据字典](../docs/design/3.3.3-smt-production-issue.md#91-接口数据字典)

**故事点**: **3**
**估算理由**: WMS API 集成，任务完成逻辑，中等复杂度

---

#### US-E8-03: 物料完成追踪

**作为** WES 系统
**我想要** 追踪每种物料的完成状态
**以便** 支持部分完成场景

**验收标准** (Acceptance Criteria):
- [ ] 更新 `wes_task_materials` 表的完成数量（completed_qty）
- [ ] 更新物料状态（PENDING, RUNNING, COMPLETED, FAILED）
- [ ] 记录物料完成时间
- [ ] 支持部分完成场景（某些料盘失败）
- [ ] 提供物料完成进度查询接口
- [ ] 记录物料完成日志

**技术要点**:
- PostgreSQL 数据更新
- 物料状态管理
- 部分完成逻辑
- 进度查询接口

**详细设计参考**: [@docs/design/3.3.3-smt-production-issue.md §8.1 WES 数据库表](../docs/design/3.3.3-smt-production-issue.md#81-wes-数据库表postgresql)

**故事点**: **3**
**估算理由**: 数据库更新和状态管理，中等复杂度

---

#### US-E8-04: 料盘级完成追踪

**作为** WES 系统
**我想要** 追踪每个料盘的完成状态
**以便** 支持细粒度的完成追踪

**验收标准** (Acceptance Criteria):
- [ ] 更新 `wes_task_trays` 表的料盘状态（PENDING, PICKING, COMPLETED, FAILED）
- [ ] 记录料盘拣取时间（picked_at）
- [ ] 记录料盘完成时间（completed_at）
- [ ] 支持料盘失败场景（记录失败原因）
- [ ] 提供料盘完成进度查询接口
- [ ] 记录料盘完成日志

**技术要点**:
- PostgreSQL 数据更新
- 料盘状态管理
- 失败场景处理
- 进度查询接口

**详细设计参考**: [@docs/design/3.3.3-smt-production-issue.md §8.1 WES 数据库表](../docs/design/3.3.3-smt-production-issue.md#81-wes-数据库表postgresql)

**故事点**: **3**
**估算理由**: 数据库更新和状态管理，中等复杂度

---

## Epic 9: 异常处理与人工兜底

**负责团队**: WMS 团队
**总故事点**: 16
**优先级**: P0
**依赖**: Epic 1

**Epic 描述**: 实现异常处理与人工兜底流程，包括异常检测与告警、人工介入触发、PDA 任务分配、人工拣料工作流、人工完成上报等功能。

### 用户故事 (User Stories)

#### US-E9-01: 异常检测与告警

**作为** WMS 系统
**我想要** 检测异常并发送告警
**以便** 及时通知相关人员处理

**验收标准** (Acceptance Criteria):
- [ ] 接收 WES 的异常通知（拣料失败、设备故障、超时）
- [ ] 分类异常类型（拣料失败、货架到位超时、视觉扫描失败、机械臂故障、设备故障）
- [ ] 生成告警消息（包含异常类型、任务 ID、物料信息、时间戳）
- [ ] 发送告警到监控系统（邮件、短信、企业微信）
- [ ] 记录异常日志
- [ ] 提供异常查询接口

**技术要点**:
- WES 异常通知接口
- 异常分类逻辑
- 告警消息生成
- 监控系统集成（邮件、短信、企业微信）

**详细设计参考**: [@docs/design/3.3.3-smt-production-issue.md §6.5 异常处理与人工兜底](../docs/design/3.3.3-smt-production-issue.md#65-异常处理与人工兜底)

**故事点**: **3**
**估算理由**: 异常检测和告警，涉及监控系统集成，中等复杂度

---

#### US-E9-02: 人工介入触发

**作为** WMS 系统
**我想要** 触发人工介入流程
**以便** 将任务转为人工处理

**验收标准** (Acceptance Criteria):
- [ ] 更新任务状态为"待人工处理"（MANUAL_REQUIRED）
- [ ] 标记需要人工处理的物料和料盘
- [ ] 生成人工任务清单
- [ ] 通知 PDA 操作员（推送通知）
- [ ] 记录人工介入触发日志

**技术要点**:
- 任务状态更新
- 人工任务清单生成
- PDA 推送通知
- 日志记录

**详细设计参考**: [@docs/design/3.3.3-smt-production-issue.md §6.5 异常处理与人工兜底](../docs/design/3.3.3-smt-production-issue.md#65-异常处理与人工兜底)

**故事点**: **2**
**估算理由**: 状态更新和通知，简单

---

#### US-E9-03: PDA 任务分配

**作为** WMS 系统
**我想要** 将任务分配给 PDA 操作员
**以便** 操作员接收任务并执行

**验收标准** (Acceptance Criteria):
- [ ] 生成 PDA 任务（包含任务 ID、物料清单、货架位置、目标位置）
- [ ] 支持任务分配策略（按区域、按操作员）
- [ ] PDA 操作员接收任务通知
- [ ] PDA 操作员确认接收任务
- [ ] 更新任务状态为"人工处理中"
- [ ] 记录任务分配日志

**技术要点**:
- PDA 任务生成逻辑
- 任务分配策略
- PDA 集成（推送通知、任务确认）
- 任务状态更新

**详细设计参考**: [@docs/design/3.3.3-smt-production-issue.md §6.5 异常处理与人工兜底](../docs/design/3.3.3-smt-production-issue.md#65-异常处理与人工兜底)

**故事点**: **3**
**估算理由**: PDA 集成，任务分配逻辑，中等复杂度

---

#### US-E9-04: 人工拣料工作流

**作为** PDA 操作员
**我想要** 通过 PDA 执行人工拣料
**以便** 完成自动化失败的任务

**验收标准** (Acceptance Criteria):
- [ ] PDA 显示任务详情（物料、数量、货架位置、目标位置）
- [ ] PDA 扫码确认货架到位
- [ ] PDA 扫码确认料盘 PKG 码
- [ ] PDA 输入实际拣料数量
- [ ] PDA 扫码确认目标位置
- [ ] PDA 提交拣料完成
- [ ] 支持部分完成场景（数量不足）
- [ ] 支持拣料失败场景（物料不存在）

**技术要点**:
- PDA 移动端页面（响应式设计）
- 扫码功能集成
- 数量输入和验证
- 部分完成和失败处理

**详细设计参考**: [@docs/design/3.3.3-smt-production-issue.md §6.5 异常处理与人工兜底](../docs/design/3.3.3-smt-production-issue.md#65-异常处理与人工兜底)

**故事点**: **5**
**估算理由**: PDA 工作流，涉及扫码、输入、验证，复杂度较高

---

#### US-E9-05: 人工完成上报

**作为** WMS 系统
**我想要** 接收 PDA 的完成上报
**以便** 更新任务状态和库存数据

**验收标准** (Acceptance Criteria):
- [ ] 接收 PDA 的完成上报（任务 ID、物料、实际数量、时间戳）
- [ ] 验证上报数据完整性
- [ ] 更新任务状态为"人工完成"（MANUAL_COMPLETED）
- [ ] 更新库存数据（扣减发料数量）
- [ ] 更新工单进度
- [ ] 记录人工完成日志
- [ ] 通知相关人员（任务完成通知）

**技术要点**:
- PDA 上报接口
- 数据验证逻辑
- 任务状态更新
- 库存数据更新
- 通知发送

**详细设计参考**: [@docs/design/3.3.3-smt-production-issue.md §6.5 异常处理与人工兜底](../docs/design/3.3.3-smt-production-issue.md#65-异常处理与人工兜底)

**故事点**: **3**
**估算理由**: 上报接口，数据更新，中等复杂度

---

## 团队迭代计划 (Team Sprint Planning)

### 团队速率计算 (Team Velocity Calculation)

**基础参数**:
- 团队人数: 2 人
- 迭代周期: 2 周 = 10 工作日
- 每天工时: 8 小时
- 有效工时占比: 65%（考虑会议、代码审查、沟通等）
- 纯开发生产率: 2 人时/故事点
- 综合工时系数: 3.0（开发 + 测试 + 集成）

**计算过程**:
```
可用工时 = 2 人 × 10 天 × 8 小时/天 = 160 小时
有效工时 = 160 小时 × 65% = 104 小时
综合工时/故事点 = 2 人时 × 3.0 = 6 小时/故事点
团队速率 = 104 小时 ÷ 6 小时/故事点 = 17.3 故事点/Sprint
```

**团队速率**: **17 故事点/Sprint**（取整）

---

### WMS 团队迭代计划

#### Sprint 1 (WMS): 货架规划与任务生成 (17 故事点，约 102 小时)

**目标**: 完成 WMS 核心任务生成和货架规划功能

**Epic 覆盖**: Epic 1 (部分), Epic 9 (部分)

| 用户故事 | 故事点 | 工时 | 依赖 | 负责人分工 |
|---|---|---|---|---|
| US-E1-01: 货架预规划算法 | 5 | 30 | 无 | Dev1: 算法设计 + 实现<br/>Dev2: 数据库查询优化 |
| US-E1-02: 物料定位识别 | 3 | 18 | US-E1-01 | Dev1: 查询逻辑<br/>Dev2: PKG 码解析 |
| US-E1-03: 批量货架调度 | 5 | 30 | US-E1-01 | Dev1: RCS API 集成<br/>Dev2: 优先级队列 |
| US-E1-05: 料盘级数据模型 | 3 | 18 | 无 | Dev1: 表设计<br/>Dev2: 迁移脚本 |
| US-E9-01: 异常检测与告警 | 1 | 6 | 无 | Dev2: 告警集成 |

**并行开发策略**:
- **Week 1**: Dev1 专注货架预规划算法，Dev2 并行开发数据模型和异常告警
- **Week 2**: Dev1 开发物料定位识别，Dev2 开发批量货架调度

**关键里程碑**:
- [ ] Day 3: 货架预规划算法完成单元测试
- [ ] Day 5: 料盘级数据模型迁移完成
- [ ] Day 7: 物料定位识别功能完成
- [ ] Day 10: 批量货架调度集成测试通过

**效率优化措施**:
- 使用数据库索引优化查询性能
- RCS API 集成使用 mock 服务并行开发
- 代码复用：FIFO 排序逻辑抽象为通用函数

---

#### Sprint 2 (WMS): 任务下发与人工兜底 (17 故事点，约 102 小时)

**目标**: 完成 WMS-WES 集成和人工兜底流程

**Epic 覆盖**: Epic 1 (剩余), Epic 9 (剩余)

| 用户故事 | 故事点 | 工时 | 依赖 | 负责人分工 |
|---|---|---|---|---|
| US-E1-04: WMS-WES 任务下发 API | 3 | 18 | Sprint 1 | Dev1: API 集成 + 重试机制 |
| US-E9-02: 人工介入触发 | 2 | 12 | 无 | Dev2: 状态更新 + 通知 |
| US-E9-03: PDA 任务分配 | 3 | 18 | US-E9-02 | Dev1: 任务分配逻辑 |
| US-E9-04: 人工拣料工作流 | 5 | 30 | US-E9-03 | Dev1: PDA 页面<br/>Dev2: 扫码集成 |
| US-E9-05: 人工完成上报 | 3 | 18 | US-E9-04 | Dev2: 上报接口 + 库存更新 |

**并行开发策略**:
- **Week 1**: Dev1 开发 WMS-WES API 集成，Dev2 并行开发人工介入触发和 PDA 任务分配
- **Week 2**: Dev1 开发 PDA 页面，Dev2 开发扫码集成和完成上报

**关键里程碑**:
- [ ] Day 3: WMS-WES API 集成完成（使用 WES mock 服务）
- [ ] Day 5: PDA 任务分配功能完成
- [ ] Day 8: PDA 人工拣料工作流完成
- [ ] Day 10: 端到端集成测试通过（WMS → WES mock → PDA）

**效率优化措施**:
- WES mock 服务提前准备，支持并行开发
- PDA 页面使用响应式设计框架（Bootstrap）
- 扫码功能使用现有组件库

---

### WES 团队迭代计划

#### Sprint 3 (WES): 任务队列与编排 (16 故事点，约 96 小时)

**目标**: 完成 WES 核心任务队列和编排功能

**Epic 覆盖**: Epic 2

| 用户故事 | 故事点 | 工时 | 依赖 | 负责人分工 |
|---|---|---|---|---|
| US-E2-01: 任务接收 API | 2 | 12 | 无 | Dev1: FastAPI 端点 + 数据验证 |
| US-E2-02: 任务队列管理 | 3 | 18 | US-E2-01 | Dev1: 队列逻辑<br/>Dev2: 数据库表设计 |
| US-E2-03: 设备状态监控 | 3 | 18 | 无 | Dev2: 心跳检测 + Redis 缓存 |
| US-E2-04: 并发任务控制 | 3 | 18 | US-E2-02 | Dev1: Redis 计数器 + 分布式锁 |
| US-E2-05: 任务调度算法 | 5 | 30 | US-E2-02, US-E2-03, US-E2-04 | Dev1: 调度逻辑<br/>Dev2: 设备选择策略 |

**并行开发策略**:
- **Week 1**: Dev1 开发任务接收 API 和队列管理，Dev2 并行开发设备状态监控
- **Week 2**: Dev1 开发并发控制，Dev2 协助开发任务调度算法

**关键里程碑**:
- [ ] Day 3: 任务接收 API 完成（集成测试通过）
- [ ] Day 5: 任务队列管理和设备状态监控完成
- [ ] Day 7: 并发任务控制完成
- [ ] Day 10: 任务调度算法完成（端到端测试通过）

**效率优化措施**:
- 使用 FastAPI 自动生成 API 文档
- Redis 缓存提前配置，支持并行开发
- ECS mock 服务提前准备

---

#### Sprint 4 (WES): CTU 批量上料操作 (17 故事点，约 102 小时)

**目标**: 完成 CTU 批量上料操作和信号协调

**Epic 覆盖**: Epic 3

| 用户故事 | 故事点 | 工时 | 依赖 | 负责人分工 |
|---|---|---|---|---|
| US-E3-01: 批量料箱取出协调 | 3 | 18 | Sprint 3 | Dev1: WMS API 集成 |
| US-E3-02: 顺序料箱放入工作流 | 5 | 30 | US-E3-01 | Dev1: 状态机设计<br/>Dev2: 顺序控制逻辑 |
| US-E3-03: PUT_FINISH 信号协调 | 3 | 18 | US-E3-02 | Dev2: ECS 信号集成 |
| US-E3-04: 出料口取料协调 | 3 | 18 | Sprint 3 | Dev1: WMS API 集成 |
| US-E3-05: PICK_FINISH 信号协调 | 3 | 18 | US-E3-04 | Dev2: ECS 信号集成 |

**并行开发策略**:
- **Week 1**: Dev1 开发批量取箱和出料口协调，Dev2 并行开发信号协调逻辑
- **Week 2**: Dev1 开发顺序放箱状态机，Dev2 协助测试和集成

**关键里程碑**:
- [ ] Day 3: 批量料箱取出协调完成
- [ ] Day 5: PUT_FINISH 信号协调完成
- [ ] Day 7: 顺序料箱放入工作流完成
- [ ] Day 10: 端到端集成测试通过（CTU mock + ECS mock）

**效率优化措施**:
- CTU mock 服务提前准备
- ECS mock 服务支持信号协调测试
- 状态机使用 Python asyncio 实现

---

#### Sprint 5 (WES): 四识别点位集成（Part 1）(15 故事点，约 90 小时)

**目标**: 完成识别点 1、2 和料箱追踪状态机

**Epic 覆盖**: Epic 4 (部分)

| 用户故事 | 故事点 | 工时 | 依赖 | 负责人分工 |
|---|---|---|---|---|
| US-E4-01: 识别点 1 - 料箱码识别区 | 5 | 30 | Sprint 3 | Dev1: 事件处理 + 决策逻辑 |
| US-E4-02: 识别点 2 - 工作位料箱方向识别 | 5 | 30 | US-E4-01 | Dev1: 事件处理 + 拣料指令生成 |
| US-E4-05: 料箱追踪状态机 | 5 | 30 | 无 | Dev2: 数据库表设计 + 状态机逻辑 |

**并行开发策略**:
- **Week 1**: Dev1 开发识别点 1，Dev2 并行开发料箱追踪状态机
- **Week 2**: Dev1 开发识别点 2，Dev2 协助集成测试

**关键里程碑**:
- [ ] Day 3: 料箱追踪状态机数据库表完成
- [ ] Day 5: 识别点 1 完成（事件处理 + 决策逻辑）
- [ ] Day 8: 识别点 2 完成（拣料指令生成）
- [ ] Day 10: 集成测试通过（ECS mock 事件 → WES 处理）

**效率优化措施**:
- ECS mock 服务支持四识别点位事件模拟
- 状态机使用 PostgreSQL ENUM 类型
- 事件处理使用 FastAPI 异步接口

---

#### Sprint 6 (WES): 四识别点位集成（Part 2）+ 退货架拣料（Part 1）(16 故事点，约 96 小时)

**目标**: 完成识别点 3、4 和退货架拣料部分功能

**Epic 覆盖**: Epic 4 (剩余), Epic 5 (部分)

| 用户故事 | 故事点 | 工时 | 依赖 | 负责人分工 |
|---|---|---|---|---|
| US-E4-03: 识别点 3 - 料盘 PKG 码验证 | 5 | 30 | Sprint 5 | Dev1: 事件处理 + PKG 验证 |
| US-E4-04: 识别点 4 - 出料口料箱扫码 | 3 | 18 | Sprint 5 | Dev2: 事件处理 + CTU 回库 |
| US-E5-01: 退货架到位确认 | 2 | 12 | Sprint 3 | Dev2: 事件处理 + 查询逻辑 |
| US-E5-02: 夹爪模式转移指令 | 5 | 30 | US-E5-01 | Dev1: 指令生成 + ECS 集成 |

**并行开发策略**:
- **Week 1**: Dev1 开发识别点 3，Dev2 并行开发识别点 4 和退货架到位确认
- **Week 2**: Dev1 开发夹爪模式转移指令，Dev2 协助测试

**关键里程碑**:
- [ ] Day 3: 识别点 3 完成（PKG 码验证）
- [ ] Day 5: 识别点 4 完成（出料口扫码 + CTU 回库）
- [ ] Day 7: 退货架到位确认完成
- [ ] Day 10: 夹爪模式转移指令完成（端到端测试通过）

**效率优化措施**:
- PKG 码验证逻辑复用物料定位识别功能
- ECS mock 服务支持夹爪模式模拟
- 四识别点位集成测试自动化

---

#### Sprint 7 (WES): 退货架拣料（Part 2）+ 流水线拣料（Part 1）(17 故事点，约 102 小时)

**目标**: 完成退货架拣料和流水线拣料部分功能

**Epic 覆盖**: Epic 5 (剩余), Epic 6 (部分)

| 用户故事 | 故事点 | 工时 | 依赖 | 负责人分工 |
|---|---|---|---|---|
| US-E5-03: 竖直放置协调 | 3 | 18 | Sprint 6 | Dev2: 结果处理 + 位置更新 |
| US-E5-04: 库存更新协调 | 3 | 18 | US-E5-03 | Dev2: WMS API 集成 |
| US-E6-01: 批量上料协调 | 5 | 30 | Sprint 4 | Dev1: CTU 批量协调 + 信号 |
| US-E6-02: 料箱识别与验证 | 3 | 18 | Sprint 5, Sprint 6 | Dev1: 事件处理 + 验证逻辑 |
| US-E6-03: 拣料指令生成（含工作高度）| 3 | 18 | US-E6-02 | Dev1: 指令生成 + 高度计算 |

**并行开发策略**:
- **Week 1**: Dev1 开发批量上料协调，Dev2 并行完成退货架拣料剩余功能
- **Week 2**: Dev1 开发料箱识别验证和拣料指令生成，Dev2 协助测试

**关键里程碑**:
- [ ] Day 3: 退货架拣料完整流程完成
- [ ] Day 5: 批量上料协调完成
- [ ] Day 8: 拣料指令生成（含工作高度）完成
- [ ] Day 10: 集成测试通过（退货架 + 流水线拣料）

**效率优化措施**:
- 库存更新 API 复用 Epic 8 设计
- 工作高度计算逻辑抽象为通用函数
- 批量上料协调复用 Epic 3 信号协调逻辑

---

#### Sprint 8 (WES): 流水线拣料（Part 2）+ 错误处理（Part 1）(17 故事点，约 102 小时)

**目标**: 完成流水线拣料和错误处理部分功能

**Epic 覆盖**: Epic 6 (剩余), Epic 7 (部分)

| 用户故事 | 故事点 | 工时 | 依赖 | 负责人分工 |
|---|---|---|---|---|
| US-E6-03: 拣料指令生成（剩余）| 2 | 12 | Sprint 7 | Dev1: 完成剩余功能 |
| US-E6-04: 机械臂吸盘模式拣料 | 5 | 30 | US-E6-03 | Dev1: ECS 集成 + PKG 验证 |
| US-E6-05: 实时库存扣减 | 3 | 18 | US-E6-04 | Dev2: WMS API 集成 |
| US-E6-06: 料箱轮转与下一箱处理 | 3 | 18 | US-E6-04 | Dev2: 轮转协调逻辑 |
| US-E7-01: 错误检测逻辑 | 3 | 18 | Sprint 5, Sprint 6 | Dev1: 错误分类 + 检测 |

**并行开发策略**:
- **Week 1**: Dev1 开发机械臂拣料和错误检测，Dev2 并行开发库存扣减和料箱轮转
- **Week 2**: 集成测试和优化

**关键里程碑**:
- [ ] Day 3: 机械臂吸盘模式拣料完成
- [ ] Day 5: 实时库存扣减完成
- [ ] Day 7: 料箱轮转处理完成
- [ ] Day 10: 流水线拣料完整流程测试通过

**效率优化措施**:
- 实时库存扣减使用异步 API 调用
- 料箱轮转逻辑复用识别点位状态机
- 错误检测逻辑统一封装

---

#### Sprint 9 (WES): 错误处理（Part 2）+ 结果上报（Part 1）(17 故事点，约 102 小时)

**目标**: 完成错误处理和结果上报部分功能

**Epic 覆盖**: Epic 7 (剩余), Epic 8 (部分)

| 用户故事 | 故事点 | 工时 | 依赖 | 负责人分工 |
|---|---|---|---|---|
| US-E7-02: 返回指令下发 | 3 | 18 | Sprint 8 | Dev1: ECS 指令下发 |
| US-E7-03: 流水线路径切换 | 3 | 18 | US-E7-02 | Dev1: 路径切换协调 |
| US-E7-04: CTU 返回处理 | 3 | 18 | US-E7-03 | Dev2: WMS API 集成 |
| US-E7-05: 重试机制（最多 3 次）| 5 | 30 | US-E7-04 | Dev1: 重试逻辑 + 数据库表 |
| US-E8-01: 实时库存扣减 API | 3 | 18 | Sprint 8 | Dev2: WMS API 集成 |

**并行开发策略**:
- **Week 1**: Dev1 开发返回指令和路径切换，Dev2 并行开发 CTU 返回和库存扣减
- **Week 2**: Dev1 开发重试机制，Dev2 协助测试

**关键里程碑**:
- [ ] Day 3: 返回指令下发和路径切换完成
- [ ] Day 5: CTU 返回处理完成
- [ ] Day 8: 重试机制完成（含数据库表）
- [ ] Day 10: 错误处理完整流程测试通过

**效率优化措施**:
- 重试机制使用 Redis 计数器
- 错误日志表设计支持高效查询
- 实时库存扣减 API 复用 Epic 6 实现

---

#### Sprint 10 (WES + WMS): 错误处理（Part 3）+ 结果上报（Part 2）(11 故事点，约 66 小时)

**目标**: 完成所有剩余功能和端到端集成测试

**Epic 覆盖**: Epic 7 (剩余), Epic 8 (剩余)

| 用户故事 | 故事点 | 工时 | 依赖 | 负责人分工 |
|---|---|---|---|---|
| US-E7-06: 错误日志与追踪 | 2 | 12 | Sprint 9 | Dev2: 日志记录 + 查询接口 |
| US-E8-02: 任务完成上报 | 3 | 18 | Sprint 9 | Dev1: WMS API 集成 |
| US-E8-03: 物料完成追踪 | 3 | 18 | US-E8-02 | Dev1: 数据库更新 + 状态管理 |
| US-E8-04: 料盘级完成追踪 | 3 | 18 | US-E8-03 | Dev2: 数据库更新 + 查询接口 |

**并行开发策略**:
- **Week 1**: Dev1 开发任务完成上报和物料追踪，Dev2 并行开发错误日志和料盘追踪
- **Week 2**: 端到端集成测试和性能优化

**关键里程碑**:
- [ ] Day 3: 错误日志与追踪完成
- [ ] Day 5: 任务完成上报完成
- [ ] Day 7: 物料和料盘完成追踪完成
- [ ] Day 10: 端到端集成测试通过（WMS → WES → ECS → WMS）

**效率优化措施**:
- 端到端集成测试自动化
- 性能测试和优化（数据库查询、API 响应时间）
- 文档完善和交付准备

---

### 团队协作时间表

| 周次 | WMS 团队 | WES 团队 | 协作事项 | 工时投入 | 并行策略 |
|---|---|---|---|---|---|
| **Week 0** | 环境配置、API 契约设计 | 环境配置、API 契约设计 | API 契约评审会议 | WMS: 16h<br/>WES: 16h | Sprint 0 准备工作 |
| **Week 1-2** | Sprint 1: 货架规划与任务生成 | 环境配置、Mock 服务准备 | WMS 提供 Mock 数据 | WMS: 102h<br/>WES: 16h | WMS 先行开发 |
| **Week 3-4** | Sprint 2: 任务下发与人工兜底 | 环境配置、Mock 服务准备 | WES Mock 服务联调 | WMS: 102h<br/>WES: 16h | WMS 先行开发 |
| **Week 5-6** | 支持 WES 集成测试 | Sprint 3: 任务队列与编排 | WMS-WES API 联调 | WMS: 16h<br/>WES: 96h | WES 开始开发 |
| **Week 7-8** | 支持 WES 集成测试 | Sprint 4: CTU 批量上料操作 | CTU 协调接口联调 | WMS: 16h<br/>WES: 102h | WES 主导开发 |
| **Week 9-10** | 支持 WES 集成测试 | Sprint 5: 四识别点位集成（Part 1）| ECS 事件接口联调 | WMS: 16h<br/>WES: 90h | WES 主导开发 |
| **Week 11-12** | 支持 WES 集成测试 | Sprint 6: 四识别点位集成（Part 2）+ 退货架拣料（Part 1）| 库存更新接口联调 | WMS: 16h<br/>WES: 96h | WES 主导开发 |
| **Week 13-14** | 支持 WES 集成测试 | Sprint 7: 退货架拣料（Part 2）+ 流水线拣料（Part 1）| 实时库存扣减联调 | WMS: 16h<br/>WES: 102h | WES 主导开发 |
| **Week 15-16** | 支持 WES 集成测试 | Sprint 8: 流水线拣料（Part 2）+ 错误处理（Part 1）| 库存扣减性能优化 | WMS: 16h<br/>WES: 102h | WES 主导开发 |
| **Week 17-18** | 支持 WES 集成测试 | Sprint 9: 错误处理（Part 2）+ 结果上报（Part 1）| 任务完成上报联调 | WMS: 16h<br/>WES: 102h | WES 主导开发 |
| **Week 19-20** | 端到端集成测试 | Sprint 10: 错误处理（Part 3）+ 结果上报（Part 2）| 端到端集成测试 | WMS: 32h<br/>WES: 66h | 联合测试 |

**关键协作点**:
1. **Week 0**: Sprint 0 - API 契约评审（WMS + WES）
2. **Week 4**: Sprint 2 结束 - WMS 任务下发 API 就绪
3. **Week 6**: Sprint 3 结束 - WES 任务接收就绪，WMS-WES 集成测试
4. **Week 8**: Sprint 4 结束 - CTU 批量上料就绪，硬件集成测试
5. **Week 12**: Sprint 6 结束 - 四识别点位完成，端到端测试
6. **Week 16**: Sprint 8 结束 - 所有拣料模式完成，性能测试
7. **Week 20**: Sprint 10 结束 - 全系统集成测试

**效率提升关键**:
- **Sprint 0 准备工作**: API 契约设计、Mock 服务准备、环境配置
- **自动化优先**: 单元测试、集成测试、端到端测试自动化
- **并行开发策略**: WMS 先行开发（Week 1-4），WES 主导开发（Week 5-20）
- **代码复用策略**: 通用函数抽象、组件库复用、API 客户端封装

**总工时**: 
- **WMS 团队**: 204 小时（Sprint 1-2）+ 144 小时（支持 WES）= 348 小时
- **WES 团队**: 32 小时（准备）+ 852 小时（Sprint 3-10）= 884 小时
- **总计**: 1232 小时

**总工期**: 20 周（约 5 个月）

---

---

## 附录 (Appendix)

### A. Fibonacci 故事点参考表

| 故事点 | 复杂度 | 工作量 | 典型任务示例 |
|---|---|---|---|
| 1 | 极简单 | 0.5-1h | 配置项修改、简单查询接口 |
| 2 | 简单 | 1-2h | 单表 CRUD、简单数据转换 |
| 3 | 中等偏易 | 2-4h | 多表关联查询、基础业务逻辑 |
| 5 | 中等 | 4-8h | 复杂业务逻辑、算法实现 |
| 8 | 中等偏难 | 8-16h | 复杂算法、多系统集成 |
| 13 | 困难 | 16-24h | 核心调度算法、复杂状态机 |
| 21 | 极困难 | 24-40h | 架构级改造、复杂系统集成 |

**注意**: 
- 故事点包含开发、自测、联调、文档时间
- 超过 13 点的 User Story 应拆分为更小粒度
- 实际工时 = 故事点 × 综合时间系数 (1.5)

### B. 团队速率计算参考

**WMS 团队 (1人)**:
- 可用时间: 10天 × 8小时 = 80小时/Sprint
- 有效工作率: 70% (扣除会议、沟通、中断)
- 有效工时: 80 × 0.7 = 56小时/Sprint
- 综合时间系数: 1.5 (包含自测、联调、返工)
- 速率: 56 ÷ 1.5 ≈ 37小时 ≈ 7故事点/Sprint

**WES 团队 (1人)**:
- 可用时间: 10天 × 8小时 = 80小时/Sprint
- 有效工作率: 70%
- 有效工时: 80 × 0.7 = 56小时/Sprint
- 综合时间系数: 1.5
- 速率: 56 ÷ 1.5 ≈ 37小时 ≈ 7故事点/Sprint

**团队总速率**: 7 + 7 = 14故事点/Sprint (保守估计)  
**实际采用**: 17故事点/Sprint (考虑并行开发效率提升)

### C. 依赖关系图

```
Epic 1 (WMS 货架规划)
  ↓
Epic 2 (WES 任务队列) ← 必须等待 Epic 1 完成
  ↓
Epic 3 (CTU 操作协调) ← 依赖 Epic 2
  ↓
Epic 4 (四识别点集成) ← 依赖 Epic 3
Epic 5 (拣选操作管理) ← 依赖 Epic 3
Epic 6 (异常处理机制) ← 依赖 Epic 3
Epic 7 (批量装载优化) ← 依赖 Epic 3
  ↓
Epic 8 (结果回传) ← 依赖 Epic 4-7 完成
  ↓
Epic 9 (WMS 手工兜底) ← 可并行开发，最后集成
```

**关键路径**: Epic 1 → Epic 2 → Epic 3 → Epic 4/5/6/7 → Epic 8  
**并行路径**: Epic 9 可独立开发

### D. 风险与缓解措施

#### 高风险 (High Risk)

| 风险项 | 影响 | 概率 | 缓解措施 |
|---|---|---|---|
| **CTU 信号协议不稳定** | 导致任务卡死、重复执行 | 中 | 1) Sprint 3 提前进行 CTU 联调测试<br>2) 实现信号超时重试机制<br>3) 建立 CTU 模拟器用于开发测试 |
| **四识别点硬件故障率高** | 影响生产效率，需频繁人工干预 | 中 | 1) Epic 6 实现完善的异常处理<br>2) 建立识别点健康度监控<br>3) 设计降级方案 (跳过可选识别点) |
| **批量装载算法性能不足** | 无法达到 40-60% 效率提升目标 | 低 | 1) Sprint 7 进行性能基准测试<br>2) 准备算法优化备选方案<br>3) 必要时降低批量规模 |

#### 中风险 (Medium Risk)

| 风险项 | 影响 | 概率 | 缓解措施 |
|---|---|---|---|
| **WMS-WES 接口变更** | 需要返工修改接口 | 低 | 1) Sprint 1 完成接口设计评审<br>2) 使用版本化 API 设计<br>3) 建立接口变更通知机制 |
| **团队人员变动** | 项目延期 | 低 | 1) 完善技术文档<br>2) 代码审查确保知识共享<br>3) 关键模块双人备份 |
| **测试环境资源不足** | 联调测试延期 | 中 | 1) 提前申请测试环境<br>2) 使用 Docker 容器化测试环境<br>3) 建立模拟器降低硬件依赖 |

### E. 整体验收标准

#### 功能性验收 (Functional Acceptance)

1. **货架预规划准确率** ≥ 95%
   - 测试方法: 100 个生产任务，统计货架规划命中率
   - 通过标准: 95 个任务的货架规划无需人工调整

2. **批量装载效率提升** ≥ 40%
   - 基准: 单次装载平均耗时 (现状)
   - 目标: 批量装载平均耗时降低 40% 以上
   - 测试方法: 对比 50 次单次装载 vs 50 次批量装载

3. **四识别点集成成功率** ≥ 98%
   - 测试方法: 1000 次识别操作，统计成功率
   - 通过标准: 失败率 ≤ 2%，且失败后重试成功

4. **CTU 信号协调准确率** = 100%
   - 测试方法: 500 次 CTU 操作，验证信号时序
   - 通过标准: 无信号丢失、无重复执行、无死锁

#### 性能验收 (Performance Acceptance)

1. **任务下发响应时间** ≤ 2秒
   - WMS → WES 任务下发 API 响应时间
   - 测试方法: 并发 10 个任务下发请求

2. **任务调度延迟** ≤ 5秒
   - WES 接收任务到下发 CTU 指令的时间
   - 测试方法: 100 个任务的平均调度延迟

3. **结果回传延迟** ≤ 3秒
   - CTU 完成到 WMS 收到结果的时间
   - 测试方法: 100 个任务的平均回传延迟

4. **系统并发能力** ≥ 20 任务/分钟
   - 测试方法: 压力测试，持续 30 分钟
   - 通过标准: 无任务丢失、无系统崩溃

#### 可靠性验收 (Reliability Acceptance)

1. **异常恢复成功率** ≥ 95%
   - 测试方法: 模拟 100 次异常场景 (设备故障、网络中断、超时)
   - 通过标准: 95 次自动恢复或降级处理成功

2. **数据一致性** = 100%
   - 测试方法: 1000 次操作后，对比 WMS/WES/ECS 数据
   - 通过标准: 无数据不一致、无幽灵库存

3. **系统可用性** ≥ 99.5%
   - 测试方法: 连续运行 7 天，统计故障时间
   - 通过标准: 故障时间 ≤ 50 分钟/周

#### 数据质量验收 (Data Quality Acceptance)

1. **料盘级追溯完整性** = 100%
   - 测试方法: 随机抽查 100 个料盘，验证追溯链
   - 通过标准: 所有料盘可追溯到货架、Bin、PKG

2. **识别点数据准确性** ≥ 99%
   - 测试方法: 对比识别点扫描数据与实际物料
   - 通过标准: 错误率 ≤ 1%

3. **日志完整性** = 100%
   - 测试方法: 验证关键操作日志记录
   - 通过标准: 所有任务状态变更、异常、人工干预均有日志

---

## 文档变更记录

| 版本 | 日期 | 变更内容 | 作者 |
|---|---|---|---|
| v1.0 | 2025-12-31 | 初始版本，完成任务分解 | Claude (AI Assistant) |

---

**文档生成说明**:
- 本文档基于 `docs/design/3.3.3-smt-production-issue.md` 设计文档生成
- 使用 Fibonacci 故事点估算法
- 团队速率基于 2 人团队 (WMS 1人 + WES 1人) 计算
- 预估工期: 10 个 Sprint (20 周，约 5 个月)
- 总工时: 1232 小时 (WMS 348h + WES 884h)
