kaizhoumasha/fxn_wms/docs/origin/NVD原料仓AGV流程图.pdf

# AGV原物料入库单据作业流程

WMS | AGV

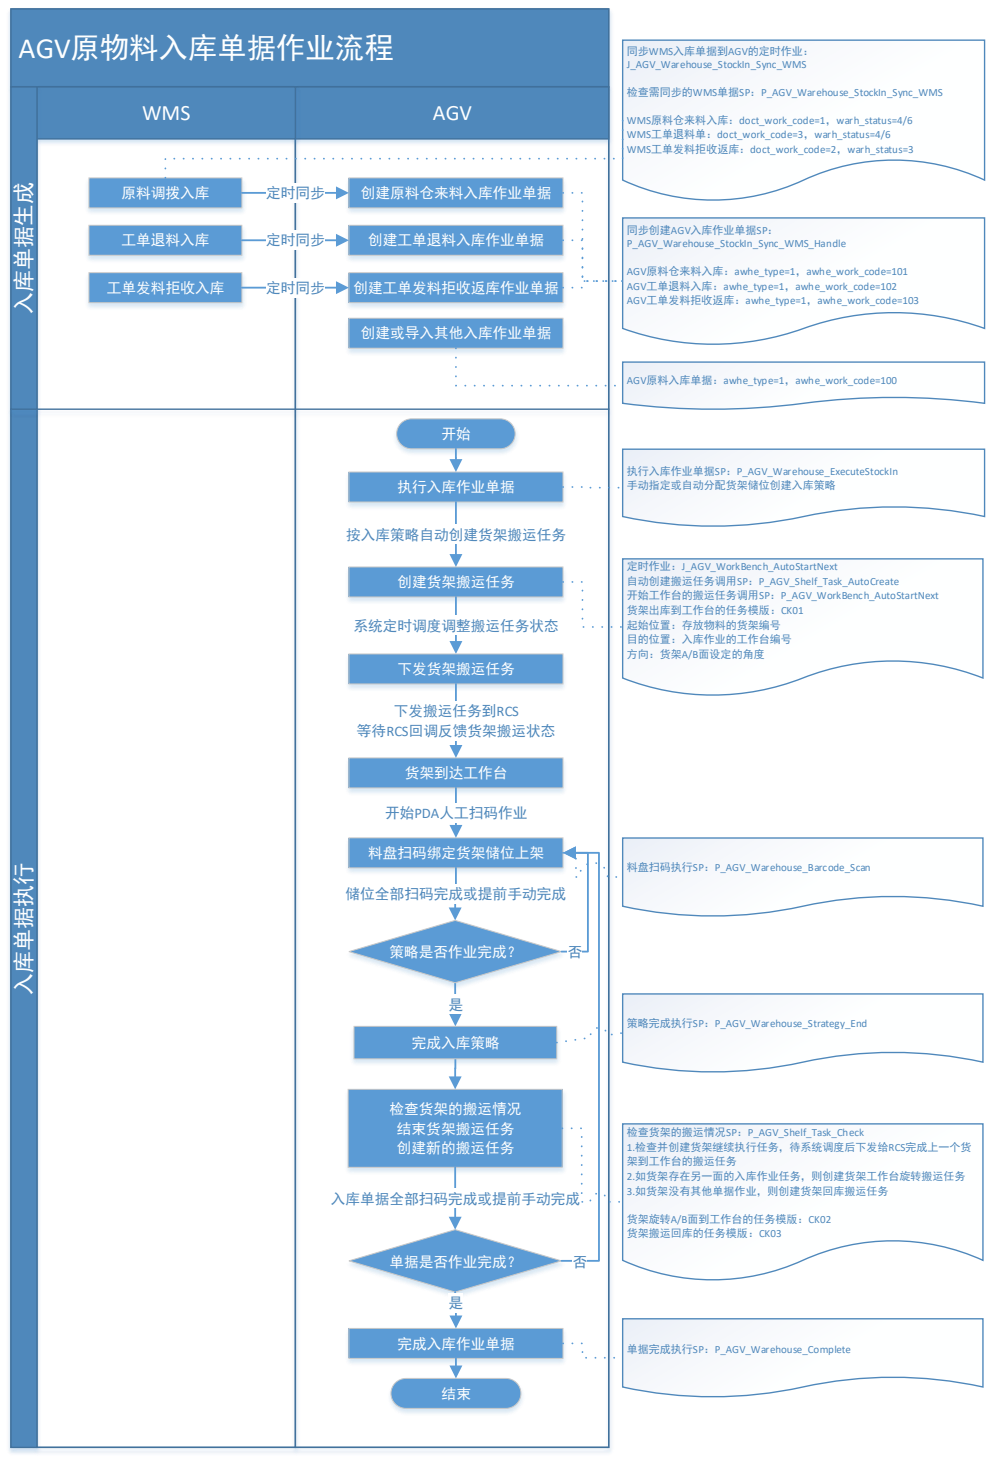
[picture p50: page 1]
入库单据执行 入库单据生成; 原料调拨入库; 创建原料仓来料入库作业单据; 工单退料入库; 工单发料拒收入库; 创建工单退料入库作业单据; 创建工单发料拒收返库作业单据; 定时同步; 执行入库作业单据; 创建货架搬运任务; 货架到达工作台; 料盘扫码绑定货架储位上架; 完成入库作业单据; 同步WMS入库单据到AGV的定时作业： J_AGV_Warehouse_StockIn_Sync_WMS; 检查需同步的WMS单据SP：P_AGV_Warehouse_StockIn_Sync_WMS; WMS原料仓来料入库：doct_work_code=1，warh_status=4/6 WMS工单退料单：doct_work_code=3，warh_status=4/6 WMS工单发料拒收返库：doct_work_code=2，warh_status=3; 同步创建AGV入库作业单据SP： P_AGV_Warehouse_StockIn_Sync_WMS_Handle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

定时作业：J_AGV_WorkBench_AutoStartNext
自动创建搬运任务调用SP：P_AGV_Shelf_Task_AutoCreate
开始工作台的搬运任务调用SP：P_AGV_WorkBench_AutoStartNext
货架出库到工作台的任务模版：CK01
起始位置：存放物料的货架编号
目的位置：入库作业的工作台编号
方向：货架A/B面设定的角度

# AGV原物料出库单据作业流程

WMS | AGV

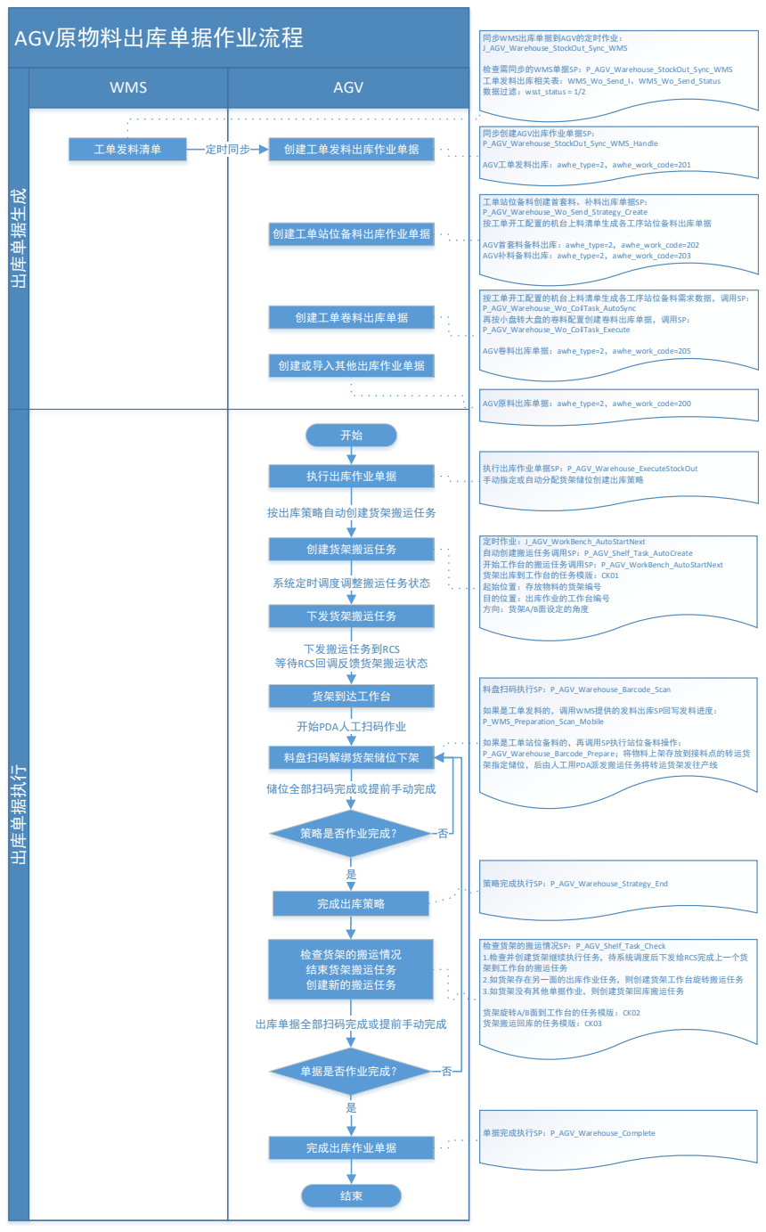
[picture p51: page 2]

# 出库单据执行 出库单据生成

工单发料清单 | 创建工单发料出库作业单据

## 定时同步

## 执行出库作业单据

## 创建货架搬运任务

## 货架到达工作台

## 料盘扫码解绑货架储位下架

## 完成出库作业单据

同步WMS出库单据到AGV的定时作业：
J_AGV_Warehouse_StockOut_Sync_WMS

检查需同步的WMS单据SP：P_AGV_Warehouse_StockOut_Sync_WMS 工单发料出库相关表：WMS_Wo_Send_I、WMS_Wo_Send_Status 数据过滤：wsst_status = 1/2

定时作业：J_AGV_WorkBench_AutoStartNext 自动创建搬运任务调用SP：P_AGV_Shelf_Task_AutoCreate 开始工作台的搬运任务调用SP：P_AGV_WorkBench_AutoStartNext 货架出库到工作台的任务模版：CK01
起始位置：存放物料的货架编号
目的位置：出库作业的工作台编号
方向：货架A/B面设定的角度

同步创建AGV出库作业单据SP：
P_AGV_Warehouse_StockOut_Sync_WMS_Handle

AGV工单发料出库：awhe_type=2，awhe_work_code=201

执行出库作业单据SP：P_AGV_Warehouse_ExecuteStockOut 手动指定或自动分配货架储位创建出库策略

## 创建工单站位备料出库作业单据

AGV原料出库单据：awhe_type=2，awhe_work_code=200

## 按出库策略自动创建货架搬运任务

## 系统定时调度调整搬运任务状态

## 开始PDA人工扫码作业

## 储位全部扫码完成或提前手动完成

## 下发货架搬运任务

## 下发搬运任务到RCS 等待RCS回调反馈货架搬运状态

## 检查货架的搬运情况 结束货架搬运任务 创建新的搬运任务

是

策略是否作业完成？ | 否
单据是否作业完成？ | 否

料盘扫码执行SP：P_AGV_Warehouse_Barcode_Scan

如果是工单发料的，调用WMS提供的发料出库SP回写发料进度： P_WMS_Preparation_Scan_Mobile

如果是工单站位备料的，再调用SP执行站位备料操作：
P_AGV_Warehouse_Barcode_Prepare；将物料上架存放到接料点的转运货 架指定储位，后由人工用PDA派发搬运任务将转运货架发往产线

策略完成执行SP：P_AGV_Warehouse_Strategy_End

单据完成执行SP：P_AGV_Warehouse_Complete

## 出库单据全部扫码完成或提前手动完成

检查货架的搬运情况SP：P_AGV_Shelf_Task_Check 1.检查并创建货架继续执行任务，待系统调度后下发给RCS完成上一个货 架到工作台的搬运任务
2.如货架存在另一面的出库作业任务，则创建货架工作台旋转搬运任务 3.如货架没有其他单据作业，则创建货架回库搬运任务

货架旋转A/B面到工作台的任务模版：CK02
货架搬运回库的任务模版：CK03

是

## 完成出库策略

开始

结束

## 创建或导入其他出库作业单据

工单站位备料创建首套料、补料出库单据SP：
P_AGV_Warehouse_Wo_Send_Strategy_Create 按工单开工配置的机台上料清单生成各工序站位备料出库单据

AGV首套料备料出库：awhe_type=2，awhe_work_code=202 AGV补料备料出库：awhe_type=2，awhe_work_code=203

按工单开工配置的机台上料清单生成各工序站位备料需求数据，调用SP： P_AGV_Warehouse_Wo_CoilTask_AutoSync 再按小盘转大盘的卷料配置创建卷料出库单据，调用SP： P_AGV_Warehouse_Wo_CoilTask_Execute

AGV卷料出库单据：awhe_type=2，awhe_work_code=205

## 创建工单卷料出库单据
