kaizhoumasha/fxn_wms/(commit log)

2025-12-09 Initial commit from Specify template
    [AGV API SPEC_20220902(V2).xlsx, AGV功能清单.xlsx, 休斯顿P9自动化仓库功能分解清单_202511021.xlsx, 初始化作业要求20251124V1.0.xlsx, 美國休斯頓Bianca(PG548 UT3.0B) 產品自動組裝線---上蓋供料載盤20251018.STEP, 美國休斯頓Bianca(PG548 UT3.0B) 產品自動組裝線---下蓋供料載盤20251018.STEP]
2025-12-09 feat(speckit): 添加分析、清单、澄清和宪法命令
    新增四个核心 Speckit 命令的配置文件，用于支持需求一致性检查、自定义质量清单生成、需求澄清交互以及项目宪法管理。这些命令分别为：
    - `speckit.analyze`: 对 spec.md、plan.md 和 tasks.md 进行跨文档一致性与质量分析
    - `speckit.checklist`: 根据功能需求生成“英语单元测试”式检查清单
    - `speckit.clarify`: 提出针对性问题以消除需求模糊点并更新 spec
    - `speckit.constitution`: 管理项目宪法模板及其在各模板中的同步传播
    所有命令均遵循只读或最小化写入原则，确保安全性和可控性。
2025-12-09 docs(constitution): 更新项目章程以明确系统设计范围与产物结构
    - 将“Implement (实现)”阶段的产出定义为详细设计文档而非可执行代码
    - 强调需求追溯至原始客户文档，确保“客户之声”在设计中体现
    - 明确结构化系统分析的核心交付物，包括流程图、数据模型和API契约
    - 调整功能分支使用规则，强调主分支仅保留已评审通过的设计方案
    - 细化技术可行性要求，增加对AGV/RCS接口兼容性的验证说明
    - 规范语言使用：所有文档以中文为主，关键术语采用双语标注
    - 重新组织“范围与产物”部分，明确定义设计交付物的内容与目录结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
2025-12-11 feat(docs): SRS 文档 V1.0版本
2025-12-11 feat(docs): 更新软件需求规格说明书 SRS.md
2025-12-11 ``` feat(project-setup): 初始化项目配置与文档结构
    添加了符合 Spec-Driven 开发理念的初始项目文件，包括：
    - 项目元信息（project.yml）定义语言、忽略路径及工具配置
    - 中文优先的双语文档规范与风格约定
    - 概要设计阶段启动相关的用户场景与功能需求说明
    - 用于指导开发流程的命令建议与检查清单
    - Git 忽略规则与 Serena 记忆存储机制
    所有新增内容均遵循以文档为先导的开发模式，未包含具体实现代码。
    ```
2025-12-11 feat(specify): 更新项目章程与模板以强化设计驱动和集成边界
    - 将 constitution.md 版本从 1.1.0 升级至 1.2.0
    - 新增第七原则：调度中台与设备交互边界，明确 WMS 不做 PLC 编程
    - 强化双语术语标注要求，并对技术可行性原则进行细化
    - 调整模板内容聚焦于系统设计而非代码实现
    - plan-template.md、spec-template.md 和 tasks-template.md 均已同步更新结构与指引
    - 明确设计产物目录结构及责任分界文档要求
    - 所有变更均符合设计优先、可追溯性和多团队协作的目标
2025-12-11 docs(architecture): 添加概要设计阶段文档集，涵盖接口契约与数据模型
    - 新增 `AGENTS.md` 开发指南，说明项目结构、命令与代码风格
    - 创建 `specs/001-high-level-design/` 下的设计文档：
    - `plan.md`：设计计划与 Constitution 检查
    - `research.md`：Phase 0 研究结论（协议边界、容量基线等）
    - `data-model.md`：业务模块、数据对象、异常场景定义
    - `contracts/integration-contracts.md`：SAP/MES/RCS/WCS/设备交互契约
    - `quickstart.md`：设计文档阅读与扩展指引
    - 明确 WMS 调度中台定位，不涉及 PLC/IO 控制
    - 强调双语术语、供应商配合要求及全链路追溯机制
2025-12-11 docs(specs): 添加概要设计阶段任务清单及交付物规划
    - 创建高层设计任务文档，明确各用户故事的 deliverables 和验证方式
    - 定义五个阶段的任务项：基础设置、可追溯性建立、端到端蓝图设计、接口契约定义、风险与验证基线
    - 明确每个任务的优先级、依赖关系以及并行执行的可能性
    - 提供 checkpoint 标准用于阶段性评审与追踪
2025-12-12 feat(specs): 添加详细设计阶段的规格说明与质量检查清单
    新增详细设计阶段的规格说明文件与对应的质量检查清单，明确用户场景、功能需求、
    成功标准及关键实体。聚焦业务与设计层面，确保内容对非技术干系人友好，并保持与
    原始需求文档的可追溯性。涵盖端到端流程设计、接口契约、可观测性及风险管理等核心要素。
2025-12-12 docs(002-detailed-design): 更新详细设计阶段文档与接口契约
    - 新增 contracts 目录，包含 SAP、RCS、设备遥测等接口字段级契约与示例
    - 添加 data-model.md 定义核心实体与关键字段（含幂等键、追踪引用）
    - 更新 spec.md 明确设备指令链路 p95 ≤10s 的性能目标与时延度量点
    - 补充 quickstart.md 提供阅读路径与联调前校验要点
    - 增加 research.md 记录设计决策（协议选择、性能目标、关键字段）
    - 在 AGENTS.md 中更新技术栈与实现假设（Python 3.11 / .NET 8）
2025-12-12 feat(specs): 添加详细设计阶段契约与验证文档
    - 新增 alignment.md 检查清单，确保详细设计与 SRS 对齐
    - 补充 MES、WCS 接口契约及样例缺口管理机制
    - 统一接口安全与审计要求，明确传输加密与日志脱敏规则
    - 完善 RCS 指令与设备遥测字段单位、错误码及重试策略
    - 增加 observability、security、exception-handling 等跨切面验证规范
    - 明确数据模型中标识键与单位枚举一致性要求
    - 更新 quickstart 引用路径，增强文档可追溯性与任务指引
2025-12-12 docs(contracts): 更新设备事件样例与错误码重试策略
    - 在 contracts/README.md 中补充设备事件样例说明及 ETA
    - 新增跨系统错误码、幂等键与重试策略矩阵表
    - 更新 device-telemetry.md，增加 Other 设备类型扩展说明
    - 完善 inbound-putaway.md 流程设计包内容，包括主路径、异常补偿、字段定义等
    - quickstart.md 中细化验收演练脚本示例
    - tasks.md 中标记 Phase 1~6 相关任务为已完成
    - 新增 traceability.md 文件，明确行级引用 TraceRef 的覆盖范围与要求
2025-12-12 docs(SRS): 添加冷热区存储优化策略章节
    新增 3.8.5 节详细描述了基于访问频率的动态储位优化机制，
    包括区域划分、热度计算、定时调整逻辑及配置参数说明。
    docs(SRS): 更新 RCS 接口通信机制与关键指令列表
    细化 RCS 与 WMS 之间的通信方式，明确指令交互与单据同步模式，
    并补充了关键指令和状态反馈的相关内容。
2025-12-12 delete(docs): 删除概要设计阶段的 checklist 与 contract 文档
    删除以下文件：
    - specs/001-high-level-design/checklists/integration.md
    - specs/001-high-level-design/checklists/requirements.md
    - specs/001-high-level-design/contracts/integration-contracts.md
    - specs/001-high-level-design/data-model.md
    - specs/001-high-level-design/diagrams/us1-flows.md
    - specs/001-high-level-design/diagrams/us2-sequence.md
    - specs/001-high-level-design/plan.md
    - specs/001-high-level-design/quickstart.md
    - specs/001-high-level-design/research.md
    这些内容将被重构并迁移至新的文档结构中，以符合最新的设计规范。
2025-12-13 docs(srs-diagrams): 删除 Mermaid 序列图 HTML 文件
    移除了包含多个业务流程序列图的 Mermaid HTML 文件，包括：
    - 到货登记与栈板绑定流程
    - IQC 检验流程
    - 装箱处理流程
    - 混合入库模式
    - SMT 发料拣选
    - 机构件自动线拆包
    - 生产退料清点
    该文件已不再维护，相关图表将迁移至专用文档系统。
2025-12-13 docs(user_requirement): 从 XLSX文档中抽取出完整的 MD 格式用户需求文档
2025-12-13 feat(openspec): 初始化 OpenSpec 规范与指令文件
    新增了 OpenSpec 相关的命令模板和说明文档，包括 apply、archive 和 proposal
    三个核心操作的 Markdown 与 TOML 格式指令。同时初始化了 AGENTS.md、CLAUDE.md
    以及 openspec/AGENTS.md 和 project.md 文件，用于定义 AI 助手在项目中的行为准则
    和规范驱动开发流程。这些文件共同构成了 OpenSpec 的基础框架，支持变更提案、实施
    与归档的全生命周期管理。
2025-12-13 doc: 重构 SRS.md 文件，明确项目范围和目标
2025-12-15 docs(development_architecture.md): 定义P9 WES开发架构指南
    新增开发架构文档，阐述系统核心设计理念：模块化单体、六边形架构与异步优先。
    详细描述代码目录结构，划分L1/L2/L3三层适配器职责。
    制定策略模式、插件化硬件适配、CQRS读写分离与异步任务编排等实现规范。
    明确前端SDK生成与部署方案，以及Python项目的依赖管理与测试策略。
2025-12-16 docs(architecture): 更新技术栈文档引用为决策包文件
    将 `technology_stack_analysis.md` 的引用统一更新为
    `technology_stack_decision_pack.md`，确保文档间链接一致。
    同时更新了架构描述，强化 WES 作为库存代理的角色。
    docs(srs): 重构库存交互与网络依赖性策略
    - 库存管理模型从“维护镜像”调整为“纯代理模式”，所有库存操作透传至 WMS
    - 明确断网行为：涉及库存变动的任务立即暂停，纯物理任务可继续执行
    - 优化任务恢复机制，依赖 WMS 状态进行一致性校验
    - 强化接口幂等性规则和异常处理逻辑
    - 调整非功能需求表述，强调强一致性与 WM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
2025-12-16 docs(architecture): 更新技术栈决策包与集成白皮书内容
    新增收货+装箱+混合入库端到端桌面演练过程文档，完善 WES 系统架构与业务流程说明。
    同步调整技术栈版本（Python 3.13）并清理过时的项目规划备注。
2025-12-16 docs(SRS.md): 完善系统职责划分与接口定义文档
    - 增加职责划分章节的结构清晰度，明确 WMS 与 WES 的系统定位
    - 补充库存查询、预留、确认等核心接口的协同机制说明
    - 细化执行状态数据结构及其关键特征描述
    - 优化装箱分配策略、发料优先级策略等内容的展示格式
    - 增强异常处理、设备恢复、WMS 断连等容错机制的描述
    - 明确系统间接口调用方式及幂等性保障措施
    docs(technology_stack_decision_pack.md): 更新项目人员配置建议表
    - 调整表格列格式以提升可读性
    - 补充各角色推荐负责人信息（如周凯、开杰等）
    - 明确设备/适配器工程师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
2025-12-16 feat(scaffold): 初始化后端脚手架项目
    新增完整的后端开发脚手架，基于 Python 3.13、FastAPI 和 ARQ，
    采用模块化单体与六边形架构设计。包含以下主要组件：
    - `src/app/`：北向适配器（FastAPI 提供 HTTP API）
    - `src/core/`：核心域（业务逻辑与用例实现）
    - `src/infra/`：基础设施层（数据库、Redis、ARQ Worker 等）
    - `src/southbound/`：南向适配器（支持硬件协议扩展）
    初始化内容包括：
    - FastAPI 应用注册与生命周期管理
    - 数据库模型及仓储实现（SQLAlchemy）
    - 异步任务队列集成（ARQ + Redis）
    - 发件箱模式支持事件投递
    - Docker Compose 配置用于本地开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
2025-12-17 refactor(core): 重构为演进式分层架构并统一模型
    将原有的六边形架构调整为演进式分层架构，简化业务开发流程。
    核心域模型现在直接继承自 SQLAlchemy `DeclarativeBase`，
    实现 Domain Model 与 ORM Model 的统一，去除冗余的映射转换。
    - 更新 README 文档以反映新的架构说明和开发指南
    - 移除 `src/infra/database/models.py`，模型统一由 `src/core/models.py` 管理
    - 引入 `OrderService` 替代原有的 `IngestInboundOrder` 用例类
    - 调整 repository 实现，直接操作核心实体，不再进行 domain-to-orm 转换
    - 修改依赖注入点，从 use case 转向 service
    - API 层适配新的 service 调用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
2025-12-17 docs(SRS): 更新系统集成边界与流程交互规范
    - 明确本阶段 WES 与 RCS、PDA、自动化设备及 WMS 的集成边界
    - 调整标签打印流程描述，区分自动与非自动打印场景
    - 修订绑定校验逻辑，由 WMS 执行并同步结果给 WES
    - 统一搬运任务调度方式：WES 生成需求并通过 WMS 调度 RCS
    - 优化拆板作业、退料流程等模块的职责划分说明
    - 强化 PDA 交互统一通过 WMS 的设计原则
    - 更新北向接口定位，明确 SAP 数据经由 WMS 中转
    - 补充 Phase Boundary 说明至 RCS 与 PDA 通道小节
2025-12-17 docs(SRS): 更新集成边界与流程描述以提升可读性
    调整文档中关于阶段集成边界的描述格式，确保条目清晰对齐；
    修正异常与满架处理流程中的列表符号问题；
    优化混合入库策略相关段落的排版；
    更新 PDA 扫描测试流程的表述，明确系统间调用关系。
2025-12-18 feat(docs): 添加设计文档生成与审计命令模板
    新增两个 Claude 命令模板文件，用于指导 AI 生成和审计设计文档：
    - `.claude/commands/design.md`: 设计文档生成器命令模板，定义了基于 SRS 和用户需求生成详细设计文档的流程和格式
    - `.claude/commands/audit-design.md`: 设计文档审计器命令模板，定义了对照 user_requirement.md 进行设计文档完整性和一致性审计的流程
    同时添加了设计文档生成的 PROMPT 模板文件，规范了生成过程中的文档结构、架构边界原则、审计要求等。
    此外，更新了 SRS 文档中关于 3.2.1 和 3.2 章节的内容，明确了当前阶段 WMS 独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
2025-12-22 ``` docs(design): 完善 3.2.1 码头收货 / 3.2.2 IQC 检验 章节的详细设计
    更新了 SRS 文档中关于视觉识别与分箱校验的流程细节，包括：
    - 将“视觉识别与校验”更名为“视觉识别与分箱校验”
    - 修改动作描述为“料盘沿流水线输送 -> 到位触发视觉系统扫描”
    - 优化 WES 处理逻辑表述，明确校验、分配算法及指令下发流程
    - 统一术语表达，增强文档可读性与准确性
    同时新增混托物料类型一致性校验机制说明，并完善相关序列图与数据表结构描述
    新增模拟数据文档以支持系统验证场景
    新增 docs/mock_data.md 文件，提供用于验证 WES 系统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
2025-12-22 feat(docs): 添加团队分工一致性检查与模拟数据引用
    - 在审计设计命令中新增团队分工一致性检查项，明确定义 WMS/WES/ECS 职责边界
    - 引入 mock_data.md 作为设计和审计过程的数据验证参考
    - 更新设计文档生成流程，增加团队分工表追加阶段
    - 添加料盘装箱区模拟步骤文档，包含详细业务规则与异常处理流程
    - 完善审计与设计命令中的 checklist，确保各环节一致性校验覆盖完整
    [初始化作业要求20251210 V2.0.xlsx]
2025-12-22 docs(audit-design.md): 添加工具与思考模式说明
    新增 `--ultrathink` 模式下的工具使用指南，包括 Sequential Thinking 和 Serena Tools 的具体应用。
    明确了不同场景下应选用的工具类型，如需求覆盖率分析、文档模式搜索及审计结果记录等。
    docs(design.md): 补充设计过程中的工具与思考模式指引
    引入 `--ultrathink` 模式支持的工具集描述，涵盖 Sequential Thinking 与 Serena Tools 在代码探索、
    架构分析和跨会话上下文管理等方面的应用，并列出相关使用场景。
2025-12-22 docs(design): 修正 3.3.1 栈板拆箱业务逻辑并总结外部团队协作经验
    - 修正 §3.3 栈板拆箱作业：移除 WMS 上料参数计算，改为栈板级任务模型
    - 简化 WMS → WES 和 WES → ECS 接口，移除 rods_needed 参数
    - 移除"每根串杆最多 7 个料盘"的错误限制
    - 明确栈板任务完整性要求（包括 NG 料盘处理）
    - 新增设计经验教训：外部团队协作、数据可用性验证、物理约束验证、任务模型设计、任务完整性原则
    - 更新设计流程教训清单（6 条新原则）
    关联文件：
    - docs/design/3.3.1-smt-smart-kitting.md
    - .claude/commands/design.md
2025-12-22 feat(task-breakdown): 新增任务分解生成器命令
    新增 `/task-breakdown` 命令，支持基于设计文档自动生成任务分解文档。
    该文档包含史诗故事（Epic）、用户故事（User Story）、故事点估算、
    团队速率计算及迭代计划等内容。支持多种参数配置，如团队人数、
    生产率、迭代周期等，并可生成详细的团队协作时间表与风险缓解建议。
    该命令结合 Sequential Thinking 与 Serena 工具进行深度分析，
    适用于从设计到实施全过程的任务规划与管理工作。
2025-12-22 docs(3.2.2-iqc-routing-review-task-breakdown): 完成 3.2.2 IQC 动态路由与复判 - 任务分解文档
2025-12-23 docs(task-breakdown): 添加 3.3.1-smt-start-kitting-task-breakdown; - 更新 3.3.0 WES 核心基础平台的 SRS - 完善 docs/third_party_integration_whitepaper.md 中的 “设备事件上报” 场景
2025-12-23 docs(SRS): 更新WES核心基础平台文档内容，添加 核心基础平台 详细设计文档
    完善WES核心基础平台的软件基础设施描述，将原有的四大软件基础设施重新整理为六大模块：
    1. 控制系统集成 - 明确架构约束、通信协议和逻辑位置映射要求
    2. 异步消息交互 - 定义三段式交互机制和标准指令集
    3. 标准接口定义 - 规范下行和上行接口以及幂等性保障
    4. 重试与异常处理 - 实现超时重试、异常处理和状态监控
    5. 设备层次结构与基础数据 - 建立区域-作业线-设备三级组织结构
    6. 任务管理 - 定义任务队列、状态机和并发控制机制
2025-12-23 docs(design): 添加WES核心基础平台设计文档的审计报告
    添加了完整的审计报告章节，包括：
    - 与SRS.md的对照审计，验证6大核心能力的100%覆盖率
    - 需求覆盖清单和一致性检查表格
    - 内部一致性审计，验证角色职责、时序图、功能页面、数据模型的一致性
    - 团队分工一致性检查，明确WMS/WES/ECS职责边界
    - 设计质量评估，包含完整性、可追溯性、一致性、可实施性、增强性五个维度
    - 问题与建议，提供实施阶段的改进建议
    - 总体结论确认设计文档质量优秀，可直接用于指导开发实施
2025-12-24 feat(docs): 更新SMT智能装箱文档职责边界和流程说明
    完善ECS与WES职责划分，详细说明循环处理模式和视觉系统限制，
    更新库存记录策略和满架切出触发条件
    - **职责边界**: 重新定义ECS(硬件自主管理)和WES(被动响应)的具体职责，
    明确串杆循环处理、ROD_EMPTY检测、流水线步进控制等自主管理功能
    - **视觉系统限制**: 补充说明视觉系统只能扫描顶部料盘，
    下方料盘被遮挡的限制条件
    - **循环处理模式**: 详细描述ECS自主管理的循环处理流程，
    包括初始扫描、处理循环、循环终止等步骤
    - **放入高度计算**: 增加WES的放入高度计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
2025-12-24 refactor(design): 移除WES启动命令，改为ECS自主启动间隔步进模式
    移除了 WES → ECS 启动间隔步进模式的命令接口，改为由 ECS 硬件通过传感器检测自主启动。
    主要变更：
    - 删除 POST /ecs/api/conveyor/start-interval-loading 接口定义
    - 移除 WMS → WES 箱扫描完成通知流程
    - 移除 WES → ECS 启动命令下发流程
    - 新增 ECS 传感器检测料盘放入自动启动机制
    - 更新职责边界：ECS 负责自主启动，WES 无需下发启动指令
    - 更新时序图：移除 WMS-WES-ECS 启动命令步骤
    设计优势：
    - 简化系统集成，减少三方协调
    - 硬件完全自主管理步进控制
    - 传感器直接触发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
2025-12-25 docs(3.3.2-hybrid-inbound-strategy): 完善 SMT 作业区 混合入库详细设计
2025-12-25 feat(docs): 完善入库流程数据库模型设计
    重构了文档中的数据库模型定义，将原有的简单数据要点
    替换为详细的数据库表结构设计，涵盖以下模块：
    - 码头接收与绑定(3.2.1): 定义核心共享模型、码头模块模型
    和库存追溯模型，包括pallet、transport_task、arrival_record
    等表结构
    - IQC路由复判(3.2): 设计任务调度、取样检验、复判拆板相关表
    如iqc_pending_task、pallet_grn_inspection、sampling_record
    - SMT智能装箱(3.3.1): 建立任务管理、资源管理和异常记录表
    包括kitting_task、rack_resource、kitting_exception_log
    - 混合入库策略(3.3.2): 优化货架资源查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
2025-12-25 feat(database): 添加审计追踪和异常管理数据表
    - 新增 inbound_order 表用于 WES 侧 GRN 副本幂等落库
    - 新增 arrival_manifest_detail 表支持逐行校验与 SAP/GRN 请求的明细依据
    - 扩展 print_task 表增加错误码、重试次数、触发人和实际打印时间字段
    - 新增 pallet_status_history 表追踪栈板生命周期中的所有状态转换
    - 新增 pallet_movement_history 表追踪栈板的物理位置变更
    - 新增 api_integration_log 表追踪与外部系统的 API 调用用于调试集成问题
    - 在 IQC 模块中新增 qms_interaction_log、qms_api_log 表增强 QMS 交互审计
    - 在 IQC 模块中新增 iqc_exception_log 表追踪流程异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
2025-12-29 docs(design): 完成 SMT 生产发料协调详细设计文档及审计报告
    新增 3.3.3-smt-production-issue.md 设计文档，包含：
    - 效率优化策略（批量操作、并行执行）
    - 完整技术栈说明（WMS: ASP.NET MVC, WES: Python FastAPI）
    - 详细子功能流程设计（任务生成、WES 执行、结果上报、异常处理）
    - 物理布局与硬件配置
    - 数据库模型设计（三层架构：task → materials → trays）
    - API 接口数据字典
    - 团队分工表
2025-12-30 docs: 优化系统架构设计并细化 SMT 业务模块详细设计
    - 新增并优化系统架构概览图与详细功能级架构图 (PNG/MMD)
    - 重构 `3.3.2 混合入库策略` 设计文档，完善决策逻辑、物理布局及 API 定义
    - 细化 `3.3.3 SMT 生产发料协调` 设计文档，补充四阶段识别点流程及 CTU 批量操作优化
    - 更新 `.claude/commands/design.md` 指令上下文
2025-12-30 docs(design): 更新SMT智能配Kit功能归属表
    更新了3.3.1-SMT智能配Kit文档中的功能归属表，重新组织了各系统（WMS、WES、ECS、CTU、RCS）
    的职责分配。新增了CTU和RCS职责列，并详细说明了各模块的具体职责，使功能归属更加清晰明确。
2025-12-30 docs(design): 更新SMT生产问题文档中的功能归属表
    - 添加CTU和RCS职责列到功能归属表
    - 新增货架规划、料箱批量上料、料箱识别、料箱回库等功能模块
    - 调整现有模块的职责分配，明确各系统间的分工
    - 更新表格格式以支持更多系统职责的展示
2025-12-30 feat(design): 添加功能归属表规范和格式要求
    在设计文档中新增功能归属表的标准格式规范，包括：
    - 定义5列格式的功能归属表结构
    - 明确WMS/WES/ECS/CTU/RCS各系统的职责划分
    - 规定使用✅和-符号表示系统负责状态
    - 要求功能模块按业务流程顺序排列
    - 确保与其他设计文档的一致性要求
    [功能归属表.xlsx]
2025-12-30 feat(docs): 添加CTU与流水线协调信号机制说明
    在3.3.2混合入库策略和3.3.3 SMT生产发料文档中添加了CTU与流水线
    的硬件协调信号机制：
    - 新增PUT_FINISH信号：CTU完成放料后，WES发送PUT_FINISH命令到ECS，
    通知流水线CTU已完成放料动作
    - 新增PICK_FINISH信号：CTU取走料箱后，WES发送PICK_FINISH命令到ECS，
    通知流水线料箱已被完全取走
    - 更新了序列图，添加了相应的API调用和状态流转
    - 优化了CTU批量取箱逐个放箱的流程说明
    - 完善了出料口CTU回库作业的信号交互流程
2025-12-31 docs(data_dictionary/3.5-special-material-handling): 添加 fxn-wms 全域数据字典文档; 添加 3.5 特殊物料入库流程；
    新增完整的数据库模型文档，涵盖 WMS (SQL Server) 和 WES (PostgreSQL) 的完整数据字典，
    包括业务主数据、执行数据、审计日志及系统降级支持模型，详细描述了各个表结构和字段定义。
    [初始化作业要求20251124V1.0.xlsx, 功能归属表.xlsx]
2025-12-31 docs(planning): 重构文档目录结构
    将claudedocs目录下的任务分解文档移动到docs/planning目录下，
    以更好地组织项目规划相关文档。
    - 3.2.1-task-breakdown.md
    - 3.2.2-iqc-routing-review-task-breakdown.md
    - 3.3.1-smt-smart-kitting-task-breakdown.md
2025-12-31 docs(planning): 添加 3.3.3 SMT 生产发料协调任务分解文档
    完成 SMT 生产发料协调系统的完整任务分解，包括：
    - 9 个 Epic，45 个 User Story，共 159 故事点
    - 10 个 Sprint 详细计划（20 周工期）
    - 团队协作时间线（WMS 348h + WES 884h = 1232h）
    - 完整的验收标准和风险缓解措施
    核心内容：
    - Epic 1: WMS 任务生成与货架规划（19 点）
    - Epic 2: WES 任务队列与编排（16 点）
    - Epic 3: CTU 批量上料操作（17 点）
    - Epic 4: 四识别点位集成（23 点）
    - Epic 5: 退货架拣料操作（13 点）
    - Epic 6: 流水线拣料操作（24 点）
    - Epic 7: 退料流水线错误处理（19 点）
    - Epic 8: 结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
    [功能归属表.xlsx]
2025-12-31 docs: 添加特殊物料处理任务分解文档
    完成 3.5 特殊物料处理功能的完整任务分解，包括：
    - 7个Epic，27个User Story，总计113故事点
    - 完整的团队分组视图和User Story详细说明
    - 2个Sprint的详细规划（Sprint 1: 56点，Sprint 2: 57点）
    - 依赖关系图和并行开发机会分析
    - 风险评估与缓解措施（高/中/低风险项）
    - 全面的验收标准（功能、性能、可靠性、数据质量、安全性、用户体验）
    Epic覆盖范围：
    - E1: 物料分类与路由决策（14点）
    - E2: 特殊物料类型处理流程（34点）
    - E3: 库位分配与上架执行（21点）
    - E4: 异常处理与状态监控（13点）
    - E5: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
2026-01-05 feat(docs): 添加全局调度优化与策略设计文档
    - 新增 3.4 全局调度优化与策略详细设计文档，包含冷热区存储优化、
    全局负载均衡、高级任务编排和资源预留冲突解决等核心策略算法
    - 新增 3.4 全局调度优化与策略任务分解文档，涵盖存储优化策略引擎、
    全局负载均衡与编排、策略分析与报表三个 Epic 的详细任务分解
    - 调整文档结构，将 3.3.3 SMT生产发料任务分解文档从 claudedocs 目录
    移至 docs/planning 目录
    - 设计了冷热区分析算法、移库任务生成器、动态负载均衡策略、
    死锁检测机制等核心功能模块
    [WMS_数据字典 - HNZL.xls, 功能归属表.xlsx]
2026-01-05 docs(data_dictionary): 更新数据字典文档 v1.1
    - 更新版本号从v1.0到v1.1，日期从2025-12-31到2026-01-04
    - 新增到货清单明细表(arrival_manifest_detail)的字段定义
    - 新增打印任务表(print_task)和校验日志表(validation_log)
    - 新增优先级调整日志(priority_adjustment_log)和拆板记录表(split_record)
    - 新增IQC异常日志(iqc_exception_log)和QMS交互日志(qms_api_log)
    - 将API日志中的request_payload字段类型从JSON改为NVARCHAR(MAX)
    - 新增栈板位置移动历史(pallet_movement_history)表
    - 新增SAP同步日志(inventory_sync_log)、RCS回调日志(rcs_callback_log)和特殊物料日志(special_material_log)
    - 为WES域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
2026-01-08 feat(docs): 添加详细设计阶段的prompt文档
    开始详细设计阶段，基于SRS文档和其他参考文档进行详细分析，
    识别子功能流程和归属，符合工业操作流程要求。
    主要包含以下内容：
    - GRN在多个栈板上的处理逻辑
    - 装箱区空架监控方案分析
    - 料盘装箱区真实工作场景模拟演练
    - 物理布局和硬件自主控制说明
    - 退料场景的完整流程设计
2026-01-09 docs(prompt): 更新码头收货与IQC流程文档
    - 添加了物料到达码头区的详细流程步骤
    - 补充了拆板作业的操作说明
    - 完善了暂存区与IQC检测的完整流程
    - 增加了收货验收和粗分机拆箱的工作流程
    - 添加了相关决策逻辑和注意事项
    docs(design): 修复文档链接格式问题
    - 将文档引用中的波浪号替换为转义格式
    - 保持文档链接的一致性
    docs: 添加收货与IQC流程梳理会议纪要
    - 记录2026年1月7日会议的结论和待定项
    - 汇总收货、IQC及入库流程的业务变更
    - 包含详细的业务流程步骤和决策逻辑
